daniw/bat_source/README.md

# bat_source
Battery powered voltage and current source
