daniw/bat_source/mech_Samuel_v2/README.md

# Übersicht der Mechanik zur 60V-Quelle

## Anmerkungen zum Modell und zu druckende Dateien

Für die Befestigung der Hauptplatine sind im Moment im Modell Abmessungen für M3-Einschmelzgewinde vorgesehen. Für einen M4-Schraube und Einschmelzgewinde müssen die Abmessungen im CAD geändert werden.

Folgend eine Liste aller zu druckenden Dateien. Dateien liegen alle unter "C:\GIT_Projekte\bat_source\mech_Samuel_v2\80_step_m3f_files\"

Es gibt nur zwei große 3mf-bambu-Dateien, "__TPU_Teile.3mf" und "__ABS_Teile.3mf".
In den beiden Dateien sind erstmal nur die step-Dateien reingezogen, Material und Druckplatte sind noch nicht ausgewählt.

Datei                        | Inhalt                             | Material | Kommentar
-----------------------------|------------------------------------|----------|----------
01_01_housing.stp            | Gehäuse-Hauptteil                  | ABS      | __ABS_Teile.3mf
02_01_lid.stp                | Gehäusedeckel                      | ABS      | __ABS_Teile.3mf
05_cell_holder_minusplus.stp | Zellenhalter                       | ABS      | __ABS_Teile.3mf; zweimal drucken
90_knob_koerper.stp          | Knob für den Poti                  | ABS      | __ABS_Teile.3mf; Ursprüngliche Datei und Konstruktion; nichts dran geändert. 
01_06_fuse_lid.stp           | Deckel Sicherung                   | ABS      | __ABS_Teile.3mf
02_03_seal.stp               | Dichtung Gehäuse/Deckel            | TPU      | __TPU_Teile.3mf
01_04_fuse_seal_b.stp        | Dichtung Gehäuse/Sicherungsdeckel  | TPU      | __TPU_Teile.3mf
01_05_staeubli_plug_seal.stp | Dichtung Gehäuse Bananen-Plugs     | TPU      | __TPU_Teile.3mf

## Montage und Zusammenbau

- Die Knöpfe und "Regler" werden am Deckel verschraubt.
- Danach wird die UI-Platine am Deckel und den Knöpfen verlötet.

- Die Bananen-Plugs werden mit ihrer Dichtung in das Gehäuse geschraubt.
- Dann wird die Hauptplatine ins Gehäuse gesetzt und mit den Bananen-Steckern verlötet.
- Hauptplatine wird mit dem Gehäuse verschraubt.

- Deckel wird auf das Gehäuse gesetzt, die Stiftleiste stellt dann zwischen der Hauptplatine und der UI-Platine die Verbindung her.
- Deckel wird mit vier Schrauben mit dem Gehäuse verschraubt.

## step-Dateien der PCBs

Dateien von Dani bereitgestellt am 15.02.2026. Vereinfachte Modelle, für bessere Handhabung.

"D:\GIT_Projekte\bat_source\mech_Samuel_v2\PCB_step_files_leer_geraeumt\Hauptplatine\PS1-1BA_3D STEP_2026-02-16.step"
"D:\GIT_Projekte\bat_source\mech_Samuel_v2\PCB_step_files_leer_geraeumt\UI\PS1-2BA_3D STEP_2026-02-16.step"

D:\GIT_Projekte\bat_source
D:\GIT_Projekte\bat_source\mech_Samuel_v2
D:\GIT_Projekte\bat_source\mech_Samuel_v2\01_Hauptplatine

D:\GIT_Projekte\bat_source\mech_Samuel_v2\02_UserInterface
D:\GIT_Projekte\bat_source\mech_Samuel_v2\99_PCB_step_files_leer_geraeumt\Hauptplatine
D:\GIT_Projekte\bat_source\mech_Samuel_v2\99_PCB_step_files_leer_geraeumt\UserInterface

## Übersicht bestehender Mechanik-Teile

"D:\GIT_Projekte\bat_source\mech"

Datei | Inhalt
----  | ----
00_bat_source.FCStd               | Assembly vom gesamten Gehäuse
00_bat_source.step                | Assembly vom gesamten Gehäuse
Battery_Holder.3mf                | Druck-Datei für die Halterungen der Zellen und die banana-plug-Führungen
Battery_Holder.FCStd              | FreeCAD-Datei für die Halterung der Zellen.
CBOX11004.FCStd                   | FreeCAD-Datei vom Gehäuse. Hauptteil
CBOX11004-Körper.step             | Gehäuse-Grundform. Hauptteil
Holder_Banana_Plugs.FCStd         | FreeCAD-Datei für die banana-plug-Führungen. Hier schon mit den Bohrungen
Holder_Banana_Plugs.stp           | Äußere Führung für die banana-plugs
Holder_Banana_Plugs_Drill.stp     | Äußere Führung für die banana-plugs mit Bohrungen
Knob.3mf / Knob.FCStd             | FreeCAD- und Druckdatei für den knob auf dem Poti.
Lid_CSACTT004.FCStd               | FreeCAD-Datei für den Deckel
Transformer_Spacer_0.5mm.FCStd    | FreeCAD-Datei für einen Spacer

# Aufbau CAD-Modell

CAD-Modell wird ähnlich aufgebaut, wie es auch in der Realität gemacht wird.

Folgend zwei Darstellungen des Aufbaus als Flowchart.

## Aufbau, Variante 1
```mermaid
flowchart TD
    A[Haupt-Assembly, 00_main_assembly1.asm]

    A --> B[Gehäuse-Assembly, 00a_housing_assembly.asm]
	
    B --> B1[Gehäuse, 01_housing.prt]
    B --> E[Hauptplatinen-Assembly, 10_main_pcb_assembly.asm]
    B --> B2[Deckel Sicherung, 06_fuse_lid.prt]

    A --> C[Deckel-Assembly, 00b_lid_assembly.asm]
	
    C --> C1[Deckel, 02_lid.prt]
    C --> C2[UI-Platine]
	
	A --> D[Dichtung, 03_seal.prt]
	
	E --> E1[Hauptplatine]
	E --> E2[Zellenhalter, 2x, 05_cell_holder.prt]

````

## Anpassungen im CAD-Modell

* Hauptplatine wird mit vier metrischen Schrauben befestigt.

* Welche Schrauben können sinnvoll genutzt werden? Bei Bedarf müssen die Röhren-Füße verlängert und die Zellhalter niedriger werden, damit kürzere Schrauben verwendet werden können.

* Deckel der Sicherung so machen, dass man damit die Sicherung reindrücken kann. Zwischen Deckel und Sicherung ein Band machen, mit dem man mit dem Deckel die Sicherung rausziehen kann.

* Deckel für die Sicherung muss viel größer werden. Nachbauen, drucken und testen.

* Schrauben zwischen Hauptplatine und Gehäuse: M3x40, https://www.bossard.com/ch-de/eshop/schrauben-mit-innenantrieb/zylinderschrauben-mit-innensechskant-mit-schaft/p/4/

* Andere Schraube, M3x25: https://www.bossard.com/ch-de/eshop/schrauben-mit-innenantrieb/zylinderschrauben-mit-innensechskant-ohne-schaft/p/272/

* UI-Platine am Deckel muss von innen an den Deckel geschraubt werden. Aufgrund der geringeren Kräfte sind hier Kunststoff-Schrauben ausreichend.

* Auszugkraft der Stiftleiste: 0.6 N = 60 gramm pro Pin. Gesamtkraft: 24x0.6N = 14.4N = 1.440 kg.

* Stecker: Spannscheibe und Ringmutter mit ins Modell reinnehmen.

* Gehäuse soll aus ABS gedruckt werden. Grobe Abschätzung der Kosten machen. Basierend auf bambu-Filament. https://eu.store.bambulab.com/de/products/abs-filament

* Dichtungen am Deckel für die Sicherung: Gerundete Varianten wegmachen. Es bleibt die ganz gerade Variante übrig und wird verwendet. Wandstärke nach innen hin von 0.5mm auf 1mm erhöhen. An der Lid müssen noch für die beiden Schrauben Vertiefungen gemacht werden, wo die Schrauben-Köpfe reinpassen.

* Alle Dateien umbenennen. Ziel: bessere Struktur der Bauteile, die zum Gehäuse-Teil und die zum Deckel-Teil gehören.
	* Main-Assembly: 00
	* Gehäuse: 01
	* Deckel: 02

* Übersicht aller Dateien und Ordner, die umbenannt werden müssen
Alter Dateiname                       | Neuer Dateiname                   | Status                                                                       | Baugruppe
----                                  | ----                              | ----                                                                         | ----
01_Hauptplatine                       |                                   | Fertig                                                         | Baugruppe
02_UserInterface                      |                                   | Fertig                                                         | Baugruppe
80_step_m3f_files                     |                                   | Fertig                                                         | Baugruppe
99_PCB_step_files_leer_geraeumt       |                                   | Fertig                                                         | Baugruppe
02_pcb_assembly.asm                   | 00_02_pcb_assembly.asm                                  | noch_nicht_umbenannt                                   | Baugruppe
02b_banana_position_skeleton.prt      | 00_02b_banana_position_skeleton.prt                                  | noch_nicht_umbenannt                      | Baugruppe
05_cell_holder.prt                    | 01_05_cell_holder.prt                                  | noch_nicht_umbenannt                                    | Baugruppe
10_main_pcb_assembly.asm              | 00_10_main_pcb_assembly.asm              | noch_nicht_umbenannt                                                  | Baugruppe
90_battery_holder-holder_cut.prt      | 90_01_battery_holder-holder_cut.prt                                  | noch_nicht_umbenannt                      | Baugruppe
90_cbox11004-körper.prt               | 90_02_cbox11004-körper.prt                                  | noch_nicht_umbenannt                               | Baugruppe
90_holder_banana_plugs_drill.prt      | 90_03_holder_banana_plugs_drill.prt                                  | noch_nicht_umbenannt                      | Baugruppe
00_main_assembly.asm                  | 00_00_main_assembly.asm           | Fertig. In der Assembly sind alle Dateien umbenannt.                         | Baugruppe
00a_housing_assembly.asm              | 01_00_housing_assembly.asm        | Fertig                                                                       | Baugruppe
00b_lid_assembly.asm                  | 02_00_lid_assembly.asm            | Fertig. In der Assembly sind bis auf die Platine alle Dateien umbenannt.     | Baugruppe
00c_housing_lid_assembly.asm          | 00_01_mechanical_assembly.asm     | Fertig. In der Assembly sind alle Dateien umbenannt.                         | Baugruppe
01_housing.prt                        | 01_01_housing.prt                 | Fertig                                                                       | Baugruppe
02_lid.prt                            | 02_01_lid.prt                     | Fertig                                                                       | Baugruppe
02_lid__Window_Deep.prt               | 02_01_lid__Window_Deep.prt        | Fertig                                                                       | Baugruppe
03_seal.prt                           | 02_03_seal.prt                    | Fertig                                                                       | Baugruppe
04_fuse_seal.prt                      | 01_04_fuse_seal                   | Fertig                                                                       | Baugruppe
04_fuse_seal_a.prt                    | 01_04_fuse_seal_a.prt             | Fertig                                                                       | Baugruppe
04_seal_fuse_b.prt                    | 01_04_fuse_seal_b.prt             | Fertig                                                                       | Baugruppe
06_fuse_lid.prt                       | 01_06_fuse_lid.prt                | Fertig                                                                       | Baugruppe
07_m3_einschmelzmutter.prt            | 01_07_m3_einschmelzmutter.prt     | Fertig                                                                       | Baugruppe
09_lichtleiter.prt                    | 02_09_lichtleiter.prt             | Fertig                                                                       | Baugruppe
11_display_window.prt                 | 02_11_display_window.prt          | Fertig                                                                       | Baugruppe

### Anpassungen im CAD-Modell erledigt

* Auf die LED der UI-Platine einen Lichtleiter machen. Einfacher Zylinder mit Halbkugel oben drüber. Dazu dann vier Bohrungen in den Deckel machen. Müssen dann eingeklabt werden. Die Lichtleiter haben keinen direkten Kontakt zu den LED.

* Dichtring mit 12mm-Innendurchmesser unter die Bananen-Stecker machen, damit die gedichtet sind.

* Abmessungen der Taster und vom Poti

	* Taster: Durchmesser 12mm; Breite zwischen den beiden Abflachungen: 11.19 (Länge Abflachung: 4.33404)
	* Poti: Länge: 13.75, Breite 11.70, Durchmesser unten 7, Höhe Zylinder 7, Nase 2x0.8, Abstand Nase 0.1

* Rundung unten außen machen, dass man die PS besser greifen kann. Es sollten mindestens 10mm Radius sein, mehr wäre besser. Was macht die Wandstärke damit? Welche Rundung geht dann noch innen? Wie passt das mit den Zellenhaltern?

* In das Gehäuse müssen vier Hülsen mit Gewinde eingeschmolzen werden.

* 3D-Modell DIN M3x25 und Einschmelzgewinde suche, runterladen und einbauen.

https://www.3djake.de/3djake/gewindeeinsaetze-50er-set?sai=9419

* Vier Schrauben raussuchen für die Verbindung zwischen Deckel und Gehäuse

* Dichtung zwischen Deckel und Gehäuse auf die Innenseite der Schrauben verlegen. Schrauben-Rohr viel weiter nach außen, direkt in die Ecke. Dasselbe gilt für den Deckel der Sicherung.

* Oberkante vom Encoder definiert die Innenseite vom Deckel. Die Taster definieren die Außenkante vom Deckel und liegen auf dem Deckel auf.

## Dichtung Abmessungen

* Radius Ecken 3mm

* Breite 1.5mm

* Dichtung liegt mittig. Abstand zur Innenkante 0.75mm

## Dichtung Abmessungen IMD-Tester

* Box hat Nase, die die Dichtung im Deckel drückt. Kante hat Breite von 1.5mm. Ende sauber auf der Innenseite vom Gehäuse. Kante ist 1.5mm hoch.

* Dichtung liegt im Deckel. Fuge für die Dichtung ist 2.5mm breite. Dichtung selbst ist auch 2-2.5mm breit.

## Weiteres Vorgehen in der Konstruktion:

* Passende Schrauben suchen und als Modell einbauen.

* Überlegen, wie man ein Spiel in alle drei Raumrichtungen einbauen kann, siehe Diskussion mit Luise. Es dürfen keine Kräfte auf den Viel-Pin-Stecker ausgeübt werden. Und Fertigungstoleranzen müssen ausgeglichen werden können.

* Einschmelzgewinde von der Hauptplatine zum Gehäuse auf M4 vergroessern. Sub-Modell vom Einschmelzgewinde muss ausgetauscht werden. Röhre muss neu konstruiert werden.+

* Schrauben raussuchen.
	* M3 Schrauben fuer Deckel und Deckel ueber der Sicherung
	* M4 Schrauben fuer Hauptplatine

* Schrauben am Deckel der Sicherung muessen Senkkopf sein, damit das Gehäuse unten glatt abschliesst.

* Schrauben von Deckel auf Gehäuse und Befestigung der Platinen köennen auch Innen-Sechskant-Schrauben sein. 

## Einschmelzgewinde und Abmessungen

Quelle: https://www.3djake.de/3djake/gewindeeinsaetze-50er-set?sai=9419

Gewindegröße | D1 <br> Großer Durchmesser | D2 <br> Kleiner Durchmesser | D3 <br> Bohrung im Bauteil | L (+1mm) <br> Gesamtlänge | W (mindestens) <br> Wandstärke im Bauteil
----         | ----                       | ----                        | ----                       | ----                      | ----
M3           | 4.6                        | 3.9                         | 4.0                        | 5.7                       | 1.6
M4           | 6.3                        | 5.5                         | 5.6                        | 6.35                      | 2.1
M5           | 7.1                        | 6.3                         | 6.4                        | 9.5                       | 2.6
M6           | 8.7                        | 7.9                         | 8.0                        | 12.7                      | 3.3
M8           | 10.24                      | 9.4                         | 9.6                        | 12.7                      | 4.5

## Schrauben

* Befestigung der Hauptplatine zum Gehäuse
	* M4-Einschmelzgewinde
	* M4x30 Innensechskant-Schraube
	* Bohrungen im Zellenhalter und der Platine müssen vergrößert werden.

* Befestigung Hauptplatine zum Zellenhalter
	* M4-Schraube mit Einschmelzgewinde. Abmessungen TBD.

* Schrauben M3 und M4 auf ebay.

https://www.ebay.de/itm/126045092807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

* Schrauben bei bossard

https://www.bossard.com/ch-de/eshop/schrauben-mit-innenantrieb/zylinderschrauben-mit-innensechskant-mit-schaft/p/4/

* Innen-Sechskant-Schrauben bei Norelem

https://norelem.de/de/Produkt%C3%BCbersicht/Flexibles-Normteilesystem/07000/Muttern-Schrauben-Unterlegscheiben-Sicherungselemente/Zylinderschrauben-mit-Innensechskan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

* Senkschrauben mit Innen-Sechskant (für Fuse-Lid)

https://norelem.de/de/Produkt%C3%BCbersicht/Flexibles-Normteilesystem/07000/Muttern-Schrauben-Unterlegscheiben-Sicherungselemente/Senkschrauben-mit-Innensechskant-DI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

* Befestigung der Zellenhalter und Platine mit Kunststoff-Schrauben, Typ K30.

## Einschmelzgewinde

Bild mit Abmessungen der Einschmelzgewinde:

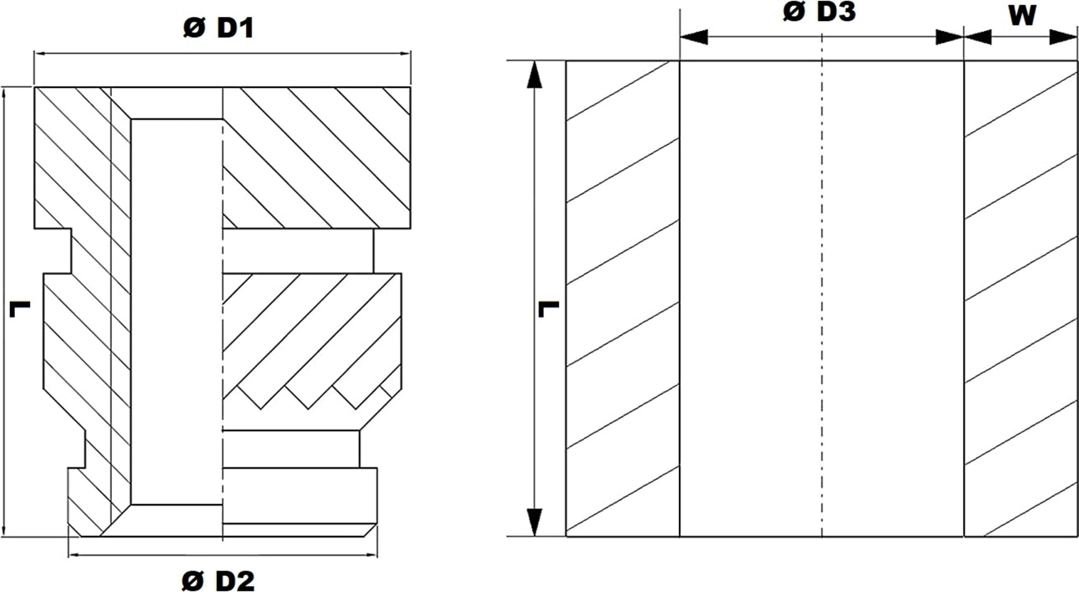
[picture p1: mech_Samuel_v2/3djake-gewindeeinsaetze-50er-set-621566-de.jpg]
Zeichnung


## Abmessungen der Sicherung (aus bestehender step-Datei ausgelesen).
Sind notwendig, um die Sicherung zum Drucken nachbauen zu koennen.
Sicherung:
	43.0530 x 18.1356
	39.9034 x 14.9860

	Hoehe 17.5260

	Wand rundung: D 3.14960
	Wand rundung innen: 0.762000

	Wanddicke 1.57480

## Aufbau, Variante 2

```mermaid
flowchart TD
    A[Haupt-Assembly]

    subgraph GA [Gehäuse-Assembly]
        G1[Gehäuse]
        G2[Hauptplatine]
        G3[Dichtung]
    end

    subgraph DA [Deckel-Assembly]
        D1[Deckel]
        D2[UI-Platine]
    end

    A --> GA
    A --> DA

````

Kleinst-möglicher Abstand zwischen den beiden Platinen sind 9.5mm. Also etwas mehr Abstand einplanen.

### CREO-Konfiguration anpassen

* Relativer Suchpfad in die search-Datei einbauen, damit nicht verschiedene Pfad für Workstation und Laptop notwendig sind.

* In der config-Datei die Ansicht von Ebenen, Achsen, Punkte, Koordinatensystemen, ... abschalten.

## Aufgabenliste

* Die Tabelle der umzubenennden Dateien aufräumen.

* Liste mit Anmerkungen, Kommentaren, etc überarbeiten. Vermutlich hat sich davon schon vieles erledigt.
