daniw/bat_source/mech_Samuel_v2/04_Fuse/sicherung_konstruiert/read me.txt

Sicherung Durchmesser: 10.300 mm
Länge Feder: 9.8 mm
