daniw/bat_source/doc/src/hardware.tex

\section{Hardware}

\FloatBarrier

\subsection{Overview}
\label{sec_hw_overview}
\begin{itemize}
    \item Block diagram
\end{itemize}

\FloatBarrier

\subsection{Battery}
\label{sec_battery}
For the cell chemistry, a \ac{LFP} battery is selectedi. This due to its rather high energy and power density and especially due to the safer handling compared with \ac{LiIon} and \ac{LiPo} batteries.  

To select a suitable cell, a market analysis is performed. 
\begin{table}[h!]
    %\begin{spreadtab}{{zebratabular}{p{0.27\linewidth}lN{3}{2}n{5}{2}p{0.4\linewidth}}}
    \begin{spreadtab}{{zebratabular}{llllllllllllll}}
        \rowcolor{gray}
        @Manufacturer,  Type                & @$C_{typ}$                & @$I_{max}$            & @Cells    & @$P_{max}$        & @$W_{max}$                 & @Cost per device & @Runtime      \\
        @Lithium Werks, ANR26650            & @\qty{2.6}{\ampere\hour}  & @\qty{50}{\ampere}    & @5        & @\qty{500}{\watt} & @\qty{40}{\watt\hour}      & @35.75           & @\qty{32}{\minute}    \\
        @JGNE,          HTPFR26650          & @\qty{3.0}{\ampere\hour}  & @\qty{30}{\ampere}    & @5        & @\qty{375}{\watt} & @\qty{46.4}{\watt\hour}    & @17.70           & @\qty{37.12}{\minute} \\
        @JGNE,          HTCFR26650          & @\qty{3.6}{\ampere\hour}  & @\qty{10.2}{\ampere}  & @4        & @\qty{375}{\watt} & @\qty{45.44}{\watt\hour}   & @8.60            & @\qty{36.352}{\minute} \\
        @JGNE,          HTCFR26650          & @\qty{3.8}{\ampere\hour}  & @\qty{11.4}{\ampere}  & @4        & @\qty{114}{\watt} & @\qty{48}{\watt\hour}      & @10.76           & @\qty{38.4}{\minute} \\
        @JGNE,          JGCFR26650-4\ldots  & @\qty{4.0}{\ampere\hour}  & @\qty{12}{\ampere}    & @3        & @\qty{90}{\watt}  & @\qty{37.92}{\watt\hour}   & @8.97            & @\qty{30.336}{\minute} \\
        @Tenpower,      IFR26700-45HE       & @\qty{4.5}{\ampere\hour}  & @\qty{9}{\ampere}     & @4        & @\qty{90}{\watt}  & @\qty{56.96}{\watt\hour}   & @7.80            & @\qty{45.568}{\minute} \\
        @Tenpower,      IFR26700-40HE       & @\qty{4.0}{\ampere\hour}  & @\qty{8}{\ampere}     & @4        & @\qty{80}{\watt}  & @\qty{50.56}{\watt\hour}   & @7.40            & @\qty{40.448}{\minute} \\
    \end{spreadtab}
    \caption{Cell selection}
    \label{tab_cell_selection}
\end{table}
The IFR26700-45HE made by Tenpower is selected as a compromise between low cost and reasonable margin in runtime and output power. 4 cells in series are used. The cells are mounted using custom cell holders. Nickel tabs are spot-welded to the cells and soldered to the \ac{PCB}. 
\todo[inline]{Description of cell holder}

\begin{figure}[h!]
    \centering
    
    \caption{\acs{BMS} - battery cells}
    \label{fig_bat_cells}
\end{figure}

The schematic is prepared for a configuration with 5 cells in series. To enable the 5S configuration, BAT5 to BAT9 are set to fitted, the text C3 is replaced with a matching net label and the connection between C2 and C3 is removed. If both, 4S and 5S should be possible with the same \ac{PCB}, BAT2 is replaced with the design item id BAT\_LFP-26700-4.5AH-2NEG. It includes an extra pad, which is shorted to the negative cell connection using the cell tab by bending it and soldering it to both pads. This extra pad is used to short BAT7, which is not used in 4S configuration. \autoref{fig_bat_2neg} demonstrates the use of this third pad. 
\begin{figure}[h!]
    \centering
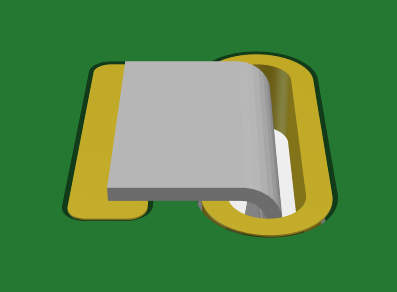
[picture p2: doc/img/bat_2neg.png]
    
    \caption{Visualisation of third pad which is bridged by the negative cell tab}
    \label{fig_bat_2neg}
\end{figure}

\FloatBarrier

\subsection{Battery Management System}
\label{sec_bms}
The battery must be protected against deep-discharge, over-charge, overcurrent and overtemperature. (\ReqRef{R:BMS})
This is implemented with the battery monitor and protector BQ76905. It is powered directly from the batteries and can be configured through its \ac{I2C} interface. The cells are connected to the battery monitor with a \qty{100}{\ohm} resistor for overcurrent protection. These resistors also limit the balancing current. 
\begin{align}
    I_{Bal} 
    = \dfrac{U_{Bal}}{R_{Bal}} 
    = \dfrac{n_{Bal} \cdot U_{cell}}{2 \cdot R_C + n_{Bal} \cdot R_{CB}}
    = \dfrac{n_{Bal} \cdot U_{cell}}{2 \cdot \qty{100}{\ohm} + n_{Bal} \cdot R_{CB}}
\end{align}
\begin{align}
    I_{Bal_{typ}} 
    = \dfrac{n_{Bal_{typ}} \cdot U_{cell_{typ}}}{2 \cdot R_C + n_{Bal_{typ}} \cdot R_{CB_{typ}}}
    = \dfrac{1 \cdot \qty{3.65}{\volt}}{2 \cdot \qty{100}{\ohm} + 1 \cdot \qty{93}{\ohm}}
    = \qty{12.46}{\milli\ampere}
\end{align}
\begin{align}
    I_{Bal_{min}} 
    = \dfrac{n_{Bal_{min}} \cdot U_{cell_{min}}}{2 \cdot R_C + n_{Bal_{min}} \cdot R_{CB_{max}}}
    = \dfrac{1 \cdot \qty{2.0}{\volt}}{2 \cdot \qty{100}{\ohm} + 1 \cdot \qty{200}{\ohm}}
    = \qty{5}{\milli\ampere}
\end{align}
\begin{align}
    I_{Bal_{max}} 
    = \dfrac{n_{Bal_{max}} \cdot U_{cell_{max}}}{2 \cdot R_C + n_{Bal_{max}} \cdot R_{CB_{min}}}
    = \dfrac{4 \cdot \qty{3.65}{\volt}}{2 \cdot \qty{100}{\ohm} + 4 \cdot \qty{53}{\ohm}}
    = \qty{35.44}{\milli\ampere}
\end{align}
\begin{align}
    P_{R_{C_{max}}} = I_{Bal_{max}} ^{2} \cdot R_{C} = \qty{35.44}{\milli\ampere} ^{2} \cdot \qty{100}{\ohm} = \qty{125.6}{\milli\watt}
\end{align}
All signals directly connected to the battery cells are assigned to the netclass BAT to enforce a minimum clearance. A capacitor with a value of \qty{100}{\nano\farad} is connected to each cell voltage measurement for filtering as recommended by the datasheet \cite{TI:BQ76905}. \autoref{fig_bms_volt} shows the cell connection to the \ac{BMS}. 

\begin{figure}[h!]
    \centering
    
    \caption{\acs{BMS} - battery voltage measurement}
    \label{fig_bms_volt}
\end{figure}

The temperature of the battery is measured with a \qty{10}{\kilo\ohm} \ac{NTC} thermistor with a B value of \qty{3380}{\kelvin}. The \ac{BMS} includes a pull-up resistor with a value of \qty{20}{\kilo\ohm}, therefore no external pull-up resistor is necessary. The temperature sensor is soldered to the bottom side of the PCB and glued to the cells using thermally conductive adhesive. A \qty{1}{\nano\farad} capacitor is connected in parallel to the thermistor for filtering. For testing purpose, an \ac{SMD} thermistor is placed on the PCB as well, which can be activated by bridging the solder-jumper J1. The temperature sensor is shown in \autoref{fig_bms_temp}. 

\begin{figure}[h!]
    \centering
    
    \caption{\acs{BMS} - battery temperature measurement}
    \label{fig_bms_temp}
\end{figure}

The \ac{BMS} can be woken up from deepsleep or shutdown mode by a rising edge on the pins TS or VC0. In order to allow the microcontroller to wake up the \ac{BMS}, a \ac{GPIO} pin is connected to the TS pin through a protection circuit (\autoref{fig_bms_wakeup}), which keeps the voltage on the TS pin within the absolute maximum ratings of \qty{2.1}{\volt}. \cite{TI:BQ76905}

\begin{figure}[h!]
    \centering
    
    \caption{\acs{BMS} - wakeup protection circuit}
    \label{fig_bms_wakeup}
\end{figure}

The battery current is measured with a \qty{5}{\milli\ohm} shunt resistor. The signal is filtered (2x \qty{100}{\ohm}, \qty{100}{\nano\farad}) and connected to the battery monitor. The voltage across the shunt resistor is also amplified by a difference amplifier and connected to the \ac{ADC} of the microcontroller for current control during battery charging. 

\begin{figure}[h!]
    \centering
    
    \caption{\acs{BMS} - current measurement for overcurrent protection and fuel gauge}
    \label{fig_bms_current_bms}
\end{figure}

\begin{figure}[h!]
    \centering
    
    \caption{\acs{BMS} - current measurement for the charge controller}
    \label{fig_bms_current_uc}
\end{figure}

The CHG and DSG signals connected to the on/off controller instead of directly controlling \acp{MOSFET}. As the low side is not switched, no \ac{I2C} isolator or level shifter is needed. 
The \ac{BMS} is supplied from the batteries through the pins BAT and REGSRC. Both pins are bypassed with a \qty{1}{\micro\farad} capacitor and individually connected to the top of the stack (\verb!VBAT!) through a shottky diode and a \qty{10}{\ohm} series resistor. The output of the internal voltage regulator (REGOUT) is made available for powering standby operations like buttons for powering on or an \ac{RTC} with a voltage of \qty{3.3}{\volt}. A standby battery voltage (\verb!VBAT_STBY!) is provided for the on/off controller. This voltage is available as long as all battery parameters are within the allowed range. 

\begin{figure}[h!]
    \centering
    
    \caption{\acs{BMS} - power supply}
    \label{fig_bms_power}
\end{figure}

\FloatBarrier

\subsection{On/off controller}
\label{sec_onoff}
The \ac{MOSFET} Q6 blocks any charging current to the battery when the \ac{BMS} does not allow charging. Q5 prevents discharge of the batteries and is the main power switch for the device. A precharge circuit is implemented parallel to Q5 to limit the inrush current. The precharge current is set to \qty{100}{\milli\ampere}. (\autoref{eq_i_precharge})The precharge current runs through the resistors R22 $\ldots$ R25. The \ac{BJT} Q4 pulls the gate of Q5 up when the voltage across the resistors reaches the base-emiter voltage of aproximately \qty{0.65}{\volt}. \autoref{fig_onoff_switch} shows the mains switch \acp{MOSFET} and the precharge circuit. 
\begin{align}
    \label{eq_i_precharge}
    I_{precharge} = \dfrac{U_{BE} \cdot n_{R_{Precharge}}}{R_{Precharge}}
    = \dfrac{\qty{0.65}{\volt} \cdot 4}{\qty{27}{\ohm}} = \qty{96.3}{\milli\ampere}
\end{align}

\begin{figure}[h!]
    \centering
    
    \caption{On/off controller - highside switch with precharge circuit}
    \label{fig_onoff_switch}
\end{figure}

The charging \ac{MOSFET} Q6 is directly controlled by the \ac{BMS} through the signal \verb!BMS_ON_OFF.CHG!, which is level-shifted and inverted with Q17. The discharging \ac{MOSFET} Q5 can be enabled by the signal \verb!UI_ON_OFF.ON! (Q14), which is active when any of the on-enabled buttons (see \secref{sec_ui}\todo{Consider more precise reference to buttons}) is pressed. The microcontroller is able to keep the device running by the signal \verb!ON_REQ! (Q15) which should be set high immediatelly after boot. To turn the device off, the microcontroller sets the signal \verb!ON_REQ! low. The on logic is only activated through Q16, when the signal \verb!BMS_ON_OFF.DSG! is active. After enabling the device, the precharge circuit is activated through R40. The gate voltage of the precharge \ac{MOSFET} Q3 is monitored by Q11. When precharge is completed, the current limiter is inactive, which causes the gate voltage to drop to 0, which enables the main \ac{MOSFET} Q5 through the level-shifter Q11 and Q10. 

\begin{figure}[h!]
    \centering
    
    \caption{On/off controller - logic}
    \label{fig_onoff_logic}
\end{figure}

\FloatBarrier

To disable the device when the microcontroller is unable to turn off the device, an emergency shut-off is implemented as shown in \autoref{fig_onoff_emergency_off}. Pressing the ESC button pulls the signal BUTTON\_OFF high. This charges the capacitor C17 through the level-shifter Q13, Q9. The comparator U3 compares the voltage across the capacitor with half of the supply voltage and disables the \ac{MOSFET} Q5 and the precharge Q3 through the level shifters Q12, Q7 and Q8. The comparator is primarilly supplied from the output of the on/off controller VIN through the diode D5. To keep the \ac{MOSFET} disabled until the ESC button is released, the comparator is also supplied with the BUTTON\_OFF signal through D7. Without that secondary supply, the ESC button would turn on the device when the supply of the comparator is discharged. 

\begin{figure}[h!]
    \centering
    
    \caption{On/off controller - emergency off circuit}
    \label{fig_onoff_emergency_off}
\end{figure}

\FloatBarrier

\subsection{Low voltage converter}
\label{sec_lv_converter}
\begin{itemize}
    \item Converter design
    \item Component selection
    \item Charging operation
\end{itemize}

Multiple output voltages are generated by the low voltage converter depending on the operating mode of the device. As the converter is also used to charge the battery from a voltage applied to the terminals, it must be bidirectional. All operating modes, in which the low voltage converter is runngin are listed in \autoref{tab_lv_conv_modes}. 
\begin{table}[h!]
    \begin{zebratabular}{llllp{0.25\textwidth}}
        \rowcolor{gray}
        operating mode          & input voltage             & output voltage            & output current                & remarks \\
        battery charging        & \qtyrange{5}{60}{\volt}   & \qtyrange{8}{14.4}{\volt} & \qtyrange{0}{4.5}{\ampere}    & reversed direction \\
        voltage supply          & \qtyrange{8}{14.4}{\volt} & \qtyrange{0}{60}{\volt}   & \qtyrange{0}{1}{\ampere}      & - \\
        current supply          & \qtyrange{8}{14.4}{\volt} & \qtyrange{0}{5}{\volt}    & \qtyrange{0}{10}{\ampere}     & - \\
        resistance measurement  & \qtyrange{8}{14.4}{\volt} & \qtyrange{0}{5}{\volt}    & \qtyrange{0}{1}{\ampere}      & - \\
        current measurement     & n/a                       & \qty{0}{\volt}            & \qtyrange{0}{10}{\ampere}     & secondary half-bridge shorted to minimize voltage drop across terminals \\
        overvoltage protection  & n/a                       & \qty{0}{\volt}            & \qtyrange{0}{10}{\ampere}     & secondary half-bridge shorted to lower power dissipation in crowbar \\
    \end{zebratabular}
    \caption{Operating modes of the low voltage converter}
    \label{tab_lv_conv_modes}
\end{table}

The low voltage converter is a 4-switch buck-boost converter. It is supplied from the battery voltage directly after the on/off controller. The power stage is build with two \ac{GaN} half bridges LMG2100R044 from Texas Instuments. The LMG2100R044 continains two \ac{GaN} \acp{FET} with gate driver. They offer a typical $R_{DS_{ON}}$ of \qty{44}{\milli\ohm}, a maximum supply voltage of \qty{90}{\volt} and a maximum continuous drain current of \qty{35}{\ampere}. The half bridges are connected by an inductor. The input and output are stabilized with ceramic capacitors. The converter is operated at a switching frequency of \qty{1}{\mega\hertz}. 
\todo[inline]{Design of inductor and DC-link capacitors}
The integrated low side gate driver is supplied with \qty{5}{\volt}. The high side gate driver is supplied by an integrated bootstrap diode, which charges the bootstrap capacitor C39 / C40. The discharge of the bootstrap capacitor limits the maximum on-time of the high-side switch as by \autoref{eq_bootstrap_ton}. 
\begin{align}
    \label{eq_lv_conv_sup_bypass}
    C_{VCC} 
    \geq \dfrac{2 \cdot Q_{G} + Q_{RR}}{\Delta V} 
    = \dfrac{2 \cdot \qty{9.3}{\nano\coulomb} + \qty{2}{\nano\coulomb}}{\qty{100}{\milli\volt}} 
    = \qty{206}{\nano\farad}
\end{align}
\begin{align}
    \label{eq_bootstrap}
    C_{BST} = \dfrac{Q_{G} + Q_{RR} + I_{HB} \cdot t_{ON_{max}}}{\Delta V}
\end{align}
\begin{align}
    \label{eq_bootstrap}
    t_{ON_{max}} 
    = \dfrac{C_{BST} \cdot \Delta V - Q_{G} - Q_{RR}}{I_{HB}}
    = \dfrac{\qty{1}{\micro\farad} \cdot \qty{100}{\milli\volt} - \qty{9.3}{\nano\coulomb} - \qty{2}{\nano\coulomb}}{\qty{4.5}{\milli\ampere}}
    = \qty{19.7}{\micro\second}
\end{align}
The control signals are blocked by an enable logic which stops the converter from running when the enable signal from the microcontroller is missing or when the \ac{OVP} latch is active. The \ac{OVP} latch only blocks the primary side. This allows the microcontroller to activte both \acp{FET} on the secondary stage in shoot-through to prevent overheating of the thyristor during continuous crowbar activation. This is possible as the gate driver of the half bridge does not include any shoot-through protection. See \secref{sec_ovp} for detailed operation of the crowbar. The secondary half bridge is olso activated in shoot-through for current measurement. The measurement funcionallity is explained in \secref{sec_meas}. The half bridge with the enable logic is shown in \autoref{fig_lv_conv_powerstage}. 

\begin{figure}[h!]
    \centering
    
    \caption{Low voltage converter - power stage with logic}
    \label{fig_lv_conv_powerstage}
\end{figure}

When the converter is not in use, the output can be discharged with the discharge circuit shown in \autoref{fig_lv_conv_discharge}. The current through the discharge \ac{MOSFET} Q18 is measured with the shunt resistor R59 and controlled by the \ac{BJT} Q20. The discharge circuit can be deactivated with the signal \verb!DISCHARGE/! and Q19. 
\begin{align}
    \label{eq_lv_discharge_current}
    I_{Dsg} 
    = \dfrac{V_{Q20_{BE}}}{R59}
    = \dfrac{\qty{0.6}{\volt}}{\qty{30}{\ohm}}
    = \qty{20}{\milli\ampere}
\end{align}
\begin{align}
    \label{eq_lv_discharge_power}
    P_{Dsg_{max}} 
    = I_{Dsg} \cdot V_{LV_{max}}
    = \dfrac{V_{Q20_{BE}}}{R59} \cdot V_{LV_{max}}
    = \dfrac{\qty{0.6}{\volt}}{\qty{30}{\ohm}} \cdot \qty{60}{\volt}
    = \qty{1.2}{\watt}
\end{align}
\begin{figure}[h!]
    \centering
    
    \caption{Low voltage converter - discharge}
    \label{fig_lv_conv_discharge}
\end{figure}

The temperature of the inductor and the two half bridges are measured with the \ac{NTC} thermistors R54, R55 and R56 as per \autoref{fig_lv_conv_temperature}. \autoref{formula}
\begin{align}
    \label{formula}
    R_{NTC} 
    = R_{N} \cdot e^{B \cdot \left(\dfrac{1}{\vartheta} - \dfrac{1}{\vartheta_{N}}\right)}
    = \qty{10}{\kilo\ohm} \cdot e^{\qty{3380}{\kelvin} \cdot \left(\dfrac{1}{\vartheta} - \dfrac{1}{\qty{25}{\celsius}}\right)}
\end{align}
\begin{align}
    V_{NTC} 
    = V_{Ref} \cdot \dfrac{R_{NTC}}{R_{pullup} + R_{NTC}}
    = V_{Ref} \cdot \dfrac{R_{NTC}}{\qty{10}{\kilo\ohm} + R_{NTC}}
\end{align}
\begin{align}
    \dfrac{V_{NTC}}{V_{Ref}}
    = \dfrac{R_{NTC}}{R_{pullup} + R_{NTC}}
    = \dfrac{1}{\dfrac{R_{pullup}}{R_{NTC}} + 1}
\end{align}
\begin{align}
    \dfrac{V_{Ref}}{V_{NTC}} - 1
    = \dfrac{R_{pullup}}{R_{NTC}}
\end{align}
\begin{align}
    R_{NTC}
    = \dfrac{R_{pullup}}{\dfrac{V_{Ref}}{V_{NTC}} - 1}
\end{align}
\begin{align}
    \vartheta
    = \dfrac{1}{\dfrac{1}{\vartheta_{N}} + \dfrac{ln\left(\dfrac{R_{NTC}}{R_{N}}\right)}{B}}
    = \dfrac{1}{\dfrac{1}{\vartheta_{N}} + \dfrac{ln\left(\dfrac{R_{pullup}}{\left(\dfrac{V_{Ref}}{V_{NTC}} - 1\right) \cdot {R_{N}}}\right)}{B}}
\end{align}

\begin{figure}[h!]
    \centering
    
    \caption{Low voltage converter - temperature measurement}
    \label{fig_lv_conv_temperature}
\end{figure}

\FloatBarrier

\subsection{High voltage converter}
\label{sec_hv_converter}
\begin{itemize}
    \item Topology
    \item Converter design
    \item Component selection
    \item Transformer design
\end{itemize}

Insulation resistance measurement requires a test voltage of \qty{500}{\volt}. This voltage is generated by the high voltage converter. It is a flyback converter as shown in \autoref{fig_hv_conv}. A \ac{MOSFET} (Q21) drives the primary side of the transformer. It has a breakdown voltage of \qty{200}{\volt}, which is required due to the genereated reverse voltage of the flyback converter. The ringing of the switch node is reduced with a RCD \todo{Is RCD the correct name for this kind of snubber?} snubber consisting of a shottky diode (D9), which charges a capacitor (C22) with the energy of the overshoot and a resistor (R62), which discharges the capacitor within a switching cycle. 
A gate driver 1EDN7512B is used to drive the switching \ac{MOSFET}. The gate driver includes an inverting and a non-inverting input. The non-inverting input is used for the \ac{PWM} to drive the \ac{MOSFET}. The inverting input is used to block the converter from operating, when no enable signal is present, or when an overcurrent is detected. For a detailed description of the overcurrent detection see \secref{sec_ocp}. 
\begin{figure}[h!]
    \centering
    
    \caption{High voltage converter}
    \label{fig_hv_conv}
\end{figure}

The transformer is custom-made and includes one primary winding, three secondary windings and a PCB with rectification, dc-link capacitors and dicharge resistors. 
The transformer is based on a RM5 coil former with two chambers \todo{check teminlology} and ferrite core set. The primary winding is wound on the lower half of the coil former and has 8 turns \todo{Check transformer terminology (coil, winding, turn, $\ldots$)} of enameled \todo{Check spelling} wire with a diameter of \qty{0.5}{\milli\meter}. 
The three dc link capacitors are connected in series. 
\begin{figure}[h!]
    \centering
    
    \caption{High voltage converter - flyback transformer \acs{PCB}}
    \label{fig_hv_convtrafo_pcb}
\end{figure}

\begin{figure}[h!]
    \centering
    
    \caption{High voltage converter - current limiter}
    \label{fig_hv_conv_i_lim}
\end{figure}

\FloatBarrier

\subsection{Overvoltage protection}
\label{sec_ovp}

\begin{figure}[h!]
    \centering
    
    \caption{Overvoltage protection - crowbar}
    \label{fig_overvoltage_prot_crowbar}
\end{figure}

\begin{figure}[h!]
    \centering
    
    \caption{Overvoltage protection - logic}
    \label{fig_overvoltage_prot_logic}
\end{figure}

\FloatBarrier

\subsection{Overcurrent protection}
\label{sec_ocp}

\begin{figure}[h!]
    \centering
    
    \caption{Overcurrent protection}
    \label{fig_overcurrent_prot_crowbar}
\end{figure}

\FloatBarrier

\subsection{Terminals}
\label{sec_terminal}

\begin{figure}[h!]
    \centering
    
    \caption{Output terminals with \acs{GDT} and voltage detection}
    \label{fig_terminals}
\end{figure}

\begin{figure}[h!]
    \centering
    
    \caption{Output relais}
    \label{fig_output_relais}
\end{figure}

\begin{figure}[h!]
    \centering
    
    \caption{Shunt resistors for current measurement}
    \label{fig_shunt}
\end{figure}

\FloatBarrier

\subsection{Current controller}
\label{sec_i_ctrl}

\begin{figure}[h!]
    \centering
    
    \caption{Current controller - feedback and control}
    \label{fig_i_ctrl_feedback}
\end{figure}

\begin{figure}[h!]
    \centering
    
    \caption{Current controller - limiter and feedforward}
    \label{fig_i_ctrl_feedforward}
\end{figure}

\begin{figure}[h!]
    \centering
    
    \caption{Current controller - temperature measurement}
    \label{fig_i_ctrl_temp}
\end{figure}

\FloatBarrier

\subsection{Measurement}
\label{sec_meas}
\begin{itemize}
    \item ADC
    \item Output voltage
    \item 4-wire voltage
    \item Output current
\end{itemize}

\begin{figure}[h!]
    \centering
    
    \caption{Measurement - terminal voltage}
    \label{fig_meas_term_volt}
\end{figure}

\begin{figure}[h!]
    \centering
    
    \caption{Measurement - output current}
    \label{fig_meas_out_current}
\end{figure}

\begin{figure}[h!]
    \centering
    
    \caption{Measurement - sens voltage}
    \label{fig_meas_sens_volt}
\end{figure}

\begin{figure}[h!]
    \centering
    
    \caption{Measurement - isolation current}
    \label{fig_meas_iso_current}
\end{figure}

\begin{figure}[h!]
    \centering
    
    \caption{Measurement - \acs{ADC}}
    \label{fig_meas_adc}
\end{figure}

\begin{figure}[h!]
    \centering
    
    \caption{Measurement - Terminal voltage for controller}
    \label{fig_meas_term_volt_uc}
\end{figure}

\begin{figure}[h!]
    \centering
    
    \caption{Measurement - current high range for controller}
    \label{fig_meas_out_current_uc}
\end{figure}

\begin{figure}[h!]
    \centering
    
    \caption{Measurement - current low range for controller}
    \label{fig_meas_iso_current_uc}
\end{figure}

\FloatBarrier

\subsubsection{Voltage measurement}
\label{sec_volt_meas}
\begin{itemize}
    \item Voltage divider
    \item Differential amplifier
\end{itemize}

\FloatBarrier

\subsubsection{Current measurement}
\label{sec_cur_meas}
\begin{itemize}
    \item Shunt selection
    \item Amplifier selection
\end{itemize}

\FloatBarrier

\subsection{Output terminals}
\label{sec_out_term}
\begin{itemize}
    \item Crowbar
    \item Fuse
    \item Reverse polarity protection
    \item current controller
\end{itemize}

\FloatBarrier

\subsection{Connection to user interface}

\begin{figure}[h!]
    \centering
    
    \caption{User interfae - button protection}
    \label{fig_ui_button_prot}
\end{figure}

\begin{figure}[h!]
    \centering
    
    \caption{User interfae - button level shifter}
    \label{fig_ui_button_levelshifter}
\end{figure}

\begin{figure}[h!]
    \centering
    
    \caption{User interfae - button on / off logic}
    \label{fig_ui_button_onoff}
\end{figure}

\begin{figure}[h!]
    \centering
    
    \caption{User interfae - connector, supply and presence detection}
    \label{fig_ui_connector}
\end{figure}

\begin{figure}[h!]
    \centering
    
    \caption{User interfae - \acs{SPI} protection}
    \label{fig_ui_spi}
\end{figure}

\begin{figure}[h!]
    \centering
    
    \caption{User interfae - encoder filtering and protection}
    \label{fig_ui_encoder}
\end{figure}

\begin{figure}[h!]
    \centering
    
    \caption{User interfae - \ac{I2C} protection}
    \label{fig_ui_i2c}
\end{figure}

\begin{figure}[h!]
    \centering
    
    \caption{User interfae - \acs{UART} and high voltage detection protection}
    \label{fig_ui_uart}
\end{figure}

\FloatBarrier

\subsection{Microcontroller}
\label{sec_microcontroller}
\begin{itemize}
    \item Microcontroller selection
    \item GPIO assignment
    \item Analog reference
\end{itemize}
The STM32F334series is selected as microcontroller. This controller is suited for controlling a DC/DC converter due to the inclusion of the \ac{HRTIM}, which allows \ac{PWM} generation with a resolution as low as \qty{217}{\pico\second}. The QFP-48 package is selected due to the solderability and number of \ac{GPIO} pins. For the prototype the mximum of \qty{64}{\kibi\byte} is selected. This leads to the selected device: STM32F334C8T

\begin{figure}[h!]
    \centering
    
    \caption{Microcontroller - \acs{RTC} crystal}
    \label{fig_uc_crystal}
\end{figure}

\begin{figure}[h!]
    \centering
    
    \caption{Microcontroller - supply}
    \label{fig_uc_supply}
\end{figure}

\begin{figure}[h!]
    \centering
    
    \caption{Microcontroller - reference voltage buffer}
    \label{fig_uc_ref_buf}
\end{figure}

\begin{figure}[h!]
    \centering
    
    \caption{Microcontroller - \acs{EEPROM}}
    \label{fig_uc_eeprom}
\end{figure}

\begin{figure}[h!]
    \centering
    
    \caption{Microcontroller - flash memory}
    \label{fig_uc_flash}
\end{figure}

\begin{figure}[h!]
    \centering
    
    \caption{Microcontroller - programming interface}
    \label{fig_uc_programming}
\end{figure}

\begin{figure}[h!]
    \centering
    %\includegraphics[page=14, scale=\schscale, trim=71 35 655 510, clip]{\schfilemain}
    
    \caption{Microcontroller - hardware identification}
    \label{fig_uc_hw_id}
\end{figure}

\begin{figure}[h!]
    \centering
    
    \caption{Microcontroller - \acs{I2C} pull-up}
    \label{fig_uc_i2c}
\end{figure}

\FloatBarrier

\subsubsection{Pinout and module usage}
\paragraph{Reference voltage}
The internal reference voltage is only directly accessible in the BGA package. To access the internal voltage reference, the output of the operational amplifier (OPAMP2\_VOUT) is used. For this the amplifiert must be configured to output the refernce voltage. (OPAMP2\_CSR: TSTREF) the referance voltage is then accessible on PA6. 

\subsubsection{Memory}
To store persistent data such as serial number or calibration data, an \ac{I2C} \ac{EEPROM} is used. 

\FloatBarrier

\subsection{\acs{I2C} address list}
All devices on the \ac{I2C} bus are listed in \autoref{tab_i2c_list} to avoid address conflicts. 
\begin{table}[h!]
    \begin{zebratabular}{lllllll}
        \rowcolor{gray}
        Function                & PCB             & Designator    & Device    & \multicolumn{2}{c}{Address}   & Supply voltage \\
        \rowcolor{gray}
                                &                 &               &           & binary    & hex               &                \\
        BMS                     &  Mainboard      & U1            & BQ76905   & 0b0001000 & 0x08              & +3V3\_STBY \\
        EEPROM                  &  Mainboard      & U25           & ZD24C02B  & 0b1010000 & 0x50              & +3V3 \\
        HW ID                   &  Mainboard      & U26           & TCA9554   & 0b0100000 & 0x20              & +3V3 \\
        LED driver              &  User interface & U7            & LP5817    & 0b0101101 & 0x2D              & VLED (UI) \\
        Ambient light sensor    &  User interface & U8            & OPT3004   & 0b1000100 & 0x44              & +3V3 (UI) \\
        Backlight driver        &  User interface & U9            & LP5816    & 0b0101100 & 0x2C              & VLED (UI) \\
    \end{zebratabular}
    \caption{\acs{I2C} address overview}
    \label{tab_i2c_list}
\end{table}

\FloatBarrier

\subsection{User interface}
\label{sec_ui}
A display shows the current operating mode and measurement values to the user. Initially an \ac{OLED} display was evaluated. During testing it was discovered, that the brightness of the display was insufficient for use in direct sunlight. 
\begin{itemize}
    \item Display
    \item Buttons
    \item Rotaty encoder
\end{itemize}

\begin{figure}[h!]
    \centering
    
    \caption{Isolated encoder}
    \label{fig_ui_endocer}
\end{figure}

\begin{figure}[h!]
    \centering
    
    \caption{Isolated encoder}
    \label{fig_ui_endocer}
\end{figure}

\begin{figure}[h!]
    \centering
    
    \caption{User interface connector}
    \label{fig_ui_connector}
\end{figure}

\begin{figure}[h!]
    \centering
    
    \caption{Terminal indicator \acsp{LED} with \ac{LED} driver}
    \label{fig_ui_led_driver}
\end{figure}

\begin{figure}[h!]
    \centering
    
    \caption{High voltage indicator}
    \label{fig_ui_hv_indicator}
\end{figure}

\begin{figure}[h!]
    \centering
    
    \caption{Display}
    \label{fig_ui_display}
\end{figure}

\begin{figure}[h!]
    \centering
    
    \caption{Ambient light sensor}
    \label{fig_ui_amb_light_sensor}
\end{figure}

\begin{figure}[h!]
    \centering
    
    \caption{Backlight driver}
    \label{fig_ui_backlight_driver}
\end{figure}

\FloatBarrier

\subsection{Power supply}
\label{sec_power_supply}
\begin{itemize}
    \item \qty{3.3}{\volt} supply
    \item Alternative charging power supply
\end{itemize}

\FloatBarrier

\subsubsection{Power supply VCC}
\label{sec_power_vcc}

\begin{figure}[h!]
    \centering
    
    \caption{Power - VCC high voltage buck converter}
    \label{fig_power_vcc}
\end{figure}

\begin{figure}[h!]
    \centering
    
    \caption{Power - VCC - logic}
    \label{fig_power_vcc_logic}
\end{figure}

\begin{figure}[h!]
    \centering
    
    \caption{Power - VCC - output or-ing}
    \label{fig_power_vcc_oring}
\end{figure}

\FloatBarrier

\subsubsection{Power supply 15\,V}
\label{sec_power_15v}

\begin{figure}[h!]
    \centering
    
    \caption{Power - \qty{15}{\volt} boost converter}
    \label{fig_power_15v}
\end{figure}

\FloatBarrier

\subsubsection{Power supply 5\,V}
\label{sec_power_5v}

\begin{figure}[h!]
    \centering
    
    \caption{Power - \qty{5}{\volt} buck converter}
    \label{fig_power_5v}
\end{figure}

\FloatBarrier

\subsubsection{Power supply 3.3\,V}
\label{sec_power_3v3}

\begin{figure}[h!]
    \centering
    
    \caption{Power - \qty{3.3}{\volt} buck converter}
    \label{fig_power_3v3}
\end{figure}

\FloatBarrier

\subsubsection{Power supply analog 3.3\,V}
\label{sec_power_3v3_a}

\begin{figure}[h!]
    \centering
    
    \caption{Power - analog \qty{3.3}{\volt} \acs{LDO} regulator}
    \label{fig_power_3v3_a}
\end{figure}

\FloatBarrier

\subsubsection{Power supply VLED}
\label{sec_power_vled}

\begin{figure}[h!]
    \centering
    
    \caption{Power - VLED}
    \label{fig_power_vled}
\end{figure}

\FloatBarrier

\subsubsection{Power supply 3.3\,V UI}
\label{sec_power_3v3_ui}

\begin{figure}[h!]
    \centering
    
    \caption{Power - \qty{3.3}{\volt} UI buck converter}
    \label{fig_power_3v3_ui}
\end{figure}

\FloatBarrier

\subsubsection{Power supply isolated 3.3\,V UI}
\label{sec_power_3v3_iso}

\begin{figure}[h!]
    \centering
    
    \caption{Power - isolated \qty{3.3}{\volt} UI forward converter - primary side}
    \label{fig_power_3v3_iso_prim}
\end{figure}

\begin{figure}[h!]
    \centering
    
    \caption{Power - isolated \qty{3.3}{\volt} UI forward converter - secondary side}
    \label{fig_power_3v3_iso_sec}
\end{figure}

\FloatBarrier

\subsection{Layout}
\label{sec_layout}

\FloatBarrier

\subsubsection{Layer stack}
\label{sec_leayout_stack}

\FloatBarrier

\subsubsection{Clearance}
\label{sec_layout_cleraance}
All signals directly connected to the battery are assignet to the netclass BAT to enforce a minumum clearance of \qty{0.5}{\milli\meter}. An exception is implemented for the gate of Q5 and I2C.SCL. This is necessary due to the low clearance of the packages of the \ac{MOSFET} Q5 and the \ac{BMS} U1. 

\FloatBarrier

\subsubsection{Component placement}
\label{sec_layout_placement}

\FloatBarrier

\subsection{Testing}
\label{sec_testing}
\begin{itemize}
    \item Automatic testing
    \item Testpoints
    \item Calibration
\end{itemize}

\FloatBarrier
