daniw/bat_source/doc/src/concept.tex

\section{Concept}
\label{sec:concept}

\subsection{Charging}
The user must be able to recharge the internal energy source. Multiple concepts are discussed: 

\begin{itemize}
    \item Integrated power supply with mains connector
        \\
        The device is connected to mains for charging. The integrated power supply provides the protective insulation. 
    \item Charging through output plugs
        \\
        A DC voltage is applied to the output pins when the device is switched of, which powers the charger. No insulation is necessary, because no electrically conductive parts are exposed. 
    \item Wireless charging
        \\
        The charger is powered with an alternating magnetic field that is applied from outside the device enclosure, similar to Qi chargers for phones. This might lead to a increased heat output when charging inside the storage enclosure. 
    \item External power supply with integrated charger
        \\
        An external power supply provides the power for charging. Depending on the selected connector type, protective insulation on the charging input or output port might be required. 
\end{itemize}

\subsection{Energy source}
To select an energy source, the following requirements have to be considered: 
\begin{itemize}
    \item \ReqRef{R:Battery} (Internally powered)
    \item \ReqRef{R:Bat_Replace} (Battery replacable)
    \item \ReqRef{R:Endurance} (Runtime)
    \item \ReqRef{R:60V} (Output voltage in voltage mode)
    \item \ReqRef{R:60V_Current} (Output current in voltage mode)
    \item \ReqRef{R:BSPD_Current} (Output current in current mode)
    \item \ReqRef{R:BSPD_Voltage} (Output voltage in current mode)
\end{itemize}

Based on these requirements, the power (\autoref{eq_bat_pow_req}) and energy (\autoref{eq_bat_energy_req}) requirements can be extracted by using an estimated overall efficiency of 0.8. 
\begin{align}
    P_{volt_{max}}
    = U_{volt_{max}} \cdot I_{volt_{max}}
    = \qty{60}{\volt} \cdot \qty{1}{\ampere}
    = \qty{60}{\watt}
\end{align}
\begin{align}
    P_{current_{max}}
    = U_{current{max}} \cdot I_{current{max}}
    = \qty{5}{\volt} \cdot \qty{10}{\ampere}
    = \qty{50}{\watt}
\end{align}
\begin{align}
    \label{eq_bat_pow_req}
    P_{Bat_{max}}
    = \dfrac{max\left(P_{volt_{max}}, P_{current_{max}}\right)}{\eta}
    = \dfrac{\qty{60}{\watt}, \qty{50}{\watt}}{\qty{0.8}{}}
    = \qty{75}{\watt}
\end{align}
\begin{align}
    \label{eq_bat_energy_req}
    E_{Bat_{max}}
    = P_{Bat_{max}} \cdot t_{run}
    = \qty{75}{\watt} \cdot \qty{0.5}{\hour}
    = \qty{37.5}{\watt\hour}
\end{align}

\begin{itemize}
    \item Lead
        \\
        Heavy, low power density, availability questionable due to new european battery regulation
    \item NiMH
        \\
    \item LiIon
        \\
        Very high power- and energy density
    \item LiFePO4
        \\
        High power- and energy density
\end{itemize}

\ReqRef{R:Bat_Replace} requires the battery to be replacable without the need of special tools. For PCB-mounted batteries, a socket should be used, as soldering is considered as using special tools. 

\subsection{User interface}
The user must be able to set the operation mode and adjust the output current. The output voltage and current should be shown to the user. \\
If the cover of the enclosure is transparent, the display can be placed inside the enclosure, which allows for an inherent water proof construction. 

\subsubsection{User interaction}
\begin{itemize}
     \item Touch control
        \\
        Multiple touch sensors can be implemented that can be actuated through the enclosure. No tactile feedback is provided unless an additional actuator is implemented. 
    \item Hall sensors with external magnet
        \\
        Hall sensors can be integrated inside the enclosure which can be actuated by a magnet from outside the enclosure, which would inherently provide ingress protection. A magnet is needed to operate the device, which must always be kept close to the device and there is no tactile feedback as well. 
    \item Buttons / switches
        \\
        Depending of the type of button / switch selected, this provides feedback to the user. The buttons / switches must include ingress protection as they protrude through the enclosure. 
    \item Rotary encoder
        \\
        A rotary encoder with integrated push-button can be used. This solution will provide feedback to the user. The encoder must include ingress protection for water. 
\end{itemize}

\subsubsection{Display type}
\begin{itemize}
     \item 7-segment
        \\
    \item 13-segment
        \\
    \item Alphanumeric
        \\
    \item Dot marix
        \\
    \item Graphical
        \\
\end{itemize}

\subsubsection{Display technology}
\begin{itemize}
     \item \acs{LED}
        \\
        A \ac{LED} display is self-illuminating and therefore especially good readable in low-light conditions. For readability in sunlight, the brightness of the display must be sufficiently high. An automatic adjustment of the brighness might be beneficial. 
    \item \acs{LCD}
        \\
        \acp{LCD}
    \item \acs{TFT}
        \\
    \item \acs{OLED}
        \\
    \item \acs{VFD}
        \\
    \item E-paper display
        \\
\end{itemize}

\subsubsection{Calibration}
\ReqRef{R:Calibration} requires a means to calibrate the output values of the source. Therefore a communication interface must be implemented to allow sending and receiving commands and measurement values. 

\begin{itemize}
    \item User interface
        \\
        The values are entered through the user interface. This eliminates the need for additional hardware for the calibration procedure. 
    \item Wired connection
        \\
        A wired conections (\ac{USB}, RS232, Ethernet) allows easy connection to the device, but might require additional galvanic isolation between the interface and the output terminals. 
    \item Optical
        \\
        An optical interface (eg. IRDa) allows for wireless communication with inherent galvanic insulation. As it requires line-of-sight to the device, it can not be accessed from large distances or connected to the wrong device, when handling multiple devices. 
    \item Radio
        \\
        Radio communication (Wifi, Bluetooth, \ldots) allows for wireless communication with inherent galvanic insulation. The range allows for a very flexible setup for calibration. 
    \item Magneto-optic
        \\
        An assymmetric interface with a magnetic field for one direction and optical communication for the oposite direction allows for wireless communication with inherent galvanic insulation. As this would be a custom interface, the implementation will require more effort. The magnetic field might interfere with the measurements during calibration. 
\end{itemize}

\FloatBarrier
\subsection{Mechanical Design}
\todo[inline]{Check which parts belong to the hardware / mechanical section rather than concept}

\subsubsection{Enclosure}
An off-the-shelf enclose CSACTT04 manufactured by Camdenboss is used to house all components. The variant with a transparent lid is used. 

\subsubsection{Battery}
The battery cells are mechanically mounted using a battery holder that is produced using additive manufacturing. \todo{better word for 3D-printing?} 
Nickel strips are spot-welded to the cell tabs and soldered into the PCB. The nickel strips have a width of \qty{6}{\milli\meter} and a thickness of \qty{0.3}{\milli\meter}. 
The battery holder and the \ac{PCB} are mounted to the mounting posts of the enclosure using four screws. 

\subsubsection{Output terminals}
Shrouded \qty{4}{\milli\meter} plugs SLB4-F6.3 produced by Stäubli are used for the output terminals. Due to space constraints on the main PCB, the plugs are moved outside the enclosure by \qty{100}{\milli\meter} \todo{Add actual spacing} by an additively manufactured spacer. The spacer is glued to the enclosure. \todo{Specify glue?} The plugs need to be pushed into the spacer from the outside and fastened from the inside. Because the original tool \todo{better name?} is too long for use inside the enclosure, a custom nut is manufactured to tighten the plugs. 

\subsubsection{User interface}
The user interface PCB is mounted to the lid of the enclosure using screws and spacers. The buttons must be mounted to the lid before soldering them on the PCB. 

\subsubsection{Ingress protection}

\FloatBarrier
\subsection{EMI Concept}

\FloatBarrier
\subsection{Interfaces}

\FloatBarrier
\subsection{Cost estimation}
\todo[inline]{Check if the table is still required and remove it if not needed any longer. Otherwise consider updating it. }
%\STautoround*{2}

% Output Converter: 
% - Inductor Boost 22uH, Buck 820nH-1.3uH
% Think abour PCB integrated winding --> Check 10A capability
% L =1.50 Fr
% MOSFETs: ca 1Fr pro Stück

% Enclosure (CHDX6-321C): 8.85

%% Alternative zu Display: 
% - 4x 7-Segment: 1.- mit Schieberegister 0.80 Fr und ein paar LEDs --> 2.20Fr

%% Alternative zum teueren Halter: 
% 36-246-ND Benötigt 2 pro Zelle -> 1.00 Fr pro Akku

\nprounddigits2
\begin{table}[h!]
    \centering
    \begin{spreadtab}{{zebratabular}{p{0.27\linewidth}lN{3}{2}n{5}{2}p{0.4\linewidth}}}
        \rowcolor{gray}
        @ Component                     & @ Qty & @ Cost    & @ Total cost              & @ Comment \\
        \rowcolor{gray}
        @                               & @     & @{[CHF]}  & @{[CHF]}                  & @  \\
        @ Battery                       & 4     & 3.00      & [-2,0]*[-1,0]   & @ LiFePO4 26650 \\
        @ Battery holder                & 4     & 3.00      & [-2,0]*[-1,0]   & @ Alternative: 36-246-ND $\to$ 2.00 CHF \\
        @ BMS                           & 1     & 1.00      & [-2,0]*[-1,0]   & @ TI BQ77905 \\
        @ ON/OFF controller             & 1     & 1.00      & [-2,0]*[-1,0]   & @  \\
        @ Output converter              & 1     & 6.00      & [-2,0]*[-1,0]   & @ Boost Inductor: \qty{22}{\micro\henry}, Buck Inductor: \qty{820}{\nano\henry} \ldots \qty{1.3}{\micro\henry}, consider PCB-integrated winding (check 10A capability), L = 1.50CHF, MOSFET: 1 CHF per piece \\
        @ Internal supply               & 1     & 3.00      & [-2,0]*[-1,0]   & @  \\
        @ Voltage measurement           & 2     & 0.30      & [-2,0]*[-1,0]   & @  \\
        @ Current measurement           & 2     & 0.80      & [-2,0]*[-1,0]   & @  \\
        @ Output terminal               & 2     & 3.50      & [-2,0]*[-1,0]   & @ Stäubli 23.3000-21 / 23.3000-22 or Stäubli 23.3060-21 / 23.3060-22 \\
        @ Cables                        & 1     & 0.10      & [-2,0]*[-1,0]   & @  \\
        @ Overvoltage protection        & 1     & 0.50      & [-2,0]*[-1,0]   & @  \\
        @ Reverse polarity protection   & 1     & 3.00      & [-2,0]*[-1,0]   & @ Fuse: 3AB, 3AG ($\frac{1}{4}$" x $1 \frac{1}{4}$") \\
        @ Discharge                     & 1     & 2.00      & [-2,0]*[-1,0]   & @  \\
        @ Microcontroller               & 1     & 3.00      & [-2,0]*[-1,0]   & @  \\
        @ Voltage reference             & 1     & 1.00      & [-2,0]*[-1,0]   & @  \\
        @ Display                       & 1     & 5.00      & [-2,0]*[-1,0]   & @ E-paper, Alternative to display: 4x 7-segment with shift-register and some leds $\to$ 2.20 CHF \\
        @ Button                        & 1     & 4.00      & [-2,0]*[-1,0]   & @ 7346710 \\
        @ Rotary encoder                & 1     & 2.00      & [-2,0]*[-1,0]   & @ Bourns PAC18R / Bourns 3315 \\
        @ LED                           & 1     & 0.20      & [-2,0]*[-1,0]   & @  \\
        @ Enclosure                     & 1     & 8.85      & [-2,0]*[-1,0]   & @ CHDX6-321C \\
        @ Label                         & 1     & 2.00      & [-2,0]*[-1,0]   & @  \\
        @ Seal                          & 1     & 0.00      & [-2,0]*[-1,0]   & @  \\
        @ Lightguide                    & 1     & 0.10      & [-2,0]*[-1,0]   & @  \\
        @ PCB                           & 1     & 1.30      & [-2,0]*[-1,0]   & @  \\
        @                               & 0     & 0.00      & [-2,0]*[-1,0]   & @  \\
        \rowcolor{gray}
        @ Total                         &       &           & sum(d2:[0,-1])            & @
    \end{spreadtab}
    \caption{Cost estimation}
    \label{tab:cost_estimation}
\end{table}

\subsection{Standards}

\subsubsection{IEC 61010-2-34}
SAFETY REQUIREMENTS FOR ELECTRICAL EQUIPMENT FOR MEASUREMENT, CONTROL, AND LABORATORY USE – Part 2-034: Particular requirements for measurement equipment for insulation resistance and test equipment for electric strength

\FloatBarrier
