daniw/bat_source/doc/src/acronyms.tex

\section*{Acronyms}
%\addcontentsline{toc}{section}{Abkürzungen}
\begin{acronym}[Acronyms]
    \acro{ADC}{analog digital converter}
    \acro{BJT}{bipolar junction transistor}
    \acro{BMS}{battery management system}
    \acro{CRC}{cyclic reduncancy check}
    \acro{CMOS}{complementary metal oxide semiconductor}
    \acro{FEM}{finite element method}
    \acro{DeltaSigma}[$\Delta\Sigma$]{delta-sigma}
    \acro{DUT}{device under test}
    \acro{EEPROM}{electrically erasable programmable read only memory}
    \acro{ESD}{electro static discharge}
    \acro{ESR}{equivalent series resistor}
    \acro{FET}{field effect transistor}
    \acro{GaN}{gallium nitride}
    \acro{GDT}{gas discharge tube}
    \acro{GPIO}{general purpose input output}
    \acro{GUI}{Graphical User Interface}
    \acro{HRTIM}{high-resolution timer}
    \acro{I2C}[I$^{2}$C]{inter-integrated circuit}
    \acro{IC}{integrated circuit}
    \acro{IO}[I/O]{input output}
    \acro{LCD}{liquid crystal display}
    \acro{LDO}{low dropout}
    \acro{LED}{light emitting diode}
    \acro{LFP}{lithium ferrite phosphate}
    \acro{LiIon}{lithium ion}
    \acro{LiPo}{lithium polymer}
    \acro{LSB}{least significant bit}
    \acro{MOSFET}{metal oxide semiconductor field effect transistor}
    \acro{NTC}{Negative Temperature Coefficient Thermistor}
    \acro{OLED}{organic light emitting diode}
    \acro{OVP}{overvoltage protection}
    \acro{PCB}{printed circuit board}
    \acro{PWM}{pulse width modulation}
    \acro{RMS}{root-mean square}
    \acro{RTC}{real time clock}
    \acro{SAR}{successive approximation register}
    \acro{SoC}{State of Charge}
    \acro{SI}{système international d'unités}
    \acro{SMD}{surface mount device}
    \acro{SMT}{surface mount technology}
    \acro{SNR}{signal-to-noise ratio}
    \acro{SPI}{serial peripheral interface}
    \acro{TFT}{thin film transistor}
    \acro{THD}{through-hole mounted device}
    \acro{THT}{through-hole technology}
    \acro{TI}{Texas Instruments}
    \acro{UART}{universal asynchronous receiver - transmitter}
    \acro{UI}{user interface}
    \acro{USB}{universal serial bus}
    \acro{VFD}{vacuum fluorescent display}
\end{acronym}
