daniw/bat_source/doc/src/titlepage.tex

\begin{titlepage}

    %\vspace{4mm}

    \begin{center}
        %\includegraphics[height=0.5\textheight]{img/2026-03-06_Bat_Source_Multiboard_Render.png}
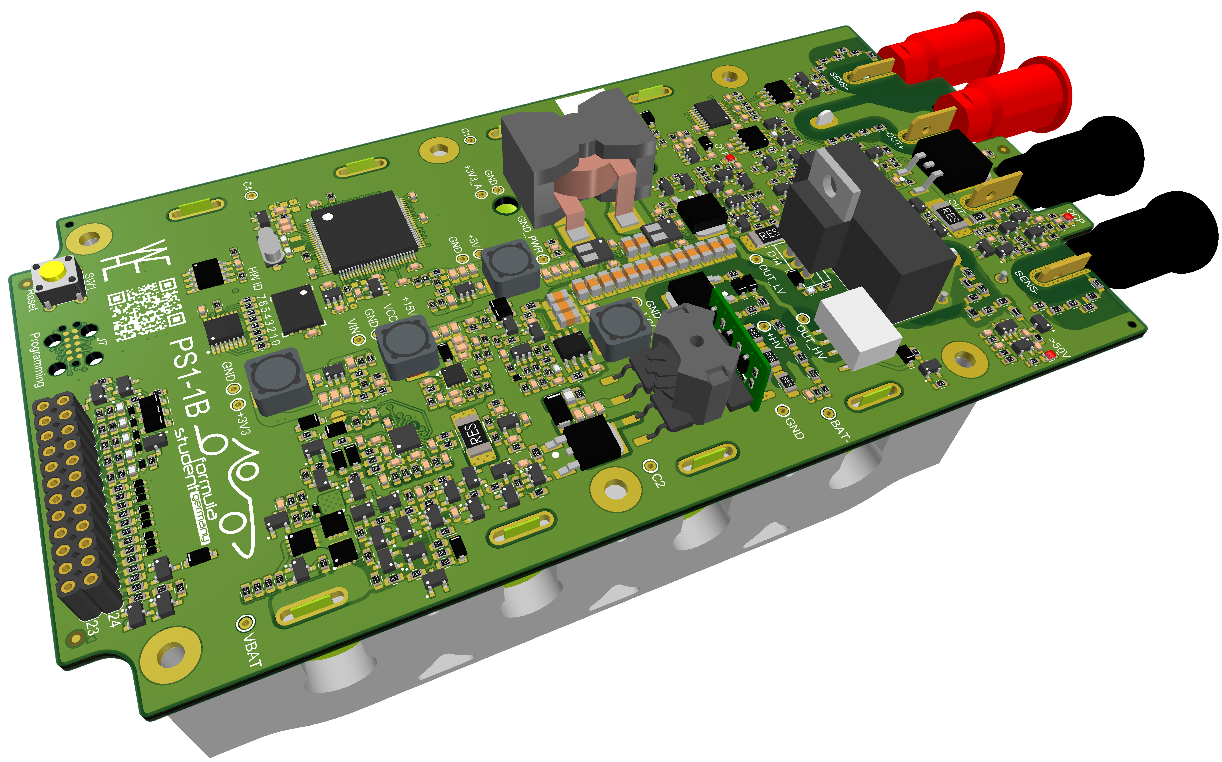
[picture p3: doc/img/PS1-1BA_PCB 3D Print_2026-03-06.png]
        
        \addcontentsline{lof}{figure}{Title image}
    \end{center} 

    \vspace{2mm}

    \begin{center}
        \rule{\textwidth}{2pt}
    \end{center}

    \vspace{2mm}

    \begin{center}
        \huge{\textbf{BatSource}}\\
        \vspace{4mm}
        \LARGE{\textbf{Test equipment for technical inspection (accumulator and electrical) in formula student}}\\
        \vspace{4mm}
        \Large{Technical documentation}
    \end{center}
    
    \vspace{2mm}

    \begin{center}
        \rule{\textwidth}{2pt}
    \end{center}

    \vspace{4mm}

    \begin{center}
        Authors:\\
        \large{\makeatletter \@author \makeatother}\\
        \vspace{4mm}
    \end{center}

    \vspace{3mm}

    \begin{center}
        Schwyz, \today
    \end{center}

\end{titlepage}
\clearpage
