daniw/bat_source/hw/Cost Estimation.xlsx

Sheet: Bestellungen Prototypen
Projekt: | Bestellung 60V Quelle |  |  |  |  |  |  |  |  | €999.29 | €199.86
 |  |  |  |  |  | € 1’185.73 |  |  |  | €851.77 | €147.52 | €173.25 | €1172.54
Datum | Bauteil | Hersteller | Hersteller Nummer | Anzahl | Preis/Stück | Gesamtpreis | PS1-1 | PS1-2 | PS1-3 | PS1-1 | PS1-2 | PS1-3
4/17/2025 | Akkuzellen LFP 26700 | Tenpower | IFR26700-45HE | 30 | €2.25 | €67.50 | 1 | 0 | 0 | €67.50 | €0.00 | €0.00
4/17/2025 | Nickelstreifen | - | 7417940522876 | 1 | €2.75 | €2.75 | 1 | 0 | 0 | €2.75 | €0.00 | €0.00
~~4/17/2025~~ | ~~Gehäuse~~ | ~~CAMDENBOSS~~ | ~~CSACTT004~~ | ~~0~~ | ~~CHF 22.65~~ | ~~0~~ |  |  |  | €0.00 | €0.00 | €0.00
4/17/2025 | Gehäuse | CAMDENBOSS | CSACTT004 | 6 | CHF 24.69 | 148.12 | 1 | 0 | 0 | €148.12 | €0.00 | €0.00
4/17/2025 | STM32 Eval Board / Programmierer | STMicroelectronics | NUCLEO-F334R8 | 2 | $11.04 | $22.08 | 0 | 0 | 1 | €0.00 | €0.00 | €22.08
4/17/2025 | Tag-Connect Programmieradapter | Tag-Connect LLC | TC2050-IDC | 2 | $39.00 | $78.00 | 0 | 0 | 1 | €0.00 | €0.00 | €78.00
~~4/17/2025~~ | ~~Buchse 4mm rot~~ | ~~Stäubli Electrical Connectors~~ | ~~23.3060-22~~ | ~~0~~ | ~~CHF 3.64~~ | ~~0~~ |  |  |  | €0.00 | €0.00 | €0.00
4/17/2025 | Buchse 4mm rot | Stäubli Electrical Connectors | 23.3060-22 | 10 | CHF 4.21 | 42.11 | 1 | 0 | 0 | €42.11 | €0.00 | €0.00
~~4/17/2025~~ | ~~Buchse 4mm schwarz~~ | ~~Stäubli Electrical Connectors~~ | ~~23.3060-21~~ | ~~0~~ | ~~CHF 4.16~~ | ~~0~~ |  |  |  | €0.00 | €0.00 | €0.00
4/17/2025 | Buchse 4mm schwarz | Stäubli Electrical Connectors | 23.3060-21 | 10 | CHF 4.53 | 45.26 | 1 | 0 | 0 | €45.26 | €0.00 | €0.00
~~4/17/2025~~ | ~~Taster rot~~ | ~~RS PRO~~ | ~~7346716~~ | ~~0~~ | ~~CHF 5.63~~ | ~~0~~ |  |  |  | €0.00 | €0.00 | €0.00
4/17/2025 | Taster rot | RS PRO | 7346716 | 5 | CHF 5.21 | 26.04 | 0 | 1 | 0 | €0.00 | €26.04 | €0.00
~~4/17/2025~~ | ~~Taster schwarz~~ | ~~RS PRO~~ | ~~7346704~~ | ~~0~~ | ~~CHF 5.09~~ | ~~0~~ |  |  |  | €0.00 | €0.00 | €0.00
4/17/2025 | Taster schwarz | RS PRO | 7346704 | 5 | CHF 4.72 | 23.58 | 0 | 1 | 0 | €0.00 | €23.58 | €0.00
4/17/2025 | Encoder | Knitter-Switch | MERP11-15125BM7 | 5 | $1.37 | $6.86 | 0 | 1 | 0 | €0.00 | €6.86 | €0.00
4/17/2025 | Display | HS | HS242L03B2C01 | 5 | $10.73 | $53.66 | 0 | 1 | 0 | €0.00 | €53.66 | €0.00
4/17/2025 | Ferritkern | EPCOS - TDK Electronics | B66285G0000X187 | 10 | $1.79 | $17.94 | 1 | 0 | 0 | €17.94 | €0.00 | €0.00
4/17/2025 | Klammer für Ferritkern | EPCOS - TDK Electronics | B66286A2000X000 | 10 | $0.49 | $4.86 | 1 | 0 | 0 | €4.86 | €0.00 | €0.00
4/17/2025 | Kondensator 680uF 6.3V | KEMET | A750EK687M0JAAE008 | 20 | $0.51 | $10.16 | 1 | 0 | 0 | €10.16 | €0.00 | €0.00
4/17/2025 | Kondensator 15uF 100V | KYOCERA AVX | RPF0811150M100K | 10 | $0.92 | $9.20 | 1 | 0 | 0 | €9.20 | €0.00 | €0.00
4/17/2025 | Relais SPDT | Omron Electronics Inc-EMC Div | G6RL-14-ASI DC12 | 5 | $3.72 | $18.59 | 1 | 0 | 0 | €18.59 | €0.00 | €0.00
4/17/2025 | Relais DPDT | American Zettler | AZ822-2C-12DSE | 5 | $1.56 | $7.78 | 0 | 0 | 0 | €0.00 | €0.00 | €0.00
4/17/2025 | Widerstand 51kOhm | TE Connectivity Passive Product | ROX5SSJ51K | 10 | $0.56 | $5.58 | 0 | 0 | 0 | €0.00 | €0.00 | €0.00
4/17/2025 | Thyristor | WeEn Semiconductors | TYN30-600TFQ | 5 | $1.23 | $6.16 | 1 | 0 | 0 | €6.16 | €0.00 | €0.00
4/17/2025 | Reset Taster | Omron Electronics Inc-EMC Div | B3F-1002 | 5 | $0.31 | $1.57 | 1 | 0 | 0 | €1.57 | €0.00 | €0.00
4/17/2025 | Sicherungshalter | Littelfuse Inc. | 03540101ZXGY | 5 | $1.34 | $6.69 | 1 | 0 | 0 | €6.69 | €0.00 | €0.00
4/17/2025 | Sicherung | Bel Fuse Inc. | 0ADEC9100-BE | 10 | $2.41 | $24.08 | 1 | 0 | 0 | €24.08 | €0.00 | €0.00
4/17/2025 | Buchsenleiste | Preci-Dip | 801-87-018-10-001101 | 5 | CHF 1.94 | 9.7 | 0 | 0 | 1 | €0.00 | €0.00 | €9.70
4/17/2025 | Stiftleiste | Adam Tech | 2057-PH1-18-UA-ND | 5 | CHF 0.20 | 1 | 0 | 0 | 1 | €0.00 | €0.00 | €1.00
16.05.2025 | Platine TT1-1CA | JLCPCB |  | 5 | $5.98 | $29.90 | 0 | 0 | 0 | €0.00 | €0.00 | €0.00
16.05.2025 | Platine PS1-124AA | JLCPCB |  | 5 | $1.30 | $6.50 | 1 | 0 | 0 | €6.50 | €0.00 | €0.00
16.05.2025 | Platine PS1-102AA | JLCPCB |  | 15 | $0.40 | $6.00 | 1 | 0 | 0 | €6.00 | €0.00 | €0.00
16.05.2025 | Platine TI1-1BA | JLCPCB |  | 30 | $0.75 | $22.50 | 0 | 0 | 0 | €0.00 | €0.00 | €0.00
16.05.2025 | Platine PS1-101AA | JLCPCB |  | 10 | $0.58 | $5.80 | 1 | 0 | 0 | €5.80 | €0.00 | €0.00
16.05.2025 | Platine PS1-3AA | JLCPCB |  | 5 | $10.16 | $50.80 | 0 | 0 | 1 | €0.00 | €0.00 | €50.80
16.05.2025 | Platine PS1-1AA | JLCPCB |  | 5 | $71.05 | $355.25 | 1 | 0 | 0 | €355.25 | €0.00 | €0.00
16.05.2025 | Platine PS1-2AA | JLCPCB |  | 5 | $7.27 | $36.35 | 0 | 1 | 0 | €0.00 | €36.35 | €0.00
17.05.2025 | Relais SPDT | Omron Electronics Inc-EMC Div | G6RL-14-ASI DC12 | 10 | $3.72 | $37.19 | 1 | 0 | 0 | €37.19 | €0.00 | €0.00
17.05.2025 | Instrumentenverstärker | Microchip Technology | MCP6N11-001E/SN | 25 | CHF1.29 | 32.18 | 1 | 0 | 0 | €32.18 | €0.00 | €0.00
17.05.2025 | Buchsenleiste | Sullins Connector Solutions | SFH11-PBPC-D07-ST-BK | 5 | CHF0.74 | 3.86 | 1 | 0 | 0 | €3.86 | €0.00 | €0.00
17.05.2025 | Stiftleiste | Cvilux USA | CH87102V200 | 5 | CHF0.21 | 1.03 | 0 | 1 | 0 | €0.00 | €1.03 | €0.00
17.05.2025 | Buchsenleiste | Samtec Inc. | SSQ-112-03-T-D | 5 | CHF2.33 | 11.67 | 0 | 0 | 1 | €0.00 | €0.00 | €11.67
17.05.2025 | Widerstand 10kOhm | Vishay Beyschlag/Draloric/BC Components | MBE04140C1002FC100 | 500 | CHF0.20 | Fr. 99.48
17.05.2025 | Widerstand 100kOhm | Vishay Beyschlag/Draloric/BC Components | MBE04140C1003FC100 | 400 | CHF0.22 | Fr. 87.73
17.05.2025 | Schalter DPDT | Adam Tech | SW-T2-4B-A-T1-S-03 | 230 | CHF3.00 | Fr. 690.64
17.05.2025 | Flachstecker | TE Connectivity AMP Connectors | 1217861-1 | 60 | CHF0.06 | Fr. 3.50
~~4/17/2025~~ | ~~Buchse 4mm schwarz~~ | ~~Stäubli Electrical Connectors~~ | ~~23.3060-21~~ | ~~10~~ | ~~CHF 4.16~~ | ~~CHF 41.58~~
4/17/2025 | Buchse 4mm schwarz | Stäubli Electrical Connectors | 23.3060-21 | 10 | CHF 4.53 | CHF 45.26
~~17.05.2025~~ | ~~Gehäuse~~ | ~~RS PRO~~ | ~~2010179~~ | ~~30~~ | ~~CHF 15.93~~ | ~~Fr. 477.90~~
18.05.2025 | Gehäuse | RS PRO | 2010179 | 30 | €16.71 | €501.30
17.05.2025 | Widerstand 560Ohm | YAGEO | RC2512FK-07560RL | 28 | CHF 0.10 | Fr. 2.72
17.05.2025 | Potentiometer 1kOhm | Vishay Spectrol | M63M102KB30T607 | 2 | CHF 6.18 | Fr. 12.37
17.05.2025 | Gleichtaktdrossel 1mH | SCHURTER Inc. | DFKH-14-0003 | 2 | CHF 3.99 | Fr. 7.98
17.05.2025 | Kondensator 1uF | EPCOS - TDK Electronics | B32924C3105K000 | 2 | CHF 1.50 | Fr. 3.01
17.05.2025 | Kondensator 2.2nF | EPCOS - TDK Electronics | B32021A3222K000 | 4 | CHF 0.61 | Fr. 2.42
17.05.2025 | Sicherung 3.15A | SCHURTER Inc. | 3403.0171.24 | 4 | CHF 0.65 | Fr. 2.59
17.05.2025 | NTC 25Ohm | EPCOS - TDK Electronics | B57236S0250M000 | 2 | CHF 0.84 | Fr. 1.69
17.05.2025 | Gleichtaktdrossel 30mH | Würth Elektronik | 7448050530 | 2 | CHF 13.12 | Fr. 26.25
17.05.2025 | Ferrit 30Ohm | Laird-Signal Integrity Products | HI0603R300R-10 | 2 | CHF 0.16 | Fr. 0.32
17.05.2025 | Kondensator 100nF | YAGEO | CC0603KPX7R9BB104 | 2 | CHF 0.09 | Fr. 0.17
17.05.2025 | Widerstand 330kOhm | YAGEO | RC1206FR-07330KL | 12 | CHF 0.01 | Fr. 0.16
17.05.2025 | Anschluss Inverter | WAGO Corporation | 770-803/011-000 | 2 | CHF 2.80 | Fr. 5.60
17.05.2025 | Anschluss Netzversorgung | WAGO Corporation | 770-813/011-000 | 2 | CHF 2.49 | Fr. 4.97
17.05.2025 | Relais DPDT | American Zettler | AZ822-2C-12DSE | 7 | CHF 1.26 | Fr. 8.85
17.05.2025 | Relais SPST | American Zettler | AZ2150-1A-12DEF | 4 | CHF 2.11 | Fr. 8.43
17.05.2025 | Varistor | Panasonic Electronic Components | ERZ-E11A391 | 2 | CHF 0.27 | Fr. 0.54
17.05.2025 | Sicherungshalter | SCHURTER Inc. | 3-132-874 | 4 | CHF 1.21 | Fr. 4.84
17.05.2025 | Netzteil 12V | MEAN WELL USA Inc. | IRM-10-12 | 2 | CHF 7.47 | Fr. 14.94
17.05.2025 | Steckverbinder 3 Pin | Phoenix Contact | 1803280 | 2 | CHF 1.33 | Fr. 2.66
17.05.2025 | Steckverbinder 4 Pin | Phoenix Contact | 1803293 | 2 | CHF 1.74 | Fr. 3.48
17.05.2025 | Steckverbinder 5 Pin | Phoenix Contact | 1803303 | 4 | CHF 2.09 | Fr. 8.35
17.05.2025 | Steckverbinder 6 Pin | Phoenix Contact | 1803316 | 2 | CHF 2.49 | Fr. 4.97
17.05.2025 | Steckverbinder 14 Pin | Phoenix Contact | 1803390 | 2 | CHF 5.23 | Fr. 10.46
17.05.2025 | LED blau | Würth Elektronik | 150060BS75000 | 4 | CHF 0.14 | Fr. 0.56
17.05.2025 | LED grün | Würth Elektronik | 150060VS75000 | 2 | CHF 0.13 | Fr. 0.26
17.05.2025 | LED rot | Würth Elektronik | 150060RS75000 | 4 | CHF 0.13 | Fr. 0.52
17.05.2025 | LED gelb | Würth Elektronik | 150060YS75000 | 4 | CHF 0.13 | Fr. 0.52
17.05.2025 | Schottky Diode | Taiwan Semiconductor Corporation | SS24 | 16 | CHF 0.18 | Fr. 2.94
17.05.2025 | Widerstand 100kOhm | Vishay Beyschlag/Draloric/BC Components | MBE04140C1003FC100 | 2 | CHF 0.57 | Fr. 1.15
17.05.2025 | Anschluss Inverter | WAGO Corporation | 770-213 | 2 | CHF 3.16 | Fr. 6.31
17.05.2025 | Anschluss Netzversorgung | WAGO Corporation | 770-203 | 2 | CHF 3.59 | Fr. 7.18
17.05.2025 | Steckverbinder 3 Pin | Phoenix Contact | 1803581 | 2 | CHF 3.36 | Fr. 6.72
17.05.2025 | Steckverbinder 4 Pin | Phoenix Contact | 1803594 | 2 | CHF 4.35 | Fr. 8.69
17.05.2025 | Steckverbinder 5 Pin | Phoenix Contact | 1803604 | 4 | CHF 5.30 | Fr. 21.19
17.05.2025 | Steckverbinder 6 Pin | Phoenix Contact | 1803617 | 2 | CHF 6.22 | Fr. 12.43
17.05.2025 | Steckverbinder 14 Pin | Phoenix Contact | 1803691 | 2 | CHF 13.24 | Fr. 26.48
17.04.2025 | Buchse 4mm schwarz | Stäubli Electrical Connectors | 23.3060-21 | 50 | CHF 4.53 | CHF 226.30
08.06.2025 | Flachsteckhülse | RS PRO | 270-7571 | 200 | €0.10 | €20.00
08.06.2025 | Einzeladerleitung 1mm^2 schwarz 5m | RS PRO | 210-1252 | 1 | €17.73 | €17.73
19.06.2025 | Display | Newhaven | 757-NHD-2.4-240320AF-CSXP-ND | 2 | CHF 16.57 | Fr. 33.14
20.06.2025 | Display Adapter | Newhaven | NHD-FFC40-ND | 1 | CHF 8.79 | Fr. 8.79

Sheet: Prototyp 1
Kostenübersicht Prototyp 1
Bestellung | Kosten
Bestellung Hauptplatine | 851.77
Bestellung User Interface | 147.52
Bestellung Programmieradapter | 173.25
Kosten 5 Prototypen | 999.29
Kosten 5 Prototypen mit Programmieradapter | 1172.54

Sheet: Fehlende Komponenten
Fehlende Komponenten
Komponente | Kosten | Beschreibung
Akkuhalter | 2.16 | 3D Druck, Filamentkosten
Buchsenhalter | 0.5 | 3D Druck
Dichtungen | 2 | Kaufteil?
Füller Luftspalt | 0.5 | Kaptonband?, gelasert?
Isolation Trafo | 0.5 | Kaptonband?, gelasert?
Stecker und Buchse UI | 1 | Falsche Pinzahl bestellt
Schrauben | 1
Total | 7.66

Sheet: Zusatzkosten Verbesserung V2
Zusatzkosten Verbesserung V2
Komponente | Zusatzkosten | Grund
LCD | 6 | Aktuelles Display in direktem Sonnenlicht nicht ablesbar
uC | 2 | Notwendig wegen Displayänderung und Speichermangel
Light Sensor | 0.6 | Um Displayhelligkeit dem Umgebungslicht anzupassen
LED driver | 3 | Um Hintergrundbeleuchtung anzusteuern
PCB 6Layer | 1 | Aufgrund erhöhtem Platzbedarf
Total | 12.6

Sheet: Kostenabschätzung
Kostenabschätzung
Prototyp V2 | Before FSG 25 | Stated at FSG 25 | Reevaluation Oct 2025
5 Prototypen | 999.29
Fehlende Komponenten | 38.3
Verbesserungen | 63
Gesamtkosten Prototyp 2 | 1100.59 | 1000 | 1000
Pro Gerät | 220.118
Serie
Einsparung 25er-Serie pro Gerät | 30.0824
Einzelkosten Serie | 190.0356
Gesamtkosten Serie | 4750.89 | 5000 | 5000

Sheet: Kostenabschätzung Serie Detail
Detailierte Kostenabschätzung Serie
 |  | 784.27 | 2058.39 | 3169.29 | 156.854 | 82.3356 | 126.7716 |  |  | 177.594 | 22.264
 | Anzahl | 5 | 25 | 25 estimated | 1/5 | 1/25 | 1/15 estim | Abzüge | 248.48 | 20.74 |  | 182.3756
PS1-1 | 1 | 30.4 |  | 152 | 6.08 | 0 | 6.08 | Akkus in BOM etwa 0.43€ günstiger | 12.9 | 2.58
PS1-1 ASM | 1 | 18.74 |  | 93.7 | 3.748 |  | 3.748 | Gehäuse in BOM etwa 12€ günstiger | 60 | 12
PS1-1 Ext. Comp | 1 | 117 |  | 117 | 23.4 |  | 4.68 | STM Eval Board 2x11.04@ | 22.08
PS1-1 BOM | 1 | 446.24 | 1972.6 | 1972.6 | 89.248 | 78.904 | 78.904 | TAG Connect: 2x39€ | 78
15uF 100V | 2 | 9.2 |  | 46 | 1.84 | 0 | 1.84 | Buchsen rot wurden etwa 1.38€ teurer eingekauft | 13.8 | 2.76
220N/0603 | 1 |  |  | 0 | 0 | 0 | 0 | Buchsen schwarz wurden etwa 1.7€ teurer eingekauft | 17 | 3.4
Header 2x12 | 1 | 3.68 |  | 18.4 | 0.736 | 0 | 0.736 | PS1-3 | 44.7
AGM40P35AP | 3 | 3 |  | 15 | 0.6 | 0 | 0.6
AGM18N10AP | 1 | 0.8 |  | 4 | 0.16 | 0 | 0.16
ZD24C02B | 1 | 0.25 |  | 1.25 | 0.05 | 0 | 0.05
Nickelstreifen | 0.24 |  |  | 0 | 0 | 0 | 0
PS1-2 | 1 | 10.1 |  | 50.5 | 2.02 | 0 | 2.02
PS1-2 ASM | 1 |  |  |  | 0 |  | 0
PS1-2 BOM | 1 | 22.25 | 85.79 | 85.79 | 4.45 | 3.4316 | 3.4316
Header 2x12 | 1 | 1.03 |  | 5.15 | 0.206 | 0 | 0.206 | Source
Button red | 1 | 26.04 |  | 130.2 | 5.208 | 0 | 5.208 | AD BOM
Button black | 1 | 23.58 |  | 117.9 | 4.716 | 0 | 4.716 | Order
OLED | 1 | 53.66 |  | 268.3 | 10.732 | 0 | 10.732
PS1-101 | 2 | 5.8 |  | 29 | 1.16 | 0 | 1.16
PS1-102 | 3 | 6 |  | 30 | 1.2 | 0 | 1.2
PS1-124 | 1 | 6.5 |  | 32.5 | 1.3 | 0 | 1.3

Sheet: Kostenabschätzung Serie Det (2)
Detailierte Kostenabschätzung Serie
 |  | 945.3865 | 2946.32 | 3838.00642 | 189.0773 | 117.8528 | 153.5202568 |  |  | 209.8173 | -9.9593
 | Anzahl | 5 | 25 | 25 estimated | 1/5 | 1/25 | 1/15 estim | Abzüge | 248.48 | 20.74 |  | 176.9009568
PS1-1 | 1 | 30.4 |  | 152 | 6.08 | 0 | 6.08 | Akkus in BOM etwa 0.43€ günstiger | 12.9 | 2.58
PS1-1 ASM | 1 | 18.74 |  | 93.7 | 3.748 |  | 3.748 | Gehäuse in BOM etwa 12€ günstiger | 60 | 12
PS1-1 Ext. Comp | 1 | 117 |  | 117 | 23.4 |  | 4.68 | STM Eval Board 2x11.04@ | 22.08
PS1-1 BOM | 1 | 507.35 | 2290.94 | 2290.94 | 101.47 | 91.6376 | 91.6376 | TAG Connect: 2x39€ | 78
15uF 100V | 2 | 9.2 |  | 46 | 1.84 | 0 | 1.84 | Buchsen rot wurden etwa 1.38€ teurer eingekauft | 13.8 | 2.76
220N/0603 | 1 |  |  | 0 | 0 | 0 | 0 | Buchsen schwarz wurden etwa 1.7€ teurer eingekauft | 17 | 3.4
Header 2x12 | 1 | 3.68 |  | 18.4 | 0.736 | 0 | 0.736 | PS1-3 | 44.7
AGM40P35AP | 3 | 3 |  | 15 | 0.6 | 0 | 0.6
AGM18N10AP | 1 | 0.8 |  | 4 | 0.16 | 0 | 0.16
ZD24C02B | 1 | 0.25 |  | 1.25 | 0.05 | 0 | 0.05
Nickelstreifen | 0.24 |  |  | 0 | 0 | 0 | 0
Spulenkörper | 1 | 8.5 |  | 27.01419 | 1.7 | 0 | 1.0805676
Draht 0.5mm | 0.2 | 8.06 |  | 8.06 | 1.612 | 0 | 0.3224
Draht 0.15mm | 6 | 11.76 |  | 11.76 | 2.352 | 0 | 0.4704
Ferrit (Set) | 1 | 16.215 |  | 54.05 | 3.243 | 0 | 2.162
Clamps | 2 | 1.6215 |  | 6.30223 | 0.3243 | 0 | 0.2520892
Verbindungsplatine | 1 | 5 |  | 15 | 1 | 0 | 0.6
Gatedriver | 2 | 15 |  | 75 | 3 | 0 | 3
Induktivität | 1 | 10 |  | 50 | 2 | 0 | 2
 |  |  |  |  | 0 | 0 | 0
 |  |  |  |  | 0 | 0 | 0
PS1-2 | 1 | 10.1 |  | 50.5 | 2.02 | 0 | 2.02
PS1-2 ASM | 1 |  |  |  | 0 | 0 | 0
PS1-2 BOM | 1 | 139.38 | 655.38 | 655.38 | 27.876 | 26.2152 | 26.2152
Header 2x12 | 1 | 1.03 |  | 5.15 | 0.206 | 0 | 0.206 | Source
Button red | 1 | 0 |  | 0 | 0 | 0 | 0 | AD BOM
Button black | 1 | 0 |  | 0 | 0 | 0 | 0 | Order
OLED | 1 | 0 |  | 0 | 0 | 0 | 0
PS1-101 | 2 | 5.8 |  | 29 | 1.16 | 0 | 1.16
PS1-102 | 3 | 6 |  | 30 | 1.2 | 0 | 1.2
PS1-124 | 1 | 6.5 |  | 32.5 | 1.3 | 0 | 1.3
 |  |  |  |  | 0 | 0 | 0
Schrauben und Kleinmaterial |  | 10 |  | 50 | 2 | 0 | 2

Sheet: Kostenabschätzung Prototyp 2
Kostenabschätzung Prototyp 2 |  |  |  |  | Prototypen | 230.9352 | 249.6409512 | Serie | 230.9352 | 249.6409512
 |  |  |  |  | 5 | 1154.676 | 1248.204756 | 15 | 3464.028 | 3744.614268
Komponente | Typ | Stückpreis | Währung | Anzahl pro Gerät | Anzahl | Gesamtkosten |  | Anzahl | Gesamtkosten
Hauptplatine | PS1-1BA | 22.002 | USD | 1 | 5 | 110.01 |  | 15 | 330.03
Hauptplatine Bestückung | PS1-1BA | 92.324 | USD | 1 | 5 | 461.62 |  | 15 | 1384.86
Batterie | IFR26700-45HE | 2.25 | EUR | 4 | 20 | 45 |  | 60 | 135
Thyristor | TYN30-600 | 1.04 | CHF | 1 | 5 | 5.2 |  | 15 | 15.6
Sicherung | 3061334 | 4.4 | CHF | 2 | 10 | 44 |  | 30 | 132
Sicherungshalter | 3576 | 4 | CHF | 1 | 5 | 20 |  | 15 | 60
GDT | B88069X2180S102 | 1.41 | CHF | 1 | 5 | 7.05 |  | 15 | 21.15
Buchse rot | 23.3060-22 | 3.902 | CHF | 2 | 10 | 39.02 |  | 30 | 117.06
Buchse schwarz | 23.3060-21 | 4.486 | CHF | 2 | 10 | 44.86 |  | 30 | 134.58
Buchsenleiste 12x2 | 803-87-024-10-001101 | 2.54 | CHF | 1 | 5 | 12.7 |  | 15 | 38.1
Relais | G6RL-14-ASI DC12 | 2.43 | CHF | 1 | 5 | 12.15 |  | 15 | 36.45
Transformer |  |  | CHF | 1 | 5 | 0 |  | 15 | 0
Temperatursensor | NRSE104F3380B1F | 0.27 | CHF | 1 | 5 | 1.35 |  | 15 | 4.05
Taster | B3F-1002 | 0.23 | CHF | 1 | 5 | 1.15 |  | 15 | 3.45
Instrumentenverstärker | MCP6N11-001 | 1.38 | CHF | 3 | 15 | 20.7 |  | 45 | 62.1
 |  |  |  |  | 0 | 0 |  | 0 | 0
UI Platine | PS1-2BA | 2.188 | USD | 1 | 5 | 10.94 |  | 15 | 32.82
UI Platine Bestückung | PS1-2BA | 18.802 | USD | 1 | 5 | 94.01 |  | 15 | 282.03
Stiftleiste 12x2 | PRPC012DAAN-RC | 0.52 | CHF | 1 | 5 | 2.6 |  | 15 | 7.8
Display | NHD-2.4-240320AF-CSXP-2MM Rev2B | 15 | USD | 1 | 5 | 75 |  | 15 | 225
Encoder | MERP11-15125BM7 | 1 | CHF | 1 | 5 | 5 |  | 15 | 15
Taster schwarz | 304-03-423 | 5.243 | CHF | 1 | 5 | 26.215 |  | 15 | 78.645
Taster rot | 303-95-366 | 5.805 | CHF | 1 | 5 | 29.025 |  | 15 | 87.075
 |  |  |  | 1 | 5 | 0 |  | 15 | 0
Trafoplatine | PS1-100AA | 0.44 | CHF | 1 | 5 | 2.2 |  | 15 | 6.6
Diode | US1NWF-7 | 0.253 | CHF | 3 | 15 | 3.795 |  | 45 | 11.385
Keramikkondensator | CHV1210N1K5333KXT | 0.346 | CHF | 3 | 15 | 5.19 |  | 45 | 15.57
Widerstand 10M/0603 HV | RV0603FR-0710ML | 0.1118 | CHF | 9 | 45 | 5.031 |  | 135 | 15.093
Wickelkörper | B65822F1008T002X | 1.17 | CHF | 1 | 5 | 5.85 |  | 15 | 17.55
Ferritkern (Set) | B65805C0100A033 | 2.74 | CHF | 1 | 5 | 13.7 |  | 15 | 41.1
Klammer für Kern | B65806J2204X000 | 0.131 | CHF | 2 | 10 | 1.31 |  | 30 | 3.93
Draht 0.5mm |  | 0 | CHF | 0.4 | 2 | 0 |  | 6 | 0
Draht 0.106mm Grad 2 |  | 0 | CHF | 6 | 30 | 0 |  | 90 | 0
Gehäuse |  | 5 | EUR | 1 | 5 | 25 |  | 15 | 75
Zubehör |  | 5 | EUR | 1 | 5 | 25 |  | 15 | 75
