daniw/bat_source/hw/Power consumption.xlsx

Sheet: Power consumption Overview
Supply | Voltage [V] | Average load [A] | Peak load [A] | Average current [A] | Peak current [A] | Type | Source | Input voltage [V] | Converter efficiency | Average input current [A] | Peak input current [A]
VBAT | 8 |  |  | 0.1373346769 | 0.1373344597 | Direct | Bat
VCC | 8 | 0 | 0 | 0.1373346769 | 0.1373344597 | Direct | VBAT | 8 |  | 0.1373346769 | 0.1373344597
+15V | 15 | 0 | 0 | 0.06592064489 | 0.06592054068 | Converter | VCC | 8 | 0.9 | 0.1373346769 | 0.1373344597
+3V3 | 3.3 | 0 | 0 | 0 | 0 | Converter | +15V | 15 | 0.9 | 0 | 0
+5V | 5 | 0 | 0 | 0.01752142857 | 0.01752142857 | Converter | +15V | 15 | 0.9 | 0.006489417989 | 0.006489417989
+3V3_A | 3.3 | 0.01752142857 | 0.01752142857 | 0.01752142857 | 0.01752142857 | Regulator | +5V | 5 |  | 0.01752142857 | 0.01752142857
+3V3_UI | 3.3 | 0 | 0 | 0 | 0 | Converter | +15V | 15 | 0.9 | 0 | 0
VLED | 4 | 0.20058 | 0.20058 | 0.20058 | 0.20058 | Converter | +15V | 15 | 0.9 | 0.05943111111 | 0.05943111111
+3V3_STBY | 3.3 | 1e-06 | 1e-07 | 1e-06 | 1e-07 | Converter | +15V | 15 | 1.9 | 1.157894737e-07 | 1.157894737e-08

Sheet: VCC
Schematic sheet | Component | Quantity | Voltage [V] | Resistance [Ω] | Average operating current [A] | Peak operating current [A] | Average current [A] | Peak current [A] | Average power [W] | Peak power [W] | Average current [mA] | Peak current [mA] | Average power [mW] | Peak power [mW]
Total |  |  | 8 |  |  |  | 0 | 0 | 0 | 0 | 0 | 0 | 0 | 0
 |  | 1 | 8 |  |  |  | 0 | 0 | 0 | 0 | 0 | 0 | 0 | 0

Sheet: +15V
Schematic sheet | Component | Quantity | Voltage [V] | Resistance [Ω] | Average operating current [A] | Peak operating current [A] | Average current [A] | Peak current [A] | Average power [W] | Peak power [W] | Average current [mA] | Peak current [mA] | Average power [mW] | Peak power [mW]
Total |  |  | 15 |  |  |  | 0 | 0 | 0 | 0 | 0 | 0 | 0 | 0
 |  | 1 | 15 |  |  |  | 0 | 0 | 0 | 0 | 0 | 0 | 0 | 0

Sheet: +3V3
Schematic sheet | Component | Quantity | Voltage [V] | Resistance [Ω] | Average operating current [A] | Peak operating current [A] | Average current [A] | Peak current [A] | Average power [W] | Peak power [W] | Average current [mA] | Peak current [mA] | Average power [mW] | Peak power [mW]
Total |  |  | 3.3 |  |  |  | 0 | 0 | 0 | 0 | 0 | 0 | 0 | 0
 |  | 1 | 3.3 |  |  |  | 0 | 0 | 0 | 0 | 0 | 0 | 0 | 0

Sheet: +5V
Schematic sheet | Component | Quantity | Voltage [V] | Resistance [Ω] | Average operating current [A] | Peak operating current [A] | Average current [A] | Peak current [A] | Average power [W] | Peak power [W] | Average current [mA] | Peak current [mA] | Average power [mW] | Peak power [mW]
Total |  |  | 5 |  |  |  | 0 | 0 | 0 | 0 | 0 | 0 | 0 | 0
 |  | 1 | 5 |  |  |  | 0 | 0 | 0 | 0 | 0 | 0 | 0 | 0

Sheet: +3V3_A
Schematic sheet | Component | Quantity | Voltage [V] | Resistance [Ω] | Average operating current [A] | Peak operating current [A] | Average current [A] | Peak current [A] | Average power [W] | Peak power [W] | Average current [mA] | Peak current [mA] | Average power [mW] | Peak power [mW]
Total |  |  | 3.3 |  |  |  | 0.01752142857 | 0.01752142857 | 0.05782071429 | 0.05782071429 | 17.52142857 | 17.52142857 | 57.82071429 | 57.82071429
Battery & BMS | Operational amplifier | 1 | 3.3 |  | 0.00025 | 0.00025 | 0.00025 | 0.00025 | 0.000825 | 0.000825 | 0.25 | 0.25 | 0.825 | 0.825
Converter | Temperature sensor | 3 | 3.3 | 10000 |  |  | 0.00099 | 0.00099 | 0.003267 | 0.003267 | 0.99 | 0.99 | 3.267 | 3.267
HV Converter | Temperature sensor | 0 | 3.3 | 10000 |  |  | 0 | 0 | 0 | 0 | 0 | 0 | 0 | 0
Protection | OVP amplifier | 1 | 3.3 |  | 0.00025 | 0.00025 | 0.00025 | 0.00025 | 0.000825 | 0.000825 | 0.25 | 0.25 | 0.825 | 0.825
Protection | OVP comparator | 1 | 3.3 |  | 0.0001 | 0.0001 | 0.0001 | 0.0001 | 0.00033 | 0.00033 | 0.1 | 0.1 | 0.33 | 0.33
Protection | OVP pullup | 1 | 3.3 | 200000 |  |  | 1.65e-05 | 1.65e-05 | 5.445e-05 | 5.445e-05 | 0.0165 | 0.0165 | 0.05445 | 0.05445
Protection | OVP reset | 1 | 3.3 | 10000 |  |  | 0.00033 | 0.00033 | 0.001089 | 0.001089 | 0.33 | 0.33 | 1.089 | 1.089
Protection | OVP reference | 1 | 3.3 | 16800 |  |  | 0.0001964285714 | 0.0001964285714 | 0.0006482142857 | 0.0006482142857 | 0.1964285714 | 0.1964285714 | 0.6482142857 | 0.6482142857
Protection | OVP output | 1 | 3.3 | 10000 |  |  | 0.00033 | 0.00033 | 0.001089 | 0.001089 | 0.33 | 0.33 | 1.089 | 1.089
Protection | OCP comparator | 2 | 3.3 |  | 0.0001 | 0.0001 | 0.0002 | 0.0002 | 0.00066 | 0.00066 | 0.2 | 0.2 | 0.66 | 0.66
Protection | OCP input reference | 1 | 3.3 | 200000 |  |  | 1.65e-05 | 1.65e-05 | 5.445e-05 | 5.445e-05 | 0.0165 | 0.0165 | 0.05445 | 0.05445
Protection | OCP comparator output | 1 | 3.3 | 10000 |  |  | 0.00033 | 0.00033 | 0.001089 | 0.001089 | 0.33 | 0.33 | 1.089 | 1.089
Protection | OCP timer reference | 1 | 3.3 | 200000 |  |  | 1.65e-05 | 1.65e-05 | 5.445e-05 | 5.445e-05 | 0.0165 | 0.0165 | 0.05445 | 0.05445
Protection | OCP timer output | 1 | 3.3 | 10000 |  |  | 0.00033 | 0.00033 | 0.001089 | 0.001089 | 0.33 | 0.33 | 1.089 | 1.089
Current Source | Temperature sensor | 1 | 3.3 | 10000 |  |  | 0.00033 | 0.00033 | 0.001089 | 0.001089 | 0.33 | 0.33 | 1.089 | 1.089
Output Terminal | Reference | 1 | 3.3 | 200000 |  |  | 1.65e-05 | 1.65e-05 | 5.445e-05 | 5.445e-05 | 0.0165 | 0.0165 | 0.05445 | 0.05445
Output Terminal | Comparator | 1 | 3.3 |  | 0.0001 | 0.0001 | 0.0001 | 0.0001 | 0.00033 | 0.00033 | 0.1 | 0.1 | 0.33 | 0.33
Output Terminal | Operational amplifier | 1 | 3.3 |  | 0.00025 | 0.00025 | 0.00025 | 0.00025 | 0.000825 | 0.000825 | 0.25 | 0.25 | 0.825 | 0.825
Output Terminal | HV detector output | 1 | 3.3 | 10000 |  |  | 0.00033 | 0.00033 | 0.001089 | 0.001089 | 0.33 | 0.33 | 1.089 | 1.089
Measurement | Instrumentation amplifier | 3 | 3.3 |  | 0.0011 | 0.0011 | 0.0033 | 0.0033 | 0.01089 | 0.01089 | 3.3 | 3.3 | 10.89 | 10.89
Measurement | Operational amplifier | 2 | 3.3 |  | 0.00025 | 0.00025 | 0.0005 | 0.0005 | 0.00165 | 0.00165 | 0.5 | 0.5 | 1.65 | 1.65
Measurement | INA feedback | 3 | 3.3 | 100000 |  |  | 9.9e-05 | 9.9e-05 | 0.0003267 | 0.0003267 | 0.099 | 0.099 | 0.3267 | 0.3267
Measurement | ADC | 1 | 3.3 |  | 0.004 | 0.004 | 0.004 | 0.004 | 0.0132 | 0.0132 | 4 | 4 | 13.2 | 13.2
Microcontroller | Operational amplifier | 1 | 3.3 |  | 0.00025 | 0.00025 | 0.00025 | 0.00025 | 0.000825 | 0.000825 | 0.25 | 0.25 | 0.825 | 0.825
Microcontroller | Microcontroller (ADC) | 5 | 3.3 |  | 0.00073 | 0.00073 | 0.00365 | 0.00365 | 0.012045 | 0.012045 | 3.65 | 3.65 | 12.045 | 12.045
Microcontroller | Microcontroller (DAC) | 2 | 3.3 |  | 0.00067 | 0.00067 | 0.00134 | 0.00134 | 0.004422 | 0.004422 | 1.34 | 1.34 | 4.422 | 4.422

Sheet: +3V3_UI
Schematic sheet | Component | Quantity | Voltage [V] | Resistance [Ω] | Average operating current [A] | Peak operating current [A] | Average current [A] | Peak current [A] | Average power [W] | Peak power [W] | Average current [mA] | Peak current [mA] | Average power [mW] | Peak power [mW]
Total |  |  | 3.3 |  |  |  | 0 | 0 | 0 | 0 | 0 | 0 | 0 | 0
 |  | 1 | 3.3 |  |  |  | 0 | 0 | 0 | 0 | 0 | 0 | 0 | 0

Sheet: VLED
Schematic sheet | Component | Quantity | Voltage [V] | Resistance [Ω] | Average operating current [A] | Peak operating current [A] | Average current [A] | Peak current [A] | Average power [W] | Peak power [W] | Average current [mA] | Peak current [mA] | Average power [mW] | Peak power [mW]
Total |  |  | 4 |  |  |  | 0.20058 | 0.20058 | 0.80232 | 0.80232 | 200.58 | 200.58 | 802.32 | 802.32
UI - LED | LED driver | 1 | 4 |  | 0.00029 | 0.00029 | 0.00029 | 0.00029 | 0.00116 | 0.00116 | 0.29 | 0.29 | 1.16 | 1.16
UI - LED | LEDs | 2 | 4 |  | 0.02 | 0.02 | 0.04 | 0.04 | 0.16 | 0.16 | 40 | 40 | 160 | 160
UI - Display | Backlight | 4 | 4 |  | 0.04 | 0.04 | 0.16 | 0.16 | 0.64 | 0.64 | 160 | 160 | 640 | 640
UI - LED | Backlight driver | 1 | 4 |  | 0.00029 | 0.00029 | 0.00029 | 0.00029 | 0.00116 | 0.00116 | 0.29 | 0.29 | 1.16 | 1.16

Sheet: +3V3_STBY
Schematic sheet | Component | Quantity | Voltage [V] | Resistance [Ω] | Average operating current [A] | Peak operating current [A] | Average current [A] | Peak current [A] | Average power [W] | Peak power [W] | Average current [mA] | Peak current [mA] | Average power [mW] | Peak power [mW]
Total |  |  | 3.3 |  |  |  | 1e-06 | 1e-07 | 3.3e-06 | 3.3e-07 | 0.001 | 0.0001 | 0.0033 | 0.00033
Microcontroller | RTC | 1 | 3.3 |  | 1e-06 | 1e-07 | 1e-06 | 1e-07 | 3.3e-06 | 3.3e-07 | 0.001 | 0.0001 | 0.0033 | 0.00033
