daniw/bat_source/mech_Samuel_v2/04_Fuse/sicherung_konstruiert/f1ps1-1b-basis_1_asm.stp

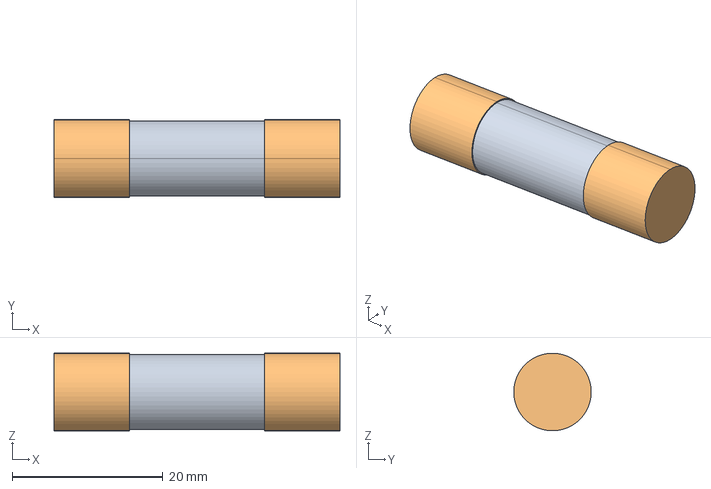
[picture p4: CAD file, 2026-04-14]
mech_Samuel_v2/04_Fuse/sicherung_konstruiert/f1ps1-1b-basis_1_asm.stp
38.0 x 10.3 x 10.3 mm
