daniw/bat_source/mech_Samuel_v2/04_Fuse/sicherung_konstruiert/sicherung_asm.stp

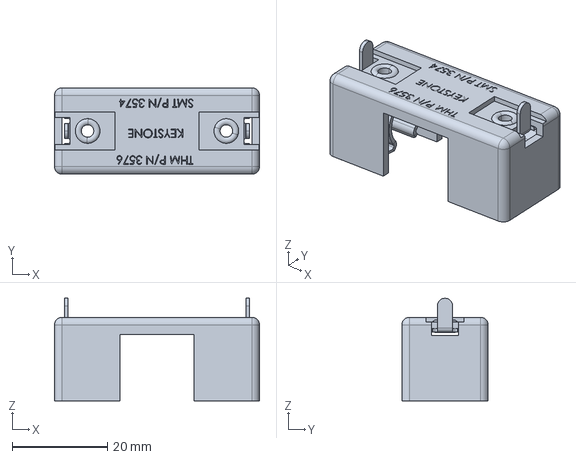
[picture p5: CAD file, 2026-04-14]
mech_Samuel_v2/04_Fuse/sicherung_konstruiert/sicherung_asm.stp
43.1 x 18.1 x 21.5 mm
