daniw/bat_source/mech_Samuel_v2/80_step_m3f_files/00_01_mechanical_assembly_red_asm.stp

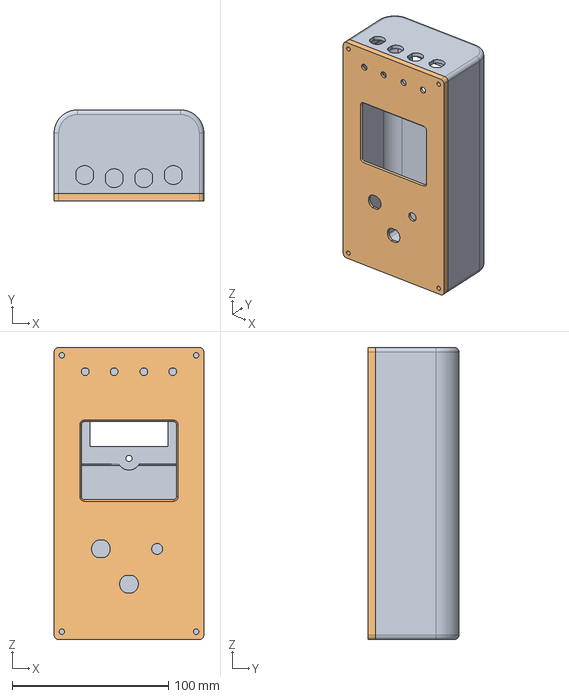
[picture p7: CAD file, 2026-05-19]
mech_Samuel_v2/80_step_m3f_files/00_01_mechanical_assembly_red_asm.stp
96.0 x 58.5 x 187.0 mm
01_01_HOUSING
02_01_LID
