daniw/bat_source/mech_Samuel_v2/80_step_m3f_files/bat1ps1-1b-basis_1__druck_asm.stp

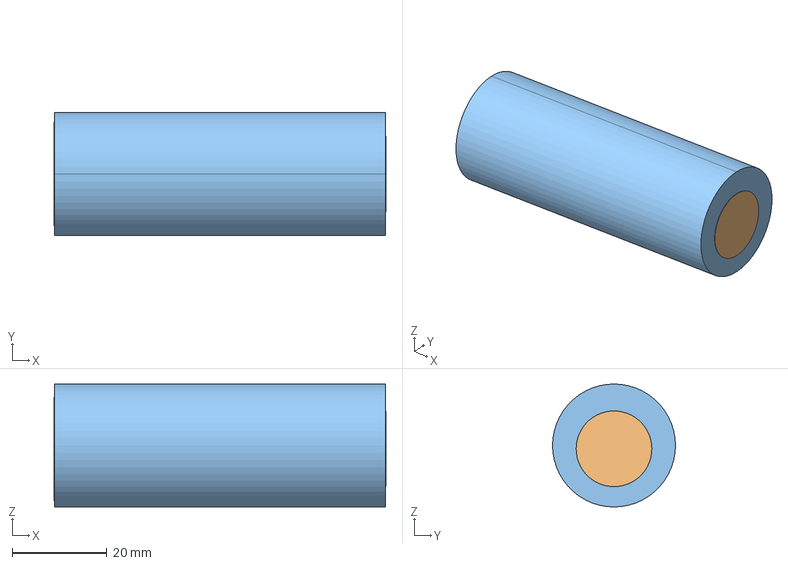
[picture p8: CAD file, 2026-04-04]
mech_Samuel_v2/80_step_m3f_files/bat1ps1-1b-basis_1__druck_asm.stp
70.2 x 26.0 x 26.0 mm
