daniw/bat_source/mech/Spulenhalter_Klein.FCStd

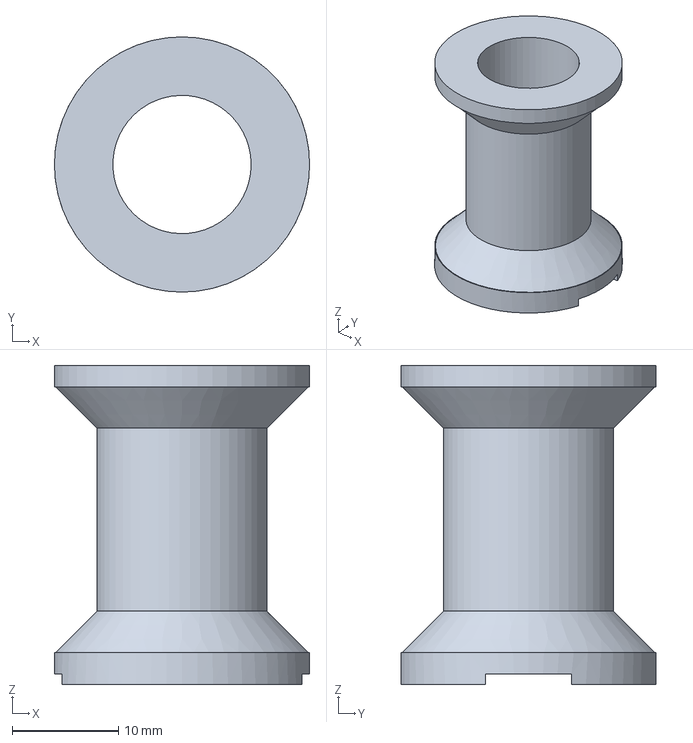
[picture p9: CAD file, 2026-03-30]
mech/Spulenhalter_Klein.FCStd
24.0 x 24.0 x 30.0 mm
