daniw/bat_source/mech_Samuel_v2/01_Hauptplatine/PS1-1BA_3D_STEP_2026-03-09/open_cascade_step_translato-134.stp

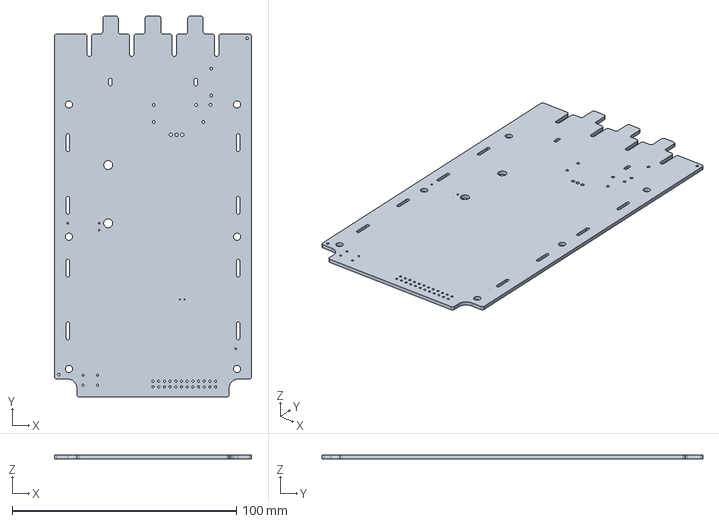
[picture p10: CAD file, 2026-03-23]
mech_Samuel_v2/01_Hauptplatine/PS1-1BA_3D_STEP_2026-03-09/open_cascade_step_translato-134.stp
88.0 x 170.0 x 1.57 mm
