daniw/bat_source/mech_Samuel_v2/02_UserInterface/PS1-2BA-3D_STEP_2026-03-09/open_cascade_step_translato-170.stp

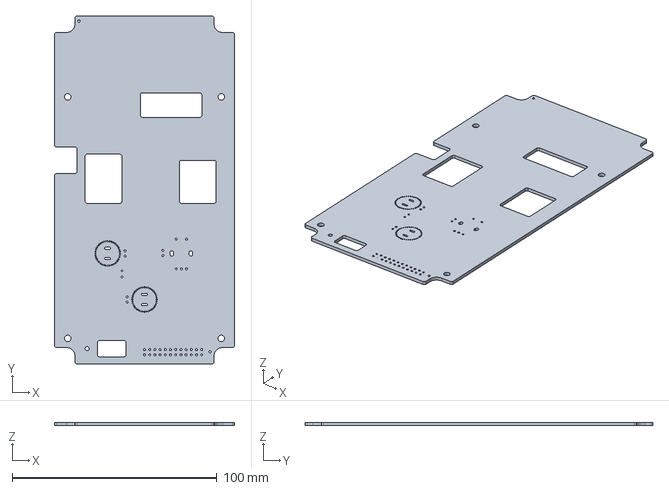
[picture p11: CAD file, 2026-03-23]
mech_Samuel_v2/02_UserInterface/PS1-2BA-3D_STEP_2026-03-09/open_cascade_step_translato-170.stp
88.0 x 170.0 x 1.60 mm
