daniw/bat_source/mech_Samuel_v2/03_Staeubli/Spannring__SSP4__10036508_stp/Spannring_SSP4.stp

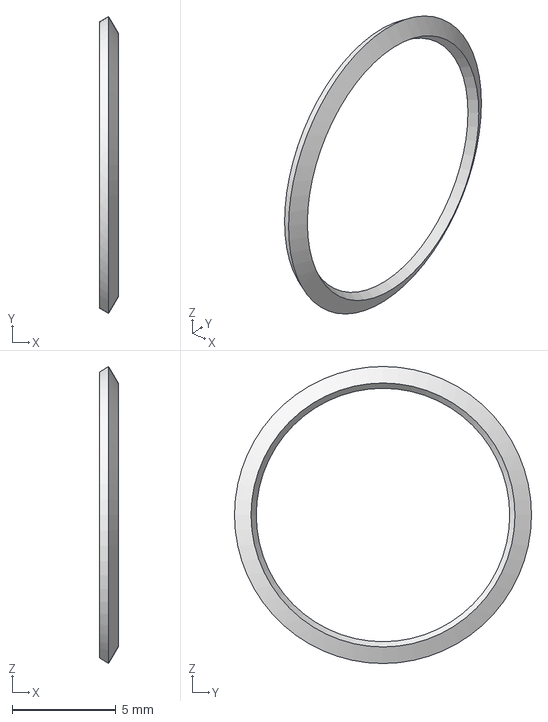
[picture p12: CAD file, 2026-02-25]
mech_Samuel_v2/03_Staeubli/Spannring__SSP4__10036508_stp/Spannring_SSP4.stp
0.9 x 14.3 x 14.3 mm
