daniw/bat_source/mech_Samuel_v2/80_step_m3f_files/__ABS_Teile.3mf

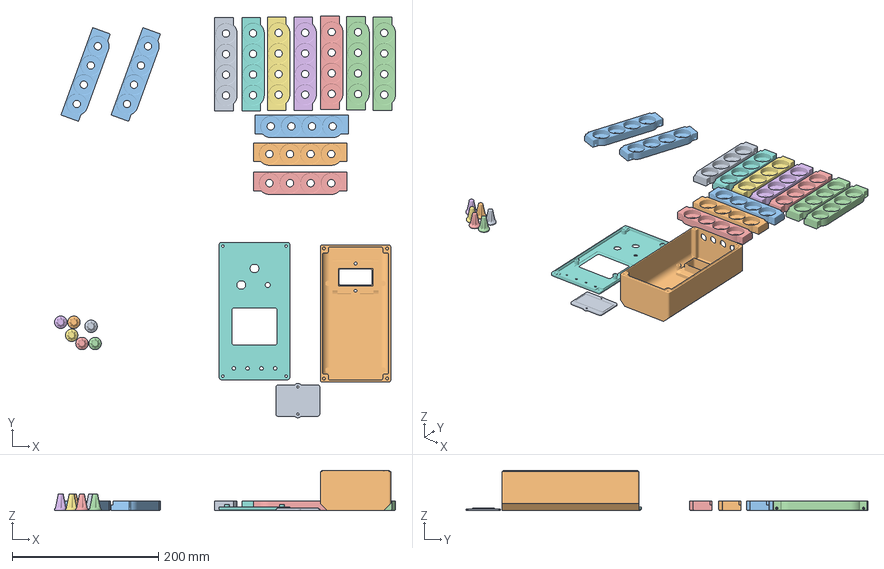
[picture p13: CAD file, 2026-07-22]
mech_Samuel_v2/80_step_m3f_files/__ABS_Teile.3mf
465.8 x 548.6 x 55.2 mm
90_knob_koerper.stp x 6
05_cell_holder_minusplus_3p2mm.stp x 2
02_01_lid.stp
01_06_fuse_lid.stp
01_01_housing.stp
05_CELL_HOLDER_MINUSPLUS x 2
05_CELL_HOLDER_MINUSPLUS 1
05_CELL_HOLDER_MINUSPLUS 2
05_CELL_HOLDER_MINUSPLUS 3
05_CELL_HOLDER_MINUSPLUS 4 x 5
