daniw/bat_source/mech/Holder.3mf

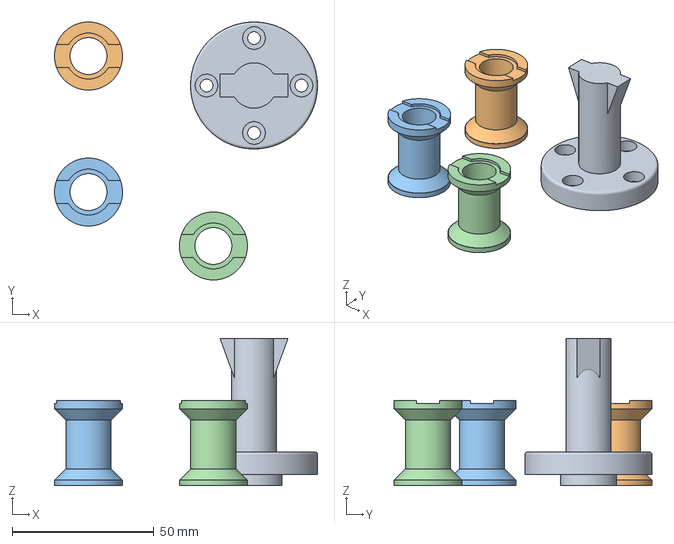
[picture p14: CAD file, 2026-03-30]
mech/Holder.3mf
92.8 x 91.0 x 51.9 mm
Holder
Spool x 3
