daniw/bat_source/mech_Samuel_v2/01_Hauptplatine/PS1-1BA_3D_STEP_2026-03-09/slb4-f6_3_red_1.stp

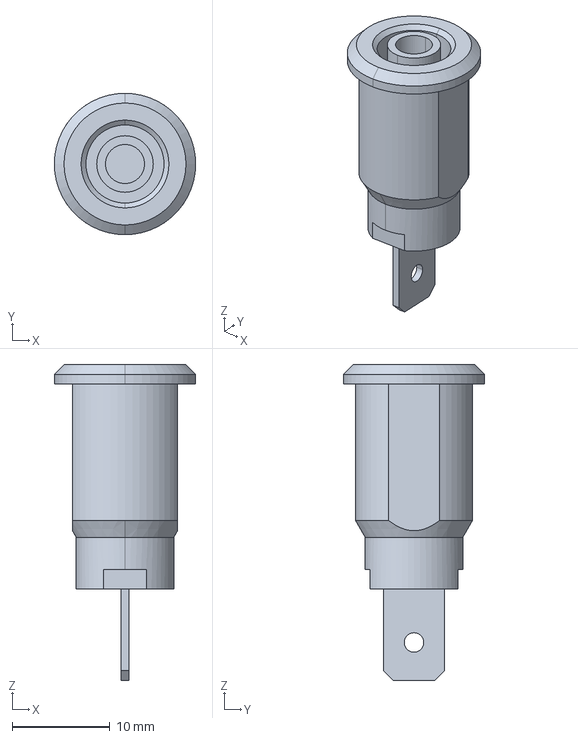
[picture p15: CAD file, 2026-03-23]
mech_Samuel_v2/01_Hauptplatine/PS1-1BA_3D_STEP_2026-03-09/slb4-f6_3_red_1.stp
14.5 x 14.5 x 32.4 mm
