daniw/bat_source/mech_Samuel_v2/03_Staeubli/Rundmutter_M12x0p75.stp

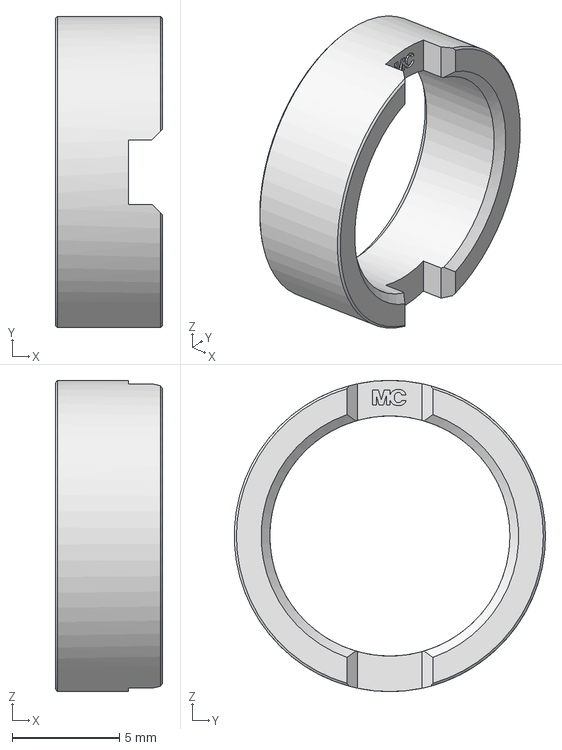
[picture p16: CAD file, 2026-02-25]
mech_Samuel_v2/03_Staeubli/Rundmutter_M12x0p75.stp
5.00 x 14.5 x 14.5 mm
