daniw/bat_source/mech_Samuel_v2/04_Fuse/step_files_fuse/sicherung_halterung.3mf

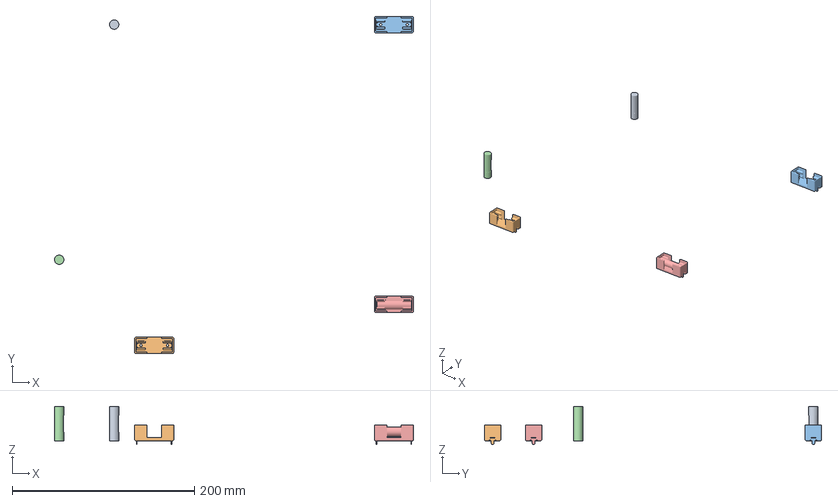
[picture p17: CAD file, 2026-04-14]
mech_Samuel_v2/04_Fuse/step_files_fuse/sicherung_halterung.3mf
394.3 x 370.4 x 42.0 mm
f1ps1-1b-basis_1_asm.stp x 2
f2ps1-1b-basis_1_asm.stp x 2
sicherung_asm.stp
