daniw/bat_source/mech_Samuel_v2/80_step_m3f_files/01_01_housing.stp

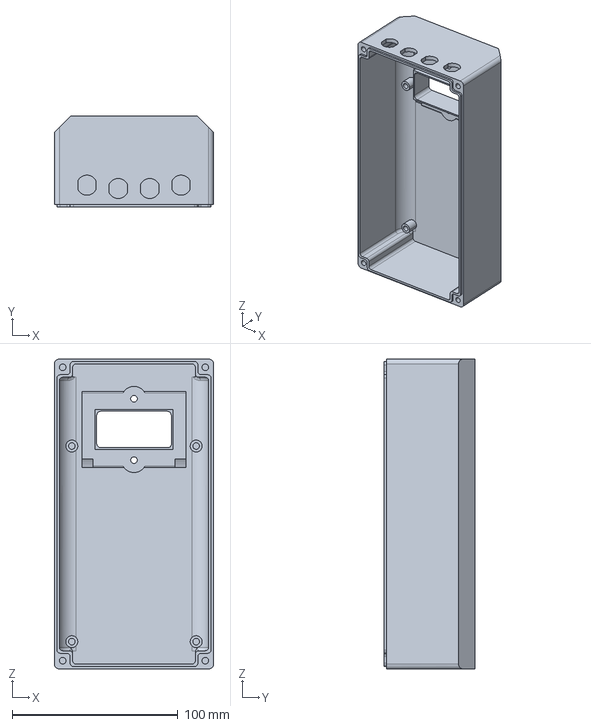
[picture p18: CAD file, 2026-07-22]
mech_Samuel_v2/80_step_m3f_files/01_01_housing.stp
96.0 x 55.0 x 187.0 mm
