daniw/bat_source/mech/Coilformer_Holder.FCStd

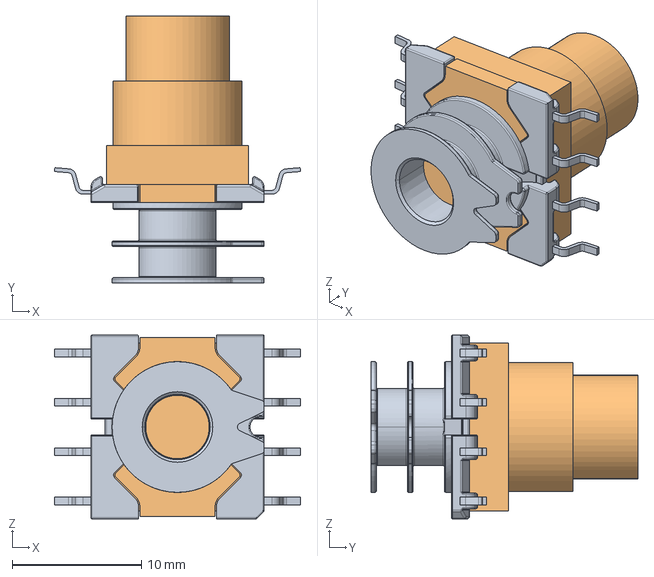
[picture p19: CAD file, 2026-03-30]
mech/Coilformer_Holder.FCStd
19.0 x 20.6 x 14.2 mm
C61035-A0031-B201_RM5_SW0001
Körper
