daniw/bat_source/mech_Samuel_v2/04_Fuse/sicherung_konstruiert/sicherung_halter.stp

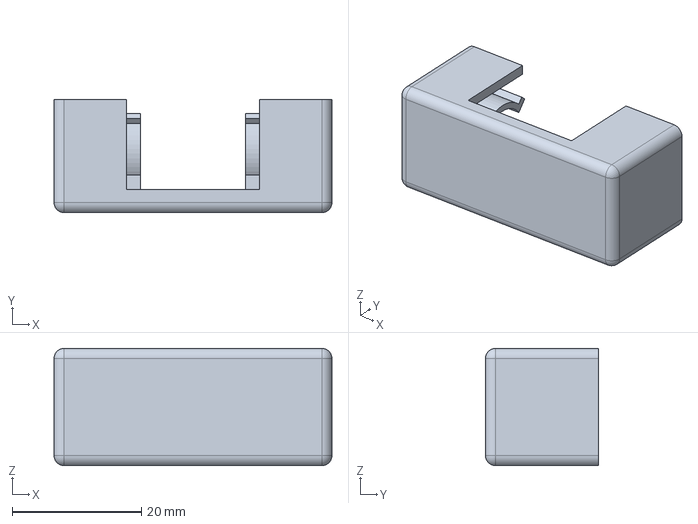
[picture p20: CAD file, 2026-04-14]
mech_Samuel_v2/04_Fuse/sicherung_konstruiert/sicherung_halter.stp
43.1 x 17.5 x 18.1 mm
