daniw/bat_source/mech_Samuel_v2/80_step_m3f_files/01_06_fuse_lid.stp

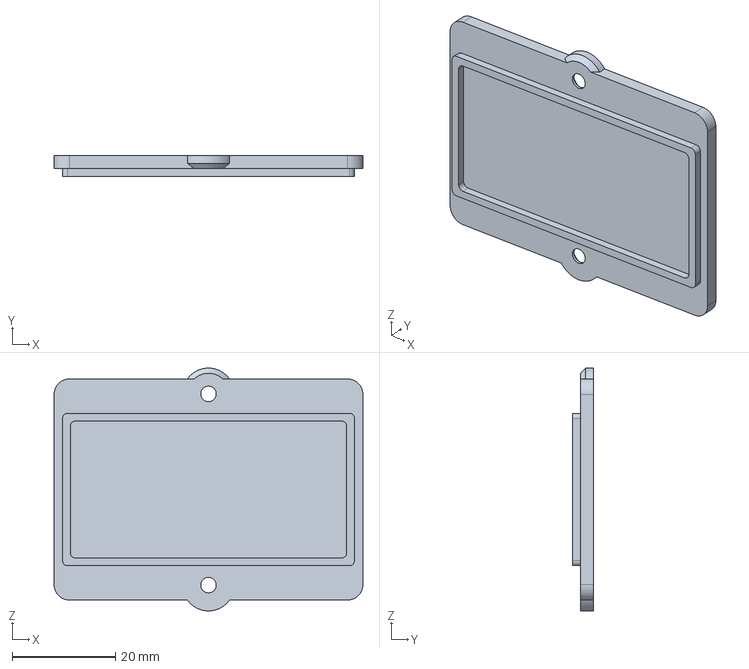
[picture p21: CAD file, 2026-07-17]
mech_Samuel_v2/80_step_m3f_files/01_06_fuse_lid.stp
59.8 x 4.00 x 47.0 mm
