daniw/bat_source/mech_Samuel_v2/80_step_m3f_files/02_01_lid.stp

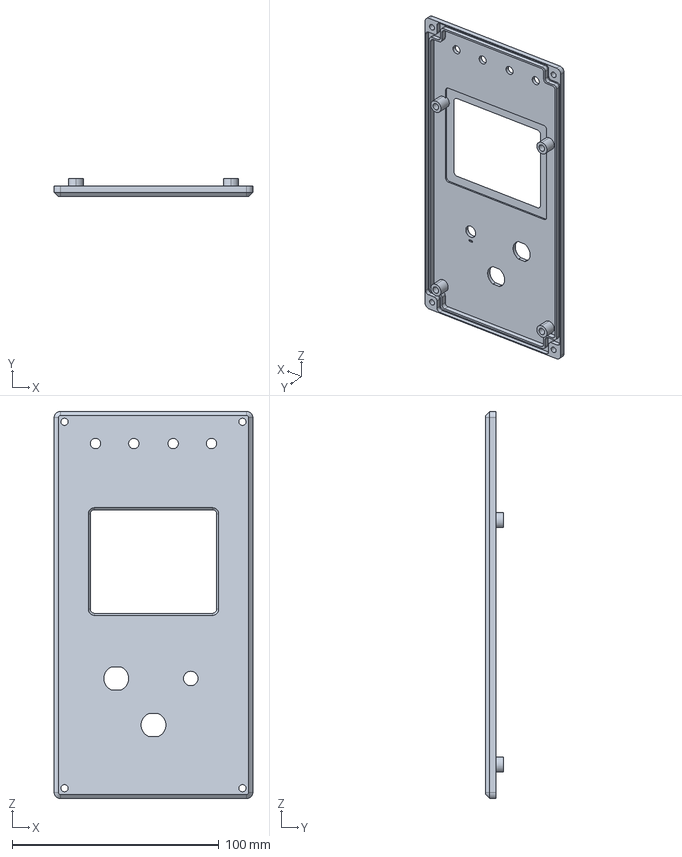
[picture p22: CAD file, 2026-07-17]
mech_Samuel_v2/80_step_m3f_files/02_01_lid.stp
96.0 x 8.60 x 187.0 mm
