daniw/bat_source/mech_Samuel_v2/80_step_m3f_files/02_11_display_window.stp

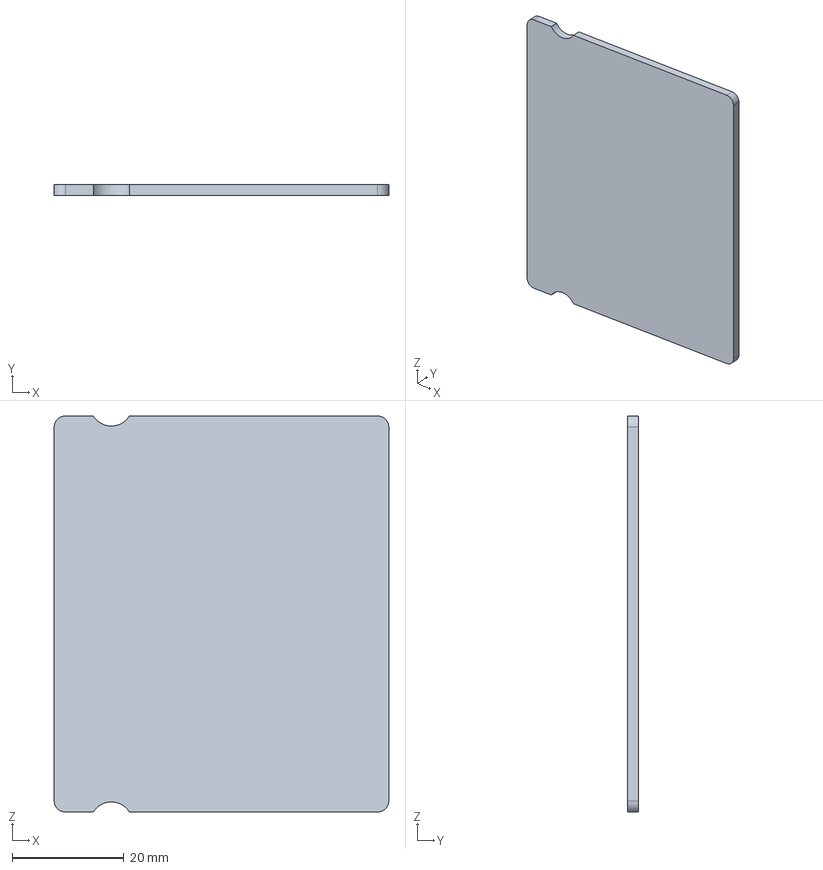
[picture p23: CAD file, 2026-07-11]
mech_Samuel_v2/80_step_m3f_files/02_11_display_window.stp
60.0 x 2.00 x 71.0 mm
