daniw/bat_source/mech/Lid_CSACTT004.FCStd

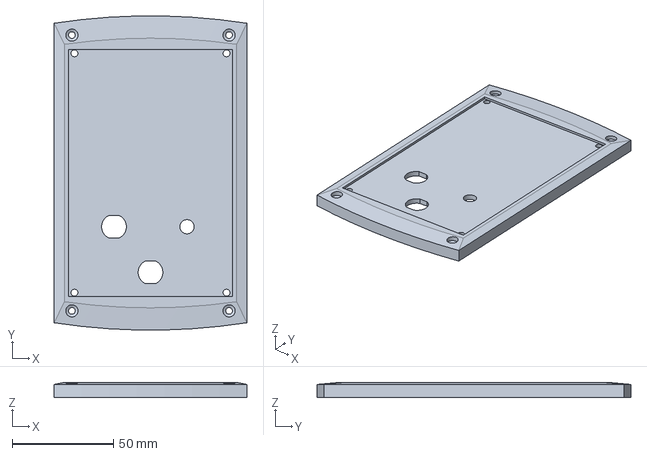
[picture p24: CAD file, 2025-10-22]
mech/Lid_CSACTT004.FCStd
95.0 x 154.9 x 7.50 mm
