daniw/bat_source/mech_Samuel_v2/80_step_m3f_files/05_cell_holder_minusplus_3p2mm.stp

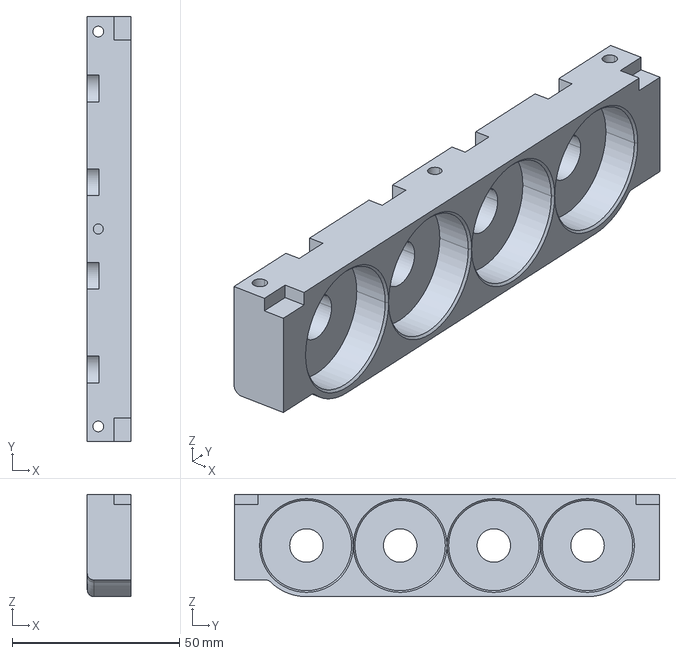
[picture p25: CAD file, 2026-07-07]
mech_Samuel_v2/80_step_m3f_files/05_cell_holder_minusplus_3p2mm.stp
13.0 x 127.0 x 30.6 mm
