daniw/bat_source/mech/CBOX11004.FCStd

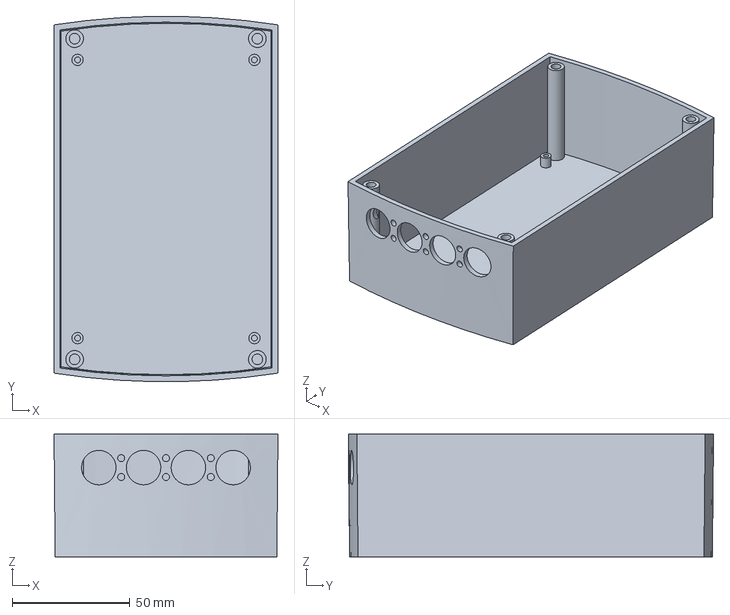
[picture p26: CAD file, 2025-10-22]
mech/CBOX11004.FCStd
95.0 x 154.9 x 52.0 mm
