daniw/bat_source/mech/Knob.FCStd

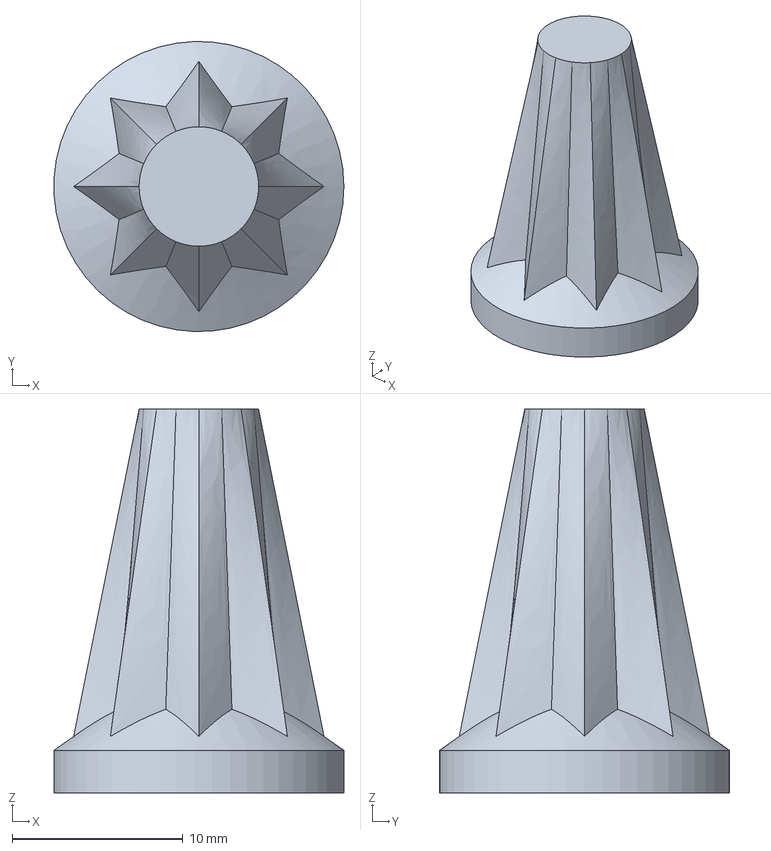
[picture p27: CAD file, 2025-09-19]
mech/Knob.FCStd
17.0 x 17.0 x 22.5 mm
