daniw/bat_source/mech_Samuel_v2/80_step_m3f_files/01_05_staeubli_plug_seal.stp

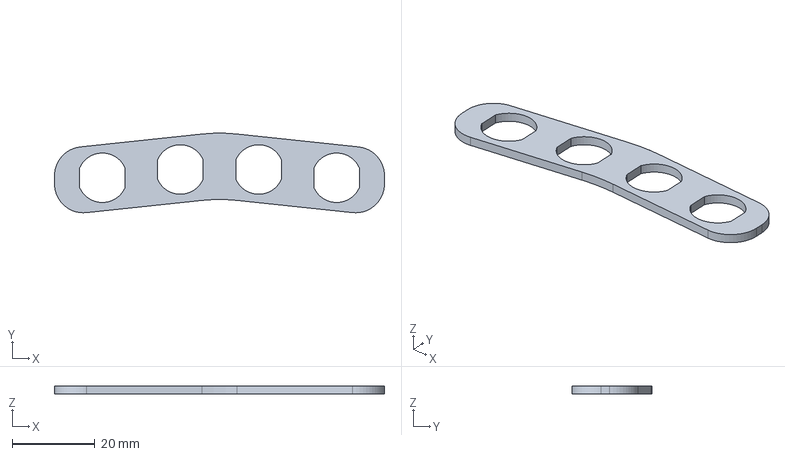
[picture p28: CAD file, 2026-05-19]
mech_Samuel_v2/80_step_m3f_files/01_05_staeubli_plug_seal.stp
80.0 x 19.3 x 2.00 mm
