daniw/bat_source/mech/Holder_Banana_Plugs_Drill.stp

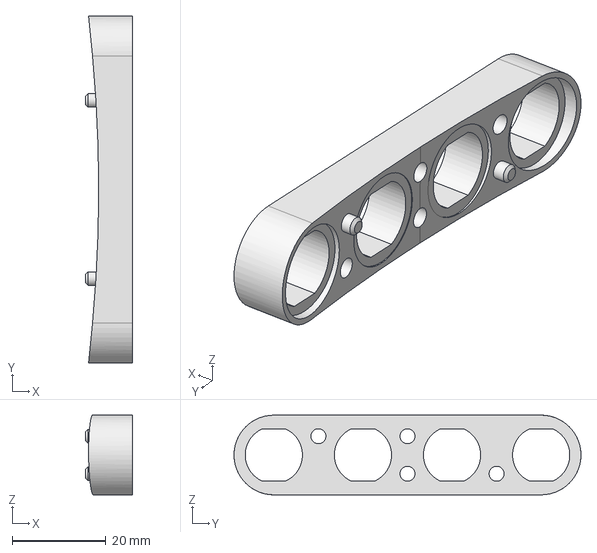
[picture p29: CAD file, 2025-09-19]
mech/Holder_Banana_Plugs_Drill.stp
10.0 x 74.0 x 17.0 mm
