daniw/bat_source/mech_Samuel_v2/80_step_m3f_files/__TPU_Teile.3mf

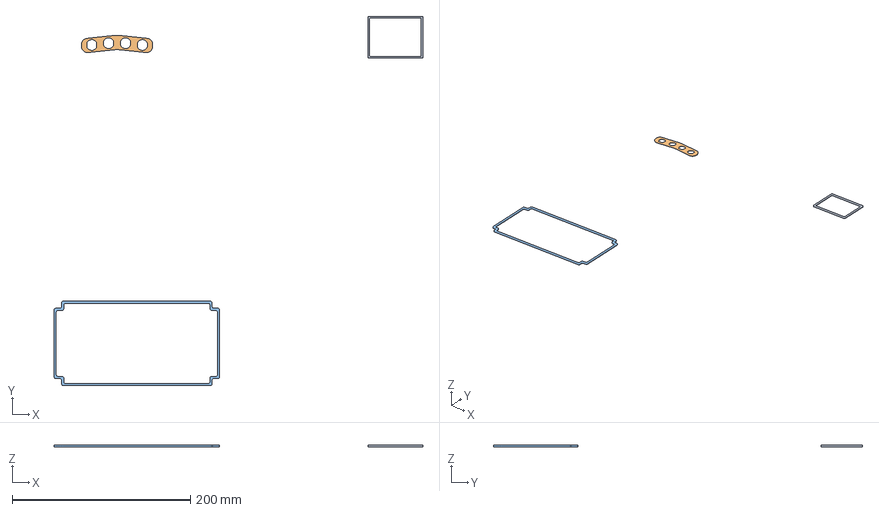
[picture p30: CAD file, 2026-05-19]
mech_Samuel_v2/80_step_m3f_files/__TPU_Teile.3mf
414.2 x 414.7 x 2.00 mm
01_04_fuse_seal_b.stp
01_05_staeubli_plug_seal.stp
02_03_seal.stp
