daniw/bat_source/mech/Transformer_Spacer_0.5mm.FCStd

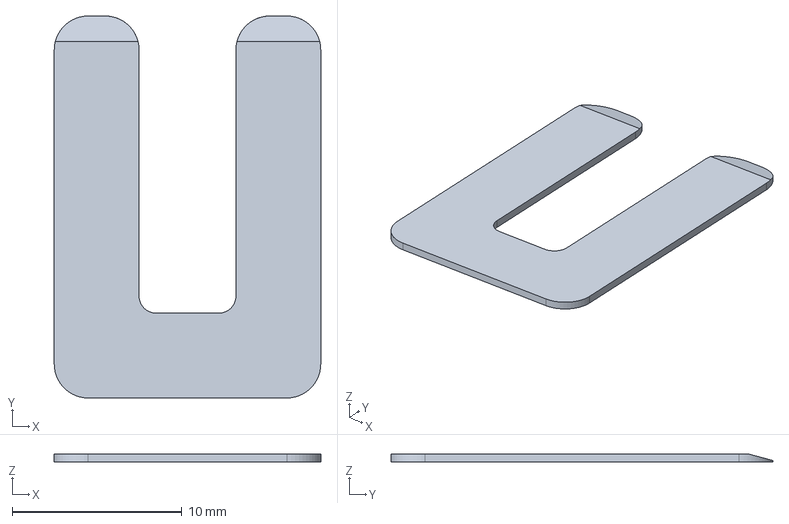
[picture p31: CAD file, 2025-09-12]
mech/Transformer_Spacer_0.5mm.FCStd
15.7 x 22.5 x 0.5 mm
