daniw/bat_source/mech_Samuel_v2/80_step_m3f_files/02_09_lichtleiter.stp

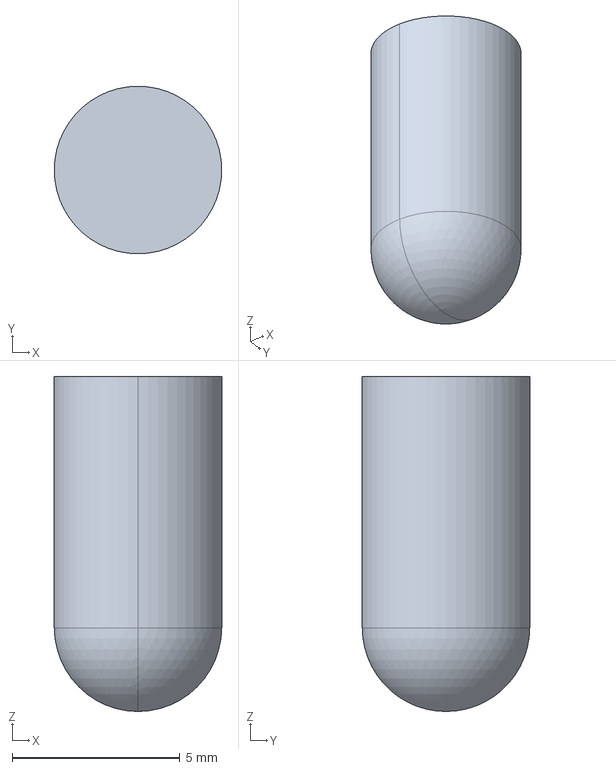
[picture p32: CAD file, 2026-05-19]
mech_Samuel_v2/80_step_m3f_files/02_09_lichtleiter.stp
5.00 x 5.00 x 10.0 mm
