daniw/bat_source/mech/Battery_Holder.FCStd

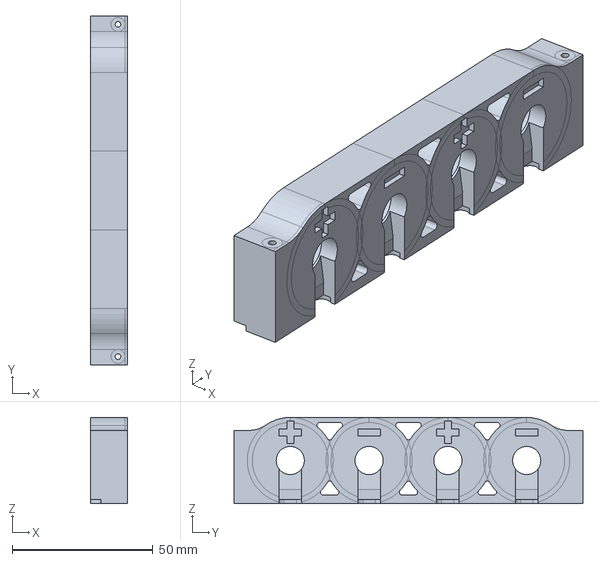
[picture p33: CAD file, 2025-08-14]
mech/Battery_Holder.FCStd
13.0 x 124.0 x 30.6 mm
