daniw/bat_source/mech_Samuel_v2/80_step_m3f_files/02_03_seal.stp

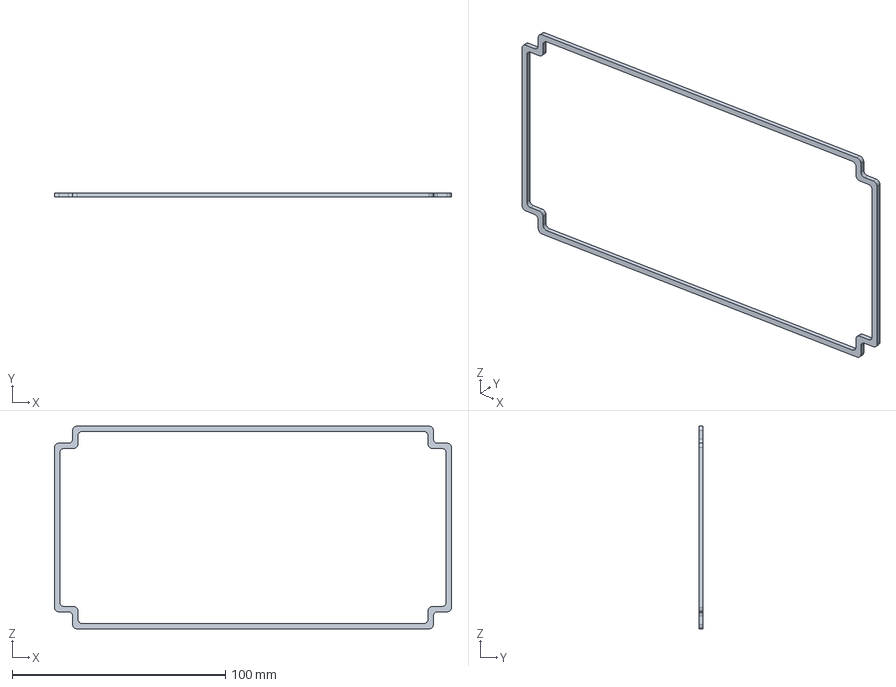
[picture p34: CAD file, 2026-05-19]
mech_Samuel_v2/80_step_m3f_files/02_03_seal.stp
186.0 x 2.00 x 95.0 mm
