daniw/bat_source/mech_Samuel_v2/80_step_m3f_files/01_04_fuse_seal_b.stp

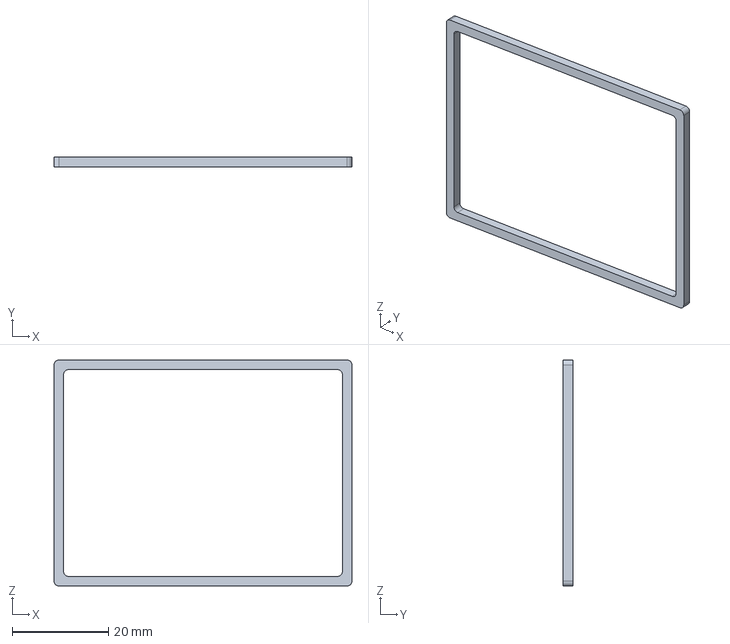
[picture p35: CAD file, 2026-05-19]
mech_Samuel_v2/80_step_m3f_files/01_04_fuse_seal_b.stp
62.0 x 2.00 x 47.0 mm
