daniw/bat_source/mech_Samuel_v2/80_step_m3f_files/seals.3mf

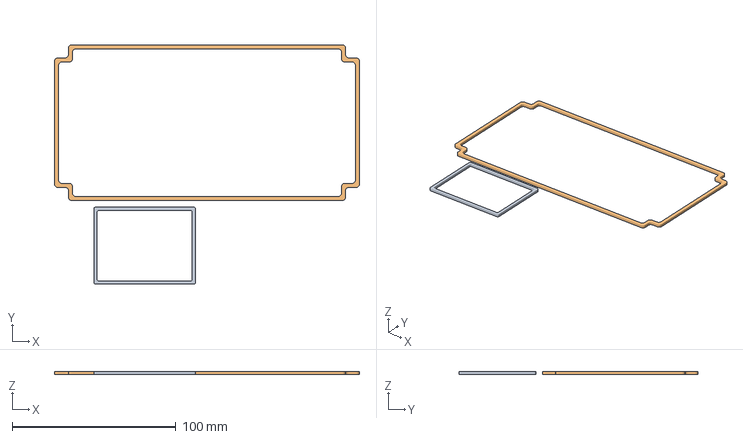
[picture p36: CAD file, 2026-05-19]
mech_Samuel_v2/80_step_m3f_files/seals.3mf
186.0 x 146.0 x 2.00 mm
01_04_fuse_seal_b.stp
02_03_seal.stp
