daniw/bat_source/mech_Samuel_v2/80_step_m3f_files/rundmutter_m12x0p75_print.stp

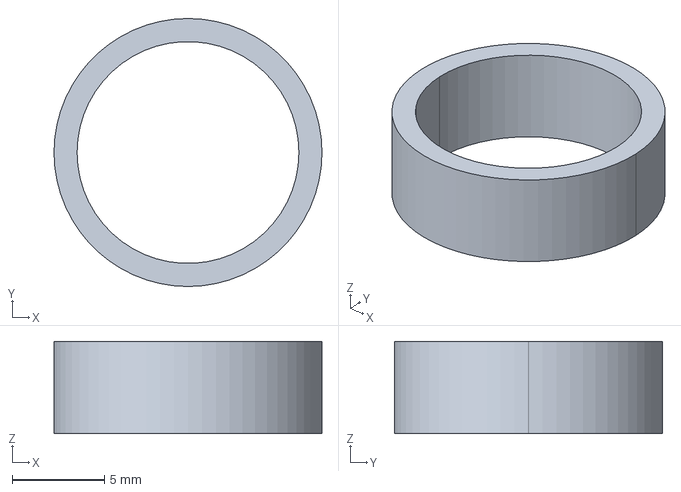
[picture p37: CAD file, 2026-05-19]
mech_Samuel_v2/80_step_m3f_files/rundmutter_m12x0p75_print.stp
14.5 x 14.5 x 5.00 mm
