daniw/bat_source/mech_Samuel_v2/80_step_m3f_files/senkschraube_m3x10.stp

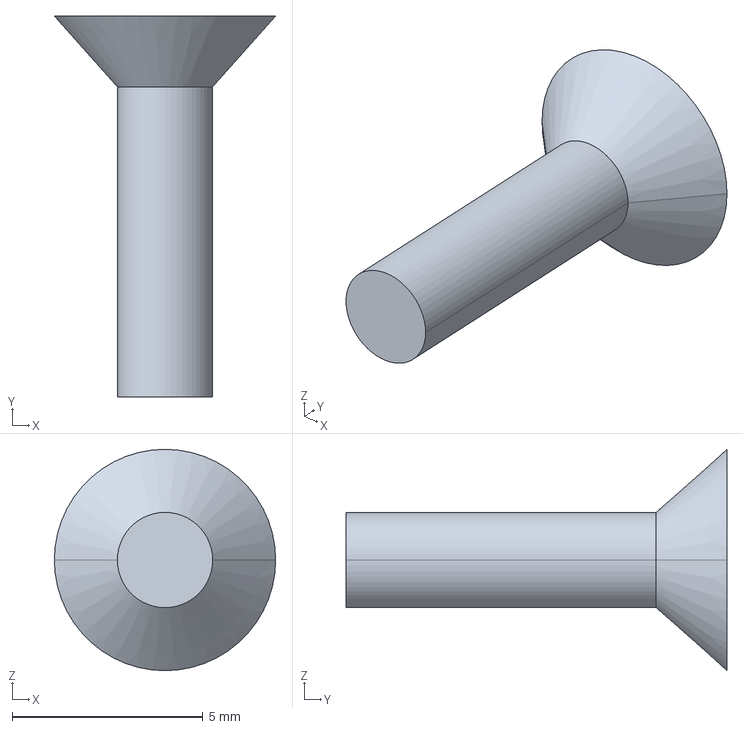
[picture p38: CAD file, 2026-04-14]
mech_Samuel_v2/80_step_m3f_files/senkschraube_m3x10.stp
5.81 x 10.0 x 5.81 mm
