daniw/bat_source/mech_Samuel_v2/80_step_m3f_files/schrauben.3mf

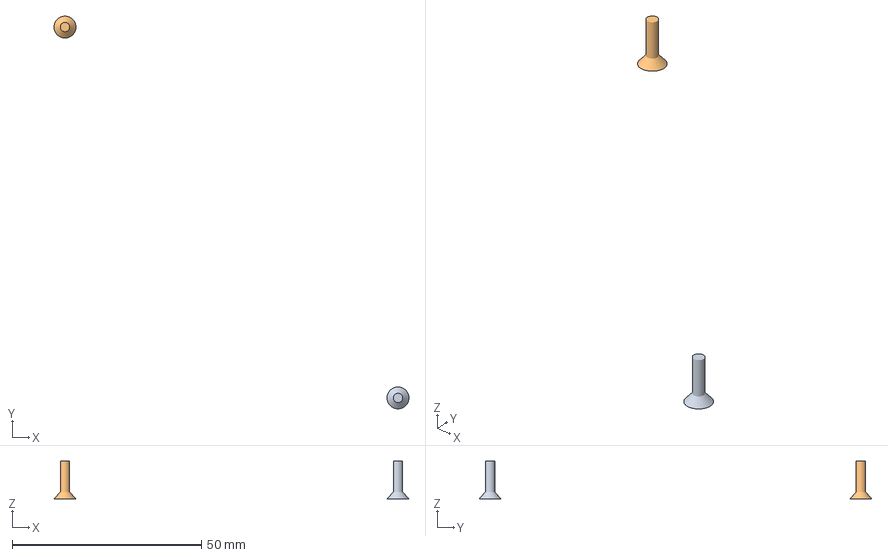
[picture p39: CAD file, 2026-04-14]
mech_Samuel_v2/80_step_m3f_files/schrauben.3mf
93.8 x 103.8 x 10.0 mm
senkschraube_m3x10.stp x 2
