daniw/bat_source/mech_Samuel_v2/80_step_m3f_files/01_07_m3_einschmelzmutter.stp

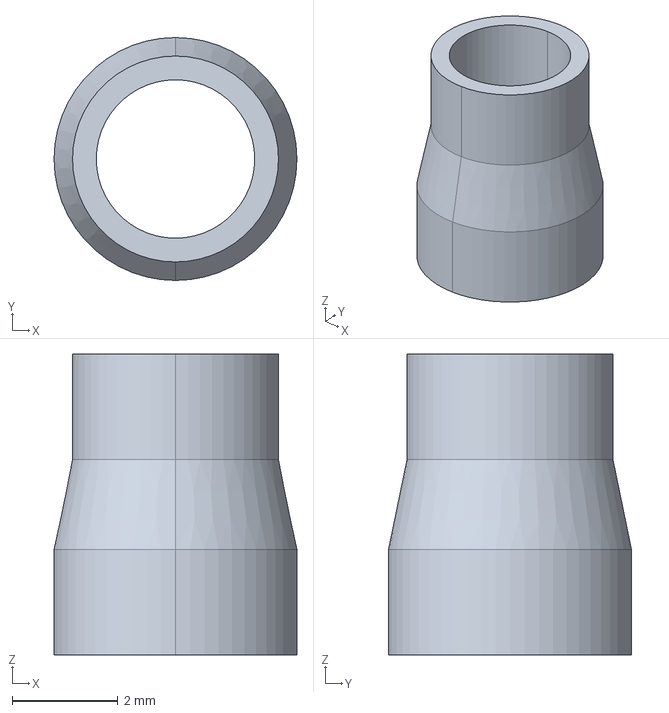
[picture p40: CAD file, 2026-04-06]
mech_Samuel_v2/80_step_m3f_files/01_07_m3_einschmelzmutter.stp
4.60 x 4.60 x 5.70 mm
