daniw/bat_source/mech_Samuel_v2/80_step_m3f_files/01_07_m4_einschmelzmutter.stp

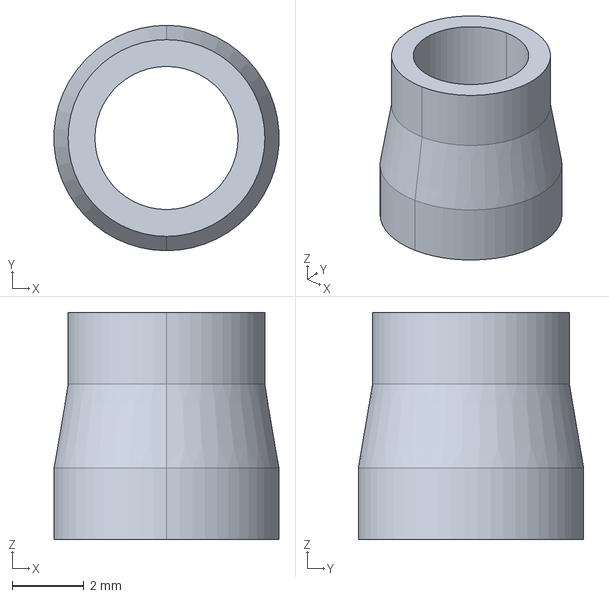
[picture p41: CAD file, 2026-04-06]
mech_Samuel_v2/80_step_m3f_files/01_07_m4_einschmelzmutter.stp
6.29 x 6.30 x 6.35 mm
