daniw/bat_source/mech_Samuel_v2/80_step_m3f_files/04_seal_fuse_b.stp

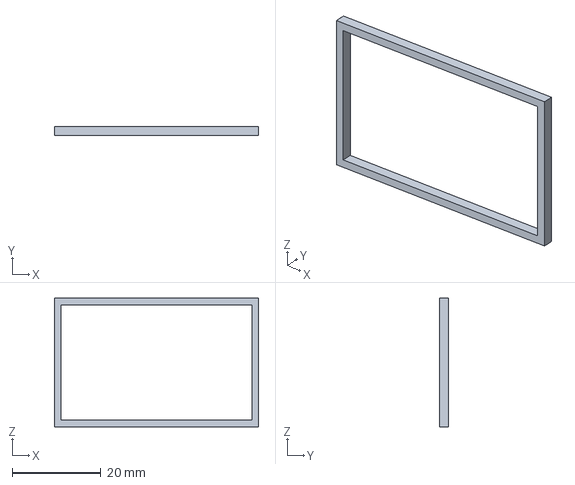
[picture p42: CAD file, 2026-02-21]
mech_Samuel_v2/80_step_m3f_files/04_seal_fuse_b.stp
46.0 x 2.00 x 29.0 mm
