daniw/bat_source/(list of files, cad)

Other CAD files:
mech_Samuel_v2/04_Fuse/step_files_fuse/f2ps1-1b-basis_1_asm.stp
mech_Samuel_v2/01_Hauptplatine/PS1-1BA_3D_STEP_2026-02-16/keystone-pn3576.stp
mech_Samuel_v2/01_Hauptplatine/PS1-1BA_3D_STEP_2026-03-09/slb4-f6_3_black.stp
mech/Terminal_Front_View.FCStd
mech/00_bat_source.FCStd
mech_Samuel_v2/80_step_m3f_files/05_cell_holder_minusplus.stp
mech/Holder_Banana_Plugs.stp
mech_Samuel_v2/80_step_m3f_files/90_knob_koerper.stp
mech_Samuel_v2/80_step_m3f_files/03_seal.stp
mech/Battery_Holder.3mf
mech/Coilformer_Holder.3mf
mech/Holder_Banana_Plugs.FCStd
mech/Knob.3mf
mech_Samuel_v2/01_01_housing.prt
mech_Samuel_v2/01_04_fuse_seal_b.prt
mech_Samuel_v2/01_06_fuse_lid.prt
mech_Samuel_v2/01_Hauptplatine/PS1-1BA_3D_STEP_2026-02-16/11231157520-93574.prt
mech_Samuel_v2/01_Hauptplatine/PS1-1BA_3D_STEP_2026-02-16/11231157520-93593.prt
mech_Samuel_v2/01_Hauptplatine/PS1-1BA_3D_STEP_2026-02-16/12079984080-22881.prt
mech_Samuel_v2/01_Hauptplatine/PS1-1BA_3D_STEP_2026-02-16/12079984080-22900.prt
mech_Samuel_v2/01_Hauptplatine/PS1-1BA_3D_STEP_2026-02-16/c61035-a0031-b201_rm5-2sec_sw_r.prt
mech_Samuel_v2/01_Hauptplatine/PS1-1BA_3D_STEP_2026-02-16/c61035-a0031-c008_rm5_rgb671088.prt
mech_Samuel_v2/01_Hauptplatine/PS1-1BA_3D_STEP_2026-02-16/cap-1210_x7r_1.prt
mech_Samuel_v2/01_Hauptplatine/PS1-1BA_3D_STEP_2026-02-16/cap-1210_x7r_2.prt
mech_Samuel_v2/01_Hauptplatine/PS1-1BA_3D_STEP_2026-02-16/cap-1210_x7r_3.prt
mech_Samuel_v2/01_Hauptplatine/PS1-1BA_3D_STEP_2026-02-16/cylinder-20879.prt
mech_Samuel_v2/01_Hauptplatine/PS1-1BA_3D_STEP_2026-02-16/cylinder-20974.prt
mech_Samuel_v2/01_Hauptplatine/PS1-1BA_3D_STEP_2026-02-16/cylinder-21069.prt
mech_Samuel_v2/01_Hauptplatine/PS1-1BA_3D_STEP_2026-02-16/cylinder-21164.prt
mech_Samuel_v2/01_Hauptplatine/PS1-1BA_3D_STEP_2026-02-16/cylinder-21259.prt
mech_Samuel_v2/01_Hauptplatine/PS1-1BA_3D_STEP_2026-02-16/cylinder-21408.prt
mech_Samuel_v2/01_Hauptplatine/PS1-1BA_3D_STEP_2026-02-16/cylinder-28982.prt
mech_Samuel_v2/01_Hauptplatine/PS1-1BA_3D_STEP_2026-02-16/cylinder-29077.prt
mech_Samuel_v2/01_Hauptplatine/PS1-1BA_3D_STEP_2026-02-16/cylinder-29280.prt
mech_Samuel_v2/01_Hauptplatine/PS1-1BA_3D_STEP_2026-02-16/cylinder-29375.prt
mech_Samuel_v2/01_Hauptplatine/PS1-1BA_3D_STEP_2026-02-16/cylinder-6000.prt
mech_Samuel_v2/01_Hauptplatine/PS1-1BA_3D_STEP_2026-02-16/cylinder-6095.prt
mech_Samuel_v2/01_Hauptplatine/PS1-1BA_3D_STEP_2026-02-16/cylinder-98819.prt
mech_Samuel_v2/01_Hauptplatine/PS1-1BA_3D_STEP_2026-02-16/cylinder-98914.prt
mech_Samuel_v2/01_Hauptplatine/PS1-1BA_3D_STEP_2026-02-16/cylinder-99009.prt
mech_Samuel_v2/01_Hauptplatine/PS1-1BA_3D_STEP_2026-02-16/cylinder-99153.prt
mech_Samuel_v2/01_Hauptplatine/PS1-1BA_3D_STEP_2026-02-16/cylinder-99248.prt
mech_Samuel_v2/01_Hauptplatine/PS1-1BA_3D_STEP_2026-02-16/cylinder-99343.prt
mech_Samuel_v2/01_Hauptplatine/PS1-1BA_3D_STEP_2026-02-16/extruded-10633.prt
mech_Samuel_v2/01_Hauptplatine/PS1-1BA_3D_STEP_2026-02-16/extruded-12409.prt
mech_Samuel_v2/01_Hauptplatine/PS1-1BA_3D_STEP_2026-02-16/extruded-13591.prt
mech_Samuel_v2/01_Hauptplatine/PS1-1BA_3D_STEP_2026-02-16/extruded-14773.prt
mech_Samuel_v2/01_Hauptplatine/PS1-1BA_3D_STEP_2026-02-16/extruded-17407.prt
mech_Samuel_v2/01_Hauptplatine/PS1-1BA_3D_STEP_2026-02-16/extruded-17604.prt
mech_Samuel_v2/01_Hauptplatine/PS1-1BA_3D_STEP_2026-02-16/extruded-17801.prt
mech_Samuel_v2/01_Hauptplatine/PS1-1BA_3D_STEP_2026-02-16/extruded-17993.prt
mech_Samuel_v2/01_Hauptplatine/PS1-1BA_3D_STEP_2026-02-16/extruded-18185.prt
mech_Samuel_v2/01_Hauptplatine/PS1-1BA_3D_STEP_2026-02-16/extruded-18377.prt
mech_Samuel_v2/01_Hauptplatine/PS1-1BA_3D_STEP_2026-02-16/extruded-18569.prt
mech_Samuel_v2/01_Hauptplatine/PS1-1BA_3D_STEP_2026-02-16/extruded-18761.prt
mech_Samuel_v2/01_Hauptplatine/PS1-1BA_3D_STEP_2026-02-16/extruded-21580.prt
mech_Samuel_v2/01_Hauptplatine/PS1-1BA_3D_STEP_2026-02-16/extruded-22239.prt
mech_Samuel_v2/01_Hauptplatine/PS1-1BA_3D_STEP_2026-02-16/extruded-24674.prt
mech_Samuel_v2/01_Hauptplatine/PS1-1BA_3D_STEP_2026-02-16/extruded-25526.prt
mech_Samuel_v2/01_Hauptplatine/PS1-1BA_3D_STEP_2026-02-16/extruded-29686.prt
mech_Samuel_v2/01_Hauptplatine/PS1-1BA_3D_STEP_2026-02-16/extruded-29878.prt
mech_Samuel_v2/01_Hauptplatine/PS1-1BA_3D_STEP_2026-02-16/extruded-6286.prt
mech_Samuel_v2/01_Hauptplatine/PS1-1BA_3D_STEP_2026-02-16/extruded-6478.prt
mech_Samuel_v2/01_Hauptplatine/PS1-1BA_3D_STEP_2026-02-16/extruded-6740.prt
mech_Samuel_v2/01_Hauptplatine/PS1-1BA_3D_STEP_2026-02-16/extruded-6932.prt
mech_Samuel_v2/01_Hauptplatine/PS1-1BA_3D_STEP_2026-02-16/extruded-70434.prt
mech_Samuel_v2/01_Hauptplatine/PS1-1BA_3D_STEP_2026-02-16/extruded-70631.prt
mech_Samuel_v2/01_Hauptplatine/PS1-1BA_3D_STEP_2026-02-16/extruded-70828.prt
mech_Samuel_v2/01_Hauptplatine/PS1-1BA_3D_STEP_2026-02-16/extruded-71020.prt
mech_Samuel_v2/01_Hauptplatine/PS1-1BA_3D_STEP_2026-02-16/extruded-7207.prt
mech_Samuel_v2/01_Hauptplatine/PS1-1BA_3D_STEP_2026-02-16/extruded-93267.prt
mech_Samuel_v2/01_Hauptplatine/PS1-1BA_3D_STEP_2026-02-16/extruded-95103.prt
mech_Samuel_v2/01_Hauptplatine/PS1-1BA_3D_STEP_2026-02-16/extruded-95295.prt
mech_Samuel_v2/01_Hauptplatine/PS1-1BA_3D_STEP_2026-02-16/extruded-95663.prt
mech_Samuel_v2/01_Hauptplatine/PS1-1BA_3D_STEP_2026-02-16/extruded-97241.prt
mech_Samuel_v2/01_Hauptplatine/PS1-1BA_3D_STEP_2026-02-16/keystone-pn3576.prt
mech_Samuel_v2/01_Hauptplatine/PS1-1BA_3D_STEP_2026-02-16/open_cascade_step_transla-61385.prt
mech_Samuel_v2/01_Hauptplatine/PS1-1BA_3D_STEP_2026-02-16/open_cascade_step_translato-122.prt
mech_Samuel_v2/01_Hauptplatine/PS1-1BA_3D_STEP_2026-02-16/res-0603_1.prt
mech_Samuel_v2/01_Hauptplatine/PS1-1BA_3D_STEP_2026-02-16/res-0603_2.prt
mech_Samuel_v2/01_Hauptplatine/PS1-1BA_3D_STEP_2026-02-16/slb4-f6_3_black.prt
mech_Samuel_v2/01_Hauptplatine/PS1-1BA_3D_STEP_2026-02-16/slb4-f6_3_red.prt
mech_Samuel_v2/01_Hauptplatine/PS1-1BA_3D_STEP_2026-02-16/sod3718x125_-_sod-123.prt
mech_Samuel_v2/01_Hauptplatine/PS1-1BA_3D_STEP_2026-02-16/sphere-21354.prt
mech_Samuel_v2/01_Hauptplatine/PS1-1BA_3D_STEP_2026-02-16/sphere-26774.prt
mech_Samuel_v2/01_Hauptplatine/PS1-1BA_3D_STEP_2026-02-16/sphere-29172.prt
mech_Samuel_v2/01_Hauptplatine/PS1-1BA_3D_STEP_2026-02-16/sphere-29226.prt
mech_Samuel_v2/01_Hauptplatine/PS1-1BA_3D_STEP_2026-02-16/to254p1530x1035-3.prt
mech_Samuel_v2/01_Hauptplatine/PS1-1BA_3D_STEP_2026-02-20/11300850208-105584.prt
mech_Samuel_v2/01_Hauptplatine/PS1-1BA_3D_STEP_2026-02-20/11300850208-105603.prt
mech_Samuel_v2/01_Hauptplatine/PS1-1BA_3D_STEP_2026-02-20/11434073136-38098.prt
mech_Samuel_v2/01_Hauptplatine/PS1-1BA_3D_STEP_2026-02-20/11434073136-38117.prt
mech_Samuel_v2/01_Hauptplatine/PS1-1BA_3D_STEP_2026-02-20/11434079376-36157.prt
mech_Samuel_v2/01_Hauptplatine/PS1-1BA_3D_STEP_2026-02-20/11434079376-36176.prt
mech_Samuel_v2/01_Hauptplatine/PS1-1BA_3D_STEP_2026-02-20/11434362080-24756.prt
mech_Samuel_v2/01_Hauptplatine/PS1-1BA_3D_STEP_2026-02-20/11434362080-24775.prt
mech_Samuel_v2/01_Hauptplatine/PS1-1BA_3D_STEP_2026-02-20/11434710048-39840.prt
mech_Samuel_v2/01_Hauptplatine/PS1-1BA_3D_STEP_2026-02-20/11434710048-39859.prt
mech_Samuel_v2/01_Hauptplatine/PS1-1BA_3D_STEP_2026-02-20/c61035-a0031-b201_rm5-2sec_sw_r.prt
mech_Samuel_v2/01_Hauptplatine/PS1-1BA_3D_STEP_2026-02-20/c61035-a0031-c008_rm5_rgb671088.prt
mech_Samuel_v2/01_Hauptplatine/PS1-1BA_3D_STEP_2026-02-20/cap-1210_x7r_1.prt
mech_Samuel_v2/01_Hauptplatine/PS1-1BA_3D_STEP_2026-02-20/cap-1210_x7r_2.prt
mech_Samuel_v2/01_Hauptplatine/PS1-1BA_3D_STEP_2026-02-20/cap-1210_x7r_3.prt
mech_Samuel_v2/01_Hauptplatine/PS1-1BA_3D_STEP_2026-02-20/cylinder-110632.prt
mech_Samuel_v2/01_Hauptplatine/PS1-1BA_3D_STEP_2026-02-20/cylinder-110727.prt
mech_Samuel_v2/01_Hauptplatine/PS1-1BA_3D_STEP_2026-02-20/cylinder-110822.prt
mech_Samuel_v2/01_Hauptplatine/PS1-1BA_3D_STEP_2026-02-20/cylinder-110966.prt
mech_Samuel_v2/01_Hauptplatine/PS1-1BA_3D_STEP_2026-02-20/cylinder-111061.prt
mech_Samuel_v2/01_Hauptplatine/PS1-1BA_3D_STEP_2026-02-20/cylinder-111156.prt
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
