daniw/bat_source/doc/test/src/assembly.tex

\begin{formtable}
 \formTitle{Assembly}
 \formHeaderS
 \formCheck{Perform optical check}
 \formWork{PS1-1A: Solder \qty{100}{\kilo\ohm} resistor between gate and source of Q13}
 \formWork{PS1-1A: Replace R188 and R189 with \qty{0}{\ohm} resistors}
 \formWork{PS1-1A: Connect pin 5 of U16 with R16 (side closer to U16) using a wire}
 \formWork{PS1-1A: Modify D11 and D14 according to modification in documentation}
 \formWork{Assemble instrumentation amplifiers U11, U13, U14 and U15}
 \formWork{Assemble reset switch SW1}
 \formWork{Assemble UI connector}
 \formWork{Assemble \qty{680}{\micro\farad} \qty{6.3}{\volt} capacitors C37, C38, C39 and C40}
 \formWork{Assemble thyristor D19, bend legs before soldering}
 \formWork{Assemble \qty{15}{\micro\farad} \qty{100}{\volt} capacitors C28 and C29}
 \formWork{Assemble relais K1, K2 and K3, extend and bend legs for index A}
 \formWork{Assemble Fuse holder F2, install fuse F1}
 \formWork{Place isolator between all of the winding PCBs below}
 \formWork{Stack 3 single winding PCBs PS1-102 on the main PCB}
 \formWork{Stack 2 dual winding PCBs PS1-101 on the stack}
 \formWork{Stack a winding PCB with 24 windings PS1-124 on the stack}
 \formWork{Place two ferrite cores with a \qty{0.3}{\milli\meter} gap filler around the stack}
 \formWork{Fix the ferrite cores with two clips}
 \formWork{Solder winding PCBs to the main PCB}
 \formCheck{Perform optical check}
\end{formtable}
