daniw/bat_source/mech_Samuel_v2/04_Fuse/step_files_fuse/read me.txt

f1ps1-1b-basis_1_asm.stp		Sicherung
f2ps1-1b-basis_1_asm.stp		Halterung
sicherung_asm.stp				Zusammenbau von Sicherung und Halterung

HTMP/N 3576
KEYSTONE
SMTP/N 3574

4.01320
