daniw/bat_source/mech_Samuel_v2/80_step_m3f_files/02_11_display_window.pdf

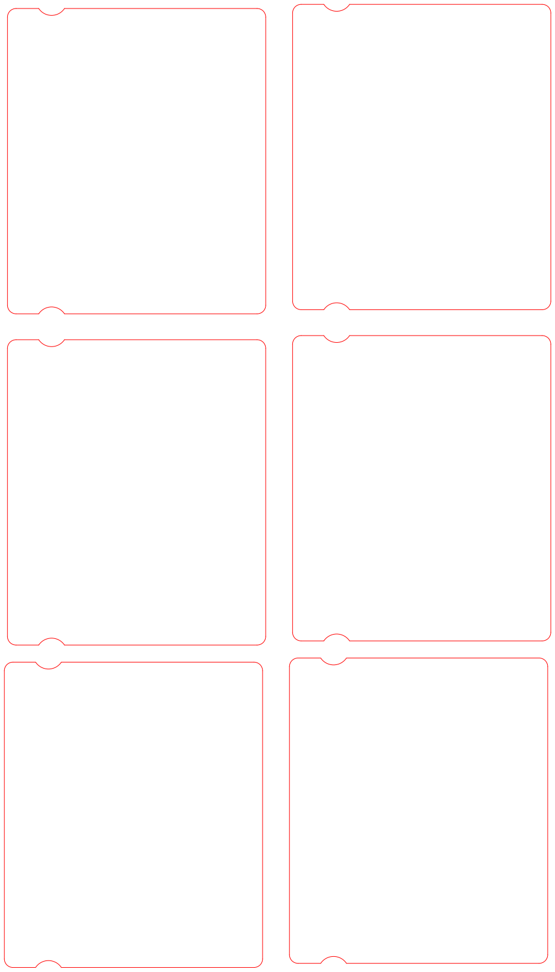
[picture p43: figure]
