daniw/bat_source/doc/test/Protocol_PS1-1.tex

\documentclass[12pt, landscape, margin = 2cm, tmargin = 3cm, a4paper]{letter}

\usepackage{../layout/layout}

\begin{document}

\input{src/content}

\end{document}
