daniw/bat_source/hw/test/BMS Accuracy.xlsx

Cell | BMS | DMM
1 | 3315 | 3.32
2 | 3318 | 3.319
3 | 3321 | 3.322
4 | 3320 | 3.32
