daniw/bat_source/hw/test/ADC_duration.xlsx

PS1-1 ADC performance analysis - test duration estimation
 | V | I | Total
min | 0 | 0
max | 60 | 10
step | 1 | 0.5
count | 100 | 100 | 200
Time per measurement [s] | 1.5 | 1.5 | 3
Measurements | 6100 | 2100 | 8200
Time [s] | 9150 | 3150 | 12300
Time [h] | 2.541666667 | 0.875 | 3.416666667
