daniw/bat_source/hw/test/PS1-1_ADC/PS1-1A ADC Test 2025-10-30 23.39.19_amp.csv

Time | Current Setpoint | Current DMM | Current DUT raw | Current DUT | Unit DUT
2025-10-30 23:41:25 | 0 | 1e-06 | 21681 | 39 | mA
2025-10-30 23:41:28 | 0 | 1e-06 | 27865 | 50 | mA
2025-10-30 23:41:30 | 0 | 0.0 | 19984 | 36 | mA
2025-10-30 23:41:32 | 0 | 0.0 | 11781 | 21 | mA
2025-10-30 23:41:34 | 0 | 0.0 | 15743 | 28 | mA
2025-10-30 23:41:37 | 0 | 0.0 | 14863 | 27 | mA
2025-10-30 23:41:39 | 0 | 0.0 | 14215 | 25 | mA
2025-10-30 23:41:41 | 0 | 0.0 | 11281 | 20 | mA
2025-10-30 23:41:43 | 0 | 0.0 | 25040 | 45 | mA
2025-10-30 23:41:46 | 0 | 0.0 | 15517 | 28 | mA
2025-10-30 23:41:48 | 2.5 | 2.503 | 1414809 | 2577 | mA
2025-10-30 23:41:50 | 2.5 | 2.503 | 1424610 | 2594 | mA
2025-10-30 23:41:51 | 2.5 | 2.504 | 1424117 | 2594 | mA
2025-10-30 23:41:53 | 2.5 | 2.503 | 1424667 | 2595 | mA
2025-10-30 23:41:55 | 2.5 | 2.504 | 1414651 | 2576 | mA
2025-10-30 23:41:57 | 2.5 | 2.503 | 1419348 | 2585 | mA
2025-10-30 23:41:58 | 2.5 | 2.504 | 1425023 | 2595 | mA
2025-10-30 23:42:00 | 2.5 | 2.503 | 1426415 | 2598 | mA
2025-10-30 23:42:02 | 2.5 | 2.503 | 1429219 | 2603 | mA
2025-10-30 23:42:04 | 2.5 | 2.504 | 1418408 | 2583 | mA
2025-10-30 23:42:06 | 5 | 5.006 | 2833210 | 5160 | mA
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
