daniw/bat_source/hw/test/PS1-1_ADC/PS1-1A ADC Test 2025-10-30 23.39.19_volt.csv

Time | Voltage Setpoint | Voltage DMM | Voltage DUT raw | Voltage DUT | Unit DUT
2025-10-30 23:39:20 | 0 | -0.0038 | 17 | 2 | mV
2025-10-30 23:39:22 | 0 | -0.00333 | 28 | 4 | mV
2025-10-30 23:39:23 | 0 | -0.00312 | -5 | 0 | mV
2025-10-30 23:39:24 | 0 | -0.00318 | 1 | 0 | mV
2025-10-30 23:39:25 | 0 | -0.00344 | 18 | 2 | mV
2025-10-30 23:39:27 | 0 | -0.00351 | 12 | 1 | mV
2025-10-30 23:39:28 | 0 | -0.00341 | 4 | 0 | mV
2025-10-30 23:39:29 | 0 | -0.0037 | 39 | 5 | mV
2025-10-30 23:39:30 | 0 | -0.0033 | 3 | 0 | mV
2025-10-30 23:39:32 | 0 | -0.0034 | 3 | 0 | mV
2025-10-30 23:39:34 | 10 | 10.009 | 69203 | 9999 | mV
2025-10-30 23:39:35 | 10 | 10.009 | 69236 | 10004 | mV
2025-10-30 23:39:37 | 10 | 10.009 | 69215 | 10001 | mV
2025-10-30 23:39:39 | 10 | 10.009 | 69208 | 10000 | mV
2025-10-30 23:39:40 | 10 | 10.009 | 69216 | 10001 | mV
2025-10-30 23:39:42 | 10 | 10.009 | 69210 | 10000 | mV
2025-10-30 23:39:44 | 10 | 10.01 | 69218 | 10001 | mV
2025-10-30 23:39:46 | 10 | 10.009 | 69227 | 10003 | mV
2025-10-30 23:39:47 | 10 | 10.009 | 69231 | 10003 | mV
2025-10-30 23:39:49 | 10 | 10.01 | 69203 | 9999 | mV
2025-10-30 23:39:51 | 20 | 20.012 | 138480 | 20010 | mV
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
