daniw/bat_source/hw/test/PS1-1_ADC/PS1-1A ADC Test 2025-10-30 23.48.31_volt.csv

Time | Voltage Setpoint | Voltage DMM | Voltage DUT raw | Voltage DUT | Unit DUT
2025-10-30 23:48:33 | 0 | -0.00311 | 15 | 2 | mV
2025-10-30 23:48:34 | 0 | -0.00323 | 24 | 3 | mV
2025-10-30 23:48:35 | 0 | -0.00321 | 1 | 0 | mV
2025-10-30 23:48:36 | 0 | -0.00287 | 5 | 0 | mV
2025-10-30 23:48:38 | 0 | -0.00327 | -3 | 0 | mV
2025-10-30 23:48:39 | 0 | -0.00298 | 25 | 3 | mV
2025-10-30 23:48:40 | 0 | -0.00322 | 34 | 4 | mV
2025-10-30 23:48:41 | 0 | -0.00314 | -5 | 0 | mV
2025-10-30 23:48:43 | 0 | -0.00287 | 10 | 1 | mV
2025-10-30 23:48:44 | 0 | -0.00287 | 47 | 6 | mV
2025-10-30 23:48:45 | 0 | -0.00356 | 30 | 4 | mV
2025-10-30 23:48:46 | 0 | -0.00311 | 2 | 0 | mV
2025-10-30 23:48:48 | 0 | -0.00327 | 15 | 2 | mV
2025-10-30 23:48:49 | 0 | -0.0033 | 52 | 7 | mV
2025-10-30 23:48:50 | 0 | -0.00345 | -9 | -1 | mV
2025-10-30 23:48:51 | 0 | -0.00324 | 31 | 4 | mV
2025-10-30 23:48:52 | 0 | -0.00324 | 36 | 5 | mV
2025-10-30 23:48:54 | 0 | -0.00322 | 31 | 4 | mV
2025-10-30 23:48:55 | 0 | -0.00322 | 25 | 3 | mV
2025-10-30 23:48:56 | 0 | -0.00328 | 8 | 1 | mV
2025-10-30 23:48:57 | 0 | -0.00286 | 7 | 1 | mV
2025-10-30 23:48:59 | 0 | -0.00325 | 14 | 2 | mV
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
