daniw/bat_source/hw/test/PS1-1_ADC/PS1-1A ADC Test 2025-10-31 18.40.21_amp.csv

Time | Current Setpoint | Current DMM | Current DUT raw | Current DUT | Unit DUT
2025-10-31 21:45:22 | 0 | 1e-06 | -28465 | -51 | mA
2025-10-31 21:45:24 | 0 | 0.0 | -31213 | -56 | mA
2025-10-31 21:45:26 | 0 | 1e-06 | -43929 | -80 | mA
2025-10-31 21:45:28 | 0 | 1e-06 | -41969 | -76 | mA
2025-10-31 21:45:31 | 0 | 0.0 | -35654 | -64 | mA
2025-10-31 21:45:33 | 0 | 0.0 | -20612 | -37 | mA
2025-10-31 21:45:35 | 0 | 0.0 | -25891 | -47 | mA
2025-10-31 21:45:37 | 0 | 0.0 | -18289 | -33 | mA
2025-10-31 21:45:40 | 0 | 0.0 | -32128 | -58 | mA
2025-10-31 21:45:42 | 0 | 0.0 | -36600 | -66 | mA
2025-10-31 21:45:44 | 0 | 0.0 | -25769 | -46 | mA
2025-10-31 21:45:46 | 0 | 0.0 | -38140 | -69 | mA
2025-10-31 21:45:49 | 0 | 0.0 | -32117 | -58 | mA
2025-10-31 21:45:51 | 0 | 0.0 | -35554 | -64 | mA
2025-10-31 21:45:53 | 0 | 0.0 | -33936 | -61 | mA
2025-10-31 21:45:56 | 0 | 0.0 | -23743 | -43 | mA
2025-10-31 21:45:58 | 0 | 0.0 | -37323 | -67 | mA
2025-10-31 21:46:00 | 0 | 0.0 | -36710 | -66 | mA
2025-10-31 21:46:02 | 0 | 0.0 | -37582 | -68 | mA
2025-10-31 21:46:05 | 0 | 0.0 | -31003 | -56 | mA
2025-10-31 21:46:07 | 0 | 0.0 | -39437 | -71 | mA
2025-10-31 21:46:09 | 0 | 0.0 | -39822 | -72 | mA
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
