daniw/bat_source/hw/test/PS1-1_ADC/PS1-1A ADC Test 2025-10-31 18.40.21_volt.csv

TimeVoltage Setpoint | Voltage DMM | Voltage DUT raw | Voltage DUT | Unit DUT
2025-10-31 18:40:23 | 0 | -0.00246 | -12 | -1 | mV
2025-10-31 18:40:24 | 0 | -0.00251 | -1 | 0 | mV
2025-10-31 18:40:25 | 0 | -0.00241 | 0 | 0 | mV
2025-10-31 18:40:27 | 0 | -0.00246 | -14 | -2 | mV
2025-10-31 18:40:28 | 0 | -0.00254 | -6 | 0 | mV
2025-10-31 18:40:29 | 0 | -0.00225 | 5 | 0 | mV
2025-10-31 18:40:30 | 0 | -0.00252 | 21 | 3 | mV
2025-10-31 18:40:32 | 0 | -0.0027 | -21 | -3 | mV
2025-10-31 18:40:33 | 0 | -0.00268 | -9 | -1 | mV
2025-10-31 18:40:34 | 0 | -0.00274 | -4 | 0 | mV
2025-10-31 18:40:35 | 0 | -0.00264 | 1 | 0 | mV
2025-10-31 18:40:37 | 0 | -0.0022 | 1 | 0 | mV
2025-10-31 18:40:38 | 0 | -0.00259 | -16 | -2 | mV
2025-10-31 18:40:39 | 0 | -0.00279 | -7 | -1 | mV
2025-10-31 18:40:40 | 0 | -0.00268 | 2 | 0 | mV
2025-10-31 18:40:42 | 0 | -0.00223 | -14 | -2 | mV
2025-10-31 18:40:43 | 0 | -0.00257 | 5 | 0 | mV
2025-10-31 18:40:44 | 0 | -0.00216 | -13 | -1 | mV
2025-10-31 18:40:45 | 0 | -0.00237 | -17 | -2 | mV
2025-10-31 18:40:46 | 0 | -0.00229 | 9 | 1 | mV
2025-10-31 18:40:48 | 0 | -0.00205 | 10 | 1 | mV
2025-10-31 18:40:49 | 0 | -0.00228 | 3 | 0 | mV
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
