daniw/bat_source/hw/test/PS1-1_ADC/PS1-1A ADC Test 2025-10-31 23.08.40_sens.csv

Time | Sens Setpoint | Voltage DMM | Sens DUT raw | Sens DUT | Sens Unit DUT
2025-10-31 23:08:41 | 0 | -0.00316 | 78 | 11 | uV
2025-10-31 23:08:43 | 0 | -0.00296 | 49 | 7 | uV
2025-10-31 23:08:44 | 0 | -0.00313 | 57 | 8 | uV
2025-10-31 23:08:45 | 0 | -0.00248 | 55 | 7 | uV
2025-10-31 23:08:46 | 0 | -0.00261 | 82 | 11 | uV
2025-10-31 23:08:48 | 0 | -0.00249 | 52 | 7 | uV
2025-10-31 23:08:49 | 0 | -0.00307 | 55 | 7 | uV
2025-10-31 23:08:50 | 0 | -0.00277 | 56 | 8 | uV
2025-10-31 23:08:51 | 0 | -0.00319 | 68 | 9 | uV
2025-10-31 23:08:53 | 0 | -0.00294 | 63 | 9 | uV
2025-10-31 23:08:54 | 0 | -0.0028 | 49 | 7 | uV
2025-10-31 23:08:55 | 0 | -0.00271 | 46 | 6 | uV
2025-10-31 23:08:56 | 0 | -0.00288 | 65 | 9 | uV
2025-10-31 23:08:58 | 0 | -0.00273 | 46 | 6 | uV
2025-10-31 23:08:59 | 0 | -0.00307 | 62 | 8 | uV
2025-10-31 23:09:00 | 0 | -0.00286 | 102 | 14 | uV
2025-10-31 23:09:01 | 0 | -0.00268 | 51 | 7 | uV
2025-10-31 23:09:03 | 0 | -0.00304 | 42 | 6 | uV
2025-10-31 23:09:04 | 0 | -0.00322 | 44 | 6 | uV
2025-10-31 23:09:05 | 0 | -0.00292 | 55 | 7 | uV
2025-10-31 23:09:06 | 0 | -0.00289 | 45 | 6 | uV
2025-10-31 23:09:07 | 0 | -0.0031 | 28 | 4 | uV
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
