daniw/bat_source/doc/appendix/PS1-1AA_Schematic_2025-06-30.PDF

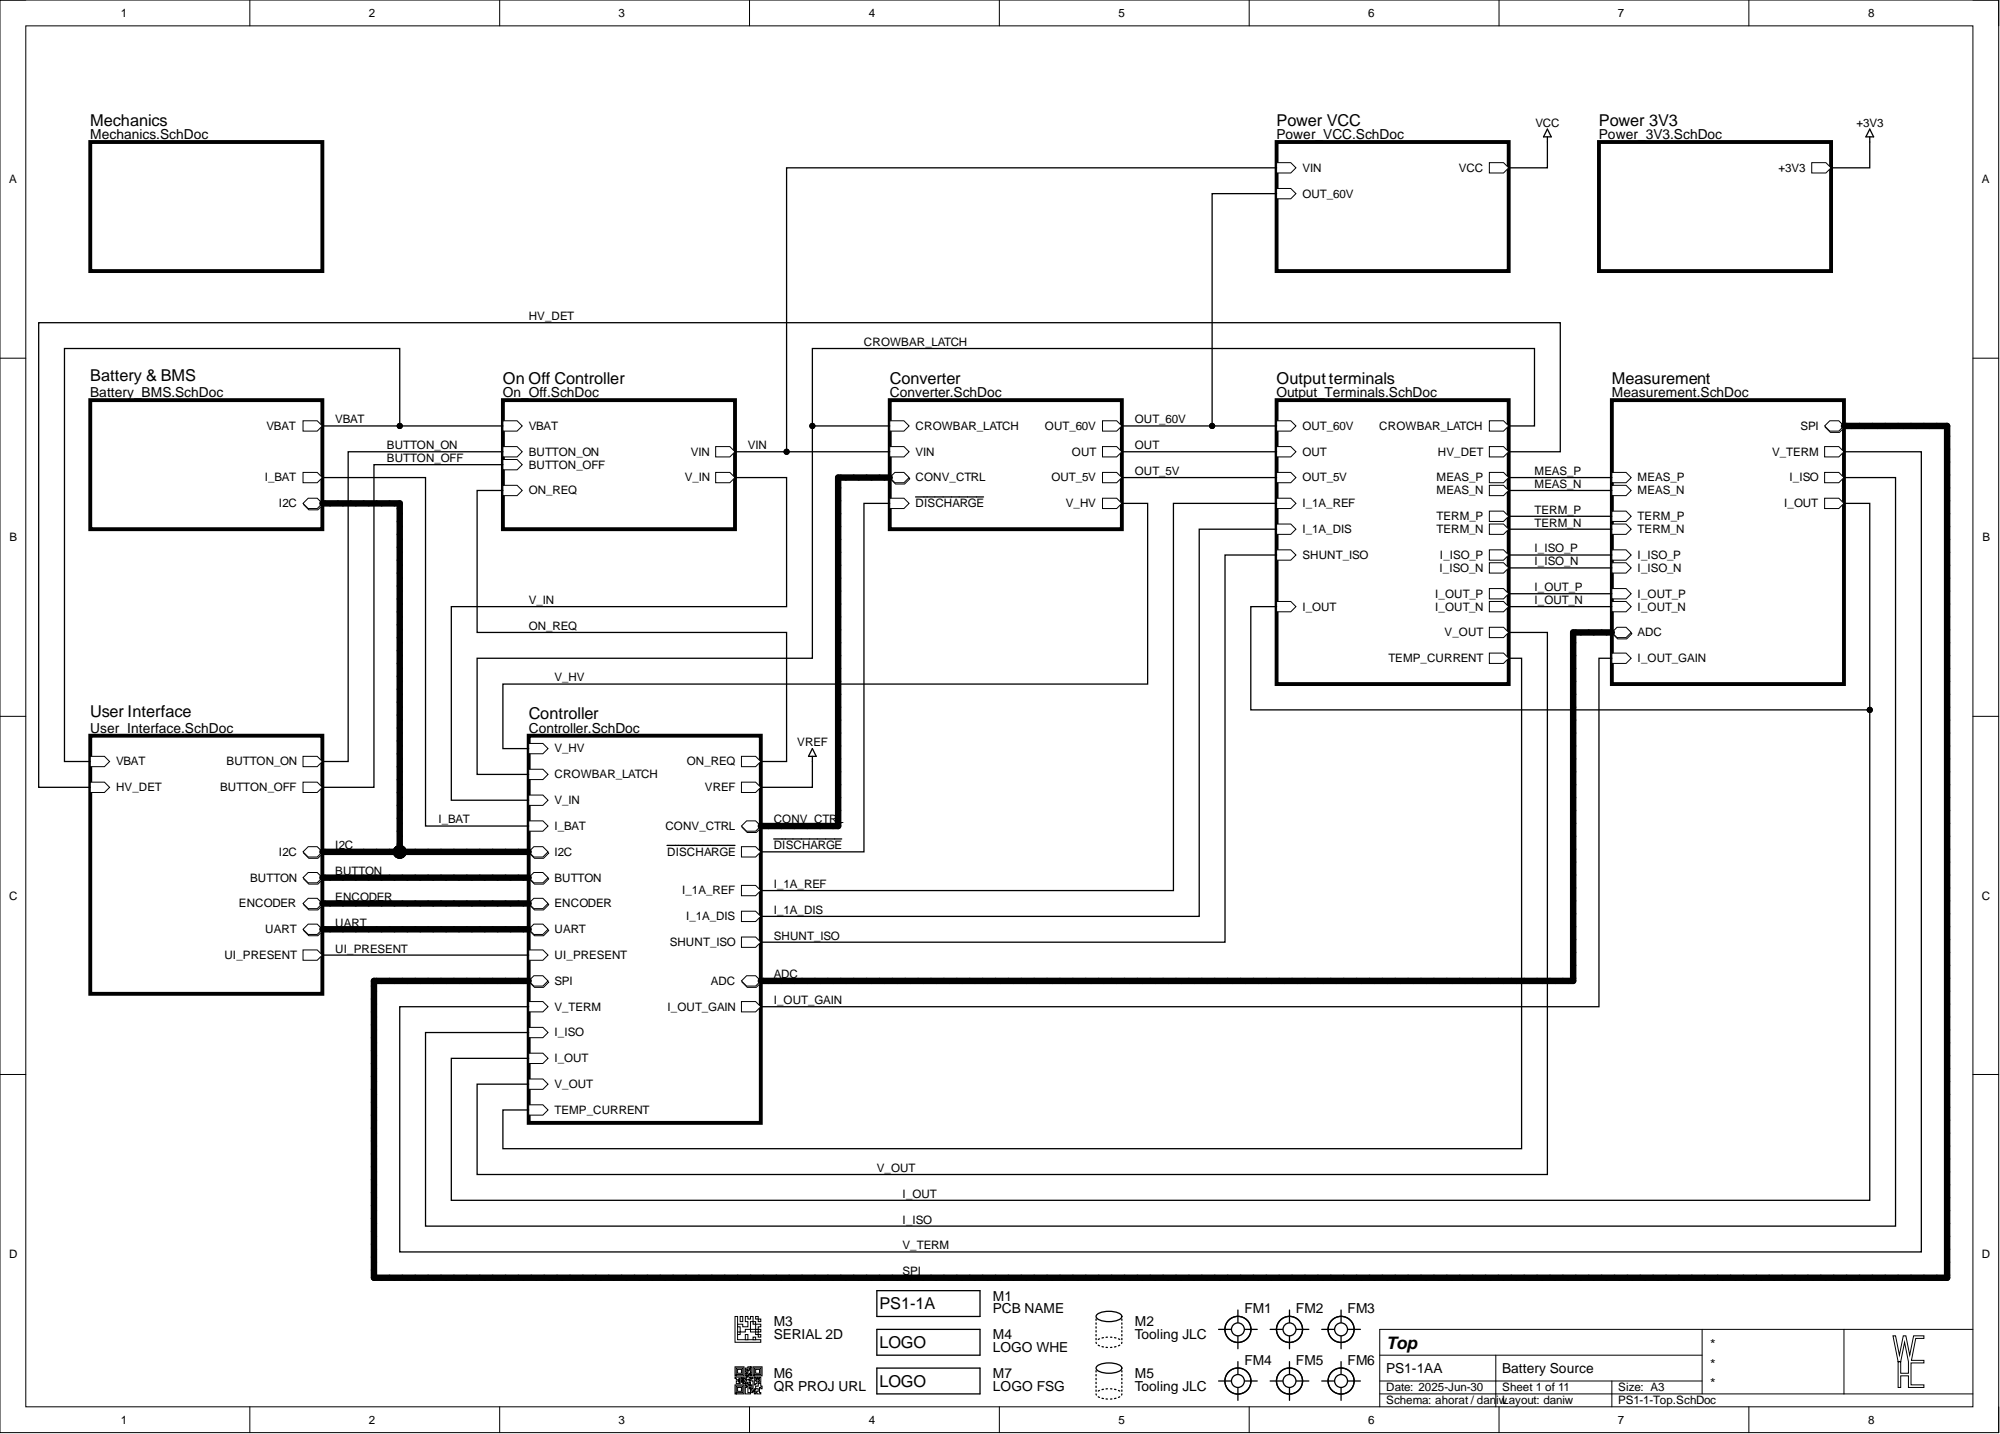
[picture p44: page 1]

BUTTON_ON | BUTTON_ON VIN BUTTON_OFF | VIN | | | OUT
BUTTON_OFF | | | CONV_CTRL OUT_5V DISCHARGE V_HV | OUT_5V | | MEAS_P

Controller Controller.SchDoc | | VREF

2025-Jun-30
Schema: ahorat / daniwLayout: daniw

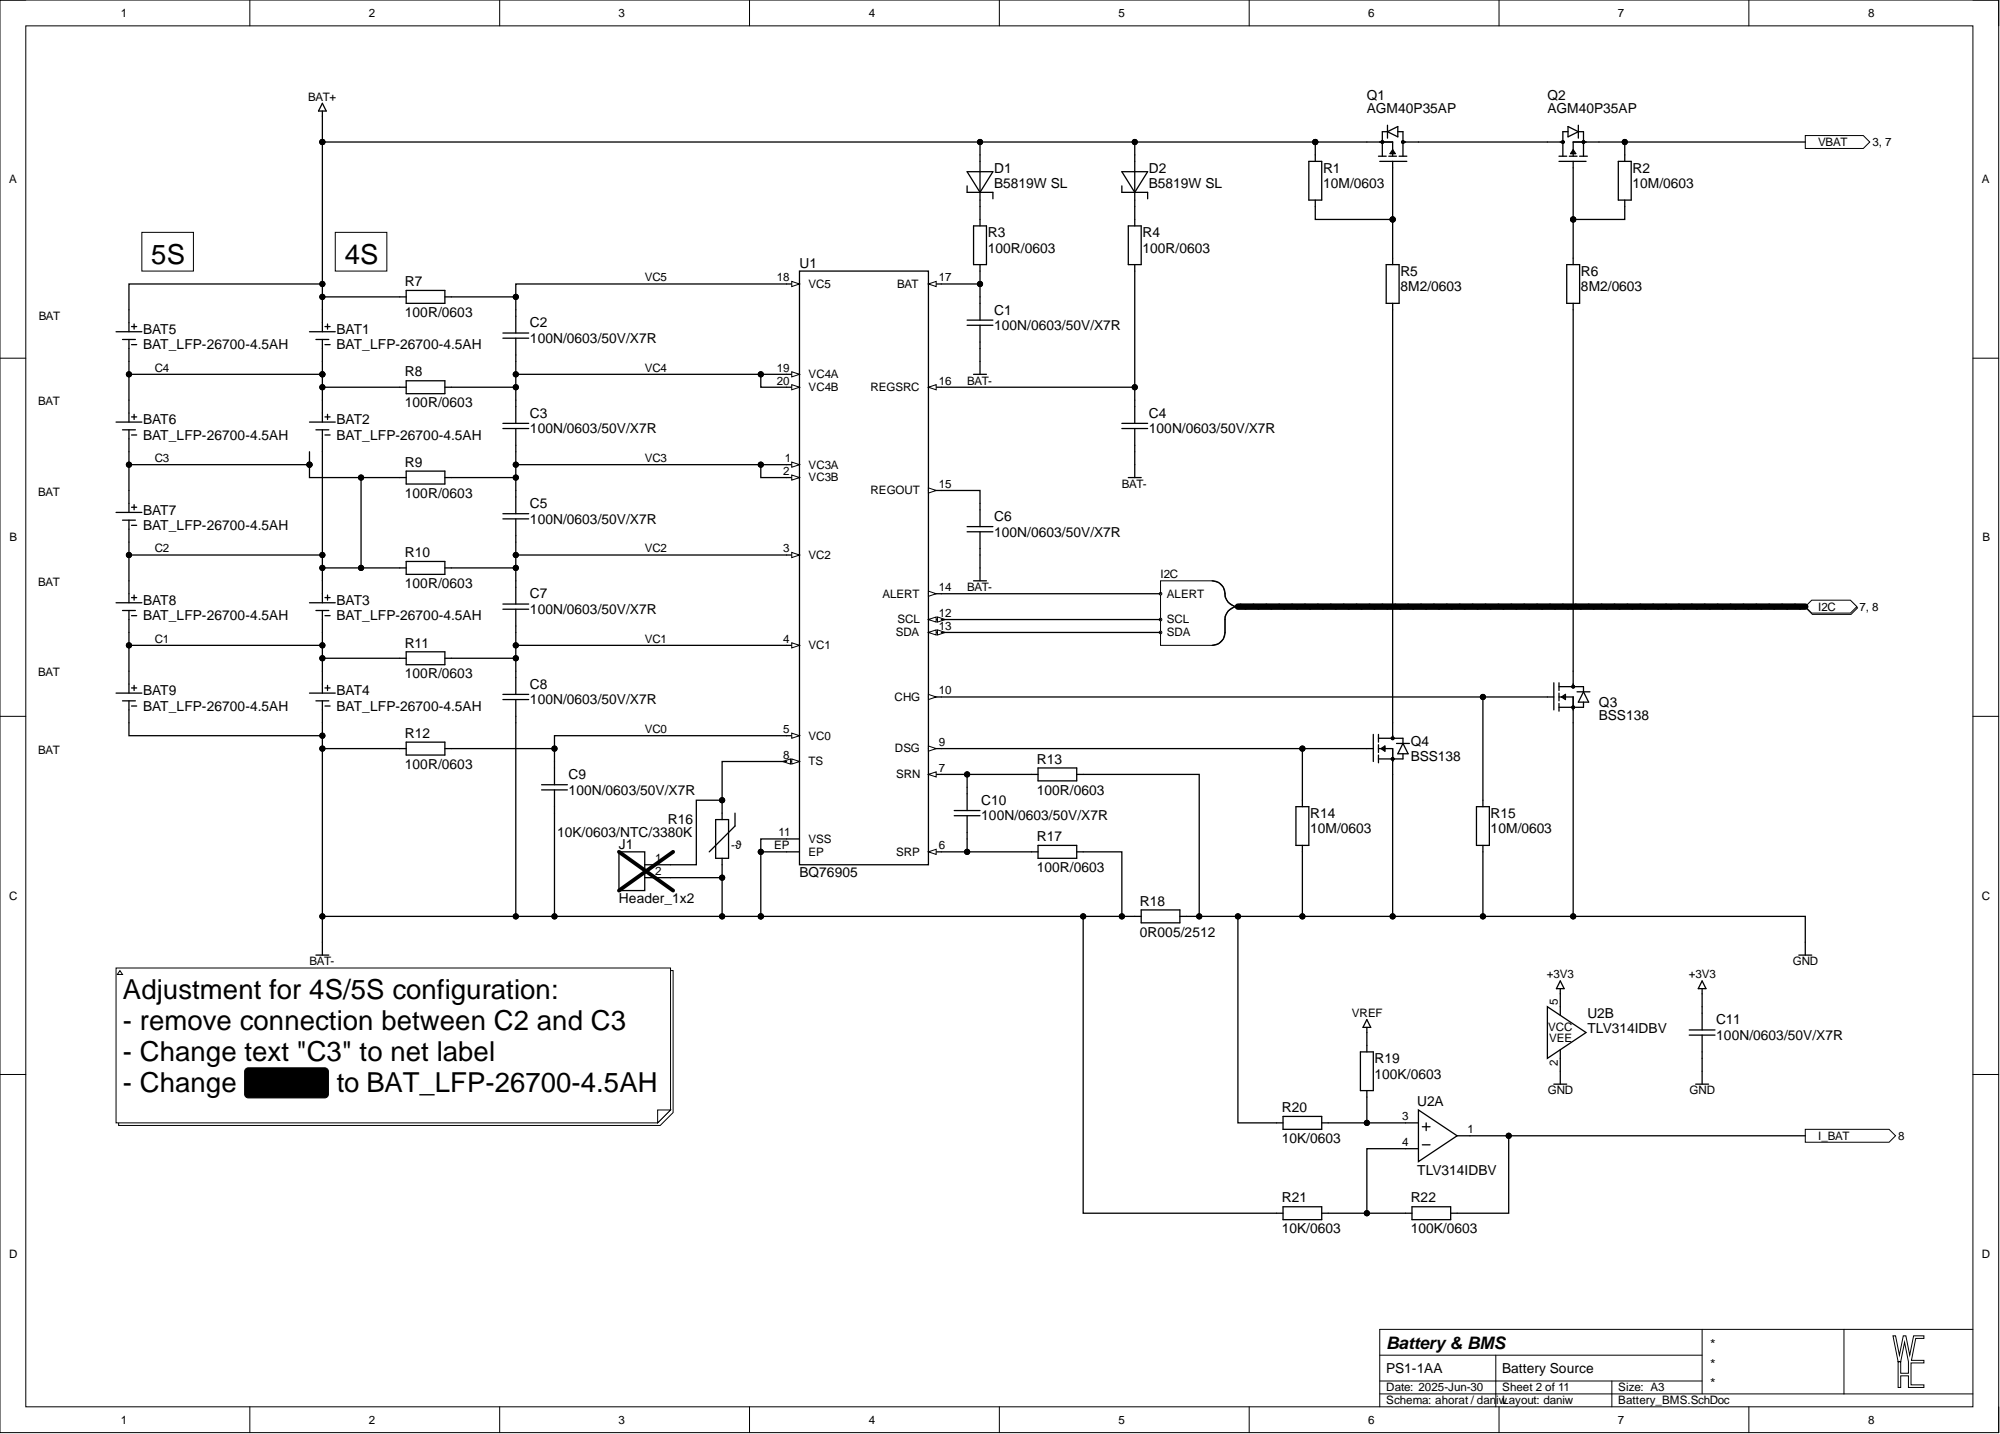
[picture p45: page 2]

Adjustment for 4S/5S configuration:
- remove connection between C2 and C3
- Change text "C3" to net label
- Change BAT2 to BAT_LFP-26700-4.5AH

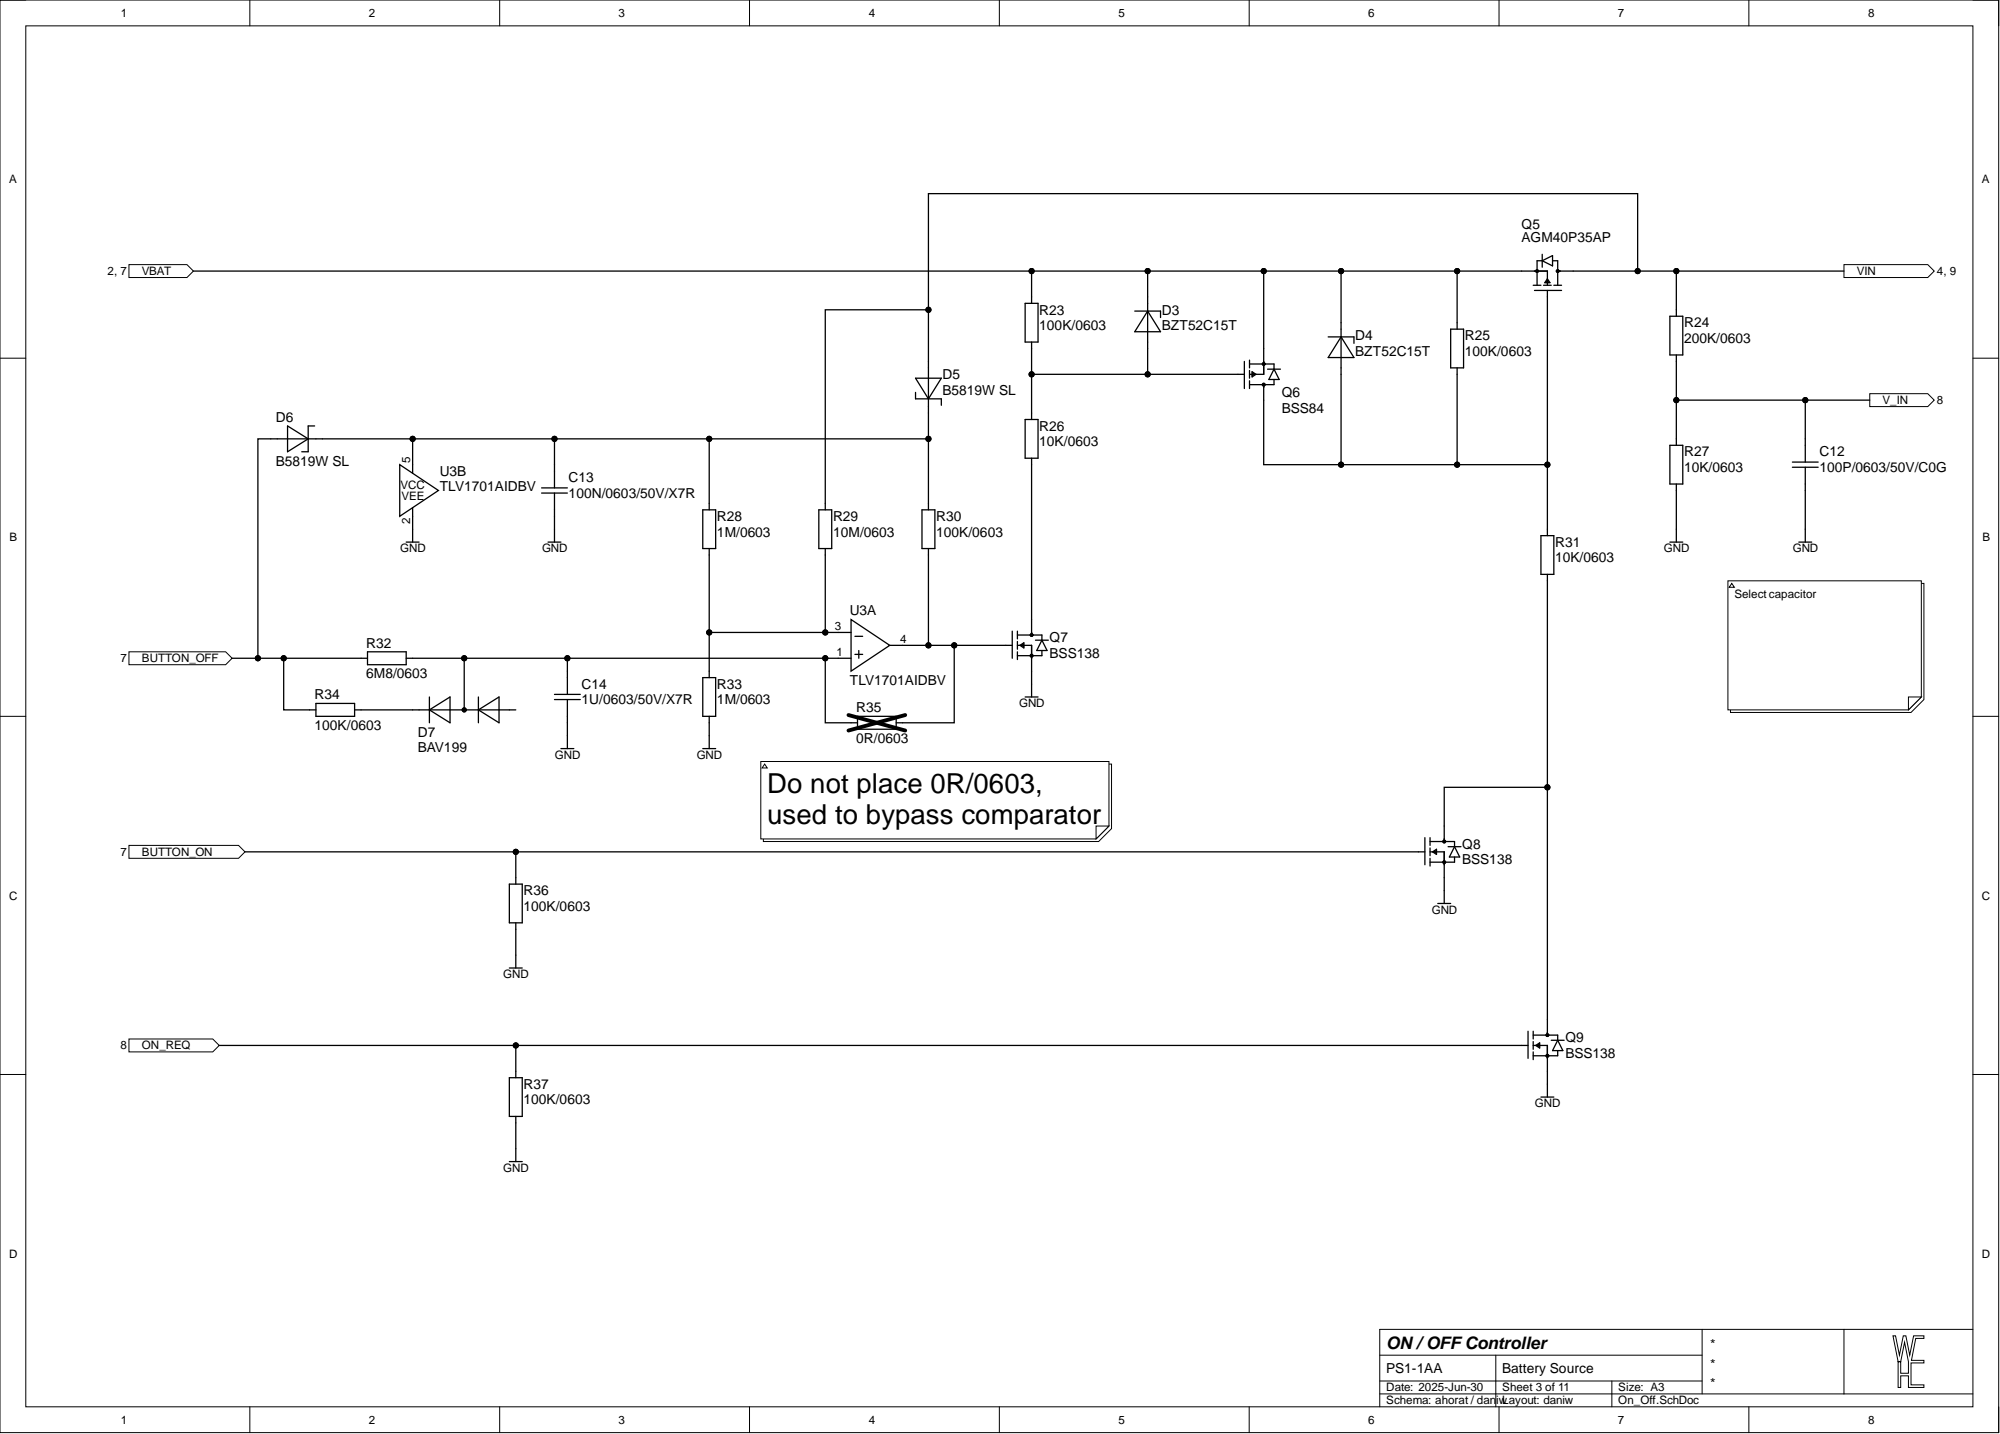
[picture p46: page 3]

Do not place 0R/0603,
used to bypass comparator

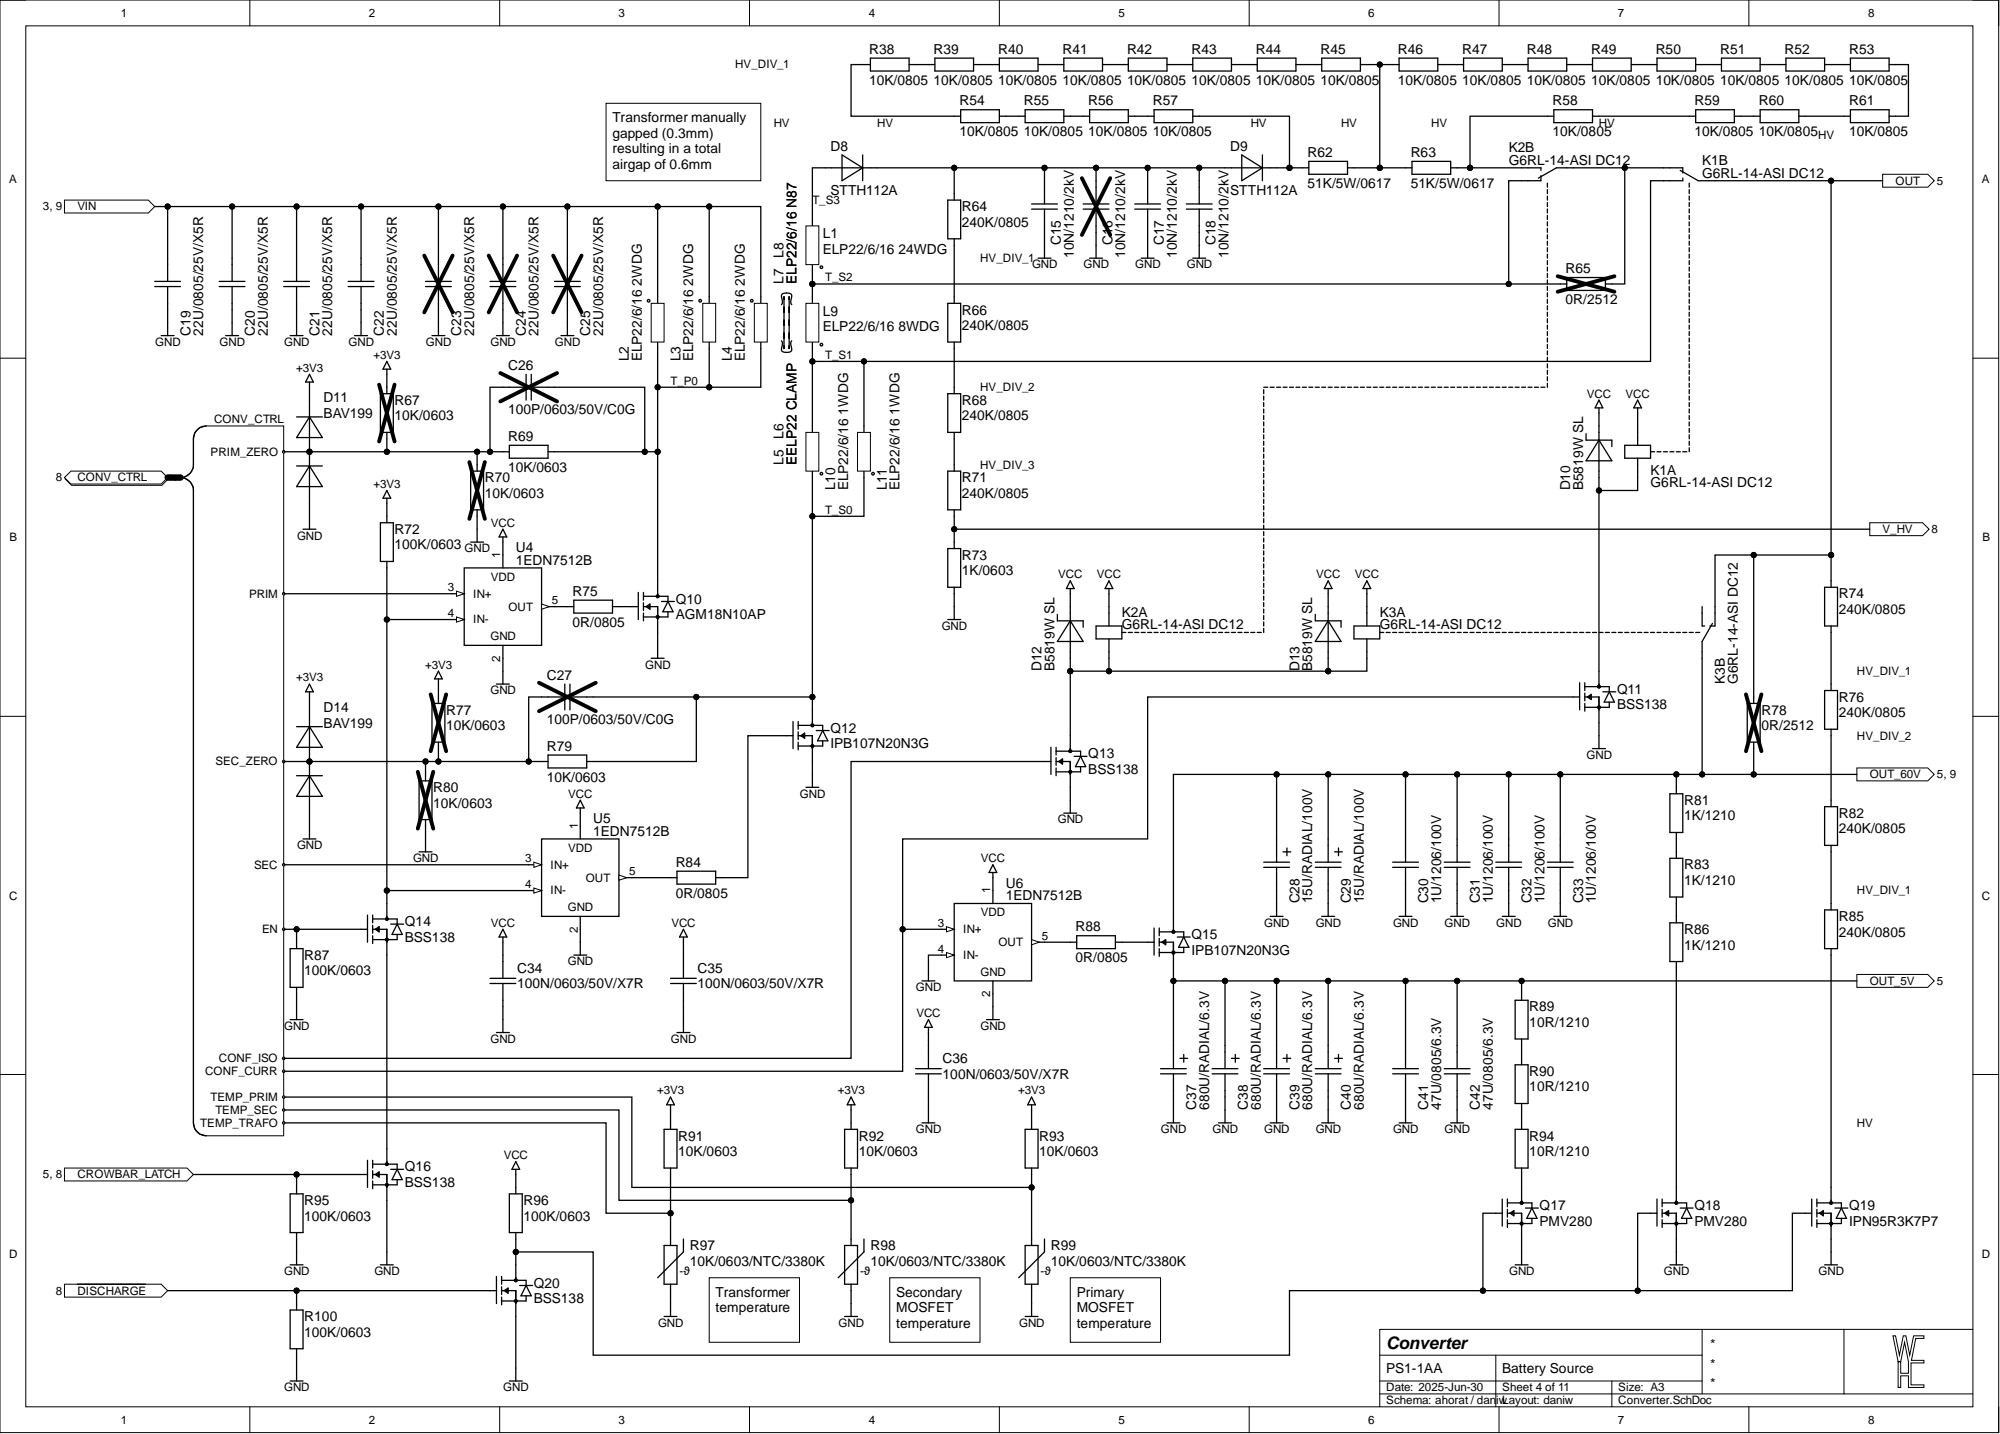
[picture p47: page 4]

GND

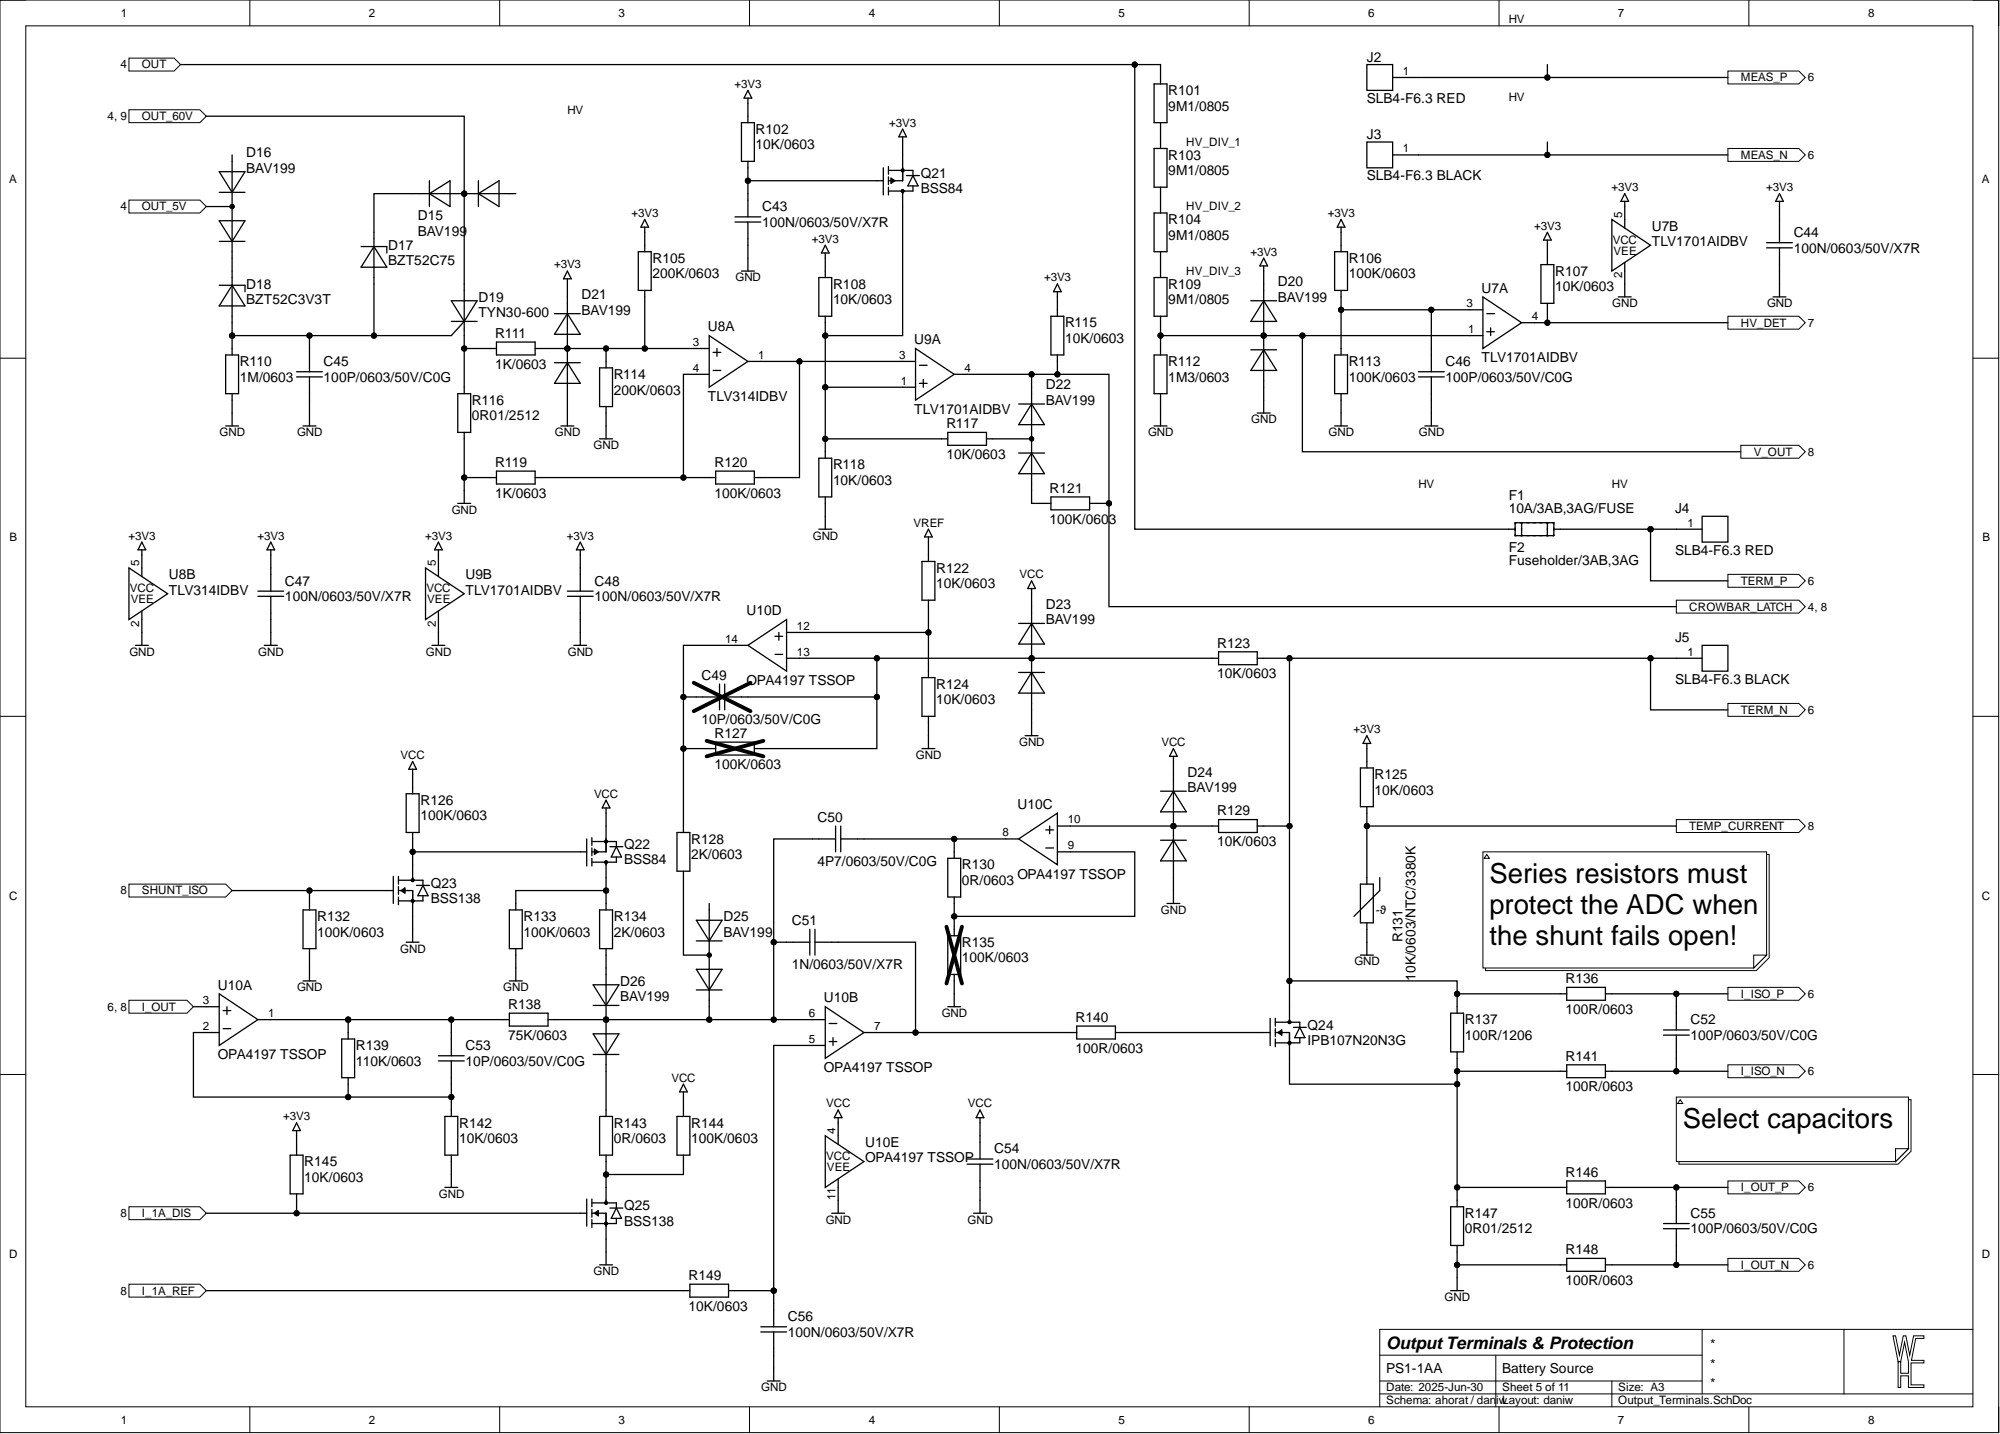
[picture p48: page 5]

Series resistors must
protect the ADC when
the shunt fails open!

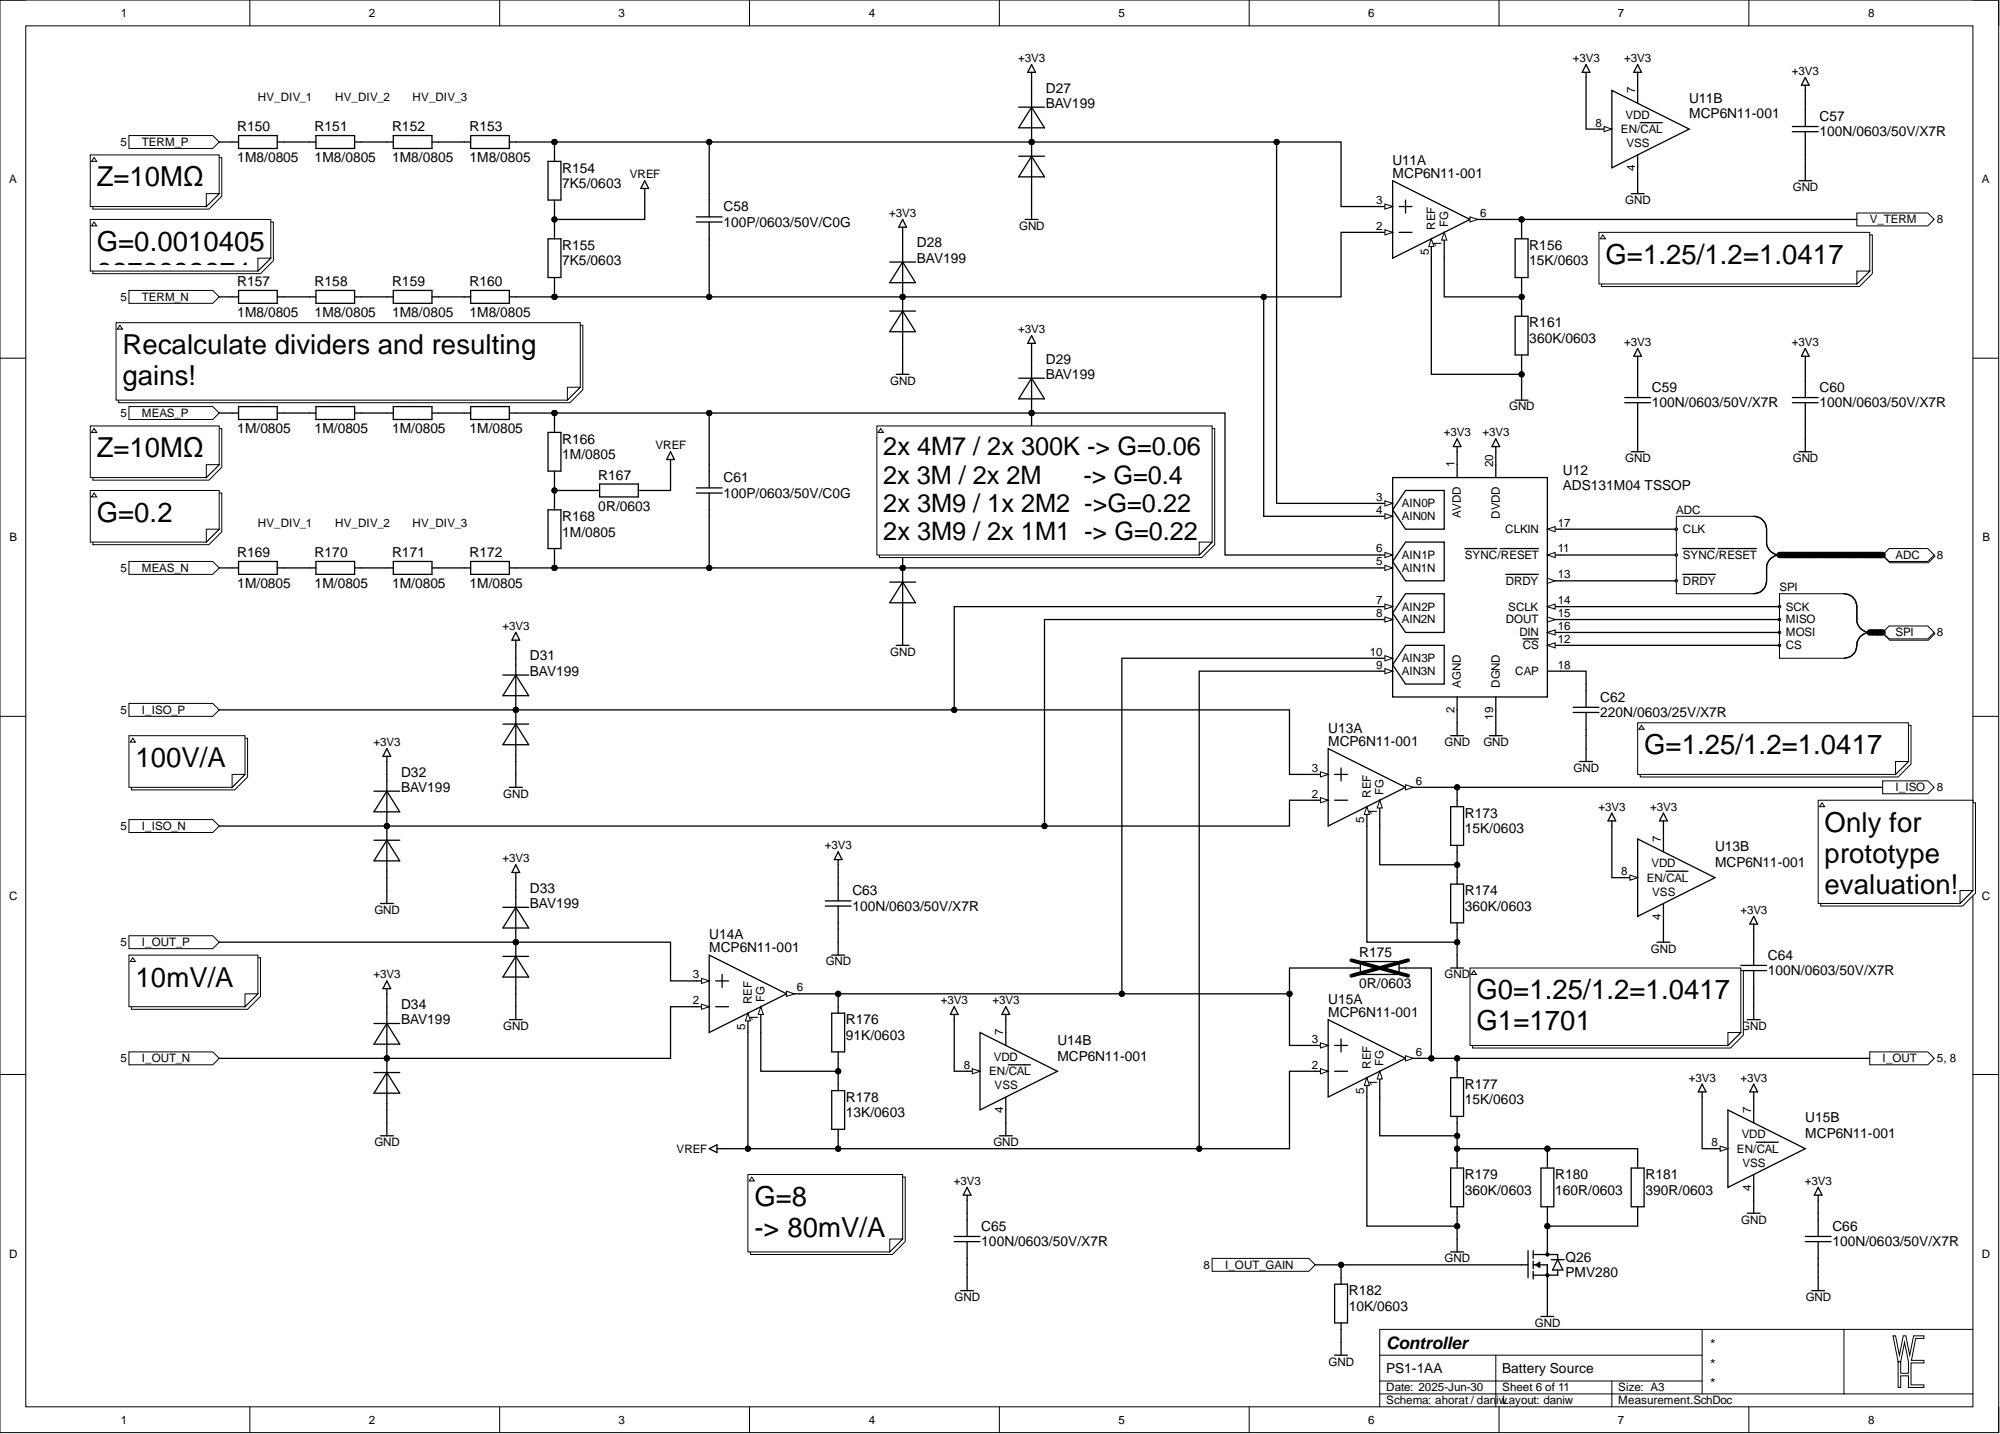
[picture p49: page 6]

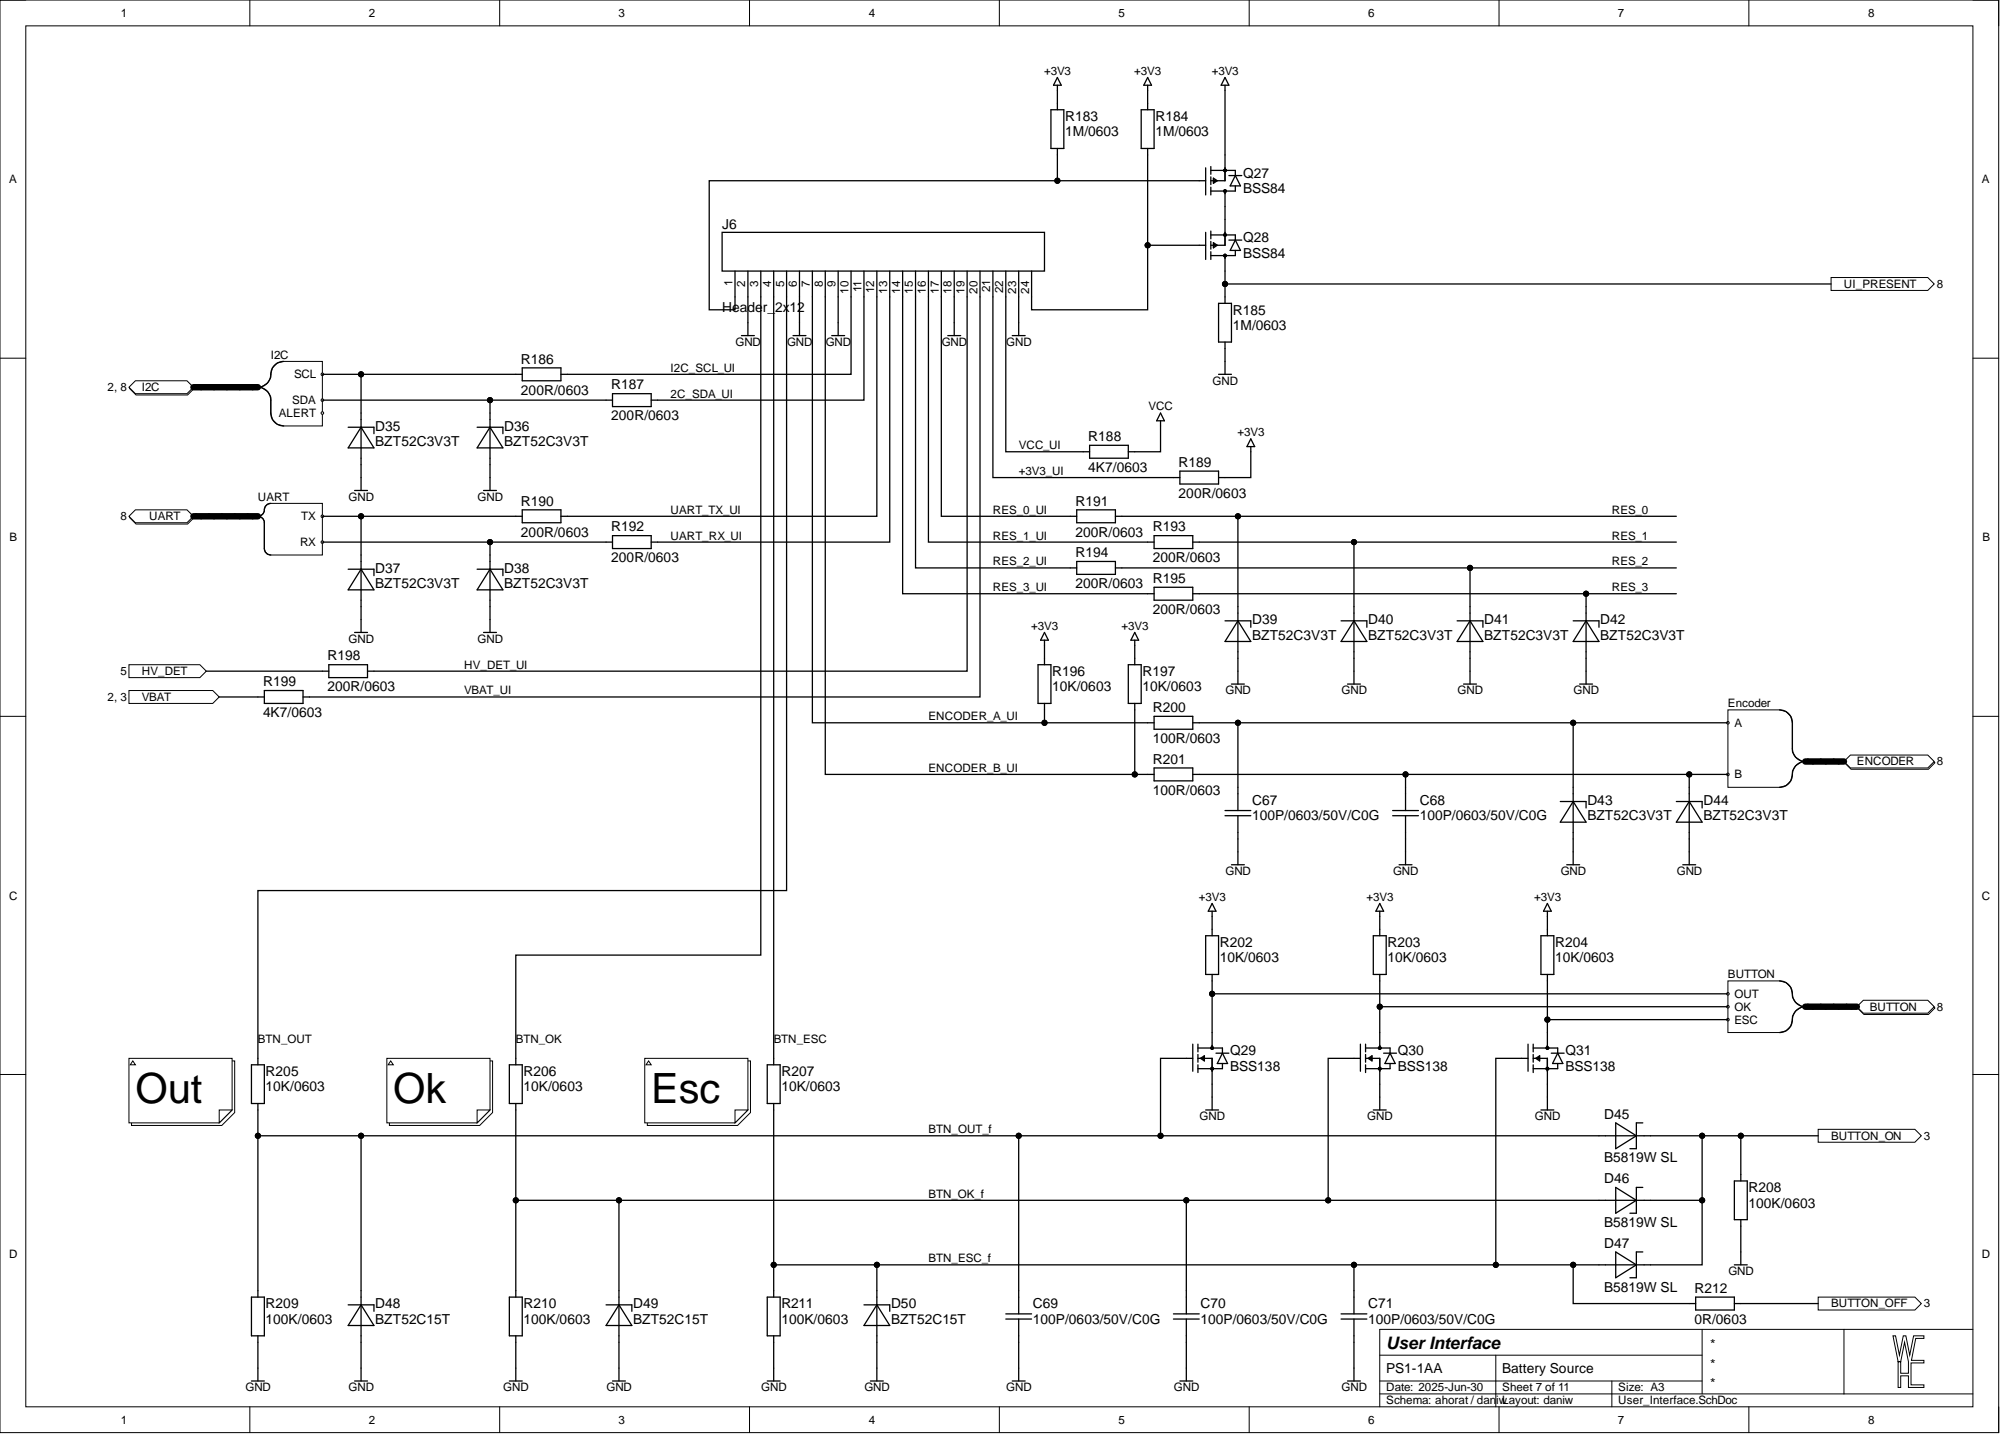
[picture p50: page 7]

UART_TX_UI

UART_RX_UI | | | RES_1_UI

RES_2_UI | 200R/0603 R194

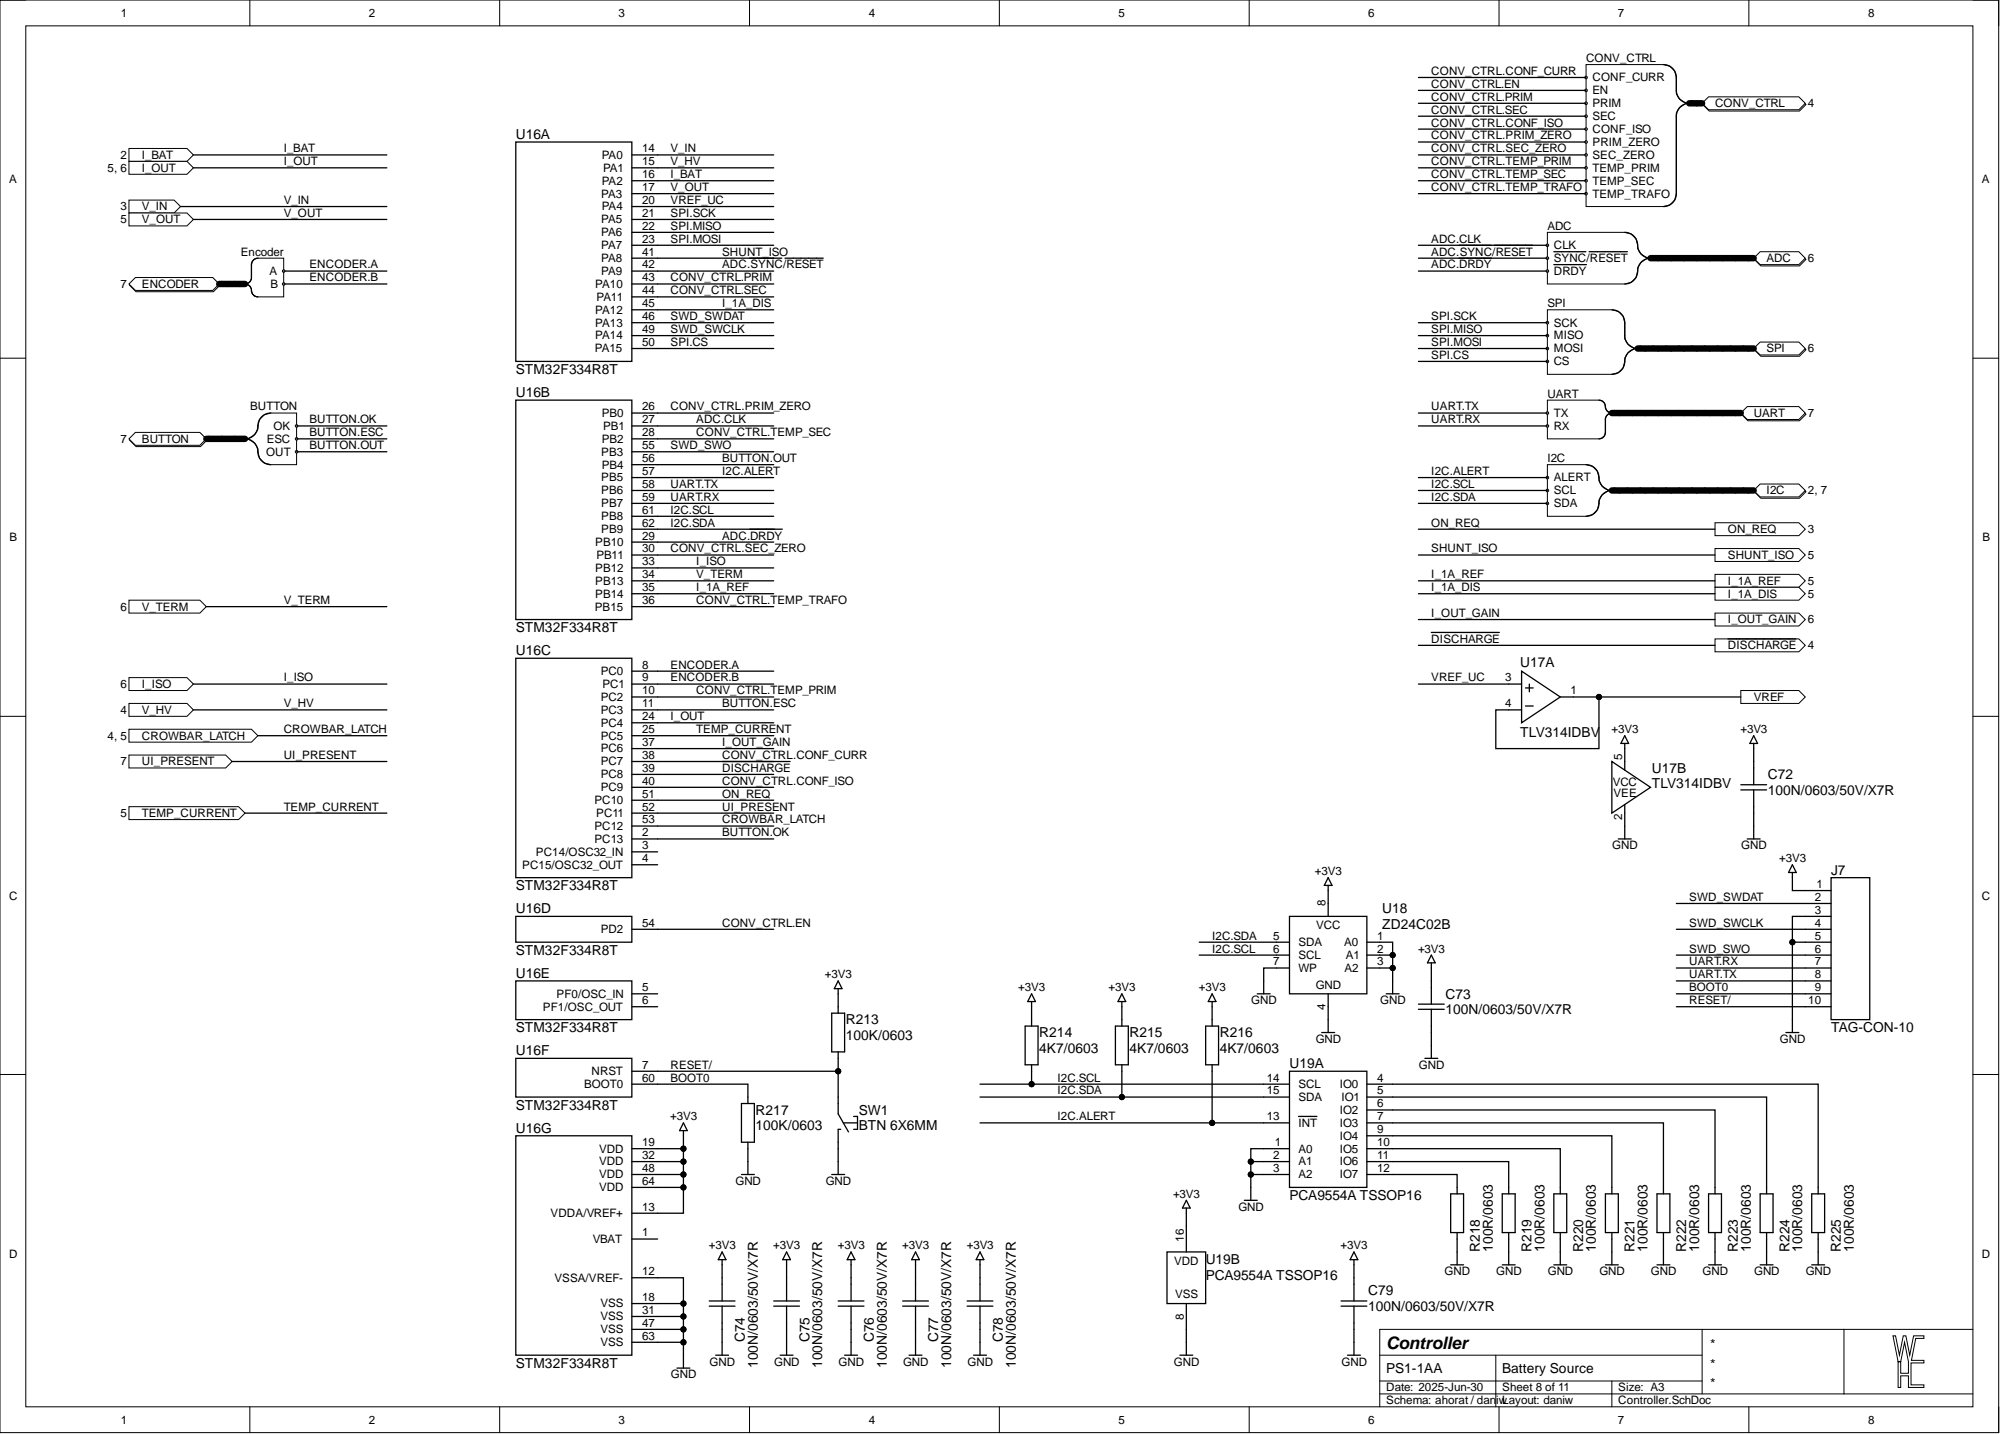
[picture p51: page 8]

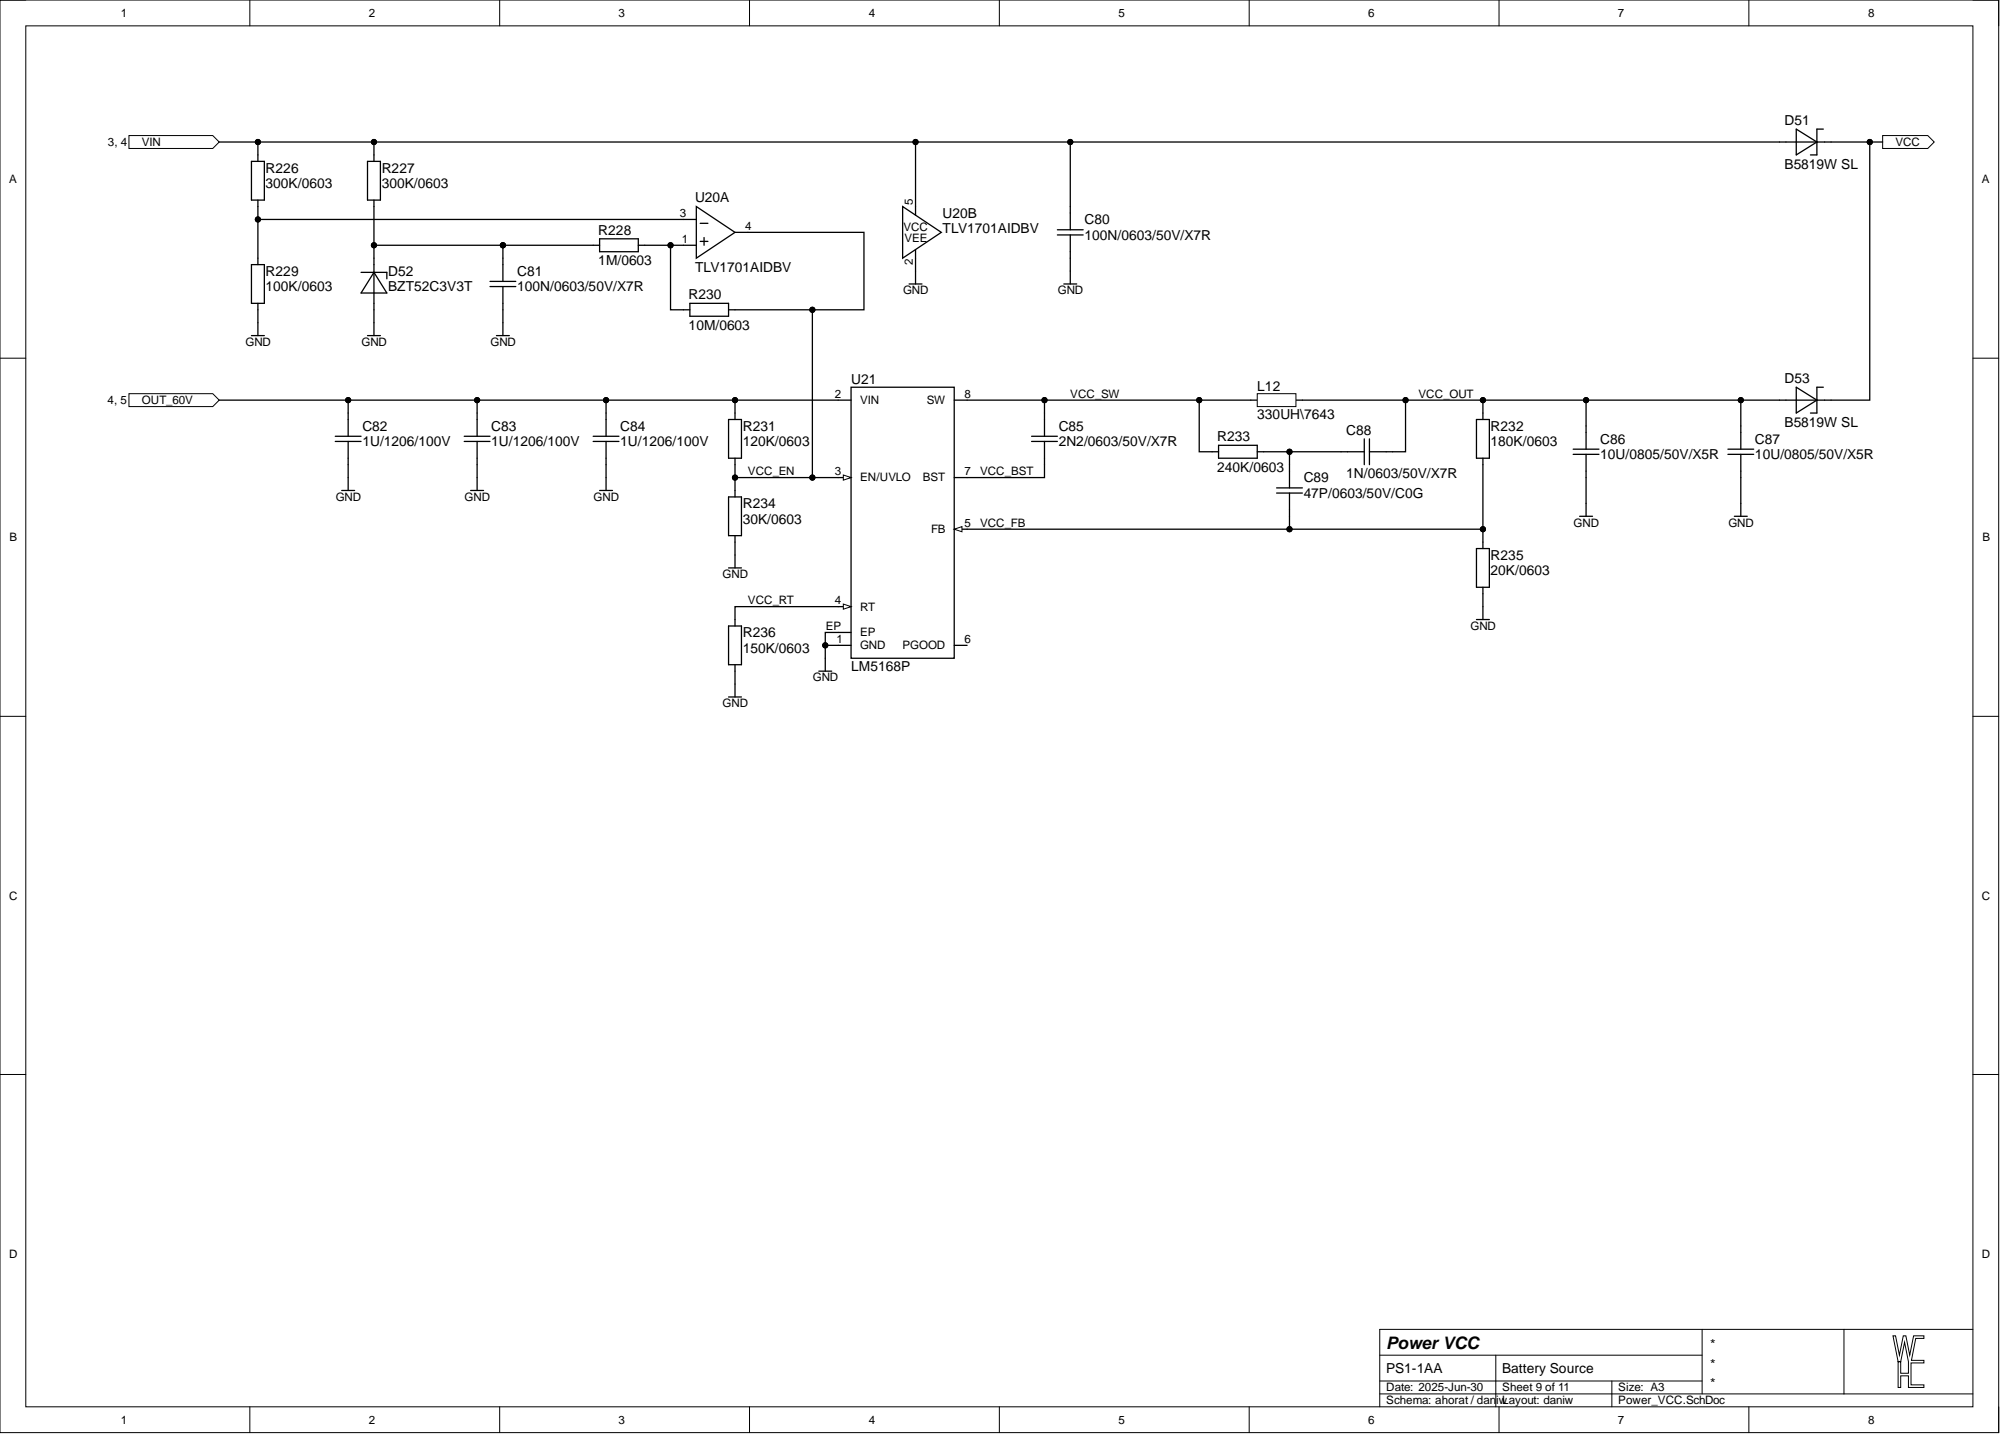
[picture p52: page 9]

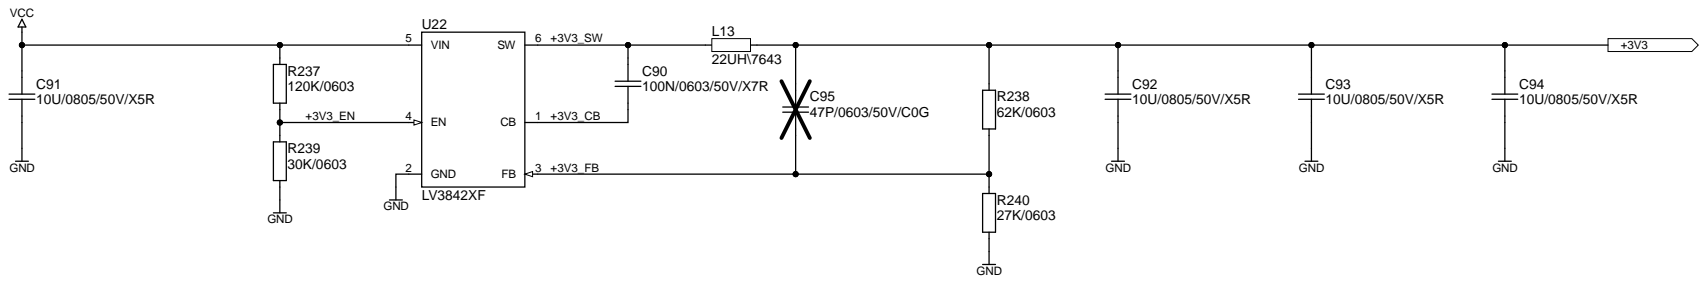
[picture p53: page 10]

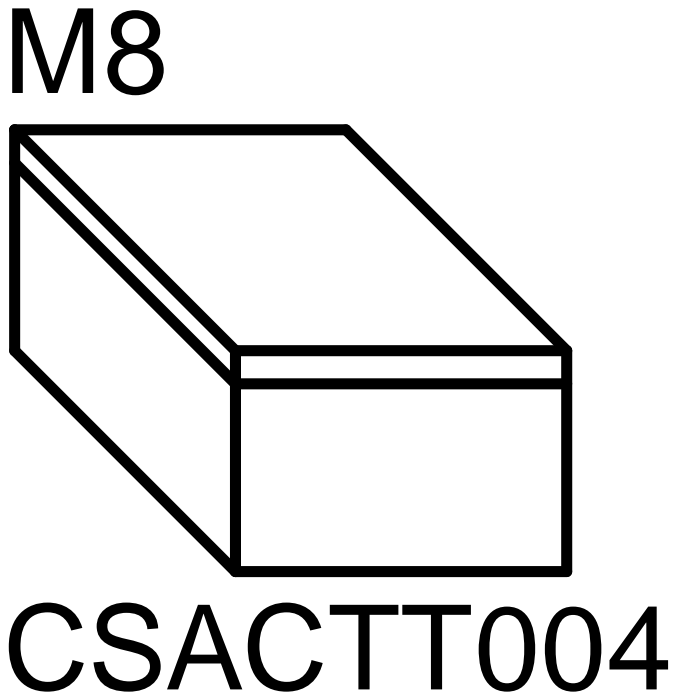
[picture p54: page 11]
