daniw/bat_source/doc/appendix/PS1-3AA_Schematic_2025-06-30.PDF

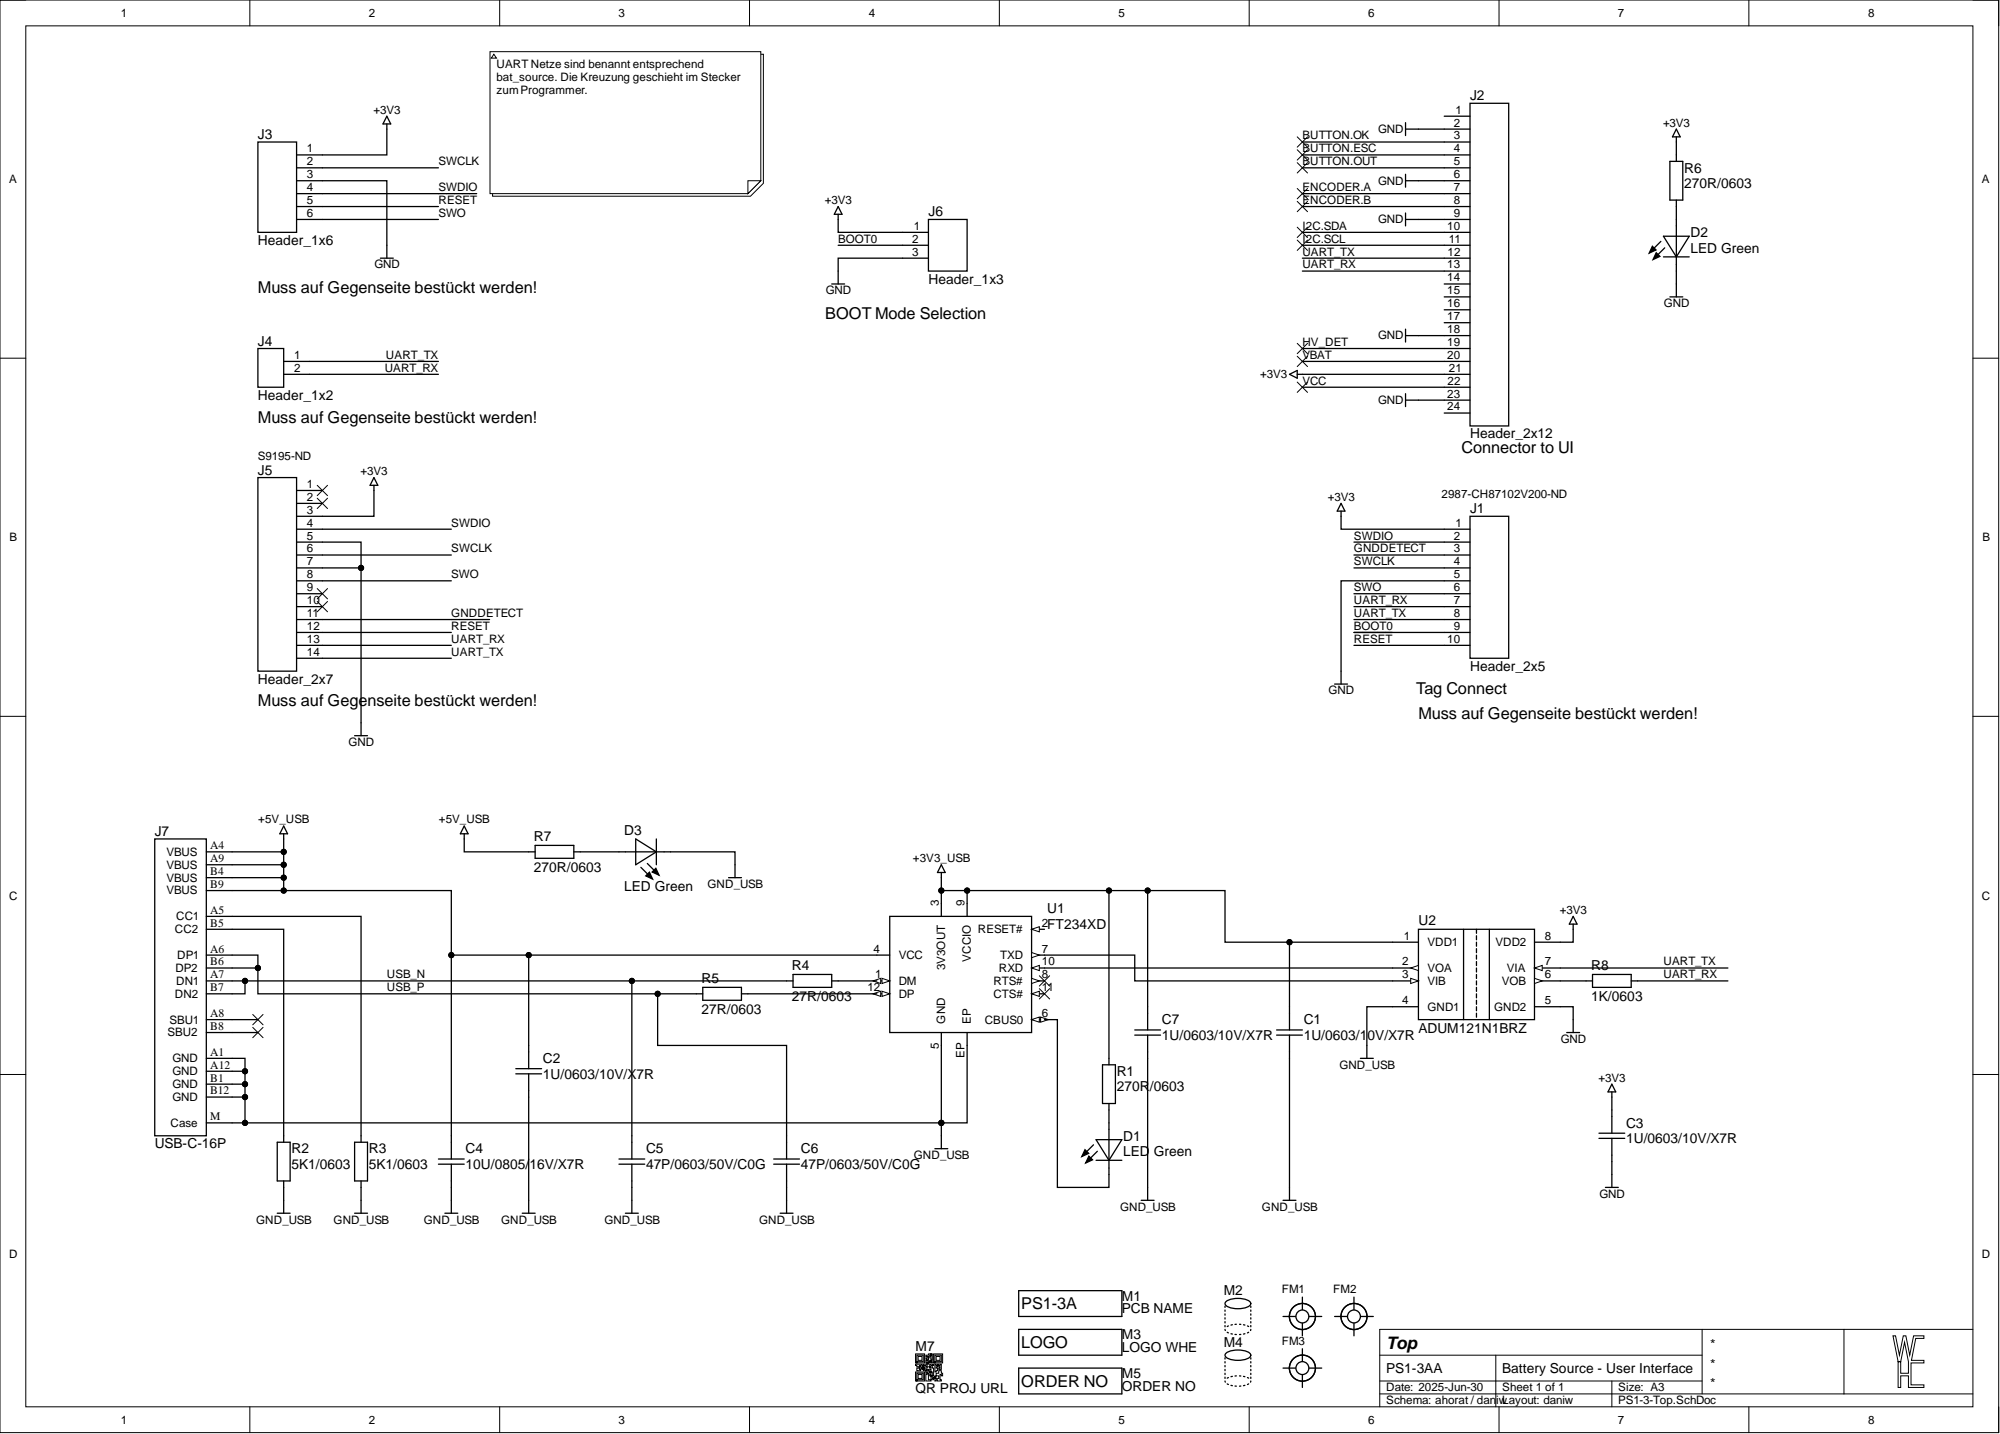
[picture p55: page 1]

UART Netze sind benannt entsprechend
bat_source. Die Kreuzung geschieht im Stecker
zum Programmer.

Muss auf Gegenseite bestückt werden!

Header_1x2

Header_2x7
