daniw/bat_source/hw/sim/PLECS/Flyback.pdf

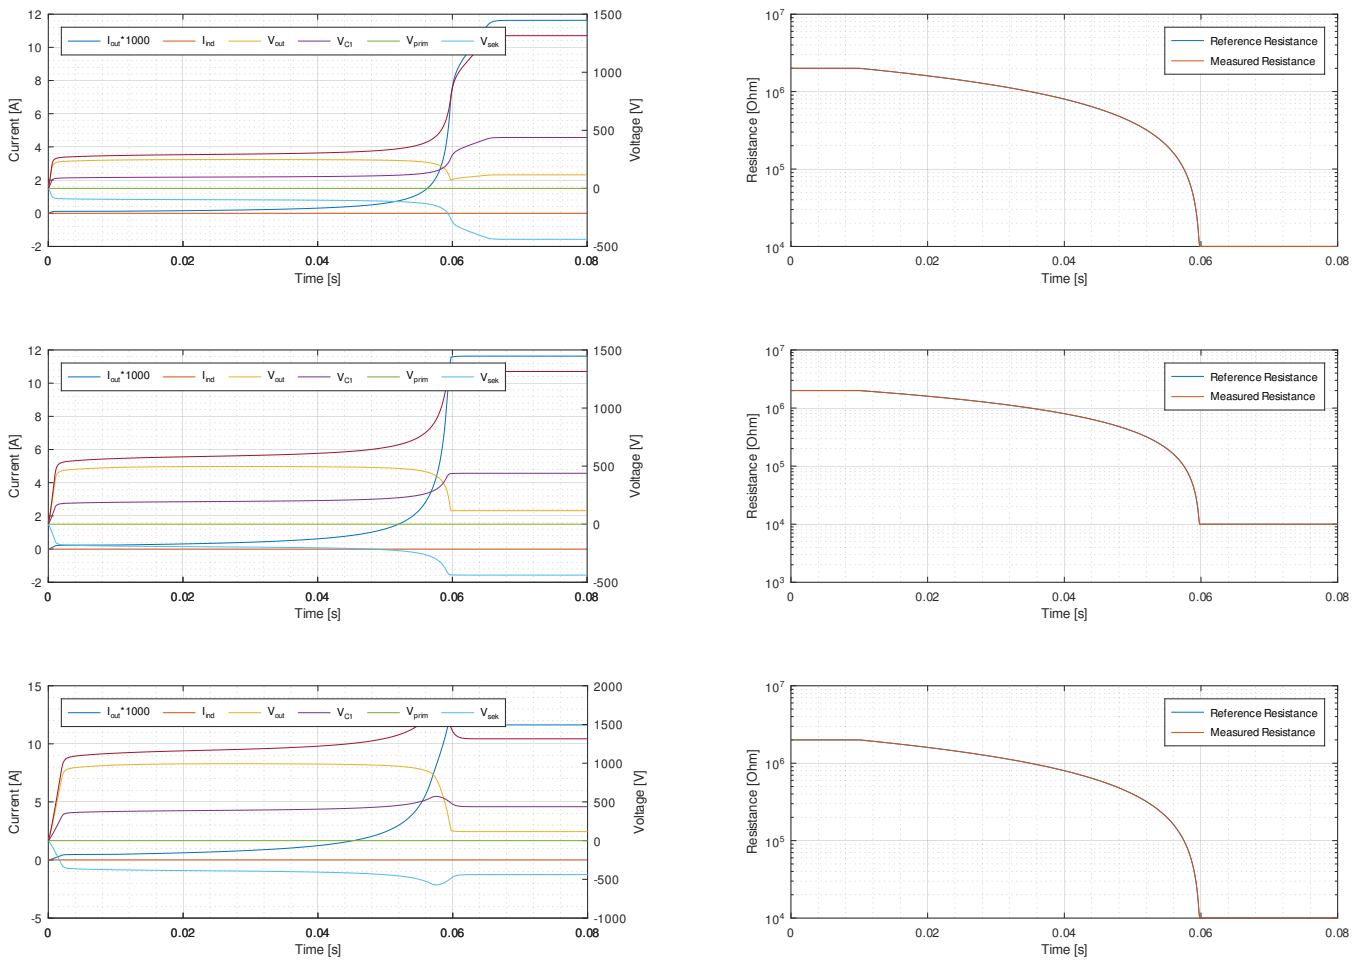
[picture p56: page 1]
Time [s]; Current [A]; Voltage [V]; Iout*1000; ind; Vout; Vp rim; Vsek; Resistance [Ohm]; Reference Resistance; Measured Resistance
