daniw/bat_source/doc/appendix/PS1-2BA_Schematic_2026-03-05.PDF

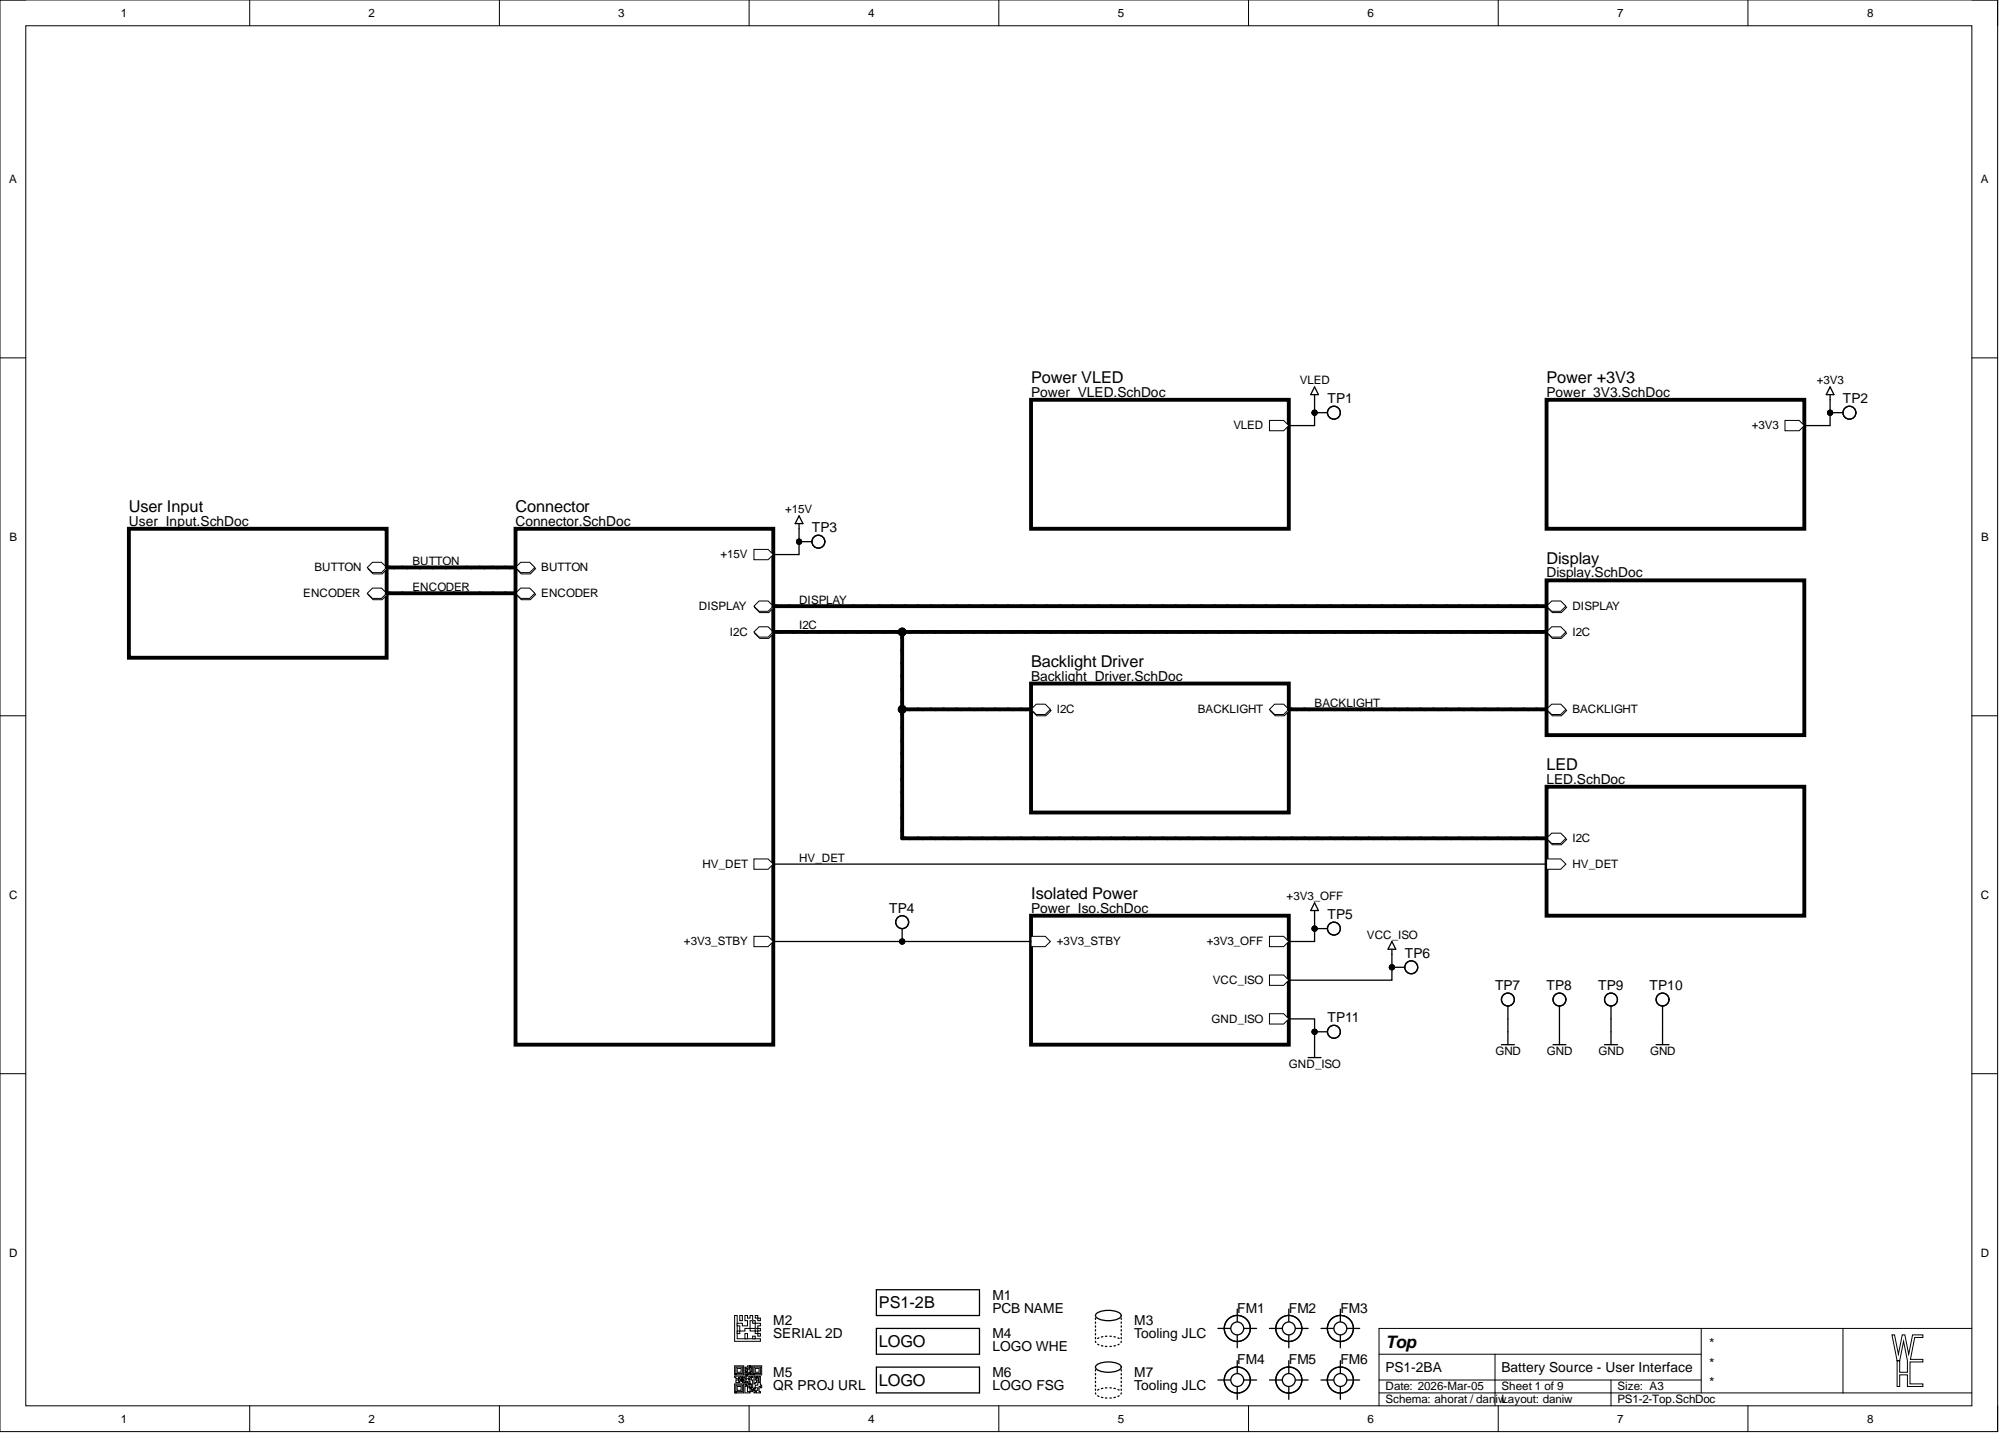
[picture p57: page 1]

2026-Mar-05
Schema: ahorat / daniwLayout: daniw

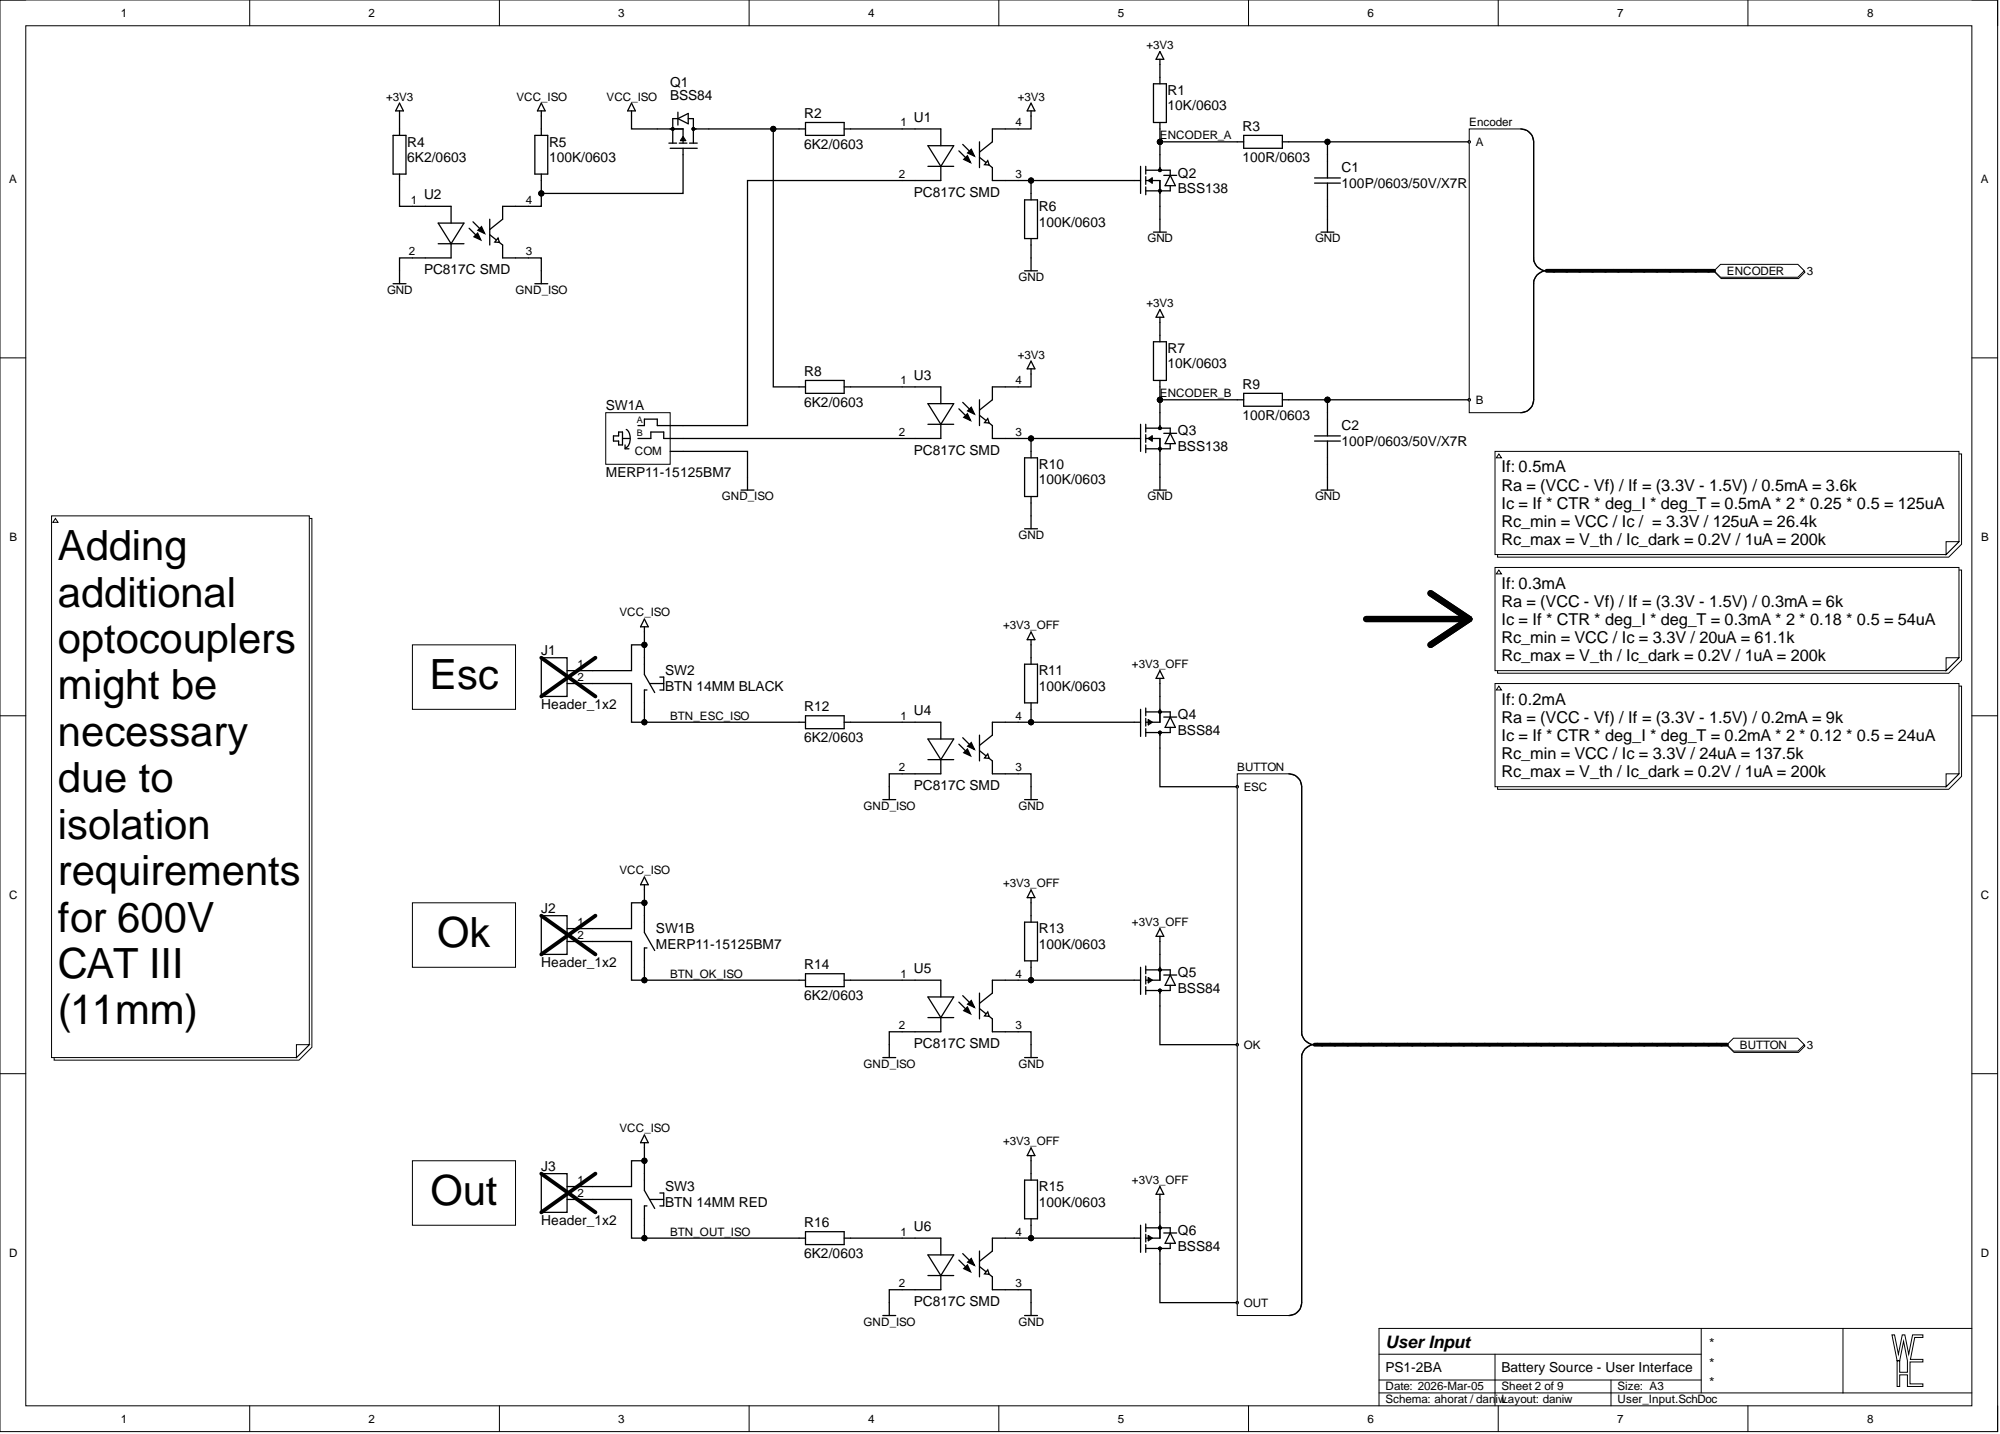
[picture p58: page 2]

Battery Source - User Interface

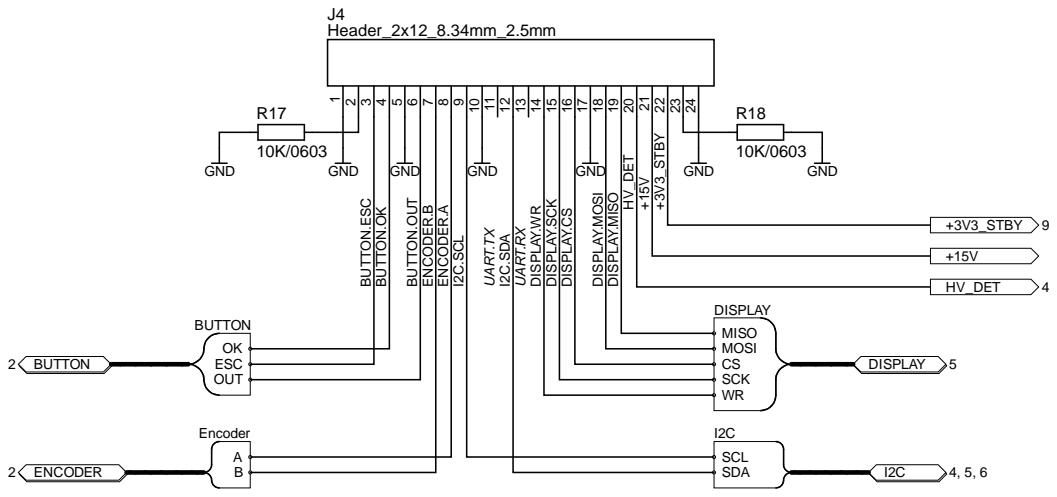
[picture p59: page 3]

Schema: ahorat / daniwLayout: daniw

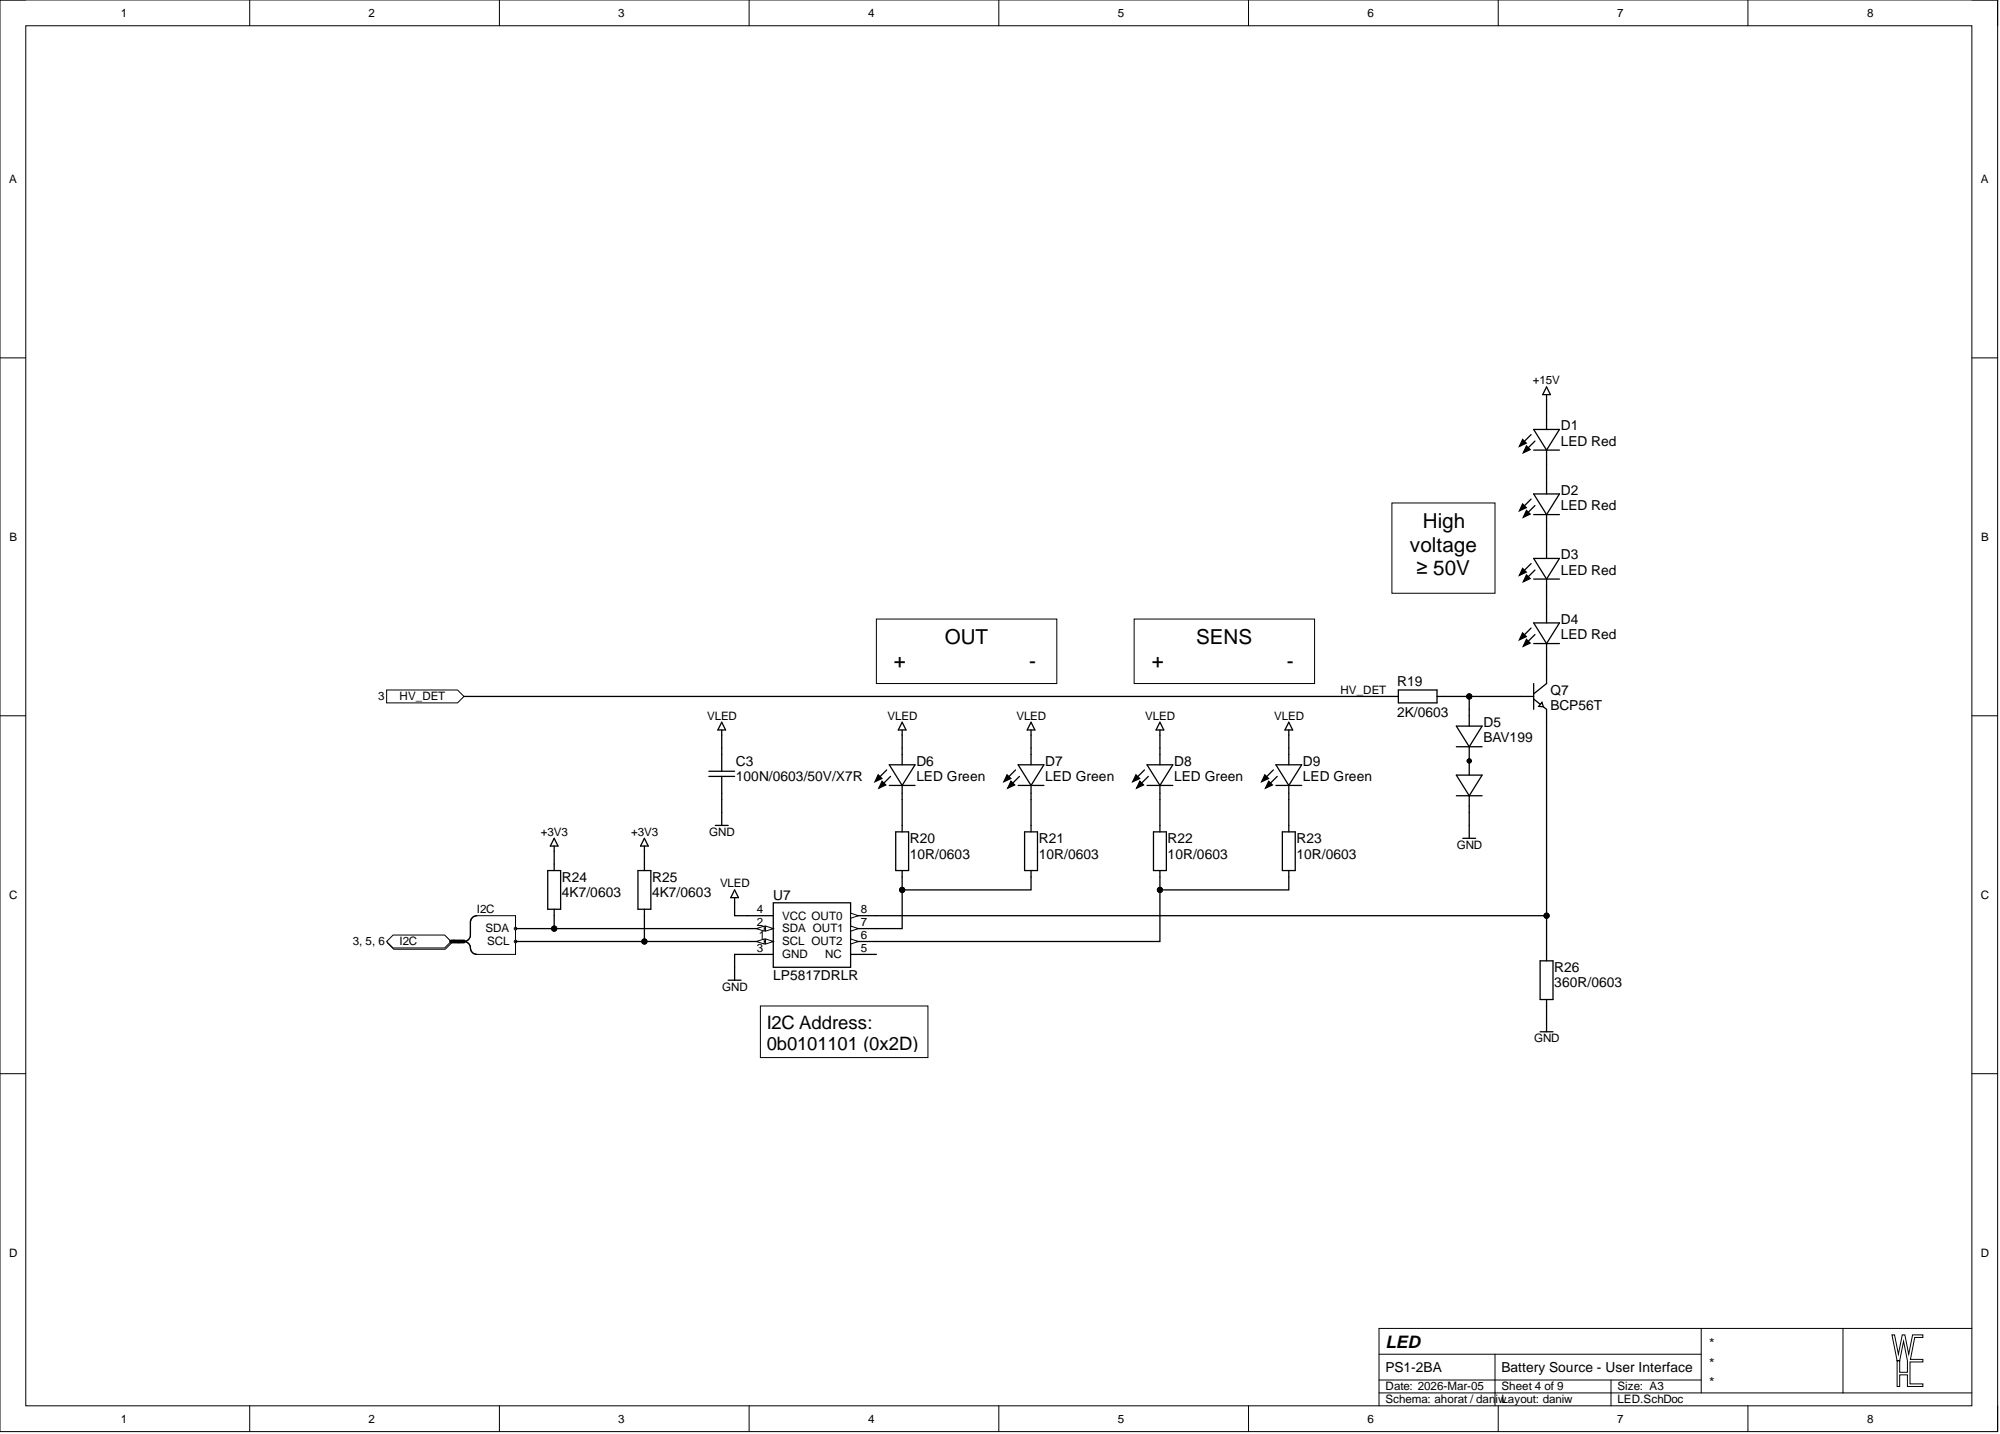
[picture p60: page 4]

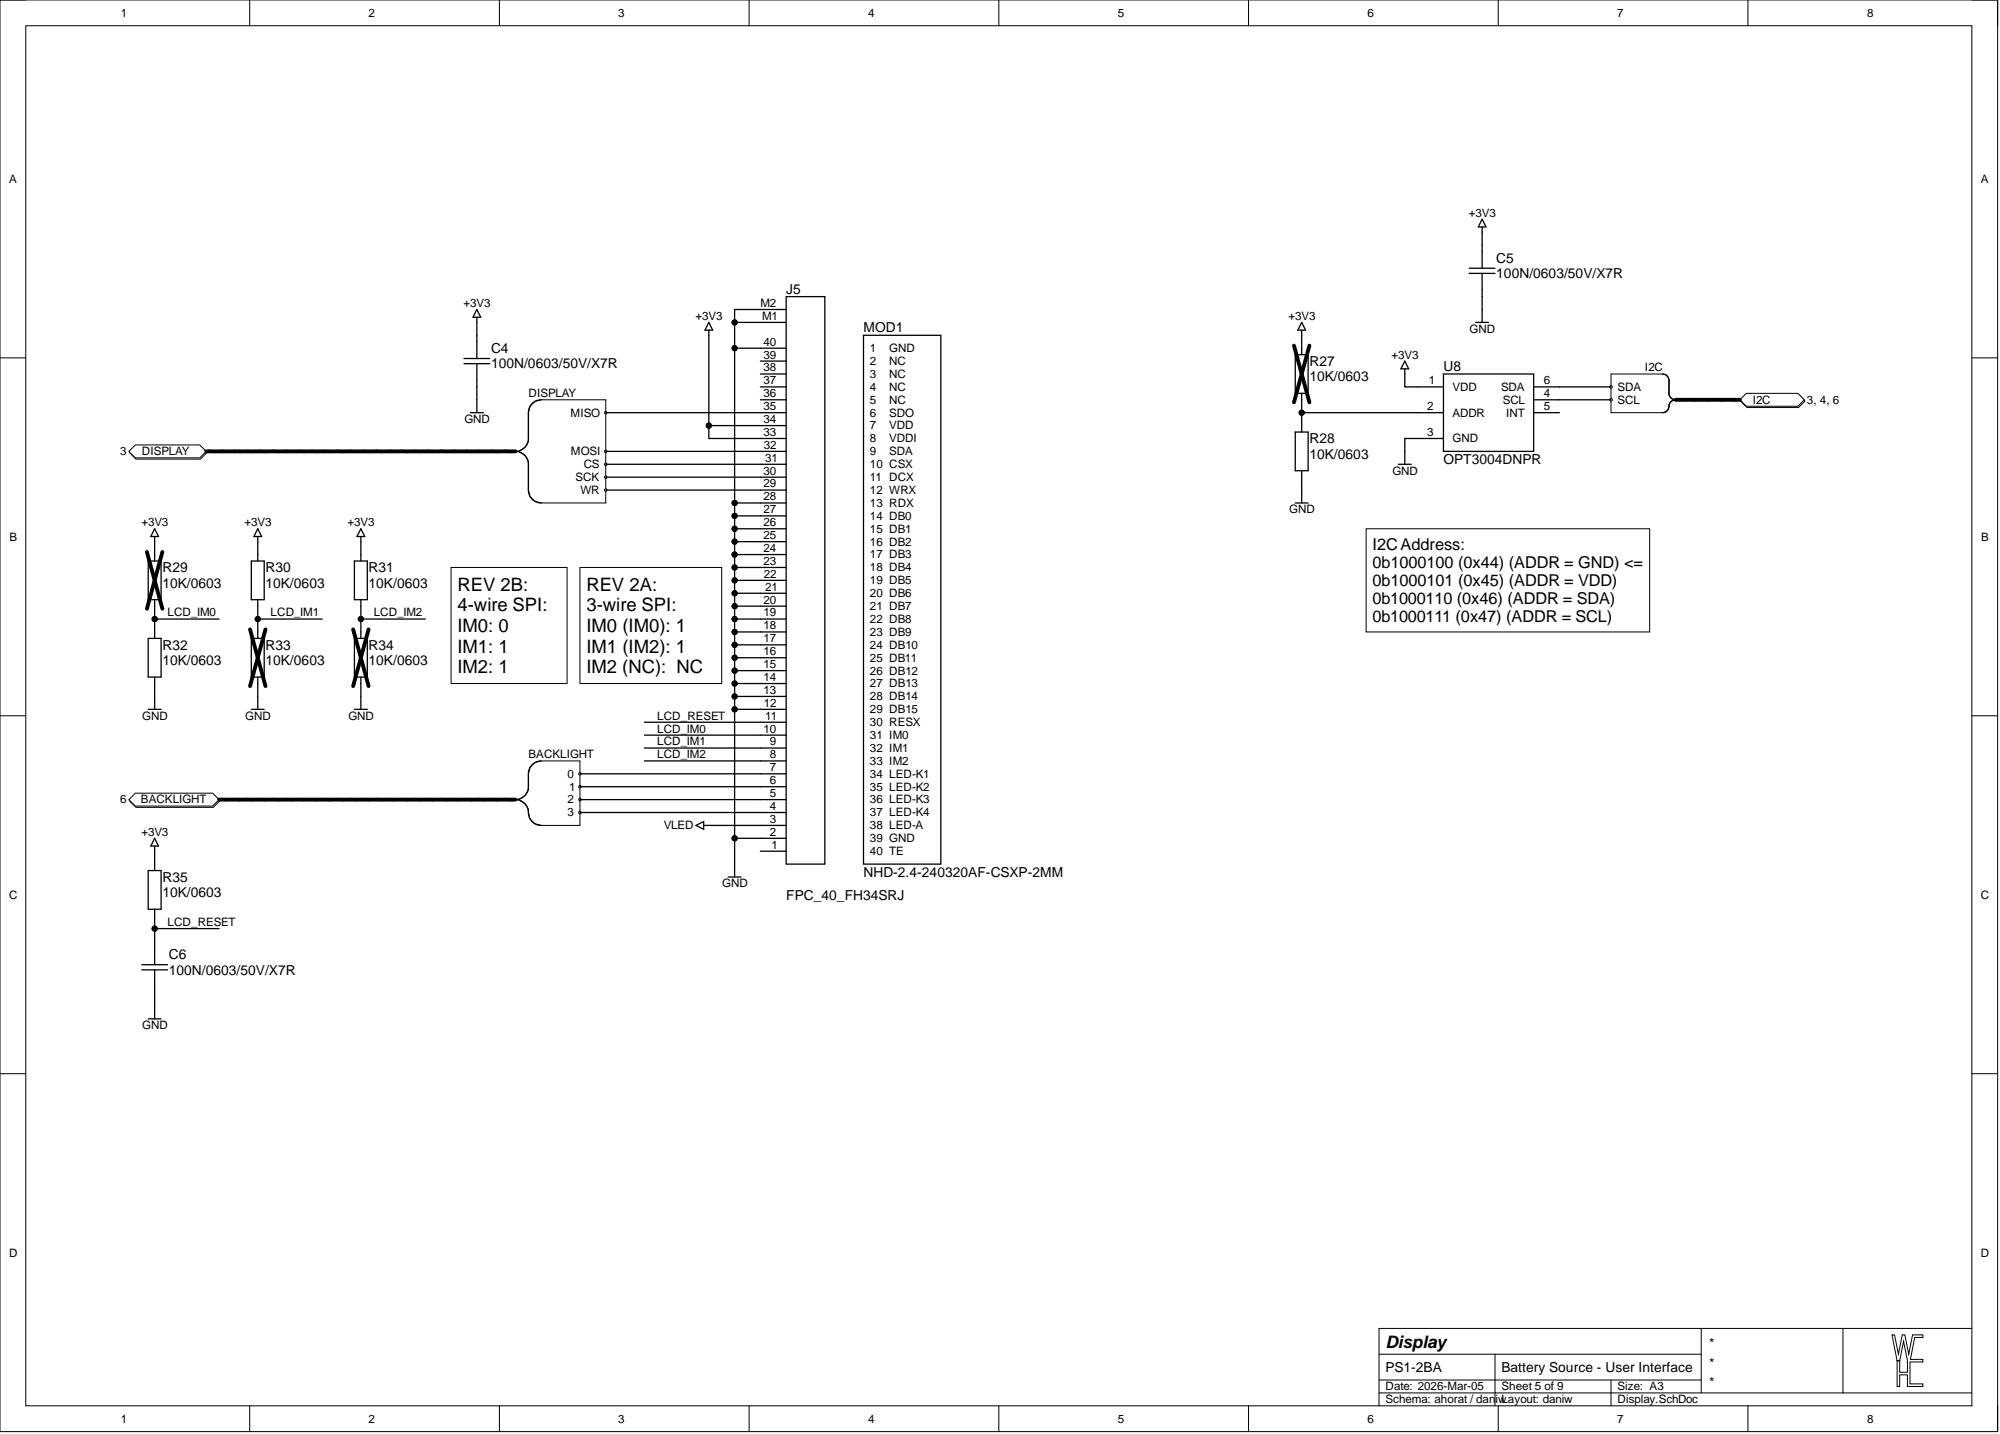
[picture p61: page 5]

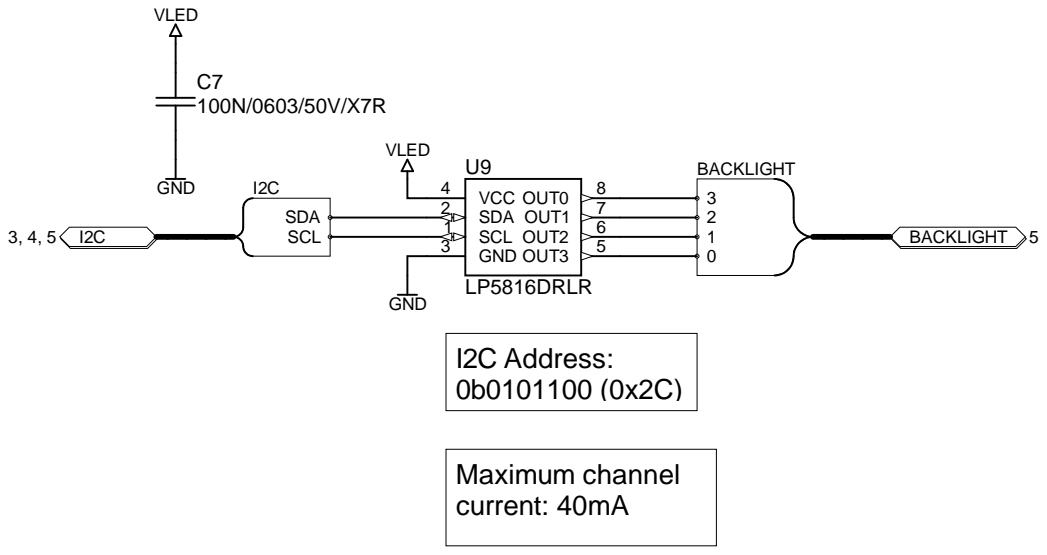
[picture p62: page 6]

Schema: ahorat / daniwLayout: daniw

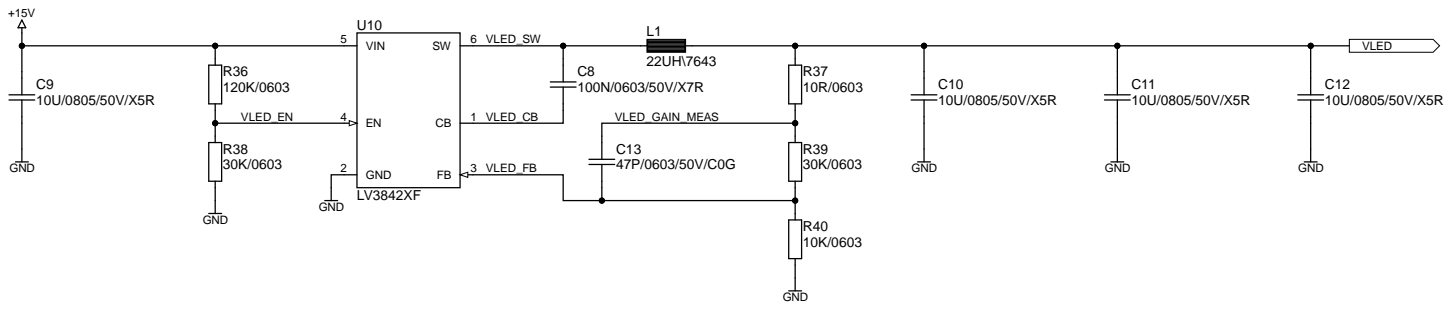
[picture p63: page 7]

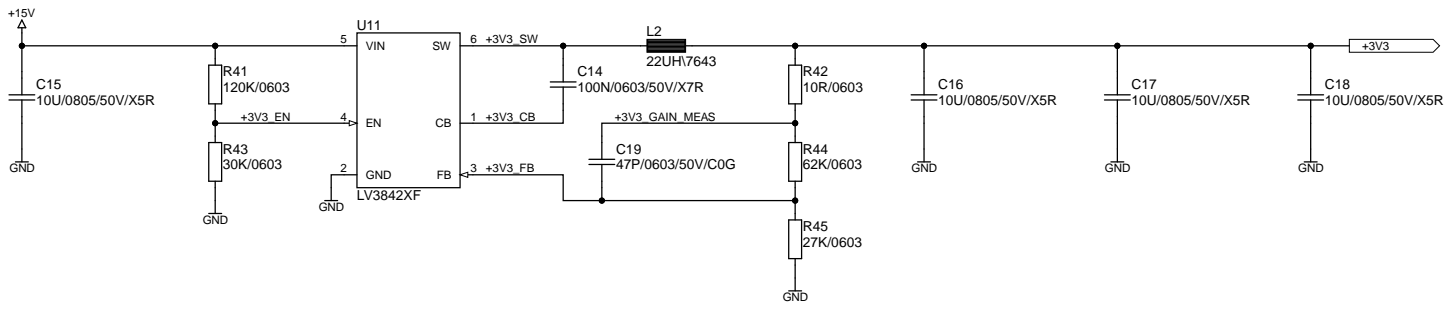
[picture p64: page 8]

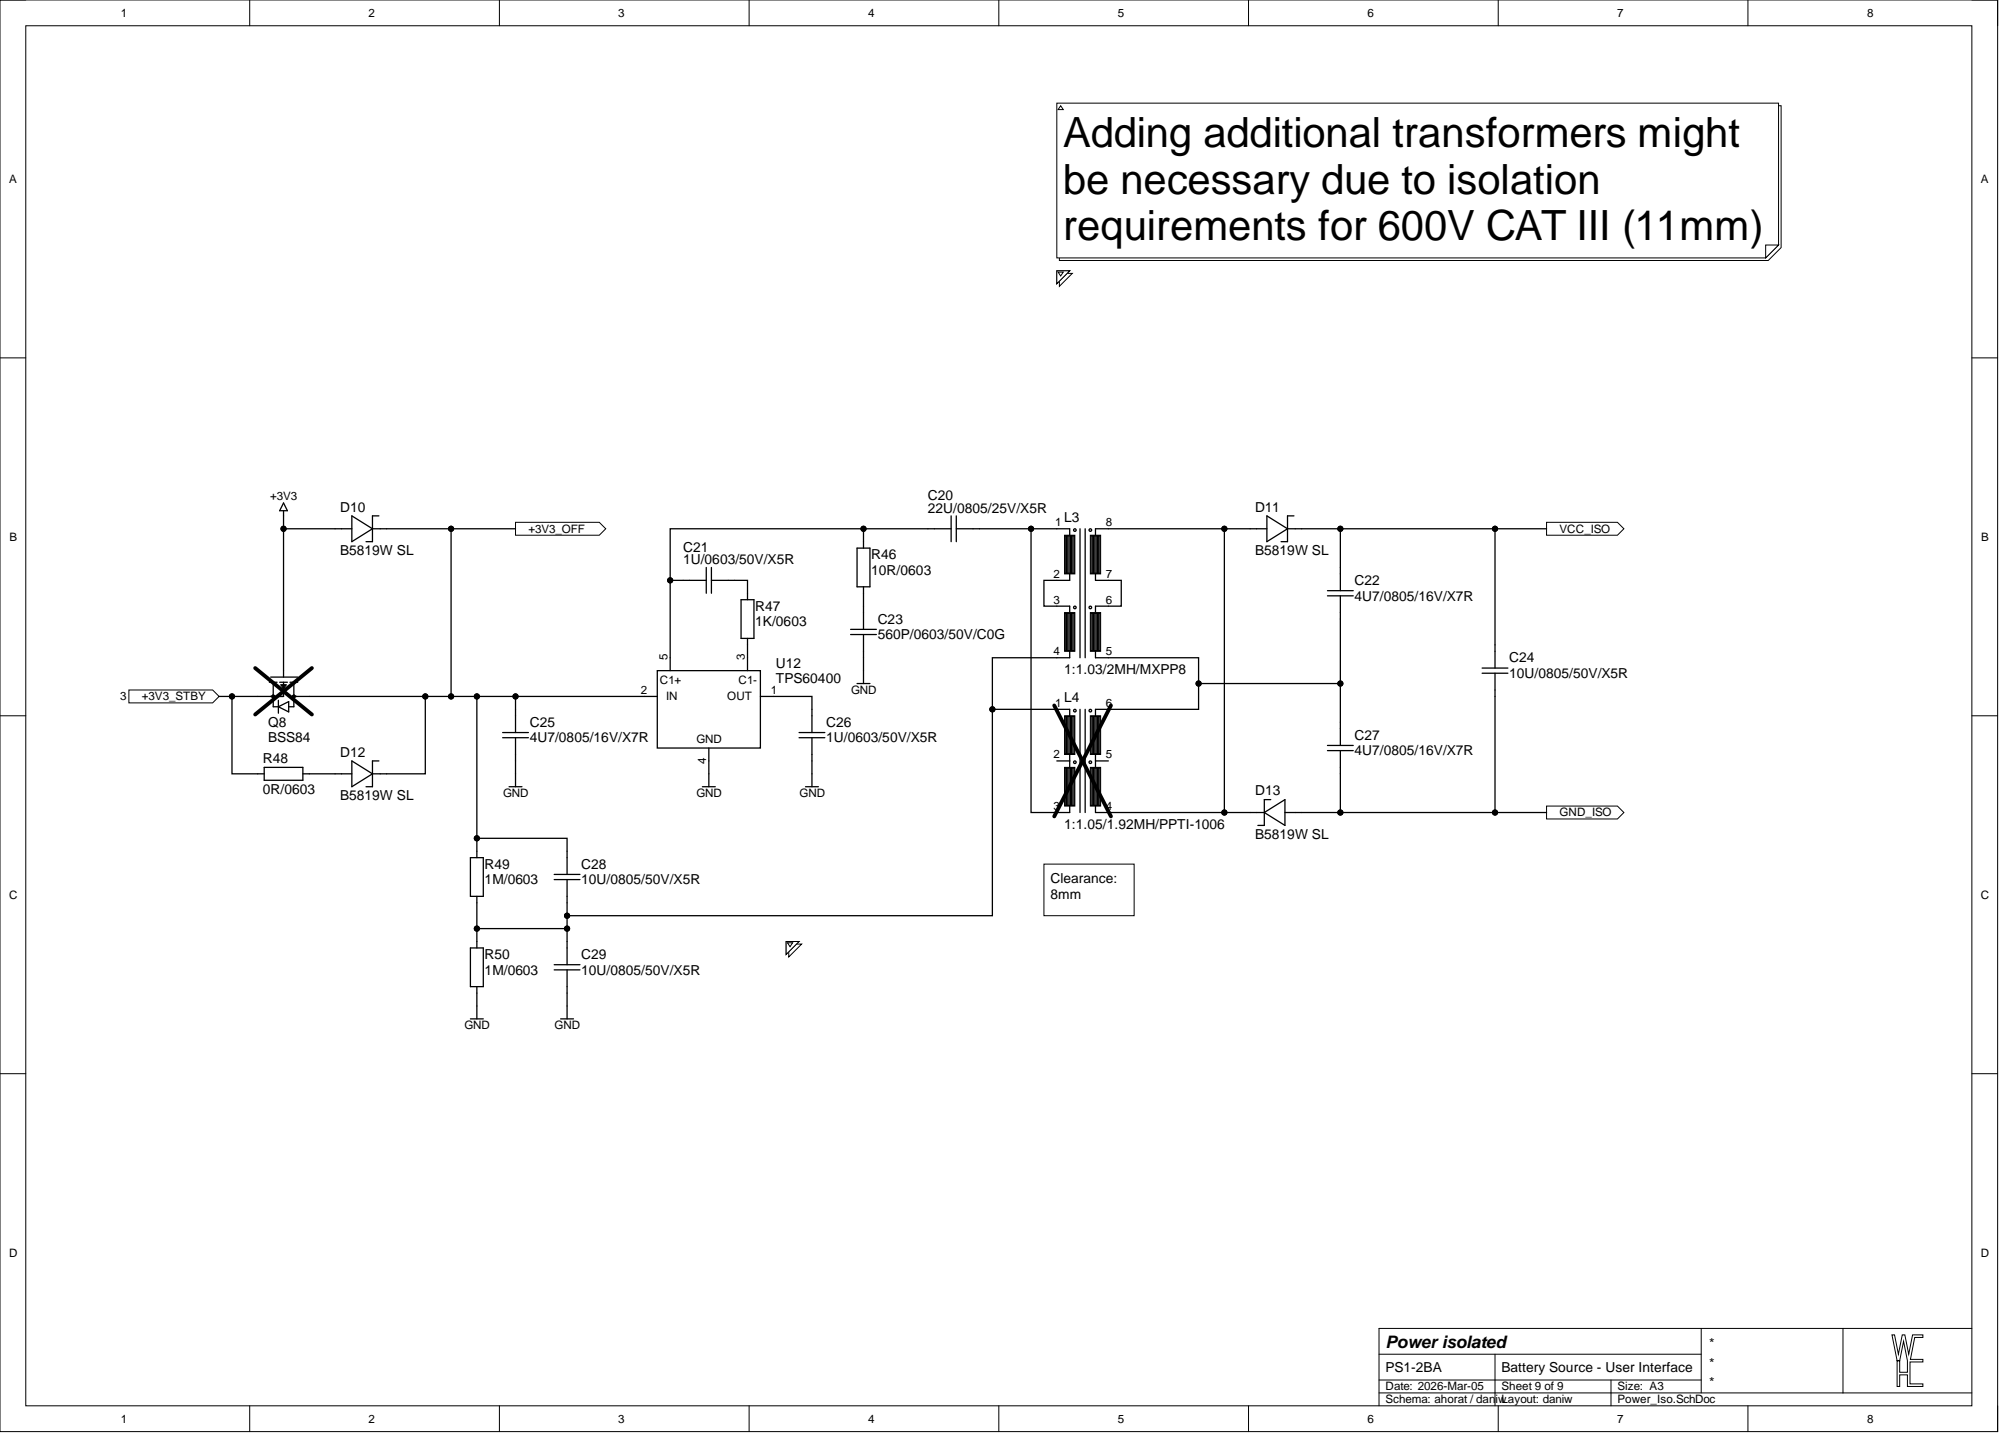
[picture p65: page 9]

Adding additional transformers
be necessary due to isolation
requirements
