daniw/bat_source/doc/appendix/PS1-2AA_Schematic_2025-06-30.PDF

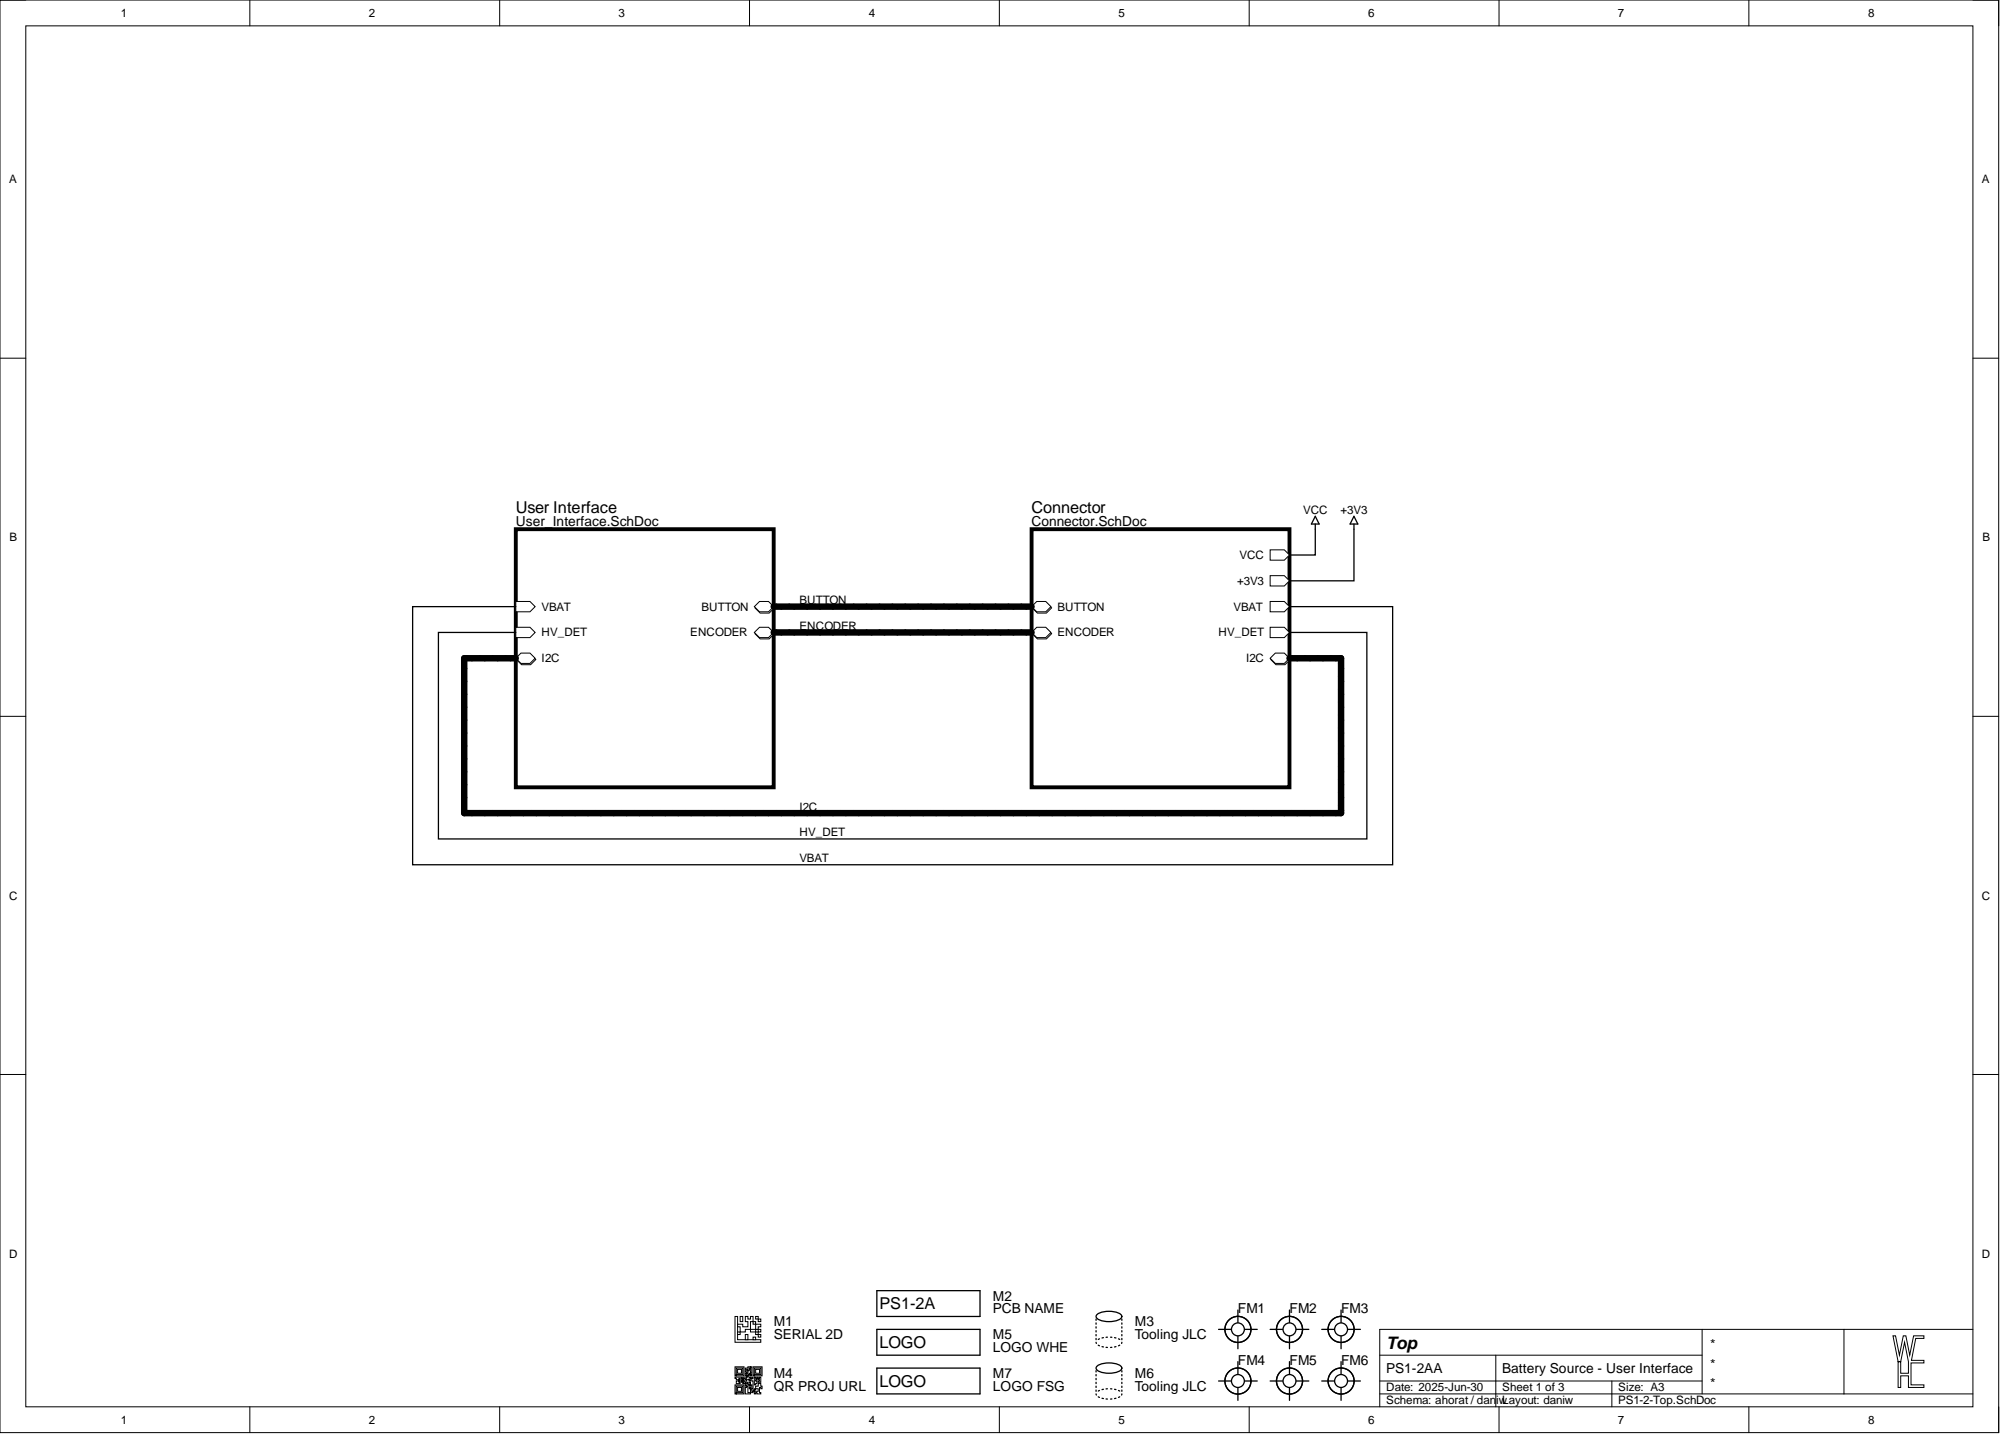
[picture p66: page 1]

2025-Jun-30
Schema: ahorat / daniwLayout: daniw

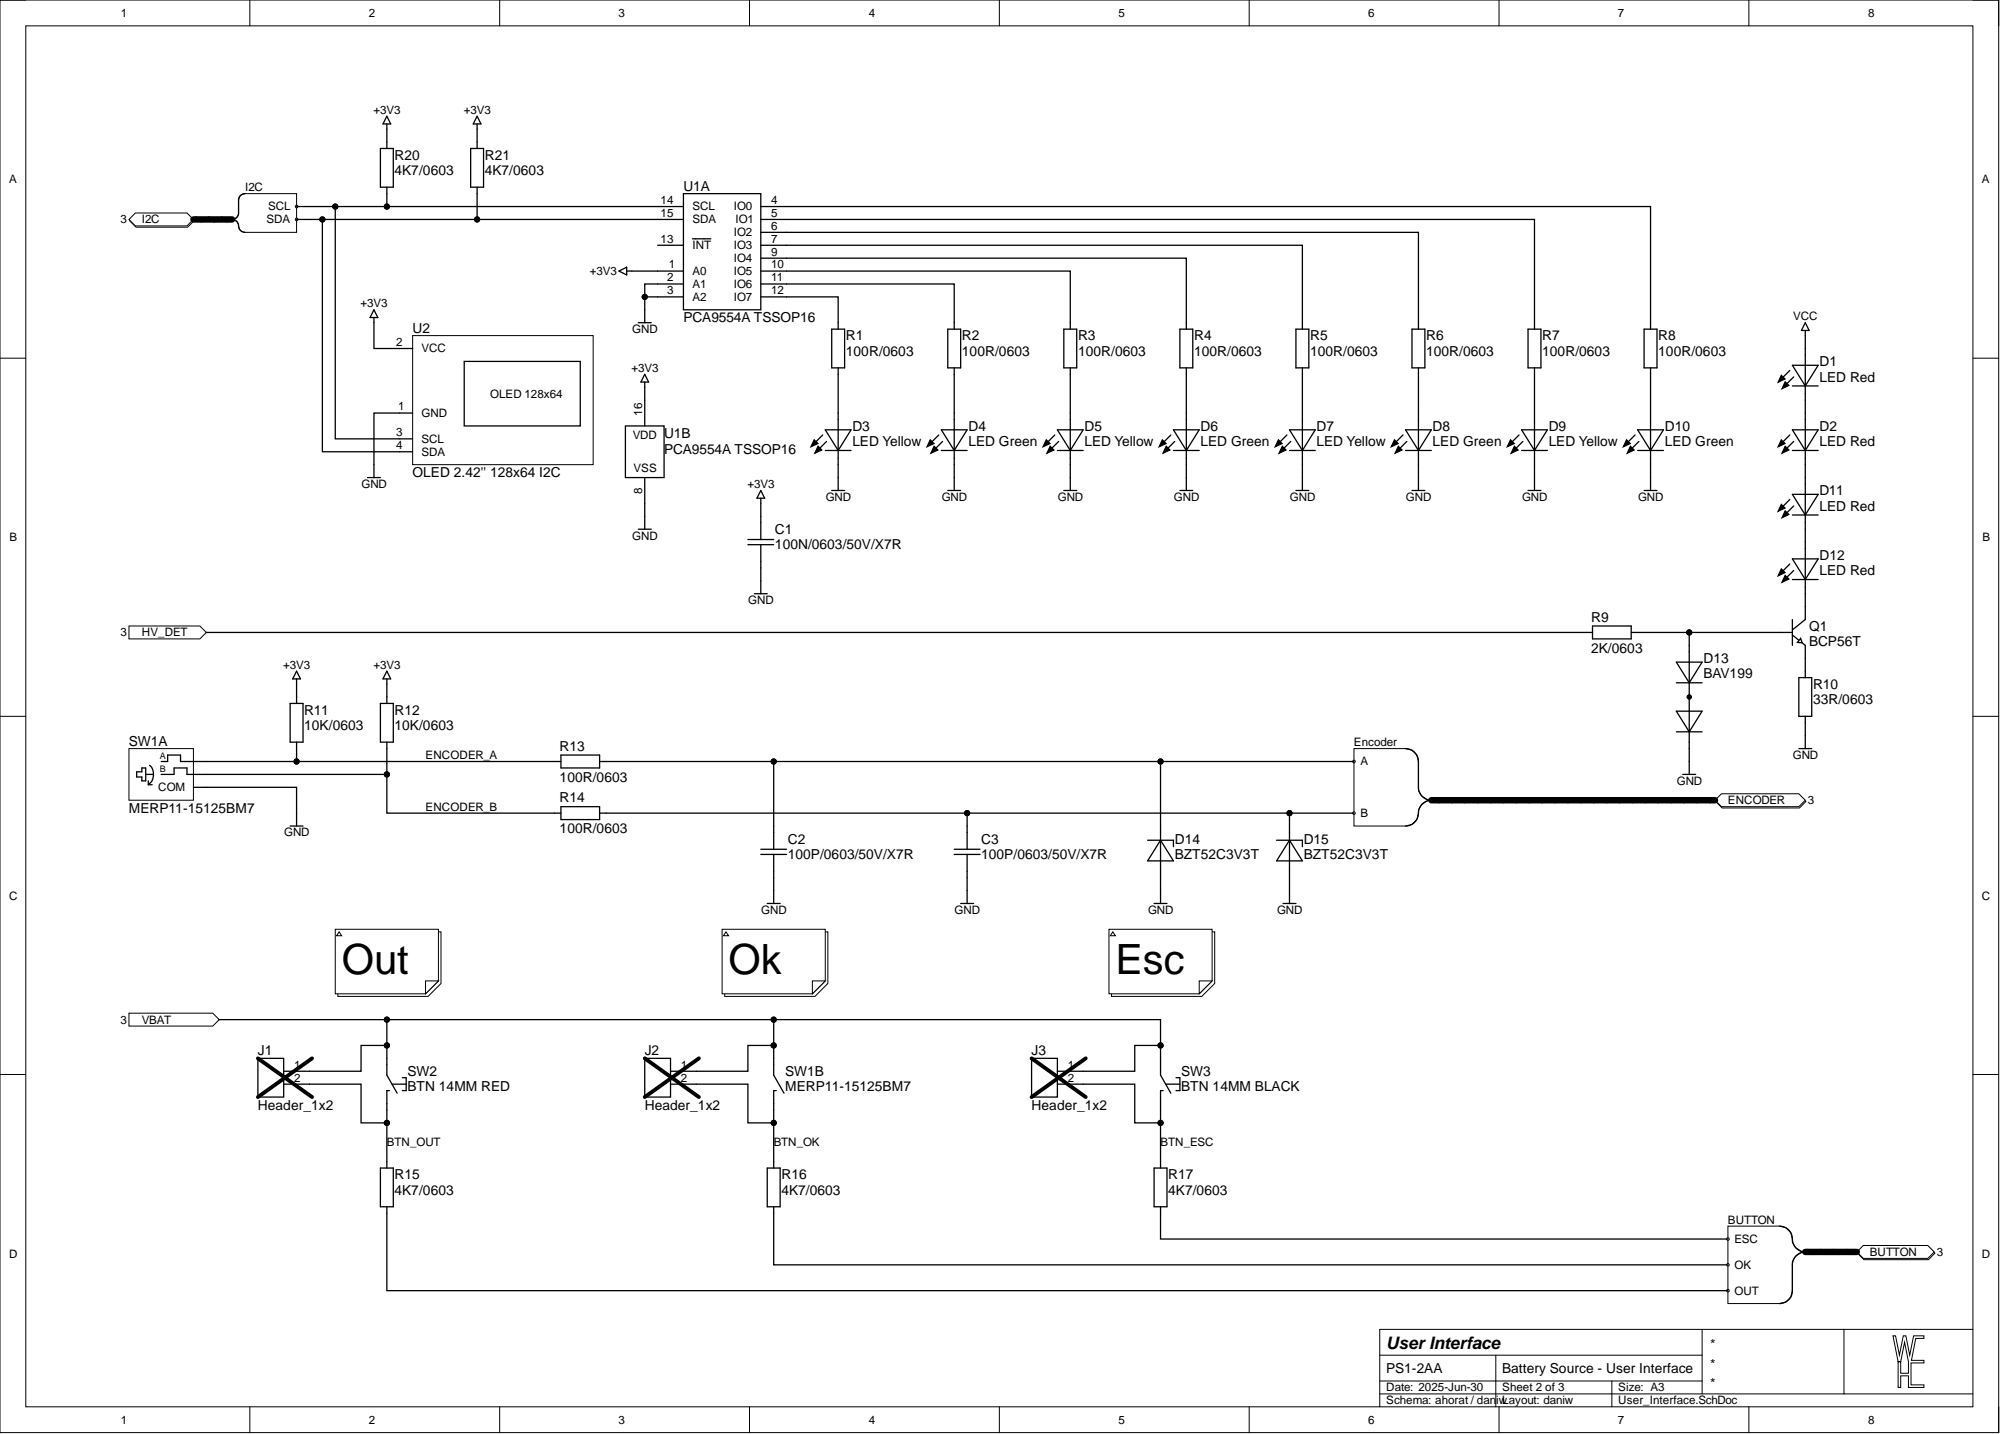
[picture p67: page 2]

VCC 2

SCL 3
SDA 4

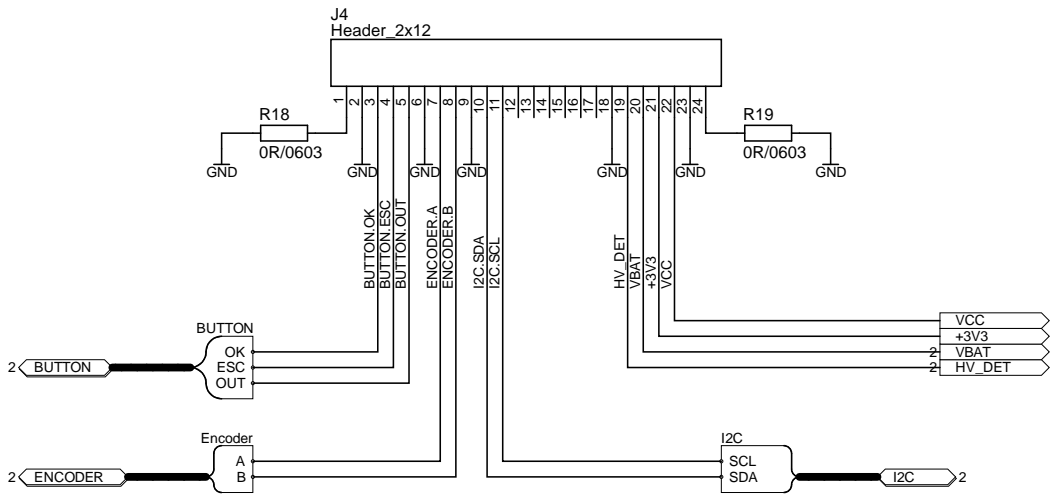
[picture p68: page 3]
