daniw/bat_source/hw/sim/1A_Controller_MOSFET.asc

C1: cap; {C1}
C2: cap; 4.7p
C3: cap; 4.7p
C4: cap; 1n
C5: cap; {C5}
C6: cap; {C6}
C7: cap; {C7}
C8: cap; 10p
C9: cap; 1µ
D1: diode; 1N4148
E1: e; 8.6667
M1: nmos; SUD40N10-25
R1: res; 0.005
R2: res; 0.1
R3: res; 100
R4: res; 10k
R5: res; 110k
R6: res; {R6}
R7: res; 1k
R8: res; 10k
R9: res; 10Meg
R10: res; 100
R11: res; 2k
R12: res; 10k
R13: res; 0
R14: res; 100k
R15: res; 530
R16: res; {R16}
S1: sw; MySwitch
U1: OPAx197
U2: OPAx197
U3: LT1211
U4: OPAx197
V1: voltage; PWL(0 0 1m 2 2m 2 3m 5 5m 5 5.1m 7); Rser=0.5
V2: voltage; 15
V3: voltage; PWL(0 0 1m 0 1.001m {V_REF} 2m {V_REF} 3.9m {V_REF} 4m 0 4.4m 0 4.5m {V_REF} 6m {V_REF} 6.001m {1.1*V_REF} 6.1m {1.1*V_REF} 6.101m {V_REF})
V4: voltage; PWL(0 5 8m 5 8.001m 0 9m 0 9.002m 5)
V5: voltage; PWL(0 0 7m 0 7.001m 10m 7.1m 10m 7.101m 0)
V6: voltage; 1
Named nets: 0, OUT_P, REF, SNS, OUT_N, G, I, REF_V, V, e, I_OUT, VCC, SW_CTRL
.tran 10m
.model MySwitch SW(Ron=1m Roff=1Meg Vt=0.5 Vh=-.1)
.param R16=table(n, 1, 3g, 2, 1k)
.param C1=table(n, 1, 1n, 2, 1n)
.param C5=table(n, 1, 1p, 2, 470p)
.step param n 1 2 1
.param R6=table(n, 1, 75k, 2, 75k)
.param V_REF=0.52
.param C6=table(n, 1, 1p, 2, 1p)
.param C7=table(n, 1, 1p, 2, 1000n)
