daniw/bat_source/hw/sim/OCP_latch.asc

C1: cap; 100p
C2: cap; 1µ
D1: diode
D5: diode
R1: res; 100k
R2: res; 100k
R3: res; 1Meg
R4: res; 10k
R5: res; 100k
R7: res; 200k
R8: res; 330k
R9: res; 1Meg
R10: res; 10k
U1: TLV314
U2: TLV314
V1: voltage; PULSE(0 3.3 1m 1u 1u 100 200)
V2: voltage; 1.25
V3: voltage; PULSE(0 2 35m 10m 10m 10m 100m 4)
Named nets: 0, OCP, OCP_REF, I_ISO, COMP
.tran 200m
