daniw/bat_source/hw/sim/UI_Iso_Supply.asc

C1: cap; 10µ
C2: cap; 10µ
C3: cap; 100n
C4: cap; 10µ
C5: cap; 100n
D4: diode; BAT54
D5: diode; BAT54
I1: load; PWL(0 0 51m 0 52m 1m 70m 100u 71m 0)
I2: load; PULSE(0 1m 100m 100m 1n 1n 200m)
L1: ind; 1.92m; Rser=0.92
L2: ind; 2.016m; Rser=0.87
L3: ind; 3.8; Rser=115
L4: ind; 3.8; Rser=115
L5: ind; 3.2m; Rser=2
L6: ind; 3.2m; Rser=2
L7: ind; 2m; Rser=400m
L8: ind; 2.06m; Rser=450m
R1: res; 1Meg
R2: res; 1Meg
R3: res; 10Meg
V1: voltage; 3.3
V2: voltage; PULSE(0 3.3 50m 10n 10n 16.7u 33.3u 6006)
V3: voltage; PULSE(0 3.3 250m 10n 10n 10u 20u 10000)
V4: voltage; PULSE(0 3.3 450m 10n 10n 5u 10u 20000)
V5: voltage; PULSE(0 3.3 650m 10n 10n 2.5u 5u 40000)
V6: voltage; PULSE(0 3.3 850m 10n 10n 2u 4u 50000)
Named nets: 0, V_ISO, SW
K1 L1 L2 1
.tran 1000m
K2 L3 L4 1
K3 L5 L6 1
WE 750317829
Bourns SM-LP-5001
Murata DA103J
K4 L7 L8 1
Maxinmicro MXPP8-30-1103
