daniw/bat_source/hw/sim/UI_Iso_Supply_555.asc

C1: cap; 10n
C2: cap; 10n
C3: cap; 100n
C4: cap; 10µ
C5: cap; 100n
D1: diode; BAT54
D2: diode; BAT54
D3: diode; BAT54
D4: diode; BAT54
D5: diode; BAT54
I1: load; PWL(0 0 150m 0 500m 10u 500.1m 0 550m 0 900m 1m)
R1: res; 1Meg
R2: res; 470
R3: res; 10Meg
R4: res; 10k
R5: res; 33
T1: WE-STST
U1: NE555
V1: voltage; PULSE(0 3.3 100m 1m 1m 800m 1)
V2: voltage; PULSE(0 3.3 500m 1m 1m 400m 1)
Named nets: 0, V_STBY, 3V3, V_ISO
.tran 1.1
