daniw/bat_source/hw/sim/UI_Iso_Supply_Selector.asc

C1: cap; 10µ
D1: diode; BAT54
D2: diode; 1N4148
D3: diode; BAT54
M1: pmos; BSS84
R1: res; 2.2k
S1: sw; MYSW
S2: sw; MYSW
V1: voltage; PULSE(0 3.3 50m 10m 10m 200m 400m)
V2: voltage; PULSE(0 3.3 100m 10m 10m 100m 200m)
V3: voltage; PULSE(1 -1 420m 1m 1m 399m 800m)
Named nets: 0, +3V3, +3V3_STBY, +3V3_OFF, SW_CTRL
.tran 1
.model MYSW SW(Ron=1m Roff=1g Vt=0 Vh=0.1)
