daniw/bat_source/hw/sim/Iso_Current_Limit.asc

D1: diode; DI_DDZ9700
D2: diode; DI_DDZ9700
M1: nmos; IXTP3N120
R1: res; 10k
R2: res; 10Meg
R3: res; 10Meg
R4: res; 1k
R5: res; 10k
S1: sw; MYSW
V1: voltage; PULSE(0 1000 0 90m 3m 3m 100m 3)
V2: voltage; PULSE(0 1 99m 1m 1m 99m 300m 1)
V3: voltage; PULSE(0 1 200m 1n 1n 5u 5m 20)
V4: voltage; PULSE(0 1000 300m 900m 3m 3m 1000m 1)
Named nets: 0, HV, OUT_HV, CTRL, Gate, Source
.model MYSW SW(Ron=1m Roff=100Meg Vt=.5 Vh=-.4)
.tran 1300m
.LIB DDZ9700.spice.txt
.LIB IXTP3N120.lib
