daniw/bat_source/hw/sim/on-off_controller_precharge.asc

C2: cap; 1µ
C3: cap; 1µ
C4: cap; 100µ
D4: diode; 1N4148
D5: diode; 1N4148
D6: diode; 1N4148
D7: diode; 1N4148
D8: diode; 1N4148
M1: nmos; BSS123
M2: nmos; BSS123
M3: pmos; FDS4435A
M4: pmos; BSS84
M5: pmos; FDS4435A
M6: nmos; BSS123
M7: nmos; BSS123
M8: pmos; BSS84
Q1: pnp; BC857A
R1: res; 10k
R2: res; 100k
R3: res; 100k
R4: res; 10k
R5: res; 1m
R6: res; 100k
R7: res; 270
R8: res; 100k
R9: res; 100k
R10: res; 1Meg
R11: res; 1Meg
R12: res; 10Meg
R13: res; 6.8Meg
R14: res; 100k
R15: res; 10
R16: res; 10k
R17: res; 100k
U1: LTC1841
V1: voltage; PWL(0 0 1m 0 2m 10 10000m 10 20001m 18 30000m 18); Rser=10m
V2: voltage; PWL(0 0 10m 0 11m 10 8000m 10 8001m 0 20010m 0 20011m 18 28000m 18 28001m 0); Rser=10
V3: voltage; PWL(0 0 2m 0 3m 10 4m 10 5m 0 9000m 0 9001m 10 9002m 10 9003m 0 20002m 0 20003m 18 20004m 18 20005m 0 29000m 0 29001m 18 29002m 18 29003m 0); Rser=10
V4: voltage; PWL(0 0 3m 0 4m 3.3 7500m 3.3 7501m 0 9001m 0 9002m 3.3 9903m 3.3 9904m 0 20003m 0 20004m 3.3 27500m 3.3 27501m 0 29001m 0 29002m 3.3 29903m 3.3 29904m 0); Rser=10
Named nets: 0, VIN, VBAT, BTN_OFF, BTN_ON, ON_REQ, THR, COMP_SUP, TMR_COMP
.tran 30
