daniw/bat_source/hw/sim/DCLink Gatedriver.asc

B1: bv; V=V(EN)*V(PWM)
C1: cap; 100p
C2: cap; 1n
C3: cap; 10n
D1: schottky; 1N5819
D2: schottky; 1N5819
R1: res; 1Meg
R2: res; 1
V1: voltage; PULSE(0 8 10m 50n 50n 10u 20u)
V2: voltage; PULSE(0 6 100m 1m 1m 100m 200m)
V3: voltage; PULSE(0 1 10m 100n 100n 10m 20m)
Named nets: 0, DCLINK, GATE, GATEDRIVER, PWM, EN
.tran 500m
