daniw/bat_source/hw/sim/LED_HV_Det.asc

D1: diode; BAV199HM
D2: diode; BAV199HM
D3: LED; QTLP690C
D4: LED; QTLP690C
D5: LED; QTLP690C
D6: LED; QTLP690C
I1: load2; PULSE(100u 51m 0 40m 1m 9m 50m); load
Q1: npn; UMT3904
R1: res; 2k
R2: res; 0
R3: res; 360
V1: voltage; PWL(0 8 49m 8 50m 8.5 99m 8.5 100m 9 149m 9 150m 9.5 199m 9.5 200m 10 249m 10 250m 11 299m 11 300m 12 349m 12 350m 13 399m 13 400m 14 449m 14 450m 15 499m 15)
V2: voltage; PULSE(0 3.3 0 100u 100u 2m 4m)
Named nets: 0, VCC, HV_DET
.tran 0.5
