daniw/bat_source/hw/sim/1A_Controller_MOSFET_Andreas.asc

C1: cap; 10n
C2: cap; 100p
C3: cap; 10p
C4: cap; 1µ
C5: cap; 0
D1: diode
M1: nmos; IRFP240
R1: res; 0.01
R2: res; 0.1
R3: res; 1k
R4: res; 1k
R5: res; 99k
R6: res; 10k
R7: res; 1k
R8: res; 10k
R9: res; 10k
R10: res; 1
R11: res; 1Meg
R12: res; 0
R13: res; 20k
S1: sw; MySwitch
U1: LT1211
U2: LT1211
U3: LT1211
V1: voltage; PWL(0 0 1m 5 5m 5 5.1m 7)
V2: voltage; 10
V3: voltage; PWL(0 0 1m 0 2m 1)
V4: voltage; PWL(0 5 7m 5 7.001m 0 90m 0 90.000001m 5)
V5: voltage; 0
V6: voltage; 4
Named nets: 0, VCC, REF, SNS, OUT, B, I, REF_V, V, e
.tran 100m
.model MySwitch SW(Ron=.1 Roff=1Meg Vt=0.5 Vh=-.1)
