daniw/bat_source/hw/sim/1A_Controller_NPN.asc

C1: cap; 1n
C2: cap; 100p
C3: cap; 100p
Q1: npn; ZTX1048A
R1: res; 0.01
R2: res; 0.1
R3: res; 1k
R4: res; 20k
R5: res; 180k
R6: res; 10k
R7: res; 1k
S1: sw; MySwitch
U1: OP777
U2: OP777
V1: voltage; PWL(0 0 1m 5 5m 5 5.1m 7)
V2: voltage; 3.3
V3: voltage; PWL(0 0 1m 0 2m 0.1)
V4: voltage; PWL(0 5 7m 5 7.001m 0 8m 0 8.000001m 5)
Named nets: 0, VCC, REF, SNS, OUT, B
.tran 10m
.model MySwitch SW(Ron=.1 Roff=1Meg Vt=0.5 Vh=-.1)
