daniw/bat_source/hw/sim/meas_input.asc

R1: res; 10Meg
R2: res; 10Meg
R3: res; 10.1k
R4: res; 10k
V1: voltage; SINE(0 10 1k 0)
V2: voltage; SINE(0 1000 100 0)
Named nets: 0, MEAS_P, MEAS_N, AMP_P, AMP_N
.tran 0 10m 0 1u
