daniw/bat_source/hw/sim/Charger_int_sup_prot.asc

C1: cap; 1µ; Rser=0.01
C2: cap; 1µ
C3: cap; 100n
D1: zener; BZX84C36VL
D2: zener; BZX84C6V2L
D3: diode; 1N4148
D4: zener; BZX84C27VL
D5: zener; BZX84C6V2L
D6: zener; BZX84C6V2L
D7: diode
I1: load2; .2; load
M1: nmos; STW11NM80
M2: pmos; FDS4685
M3: pmos; FDS4685
M4: nmos; BSS123
M5: nmos; BSS123
M6: nmos; BSS123
Q1: npn; BC846B
R1: res; 1Meg
R2: res; 100k
R3: res; 100k
R4: res; 1Meg
R5: res; 100k
R6: res; 2
R7: res; 10k
R8: res; 10k
R9: res; 5.2k
R10: res; 10k
R11: res; 470
R12: res; 470
U1: LT1018
U2: LT1018
U3: ADP7142-5.0
V1: voltage; PWL(0 0 1m 0 7m 100 8m 600 9m 0 10m 600 11m 0 20m 60)
V2: voltage; PULSE(0 3.3 12m 1n 1n 250u 500u)
Named nets: 0, OUTPUT, SUP_3V3, OVP, OVP_REF, VMEAS, UVLO, UVLO_REF, PROT, VCC
.tran 20m
