daniw/bat_source/(list of files, drawings)

Other design files:
hw/PS1-1/PCB/PS1-1A-BASIS.PcbDoc
hw/PS1-1/PCB/PS1-1B-PANEL.PcbDoc
hw/PS1-1/PS1-1BA.PrjPcb
hw/PS1-1/SCH/Battery_BMS.SchDoc
hw/PS1-1/SCH/Converter.SchDoc
hw/PS1-1/SCH/Converter_HV.SchDoc
hw/PS1-1/SCH/Current_Controller.SchDoc
hw/PS1-1/SCH/Iso_Current_Limit.SchDoc
hw/PS1-1/SCH/Measurement.SchDoc
hw/PS1-1/SCH/Mechanics.SchDoc
hw/PS1-1/SCH/Microcontroller.SchDoc
hw/PS1-1/SCH/On_Off.SchDoc
hw/PS1-1/SCH/Output_Terminals.SchDoc
hw/PS1-1/SCH/Overcurrent_Protection.SchDoc
hw/PS1-1/SCH/Overvoltage_Protection.SchDoc
hw/PS1-1/SCH/Peripherals.SchDoc
hw/PS1-1/SCH/Power_3V3.SchDoc
hw/PS1-1/SCH/Power_5V.SchDoc
hw/PS1-1/SCH/Power_15V.SchDoc
hw/PS1-1/SCH/Power_Analog.SchDoc
hw/PS1-1/SCH/Power_VCC.SchDoc
hw/PS1-1/SCH/PS1-1-Top.SchDoc
hw/PS1-1/SCH/User_Interface.SchDoc
hw/PS1-2/PCB/PS1-2A-BASIS.PcbDoc
hw/PS1-2/PCB/PS1-2B-PANEL.PcbDoc
hw/PS1-2/PS1-2BA.PrjPcb
hw/PS1-2/SCH/Backlight_Driver.SchDoc
hw/PS1-2/SCH/Connector.SchDoc
hw/PS1-2/SCH/Display.SchDoc
hw/PS1-2/SCH/LED.SchDoc
hw/PS1-2/SCH/Power_3V3.SchDoc
hw/PS1-2/SCH/Power_Iso.SchDoc
hw/PS1-2/SCH/Power_VLED.SchDoc
hw/PS1-2/SCH/PS1-2-Top.SchDoc
hw/PS1-2/SCH/User_Input.SchDoc
hw/PS1-3/PCB/PS1-3A-BASIS.PcbDoc
hw/PS1-3/PCB/PS1-3A-PANEL.PcbDoc
hw/PS1-3/PS1-3AA.PrjPcb
hw/PS1-3/SCH/PS1-3-Top.SchDoc
hw/PS1-100/PCB/PS1-100A-BASIS.PcbDoc
hw/PS1-100/PCB/PS1-100A-PANEL.PcbDoc
hw/PS1-100/PS1-100AA.PrjPcb
hw/PS1-100/SCH/PS1-100-Top.SchDoc
hw/PS1-101/PCB/PS1-101A-BASIS.PcbDoc
hw/PS1-101/PS1-101AA.PrjPcb
hw/PS1-101/SCH/PS1-101-Top.SchDoc
hw/PS1-102/PCB/PS1-102A-BASIS.PcbDoc
hw/PS1-102/PS1-102AA.PrjPcb
hw/PS1-102/SCH/PS1-102-Top.SchDoc
hw/PS1-124/PCB/PS1-124A-BASIS.PcbDoc
hw/PS1-124/PS1-124AA.PrjPcb
hw/PS1-124/SCH/PS1-124-Top.SchDoc
hw/sim/IXTP3N120.OLB
