daniw/bat_source/sw/bat_source/bat_source.ioc

Mcu.UserName=STM32G474VETx
PA0.GPIO_Label=I_OUT
PA0.Signal=ADC1_IN1
PA1.GPIO_Label=V_TERM
PA1.Signal=ADC2_IN2
PA10.GPIO_Label=CONV_CTRL.PRIM_L
PA10.Signal=HRTIM1_CHB1
PA11.GPIO_Label=CONV_CTRL.PRIM_H
PA11.Signal=HRTIM1_CHB2
PA12.GPIO_Label=ADC.CLK
PA12.Signal=S_TIM16_CH1
PA13.GPIO_Label=SWD.SWDAT
PA13.Signal=SYS_JTMS-SWDIO
PA14.GPIO_Label=SWD.SWCLK
PA14.Signal=SYS_JTCK-SWCLK
PA15.GPIO_Label=SPI.CS
PA15.Signal=GPIO_Output
PA2.GPIO_Label=QSPI.CS/
PA2.Signal=QUADSPI1_BK1_NCS
PA3.GPIO_Label=QSPI.CLK
PA3.Signal=QUADSPI1_CLK
PA4.GPIO_Label=VREF/2_UC
PA4.Signal=COMP_DAC11_group
PA5.GPIO_Label=I_1A_REF
PA5.Signal=COMP_DAC12_group
PA6.GPIO_Label=QSPI.IO3
PA6.Signal=QUADSPI1_BK1_IO3
PA7.GPIO_Label=QSPI.IO2
PA7.Signal=QUADSPI1_BK1_IO2
PA8.GPIO_Label=BMS_CTRL.I_BAT
PA8.Signal=ADC5_IN1
PA9.GPIO_Label=I_ISO
PA9.Signal=ADC5_IN2
PB0.GPIO_Label=QSPI.IO1
PB0.Signal=QUADSPI1_BK1_IO1
PB1.GPIO_Label=QSPI.IO0
PB1.Signal=QUADSPI1_BK1_IO0
PB10.GPIO_Label=RESTRICT\: No toggle (REFBUF)
PB10.Signal=GPIO_Analog
PB11.GPIO_Label=RESTRICT\: No toggle (REFBUF)
PB11.Signal=GPIO_Analog
PB12.GPIO_Label=HV_CTRL.PRIM
PB12.Signal=HRTIM1_CHC1
PB13.GPIO_Label=RESTRICT\: No toggle (REFBUF)
PB13.Signal=GPIO_Analog
PB14.GPIO_Label=RESTRICT\: No toggle (REFBUF)
PB14.Signal=GPIO_Analog
PB15.GPIO_Label=V_HV
PB15.Signal=ADC4_IN5
PB2.GPIO_Label=HV_CTRL.EN
PB2.Signal=GPIO_Output
PB3.GPIO_Label=SWD.SWO
PB3.Signal=SYS_JTDO-SWO
PB5.GPIO_Label=UI_PRESENT
PB5.Signal=GPIO_Input
PB6.GPIO_Label=ENCODER.B
PB6.Signal=S_TIM4_CH1
PB7.GPIO_Label=ENCODER.A
PB7.Signal=S_TIM4_CH2
PB8-BOOT0.GPIO_Label=BOOT0
PB8-BOOT0.Signal=GPIO_Input
PB9.GPIO_Label=BUTTON.OUT
PB9.Signal=GPIO_Input
PC0.GPIO_Label=SHUNT_EN
PC0.Signal=GPIO_Output
PC1.GPIO_Label=OUT_SEL_HV
PC1.Signal=GPIO_Output
PC10.GPIO_Label=SPI.SCK
PC10.Signal=SPI3_SCK
PC11.GPIO_Label=SPI.MISO
PC11.Signal=SPI3_MISO
PC12.GPIO_Label=SPI.MOSI
PC12.Signal=SPI3_MOSI
PC13.GPIO_Label=RESTRICT\: No toggle (LSE)
PC13.Signal=GPIO_Analog
PC14-OSC32_IN.Signal=RCC_OSC32_IN
PC15-OSC32_OUT.Signal=RCC_OSC32_OUT
PC2.GPIO_Label=OVP_RESET
PC2.Signal=GPIO_Output
PC3.GPIO_Label=OVP_N
PC3.Signal=GPIO_Input
PC4.GPIO_Label=OCP_N
PC4.Signal=GPIO_Input
PC5.GPIO_Label=DISCHARGE_N
PC5.Signal=GPIO_Output
PC6.GPIO_Label=I2C.SCL
PC6.Signal=I2C4_SCL
PC7.GPIO_Label=I2C.SDA
PC7.Signal=I2C4_SDA
PC8.GPIO_Label=CONV_CTRL.SEC_L
PC8.Signal=HRTIM1_CHE1
PC9.GPIO_Label=CONV_CTRL.SEC_H
PC9.Signal=HRTIM1_CHE2
PD0.GPIO_Label=ADC.SYNC/RESET_N
PD0.Signal=GPIO_Output
PD10.GPIO_Label=CONV_CTRL.TEMP_SEC
PD10.Signal=ADC5_IN7
PD11.GPIO_Label=V_3V3_A
PD11.Signal=ADC5_IN8
PD12.GPIO_Label=CONV_CTRL.TEMP_TRAFO
PD12.Signal=ADC5_IN9
PD13.GPIO_Label=SHUNT_ISO_EN
PD13.Signal=GPIO_Output
PD14.GPIO_Label=RESTRICT\: No toggle (REFBUF)
PD14.Signal=GPIO_Analog
PD15.GPIO_Label=I2C.ALERT
PD15.Signal=GPIO_Input
PD2.GPIO_Label=ADC.DRDY_N
PD2.Signal=GPXTI2
PD4.GPIO_Label=BUTTON.ESC
PD4.Signal=GPIO_Input
PD5.GPIO_Label=UART.TX
PD5.Signal=USART2_TX
PD6.GPIO_Label=UART.RX
PD6.Signal=USART2_RX
PD8.GPIO_Label=TEMP_CURRENT
PD8.Signal=ADC5_IN12
PD9.GPIO_Label=CONV_CTRL.TEMP_PRIM
PD9.Signal=ADC5_IN13
PE1.GPIO_Label=BUTTON.OK
PE1.Signal=GPIO_Input
PE10.GPIO_Label=V_15V
PE10.Signal=ADC5_IN14
PE11.GPIO_Label=V_VCC
PE11.Signal=ADC5_IN15
PE12.GPIO_Label=V_5V
PE12.Signal=ADC5_IN16
PE13.GPIO_Label=V_IN
PE13.Signal=ADC3_IN3
PE14.GPIO_Label=OUT_SEL_ISO
PE14.Signal=GPIO_Output
PE15.GPIO_Label=V_OUT
PE15.Signal=ADC4_IN2
PE2.GPIO_Label=DISPLAY.SCK
PE2.Signal=SPI4_SCK
PE3.GPIO_Label=DISPLAY.WR
PE3.Signal=GPIO_Output
PE4.GPIO_Label=DISPLAY.CS
PE4.Signal=GPIO_Output
PE5.GPIO_Label=DISPLAY.MISO
PE5.Signal=SPI4_MISO
PE6.GPIO_Label=DISPLAY.MOSI
PE6.Signal=SPI4_MOSI
PE7.GPIO_Label=CONV_CTRL.EN
PE7.Signal=GPIO_Output
PE8.GPIO_Label=V_3V3
PE8.Signal=ADC5_IN6
PE9.GPIO_Label=ON_REQ
PE9.Signal=GPIO_Output
PF9.GPIO_Label=BMS_CTRL.WAKEUP
PF9.Signal=GPIO_Output
