daniw/bat_source/sw/bat_source/Core/Src/main.c

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
/* Includes ------------------------------------------------------------------*/
#include "main.h"
#include "adc.h"
#include "dac.h"
#include "dma.h"
#include "hrtim.h"
#include "i2c.h"
#include "quadspi.h"
#include "rtc.h"
#include "spi.h"
#include "tim.h"
#include "usart.h"
#include "gpio.h"

/* USER CODE BEGIN Includes */
#include "i2c.h"
#include "driver_pca9554.h"
#include "aux_io_ctrl.h"
#include "dac.h"
#include "bq76905.h"
#include "bq76905_config.h"
#include "ctrl_main.h"
#include "timer.h"
#include "display.h"
#include "opt3004.h"
#include "lp581x.h"
#include "hrtim.h"
#include "ui_ctrl.h"
#include "statemachine.h"
#include "adc.h"
#include "cli.h"
#include <stdio.h>
#include "stdint.h"
#include "lcd.h"
#include "w25n01gv.h"
#include "ads131m04.h"
/* USER CODE END Includes */


/* USER CODE BEGIN PV */
BQ76905_handle bms;
ADC_MEAS_DATA adc_data;
ADS131M04_handle ext_adc;
w25n01gv_handle flash;
w25n01gv_status_t flash_status = W25N01GV_OK;

/* USER CODE END PV */

void SystemClock_Config(void);
/**
  * @brief  The application entry point.
  * @retval int
  */
int main(void)
{

  /* USER CODE BEGIN 1 */
	EVENT_STRUCT e;
  /* USER CODE END 1 */

  /* MCU Configuration--------------------------------------------------------*/

  /* Reset of all peripherals, Initializes the Flash interface and the Systick. */
  HAL_Init();

  /* Configure the system clock */
  SystemClock_Config();

  /* Initialize all configured peripherals */
  MX_GPIO_Init();
  MX_DMA_Init();
  MX_HRTIM1_Init();
  MX_QUADSPI1_Init();
  MX_SPI4_Init();
  MX_ADC1_Init();
  MX_ADC2_Init();
  MX_ADC3_Init();
  MX_ADC4_Init();
  MX_ADC5_Init();
  MX_DAC1_Init();
  MX_SPI3_Init();
  MX_I2C4_Init();
  MX_TIM4_Init();
  MX_TIM16_Init();
  MX_USART2_UART_Init();
  MX_RTC_Init();
  MX_TIM2_Init();
  /* USER CODE BEGIN 2 */
  /*
   * Setup internal timer structure
   */
  //gpio_turnOn();
  timer_init();

  /*
   * DAC test setup
   */
  uint16_t dac_value = 0;
  dac_setValueRef2(2048);
  dac_setValue1ARef(dac_value);

  /*
   * CLI Setup
   */
  cli_init(&huart2);

  /*
   * Init UI control (LEDs)
   */
  ui_ctrl_init();


  /*
   * ADC Init
   */
  adc_init(ext_adc.channelData);
  ADS131M04_init(&ext_adc, &hspi3, SPI_CS_GPIO_Port, SPI_CS_Pin, ADC_SYNC_RESET_N_GPIO_Port, ADC_SYNC_RESET_N_Pin);
  adc_configure_mode(STATEMACHINE_MODE_10A_OUT);
  adc_start();
  /*
   * Wakeup BMS and configure if necessary
   */
  GPIO_SET_BMS_CTRL_WAKEUP(1);
  HAL_Delay(100);
  GPIO_SET_BMS_CTRL_WAKEUP(0);
  BQ76905_init(&bms, BQ76905_I2C_ADDRESS);


  /*
   * PWM Init
   */
  hrtim_set_freq(HRTIM_CHANNEL_PRIM, 50000);
  hrtim_set_freq(HRTIM_CHANNEL_SEK, 150000);
  hrtim_set_duty(HRTIM_CHANNEL_PRIM, 0.985);

  hrtim_start_timer();
  timer_start();

  /*
   * QSPI flash memory init
   */
  flash_status = w25n01gv_init(&flash, &hqspi1, 1000);
/*  if (flash_status == HAL_OK){
    flash_status = w25n01gv_wait_busy(&flash);
  }
  if (flash_status == HAL_OK){
  	flash_status = w25n01gv_buffer_mode_disable(&flash);
  }
  if (flash_status == HAL_OK){
    flash_status = w25n01gv_wait_busy(&flash);
  }*/
  if (flash_status != W25N01GV_OK) {
    printf("Flash initialisation failed!\r\n");
  }

  gpio_turnOn();

  LCD_init();

  ctrl_main_init();
  statemachine_init();


  /* USER CODE END 2 */

  /* Infinite loop */
  /* USER CODE BEGIN WHILE */
  while (1)
  {


	  /*
	   * DAC Test
	   */
	  /*if (dac_value + 256 >= 4096)
	  {
		  dac_value = 0;
	  }
	  else
	  {
		  dac_value += 256;
	  */
	  if (dac_value <= 2048) {
		  dac_value = 3804;
	  }
	  else {
		  dac_value = 2048;
	  }
	  dac_setValue1ARef(dac_value);
	  /*
	   * LED test
	   */
	  /*if (led_current < 192)
	  {
		  led_current *= 2;
	  }
	  else
	  {
		  led_current = 3;
	  }
	  uint8_t led_currents[] = {0x14, led_current, led_current, led_current};
	  i2c_WriteBlocking(led_address, led_currents, sizeof(led_currents));
	  */

	  cli_loop();


	  /*
	   * Ambient light sensor test
	   */


	  /*amb_brightness = opt3004_readLux(&hamb);

	  led_current = amb_brightness/1000;

	  if (led_current > 200)
	  {
		  led_current = 200;
	  }
	  else if (amb_brightness < 1000)
	  {
		  led_current = 2;
	  }
	  uint8_t led_currents[] = {0x14, led_current, led_current/2, led_current/2};
	  lp581x_setAnalogDimming(&hled, 0, led_current);
	  lp581x_setAnalogDimming(&hled, 0, led_current/2);
	  lp581x_setAnalogDimming(&hled, 0, led_current/2);

	  i2c_WriteBlocking(led_address, led_currents, sizeof(led_currents));*/

	  e = event_Get();
	  switch(e.event){
		case EVENT_VOID:
		case EVENT_INIT:
			break;
		case EVENT_IIC_RX:
		case EVENT_IIC_TX:
			if(e.callback != 0)
				e.callback(e.argument);
			break;
		case EVENT_IIC_ERROR:
			break;
		case EVENT_EEPROM_READ:
			break;
		case EVENT_EEPROM_TIMEOUT:
			break;
		case EVENT_SM_STEP:
			statemachine_step();
			break;
		case EVENT_BMS_TIMER:
			BQ76905_readAllValuesAsync(&bms);
			break;
		case EVENT_EVENT:
		default:
			break;

	  }


	  /*
	   * Loop delay
	   */
	  HAL_Delay(1);

	  //LCD_Test();

    /* USER CODE END WHILE */

    /* USER CODE BEGIN 3 */
  }
  /* USER CODE END 3 */
}

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
/* USER CODE BEGIN 4 */
/**
 * External ADC finished SPI communication
 */
void HAL_SPI_TxRxCpltCallback(SPI_HandleTypeDef *hspi) {
	ADS131M04_handleSPIComplete(&ext_adc);
}


/**
 * Interrupt for external ADC
 */
void HAL_GPIO_EXTI_Callback(uint16_t GPIO_Pin) {
	if (GPIO_Pin == ADC_DRDY_N_Pin) {
		ADS131M04_handleDRDYInterrupt(&ext_adc);
	} else {
		// __NOP();
	}
}
/* USER CODE END 4 */
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
