daniw/bat_source/sw/bat_source/Core/Inc/bq76905_config_flags.h

/*
 * bq76905_config_flags.h
 *
 *  Created on: Jun 18, 2025
 *      Author: ahorat
 */

#ifndef INC_BQ76905_CONFIG_FLAGS_H_
#define INC_BQ76905_CONFIG_FLAGS_H_

#define BQ76905_REG_CONFIG_PWR_OTSD        0x08
#define BQ76905_REG_CONFIG_PWR_LFOWD       0x04
#define BQ76905_REG_CONFIG_PWR_DPSLP_LFO   0x02
#define BQ76905_REG_CONFIG_PWR_SLEEP_EN    0x01
          
#define BQ76905_REG_CONFIG_REGOUT_REG_EN    0x8          
#define BQ76905_REG_CONFIG_REGOUT_REG_1V8   0x0        
#define BQ76905_REG_CONFIG_REGOUT_REG_2V5   0x4        
#define BQ76905_REG_CONFIG_REGOUT_REG_3V0   0x5        
#define BQ76905_REG_CONFIG_REGOUT_REG_3V3   0x6        
#define BQ76905_REG_CONFIG_REGOUT_REG_5V0   0x7

#define BQ76905_REG_CONFIG_I2C_CSLTO        0x8000
#define BQ76905_REG_CONFIG_I2C_CSHTO        0x4000
#define BQ76905_REG_CONFIG_I2C_CSHTO_64MS   0x0000
#define BQ76905_REG_CONFIG_I2C_CSHTO_512MS  0x1000
#define BQ76905_REG_CONFIG_I2C_CSHTO_1MS    0x2000
#define BQ76905_REG_CONFIG_I2C_CSHTO_15MS   0x3000
#define BQ76905_REG_CONFIG_I2C_LLTO         0x0800
#define BQ76905_REG_CONFIG_I2C_LLTO_DIS     0x0000
#define BQ76905_REG_CONFIG_I2C_LLTO_0S5     0x0100
#define BQ76905_REG_CONFIG_I2C_LLTO_1S0     0x0200
#define BQ76905_REG_CONFIG_I2C_LLTO_1S5     0x0300
#define BQ76905_REG_CONFIG_I2C_LLTO_2S0     0x0400
#define BQ76905_REG_CONFIG_I2C_LLTO_2S5     0x0500
#define BQ76905_REG_CONFIG_I2C_LLTO_3S0     0x0600
#define BQ76905_REG_CONFIG_I2C_LLTO_3S5     0x0700
#define BQ76905_REG_CONFIG_I2C_BBTO         0x0002
#define BQ76905_REG_CONFIG_I2C_CRC          0x0001

#define BQ76905_REG_CONFIG_DA_TSMODE_ADC        0x0100
#define BQ76905_REG_CONFIG_DA_CCMODE_NORMAL     0x0000
#define BQ76905_REG_CONFIG_DA_CCMODE_SLOW       0x0040
#define BQ76905_REG_CONFIG_DA_CCMODE_LOW_POWER  0x0080
#define BQ76905_REG_CONFIG_DA_CCMODE_OFF        0x00C0
#define BQ76905_REG_CONFIG_DA_CVADCSPEED_2MS93  0x0000
#define BQ76905_REG_CONFIG_DA_CVADCSPEED_1MS46  0x0010
#define BQ76905_REG_CONFIG_DA_CVADCSPEED_732US  0x0020
#define BQ76905_REG_CONFIG_DA_CVADCSPEED_366US  0x0030
#define BQ76905_REG_CONFIG_DA_IVADCSPEED_2MS93  0x0000
#define BQ76905_REG_CONFIG_DA_IVADCSPEED_1MS46  0x0004
#define BQ76905_REG_CONFIG_DA_IVADCSPEED_732US  0x0008
#define BQ76905_REG_CONFIG_DA_IVADCSPEED_366US  0x000C
#define BQ76905_REG_CONFIG_DA_SSADCSPEED_2MS93  0x0000
#define BQ76905_REG_CONFIG_DA_SSADCSPEED_1MS46  0x0001
#define BQ76905_REG_CONFIG_DA_SSADCSPEED_732US  0x0002
#define BQ76905_REG_CONFIG_DA_SSADCSPEED_366US  0x0003

#define BQ76905_REG_CONFIG_ALARM_POR           0x0001 
#define BQ76905_REG_CONFIG_ALARM_CDTOGGLE      0x0002
#define BQ76905_REG_CONFIG_ALARM_INITCOMP      0x0004
#define BQ76905_REG_CONFIG_ALARM_TIMER_ALARM   0x0008
#define BQ76905_REG_CONFIG_ALARM_SLEEP         0x0010
#define BQ76905_REG_CONFIG_ALARM_WAKE          0x0020
#define BQ76905_REG_CONFIG_ALARM_ADSCAN        0x0040
#define BQ76905_REG_CONFIG_ALARM_FULLSCAN      0x0080
#define BQ76905_REG_CONFIG_ALARM_CB            0x0100
#define BQ76905_REG_CONFIG_ALARM_SHUTV         0x0200
#define BQ76905_REG_CONFIG_ALARM_XDSG          0x0400
#define BQ76905_REG_CONFIG_ALARM_XCHG          0x0800
#define BQ76905_REG_CONFIG_ALARM_SAB           0x1000
#define BQ76905_REG_CONFIG_ALARM_SAA           0x2000
#define BQ76905_REG_CONFIG_ALARM_SSB           0x4000
#define BQ76905_REG_CONFIG_ALARM_SSA           0x8000
    
#define BQ76905_REG_CONFIG_FET_CHGDETEN       0x80
#define BQ76905_REG_CONFIG_FET_HOST_FETOFF_EN 0x40
#define BQ76905_REG_CONFIG_FET_HOST_FETON_EN  0x20
#define BQ76905_REG_CONFIG_FET_SLEEPCHG       0x10
#define BQ76905_REG_CONFIG_FET_SFET           0x08
#define BQ76905_REG_CONFIG_FET_FET_EN         0x04
#define BQ76905_REG_CONFIG_FET_PWM_EN         0x02
#define BQ76905_REG_CONFIG_FET_PROTRCVR       0x01

#define BQ76905_REG_BAL_CONFIG_CBDLY_0MS      0x00             
#define BQ76905_REG_BAL_CONFIG_CBDLY_1MS      0x02             
#define BQ76905_REG_BAL_CONFIG_CBDLY_2MS      0x04             
#define BQ76905_REG_BAL_CONFIG_CBDLY_4MS      0x06             
#define BQ76905_REG_BAL_CONFIG_CBDLY_8MS      0x08             
#define BQ76905_REG_BAL_CONFIG_CBDLY_16MS     0x0A             
#define BQ76905_REG_BAL_CONFIG_CBDLY_32MS     0x0C             
#define BQ76905_REG_BAL_CONFIG_CBDLY_64MS     0x0E             
#define BQ76905_REG_BAL_CONFIG_CB_NO_CMD      0x01    
         
#define BQ76905_REG_PROT_EN_A_COV             0x80              
#define BQ76905_REG_PROT_EN_A_CUV             0x40              
#define BQ76905_REG_PROT_EN_A_SCD             0x20              
#define BQ76905_REG_PROT_EN_A_OCD1            0x10              
#define BQ76905_REG_PROT_EN_A_OCD2            0x08              
#define BQ76905_REG_PROT_EN_A_OCC             0x04              
#define BQ76905_REG_PROT_EN_A_CURLATCH        0x02              
#define BQ76905_REG_PROT_EN_A_REGOUT          0x01

        
#define BQ76905_REG_PROT_EN_B_OTD        0x20              
#define BQ76905_REG_PROT_EN_B_OTC        0x10              
#define BQ76905_REG_PROT_EN_B_UTD        0x08              
#define BQ76905_REG_PROT_EN_B_UTC        0x04              
#define BQ76905_REG_PROT_EN_B_OTINT      0x02              
#define BQ76905_REG_PROT_EN_B_HWD        0x01
                  
#define BQ76905_REG_PROT_DSG_FET_A_CUV     0x80              
#define BQ76905_REG_PROT_DSG_FET_A_SCD     0x40              
#define BQ76905_REG_PROT_DSG_FET_A_OCD1    0x20              
#define BQ76905_REG_PROT_DSG_FET_A_OCD2    0x10              
#define BQ76905_REG_PROT_DSG_FET_A_HWD     0x08              
#define BQ76905_REG_PROT_DSG_FET_A_OTD     0x04              
#define BQ76905_REG_PROT_DSG_FET_A_UTD     0x02              
#define BQ76905_REG_PROT_DSG_FET_A_OTINT   0x01

#define BQ76905_REG_PROT_CHG_FET_A_COV     0x80              
#define BQ76905_REG_PROT_CHG_FET_A_SCD     0x40              
#define BQ76905_REG_PROT_CHG_FET_A_OCC     0x20              
#define BQ76905_REG_PROT_CHG_FET_A_HWD     0x08              
#define BQ76905_REG_PROT_CHG_FET_A_OTC     0x04              
#define BQ76905_REG_PROT_CHG_FET_A_UTC     0x02              
#define BQ76905_REG_PROT_CHG_FET_A_OTINT   0x01
        
#define BQ76905_REG_PROT_FET_B_VREF        0x04
#define BQ76905_REG_PROT_FET_B_VSS         0x02
#define BQ76905_REG_PROT_FET_B_REGOUT      0x01
             
#define BQ76905_REG_PROT_CELL_OW_SLEEP_COWDLY_0MS   0x00     
#define BQ76905_REG_PROT_CELL_OW_SLEEP_COWDLY_1MS   0x10     
#define BQ76905_REG_PROT_CELL_OW_SLEEP_COWDLY_2MS   0x20     
#define BQ76905_REG_PROT_CELL_OW_SLEEP_COWDLY_4MS   0x30     
#define BQ76905_REG_PROT_CELL_OW_SLEEP_COWDLY_8MS   0x40     
#define BQ76905_REG_PROT_CELL_OW_SLEEP_COWDLY_16MS  0x50     
#define BQ76905_REG_PROT_CELL_OW_SLEEP_COWDLY_32MS  0x60     
#define BQ76905_REG_PROT_CELL_OW_SLEEP_COWDLY_64MS  0x70  

#define BQ76905_REG_PROT_CELL_OW_SLEEP_COWEN         0x8

#define BQ76905_REG_PROT_CELL_OW_SLEEP_COWTIME_1_8   0x0
#define BQ76905_REG_PROT_CELL_OW_SLEEP_COWTIME_1_4   0x1
#define BQ76905_REG_PROT_CELL_OW_SLEEP_COWTIME_1_2   0x2
#define BQ76905_REG_PROT_CELL_OW_SLEEP_COWTIME_1_1   0x3
#define BQ76905_REG_PROT_CELL_OW_SLEEP_COWTIME_2_1   0x4
#define BQ76905_REG_PROT_CELL_OW_SLEEP_COWTIME_4_1   0x5
#define BQ76905_REG_PROT_CELL_OW_SLEEP_COWTIME_8_1   0x6
#define BQ76905_REG_PROT_CELL_OW_SLEEP_COWTIME_16_1  0x7

#define BQ76905_REG_PROT_VCELL_UV_HYST_NO_RECOVERY   0x0     
#define BQ76905_REG_PROT_VCELL_UV_HYST_50mV          0x1     
#define BQ76905_REG_PROT_VCELL_UV_HYST_100mV         0x2     
#define BQ76905_REG_PROT_VCELL_UV_HYST_200mV         0x4 

#define BQ76905_REG_PROT_VCELL_OV_HYST_NO_RECOVERY   0x0     
#define BQ76905_REG_PROT_VCELL_OV_HYST_50mV          0x1     
#define BQ76905_REG_PROT_VCELL_OV_HYST_100mV         0x2     
#define BQ76905_REG_PROT_VCELL_OV_HYST_200mV         0x4     
  
#define BQ76905_REG_PROT_CUR_SC_DSG_TH_10mV           0x0
#define BQ76905_REG_PROT_CUR_SC_DSG_TH_20mV           0x1
#define BQ76905_REG_PROT_CUR_SC_DSG_TH_40mV           0x2
#define BQ76905_REG_PROT_CUR_SC_DSG_TH_60mV           0x3
#define BQ76905_REG_PROT_CUR_SC_DSG_TH_80mV           0x4
#define BQ76905_REG_PROT_CUR_SC_DSG_TH_100mV          0x5
#define BQ76905_REG_PROT_CUR_SC_DSG_TH_125mV          0x6
#define BQ76905_REG_PROT_CUR_SC_DSG_TH_150mV          0x7
#define BQ76905_REG_PROT_CUR_SC_DSG_TH_175mV          0x8
#define BQ76905_REG_PROT_CUR_SC_DSG_TH_200mV          0x9
#define BQ76905_REG_PROT_CUR_SC_DSG_TH_250mV          0xa
#define BQ76905_REG_PROT_CUR_SC_DSG_TH_300mV          0xb
#define BQ76905_REG_PROT_CUR_SC_DSG_TH_350mV          0xc
#define BQ76905_REG_PROT_CUR_SC_DSG_TH_400mV          0xd
#define BQ76905_REG_PROT_CUR_SC_DSG_TH_450mV          0xe
#define BQ76905_REG_PROT_CUR_SC_DSG_TH_500mV          0xf
 
#define BQ76905_REG_PROT_CUR_SC_DSG_DELAY_0US         0x0     
#define BQ76905_REG_PROT_CUR_SC_DSG_DELAY_15US        0x1     
#define BQ76905_REG_PROT_CUR_SC_DSG_DELAY_31US        0x2     
#define BQ76905_REG_PROT_CUR_SC_DSG_DELAY_61US        0x3     
#define BQ76905_REG_PROT_CUR_SC_DSG_DELAY_122US       0x4     
#define BQ76905_REG_PROT_CUR_SC_DSG_DELAY_244US       0x5     
#define BQ76905_REG_PROT_CUR_SC_DSG_DELAY_488US       0x6     
#define BQ76905_REG_PROT_CUR_SC_DSG_DELAY_977US       0x7     
#define BQ76905_REG_PROT_CUR_SC_DSG_DELAY_1953US      0x8     
#define BQ76905_REG_PROT_CUR_SC_DSG_DELAY_3906US      0x9
#define BQ76905_REG_PROT_CUR_SC_DSG_DELAY_7797US      0xa
     
#define BQ76905_REG_PROT_CUR_OC_LATCH_LIM_NO_LATCH    0x0
#define BQ76905_REG_PROT_CUR_OC_LATCH_LIM_2RETRY      0x1
#define BQ76905_REG_PROT_CUR_OC_LATCH_LIM_4RETRY      0x2
#define BQ76905_REG_PROT_CUR_OC_LATCH_LIM_8RETRY      0x3
#define BQ76905_REG_PROT_CUR_OC_LATCH_LIM_16RETRY     0x4
#define BQ76905_REG_PROT_CUR_OC_LATCH_LIM_32RETRY     0x5
#define BQ76905_REG_PROT_CUR_OC_LATCH_LIM_48RETRY     0x6
#define BQ76905_REG_PROT_CUR_OC_LATCH_LIM_96RETRY     0x7
  
#define BQ76905_REG_SECURITY_SETTINGS_SEAL            0x4      
#define BQ76905_REG_SECURITY_SETTINGS_LOCK_CFG        0x2      
#define BQ76905_REG_SECURITY_SETTINGS_PERM_SEAL       0x1      


// These are the default values needed to decide, if the value is written or not.

#define BQ76905_DEFAULT_VALUE_CAL_VOLT_GAIN_1         0x0000
#define BQ76905_DEFAULT_VALUE_CAL_VOLT_GAIN_STACK     0x0000
#define BQ76905_DEFAULT_VALUE_CAL_VOLT_GAIN_DELTA_2   0x0000
#define BQ76905_DEFAULT_VALUE_CAL_VOLT_GAIN_DELTA_3   0x0000
#define BQ76905_DEFAULT_VALUE_CAL_VOLT_GAIN_DELTA_4   0x0000
#define BQ76905_DEFAULT_VALUE_CAL_VOLT_GAIN_DELTA_5   0x0000
#define BQ76905_DEFAULT_VALUE_CAL_CUR_GAIN            0x0000
#define BQ76905_DEFAULT_VALUE_CAL_CUR_OFFSET          0x0000
#define BQ76905_DEFAULT_VALUE_CAL_CC1_GAIN            0x0000
#define BQ76905_DEFAULT_VALUE_CAL_CC1_OFFSET          0x0000
#define BQ76905_DEFAULT_VALUE_CAL_TS_OFFSET           0x0000
#define BQ76905_DEFAULT_VALUE_CAL_TEMP_INT_GAIN       0x0000
#define BQ76905_DEFAULT_VALUE_CAL_TEMP_INT_OFFSET     0x0000
#define BQ76905_DEFAULT_VALUE_CONFIG_PWR              0x01
#define BQ76905_DEFAULT_VALUE_CONFIG_REGOUT           0x08
#define BQ76905_DEFAULT_VALUE_CONFIG_I2C_ADDR         0x08
#define BQ76905_DEFAULT_VALUE_CONFIG_I2C              0x3400
#define BQ76905_DEFAULT_VALUE_CONFIG_DA               0x0000
#define BQ76905_DEFAULT_VALUE_CONFIG_VCELL_MODE       0x00
#define BQ76905_DEFAULT_VALUE_CONFIG_ALARM_MASK       0xC200
#define BQ76905_DEFAULT_VALUE_CONFIG_FET_OPTIONS      0x18
#define BQ76905_DEFAULT_VALUE_CONFIG_CHARGE_DET_TIME  0x1
#define BQ76905_DEFAULT_VALUE_BAL_CONFIG              0x02
#define BQ76905_DEFAULT_VALUE_BAL_MIN_TEMP            0xFF
#define BQ76905_DEFAULT_VALUE_BAL_MAX_TEMP            0x0
#define BQ76905_DEFAULT_VALUE_BAL_MAX_INT_TEMP        85
#define BQ76905_DEFAULT_VALUE_PROT_EN_A               0xA1
#define BQ76905_DEFAULT_VALUE_PROT_EN_B               0x00
#define BQ76905_DEFAULT_VALUE_PROT_DSG_FET_A          0xFF
#define BQ76905_DEFAULT_VALUE_PROT_CHG_FET_A          0xEF
#define BQ76905_DEFAULT_VALUE_PROT_FET_B              0x06
#define BQ76905_DEFAULT_VALUE_PROT_BODY_DIODE         64
#define BQ76905_DEFAULT_VALUE_PROT_CELL_COWNTIME      0x0
#define BQ76905_DEFAULT_VALUE_PROT_CELL_OW_SLEEP      0x10
#define BQ76905_DEFAULT_VALUE_PROT_WD_TIMEOUT         0x0
#define BQ76905_DEFAULT_VALUE_PROT_VCELL_UV_TH        2500
#define BQ76905_DEFAULT_VALUE_PROT_VCELL_UV_DELAY     10
#define BQ76905_DEFAULT_VALUE_PROT_VCELL_UV_HYST      0x02
#define BQ76905_DEFAULT_VALUE_PROT_VCELL_OV_TH        4200
#define BQ76905_DEFAULT_VALUE_PROT_VCELL_OV_DELAY     10
#define BQ76905_DEFAULT_VALUE_PROT_VCELL_OV_HYST      0x02
#define BQ76905_DEFAULT_VALUE_PROT_CUR_OC_CHG_TH      2
#define BQ76905_DEFAULT_VALUE_PROT_CUR_OC_CHG_DELAY   58
#define BQ76905_DEFAULT_VALUE_PROT_CUR_OC_DSG_1_TH    4
#define BQ76905_DEFAULT_VALUE_PROT_CUR_OC_DSG_1_DELAY 6
#define BQ76905_DEFAULT_VALUE_PROT_CUR_OC_DSG_2_TH    3
#define BQ76905_DEFAULT_VALUE_PROT_CUR_OC_DSG_2_DELAY 19
#define BQ76905_DEFAULT_VALUE_PROT_CUR_SC_DSG_TH      0x0
#define BQ76905_DEFAULT_VALUE_PROT_CUR_SC_DSG_DELAY   0x01
#define BQ76905_DEFAULT_VALUE_PROT_CUR_OC_LATCH_LIM   0x0
#define BQ76905_DEFAULT_VALUE_PROT_CUR_OC_REC_TIME    5
#define BQ76905_DEFAULT_VALUE_PROT_TEMP_OT_CHG_TH     55
#define BQ76905_DEFAULT_VALUE_PROT_TEMP_OT_CHG_DEL    15
#define BQ76905_DEFAULT_VALUE_PROT_TEMP_OT_CHG_REC    63
#define BQ76905_DEFAULT_VALUE_PROT_TEMP_UT_CHG_TH     147
#define BQ76905_DEFAULT_VALUE_PROT_TEMP_UT_CHG_DEL    15
#define BQ76905_DEFAULT_VALUE_PROT_TEMP_UT_CHG_REC    134
#define BQ76905_DEFAULT_VALUE_PROT_TEMP_OT_DSG_TH     48
#define BQ76905_DEFAULT_VALUE_PROT_TEMP_OT_DSG_DEL    15
#define BQ76905_DEFAULT_VALUE_PROT_TEMP_OT_DSG_REC    55
#define BQ76905_DEFAULT_VALUE_PROT_TEMP_UT_DSG_TH     147
#define BQ76905_DEFAULT_VALUE_PROT_TEMP_UT_DSG_DEL    15
#define BQ76905_DEFAULT_VALUE_PROT_TEMP_UT_DSG_REC    134
#define BQ76905_DEFAULT_VALUE_PROT_TEMP_OT_INT_TH     105
#define BQ76905_DEFAULT_VALUE_PROT_TEMP_OT_INT_DEL    15
#define BQ76905_DEFAULT_VALUE_PROT_TEMP_OT_INT_REC    100
#define BQ76905_DEFAULT_VALUE_PWR_SLEEP_CUR           64
#define BQ76905_DEFAULT_VALUE_PWR_SLEEP_VOLT_TIME     5
#define BQ76905_DEFAULT_VALUE_PWR_SLEEP_WAKE          1
#define BQ76905_DEFAULT_VALUE_PWR_SHDN_VCELL          0x0
#define BQ76905_DEFAULT_VALUE_PWR_SHDN_VSTACK         0x0
#define BQ76905_DEFAULT_VALUE_PWR_SHDN_TEMP           0x0
#define BQ76905_DEFAULT_VALUE_PWR_SHDN_TIME           0x0
#define BQ76905_DEFAULT_VALUE_SECURITY_SETTINGS       0x0
#define BQ76905_DEFAULT_VALUE_SECURITY_ACCESS_KEY_1   0x0414
#define BQ76905_DEFAULT_VALUE_SECURITY_ACCESS_KEY_2   0x3672

#endif /* INC_BQ76905_CONFIG_FLAGS_H_ */
