daniw/bat_source/sw/bat_source/Core/Inc/ads131m04_config.h

#ifndef ADS131M04_CONFIG_H
#define ADS131M04_CONFIG_H

// Enable CRC calculation (set to 1 to enable, 0 to disable)
#define ADS131M04_USE_CRC 0
#define ADS131M04_FORCE_ALL_REGISTERS 0

#define ADS131M04_CONFIG_VALUE_MODE            0x0510
#define ADS131M04_CONFIG_VALUE_CLOCK           0x0F1E
#define ADS131M04_CONFIG_VALUE_GAIN            0x0000
#define ADS131M04_CONFIG_VALUE_CFG             0x0600
#define ADS131M04_CONFIG_VALUE_THRSHLD_MSB     0x0000
#define ADS131M04_CONFIG_VALUE_THRSHLD_LSB     0x0000

#define ADS131M04_CONFIG_VALUE_CH0_CFG         0x0000
#define ADS131M04_CONFIG_VALUE_CH0_OCAL_MSB    0x0000
#define ADS131M04_CONFIG_VALUE_CH0_OCAL_LSB    0x0000
#define ADS131M04_CONFIG_VALUE_CH0_GCAL_MSB    0x8000
#define ADS131M04_CONFIG_VALUE_CH0_GCAL_LSB    0x0000
#define ADS131M04_CONFIG_VALUE_CH1_CFG         0x0000
#define ADS131M04_CONFIG_VALUE_CH1_OCAL_MSB    0x0000
#define ADS131M04_CONFIG_VALUE_CH1_OCAL_LSB    0x0000
#define ADS131M04_CONFIG_VALUE_CH1_GCAL_MSB    0x8000
#define ADS131M04_CONFIG_VALUE_CH1_GCAL_LSB    0x0000
#define ADS131M04_CONFIG_VALUE_CH2_CFG         0x0000
#define ADS131M04_CONFIG_VALUE_CH2_OCAL_MSB    0x0000
#define ADS131M04_CONFIG_VALUE_CH2_OCAL_LSB    0x0000
#define ADS131M04_CONFIG_VALUE_CH2_GCAL_MSB    0x8000
#define ADS131M04_CONFIG_VALUE_CH2_GCAL_LSB    0x0000
#define ADS131M04_CONFIG_VALUE_CH3_CFG         0x0000
#define ADS131M04_CONFIG_VALUE_CH3_OCAL_MSB    0x0000
#define ADS131M04_CONFIG_VALUE_CH3_OCAL_LSB    0x0000
#define ADS131M04_CONFIG_VALUE_CH3_GCAL_MSB    0x8000
#define ADS131M04_CONFIG_VALUE_CH3_GCAL_LSB    0x0000


// Default Values DO NOT CHANGE BEYOND THIS LINE!!
#define ADS131M04_DEFAULT_VALUE_ID              0x2400
#define ADS131M04_DEFAULT_VALUE_STATUS          0x0500
#define ADS131M04_DEFAULT_VALUE_MODE            0x0510
#define ADS131M04_DEFAULT_VALUE_CLOCK           0x0F0E
#define ADS131M04_DEFAULT_VALUE_GAIN            0x0000
#define ADS131M04_DEFAULT_VALUE_CFG             0x0600
#define ADS131M04_DEFAULT_VALUE_THRSHLD_MSB     0x0000
#define ADS131M04_DEFAULT_VALUE_THRSHLD_LSB     0x0000

#define ADS131M04_DEFAULT_VALUE_CH0_CFG         0x0000
#define ADS131M04_DEFAULT_VALUE_CH0_OCAL_MSB    0x0000
#define ADS131M04_DEFAULT_VALUE_CH0_OCAL_LSB    0x0000
#define ADS131M04_DEFAULT_VALUE_CH0_GCAL_MSB    0x8000
#define ADS131M04_DEFAULT_VALUE_CH0_GCAL_LSB    0x0000
#define ADS131M04_DEFAULT_VALUE_CH1_CFG         0x0000
#define ADS131M04_DEFAULT_VALUE_CH1_OCAL_MSB    0x0000
#define ADS131M04_DEFAULT_VALUE_CH1_OCAL_LSB    0x0000
#define ADS131M04_DEFAULT_VALUE_CH1_GCAL_MSB    0x8000
#define ADS131M04_DEFAULT_VALUE_CH1_GCAL_LSB    0x0000
#define ADS131M04_DEFAULT_VALUE_CH2_CFG         0x0000
#define ADS131M04_DEFAULT_VALUE_CH2_OCAL_MSB    0x0000
#define ADS131M04_DEFAULT_VALUE_CH2_OCAL_LSB    0x0000
#define ADS131M04_DEFAULT_VALUE_CH2_GCAL_MSB    0x8000
#define ADS131M04_DEFAULT_VALUE_CH2_GCAL_LSB    0x0000
#define ADS131M04_DEFAULT_VALUE_CH3_CFG         0x0000
#define ADS131M04_DEFAULT_VALUE_CH3_OCAL_MSB    0x0000
#define ADS131M04_DEFAULT_VALUE_CH3_OCAL_LSB    0x0000
#define ADS131M04_DEFAULT_VALUE_CH3_GCAL_MSB    0x8000
#define ADS131M04_DEFAULT_VALUE_CH3_GCAL_LSB    0x0000

#define ADS131M04_DEFAULT_VALUE_CRC             0x0000
#define ADS131M04_DEFAULT_VALUE_RESERVED        0x0000

#endif
