daniw/bat_source/(commit log)

2024-09-26 DOC: Requirement for charging inside storage enclosure, Charging section added to overview
2024-10-07 DOC: Concepts for energy source, calibration started, section for optional requirements
2024-10-07 DOC: Calibration added to concept
2024-10-09 DOC: requirements for energy source summarized, power and energy requirement for energy source calculated
2024-10-10 DOC: Calibration through user interface added to concept
2024-10-10 HW: Project created and block diagram started
    [PS1-1-Top.SchDoc, PS1-1A-BASIS.PcbDoc, PS1-1A-PANEL.PcbDoc, PS1-1AA.PrjPcb]
2024-10-11 HW: Output terminals added to block diagram, cost estimation started
    [PS1-1-Top.SchDoc]
2024-10-14 HW: Cost estimation continued
    [PS1-1-Top.SchDoc]
2024-10-16 HW: Schematic sheets created for each subcircuit
    [Battery_BMS.SchDoc, Controller.SchDoc, Converter.SchDoc, Mechanics.SchDoc, On_Off.SchDoc, Output_Terminals.SchDoc, PS1-1-Top.SchDoc, PS1-1AA.PrjPcb]
2024-10-31 DOC: Added PCB to cost estimation and refined output converter
2024-11-04 HW: Simulation for internal charging supply protection
2024-11-04 HW: On/off added to simulation for internal charging supply protection
2024-11-04 HW: Basic circuit ideas added to schematic sheets
    [Battery_BMS.SchDoc, Controller.SchDoc, Converter.SchDoc, On_Off.SchDoc, Output_Terminals.SchDoc, PS1-1-Top.SchDoc, PS1-1AA.PrjPcb, User_Interface.SchDoc]
2024-11-06 HW: Spreadsheet for battery selection
    [Battery.xlsx]
2024-12-06 HW: Battery selection spreadsheet updated with Tenpower cells, quantity changed to 25 devices
    [Battery.xlsx]
2024-12-24 HW: Display added
    [Controller.SchDoc, User_Interface.SchDoc]
2024-12-24 HW: Converter topology changed to bidirectional flyback
    [Controller.SchDoc, Converter.SchDoc]
2024-12-24 HW: Supply for charging deep-discharged battery
    [Output_Terminals.SchDoc]
2025-01-06 HW: Microcontroller (STM32F334C8T) added to schematic
    [Controller.SchDoc]
2025-01-15 Added additional formula for current calculation and Power Semiconductor evaluation
2025-01-15 Updated script with prettier printing and core calulations
2025-01-15 HW: SIM: Added winding resistance values
2025-01-16 Added calculation of current sense resistors
2025-01-16 HW: SIM: Transformer winding resistance calculation
2025-01-17 Updated Power Semiconductors
2025-01-17 HW: I2C EEPROM added
    [Controller.SchDoc]
2025-01-23 HW: ADC, gatedriver, triple secondary flyback coil with range switch, switchable DC link ranges, overvoltage protection using to crowbar
    [Controller.SchDoc, Converter.SchDoc, On_Off.SchDoc, Output_Terminals.SchDoc, PS1-1-Top.SchDoc]
2025-01-23 HW: 1A Current source
    [Battery_BMS.SchDoc, Controller.SchDoc, Converter.SchDoc, On_Off.SchDoc, Output_Terminals.SchDoc, PS1-1-Top.SchDoc, User_Interface.SchDoc]
2025-01-26 HW: Schematic sheet for power
    [PS1-1AA.PrjPcb, Power.SchDoc]
2025-01-26 HW: Flyback transformer with ELP22, discharge rearranged
    [Controller.SchDoc, Converter.SchDoc]
2025-01-27 HW: Batteries updated to LiFePO4 26700 in 4S and 5S configuration
    [Battery_BMS.SchDoc]
2025-01-27 HW: BMS
    [Battery_BMS.SchDoc, Controller.SchDoc, PS1-1-Top.SchDoc, PS1-1AA.PrjPcb]
2025-01-31 MECH: Initial version of battery holder
    [Battery_Holder.FCStd]
2025-02-03 MECH: Battery holder: mounting updated to save space
    [Battery_Holder.FCStd]
2025-02-03 MECH: Battery holder: Cell dimensions updated to datasheet values
    [Battery_Holder.FCStd]
2025-02-04 HW: Button interface and ON/OFF controller
    [Controller.SchDoc, On_Off.SchDoc, PS1-1-Top.SchDoc, User_Interface.SchDoc]
2025-02-06 HW: Schematic sheets prepared for Power VCC and Power 3V3
    [Converter.SchDoc, PS1-1-Top.SchDoc, PS1-1AA.PrjPcb, Power.SchDoc, Power_3V3.SchDoc, Power_VCC.SchDoc]
2025-02-07 HW: ON/OFF controller simulation and improvement
    [On_Off.SchDoc]
2025-02-21 HW: Schematic sheet for measurements
    [Battery_BMS.SchDoc, Controller.SchDoc, Converter.SchDoc, Measurement.SchDoc, On_Off.SchDoc, Output_Terminals.SchDoc, PS1-1-Top.SchDoc, PS1-1AA.PrjPcb]
2025-02-25 HW: High voltage converter output rearranged to allow voltage measurement without the DC-link connected to the output, replaced amplifiers and comparators
    [Battery_BMS.SchDoc, Controller.SchDoc, Converter.SchDoc, Measurement.SchDoc, On_Off.SchDoc, Output_Terminals.SchDoc, PS1-1-Top.SchDoc, Power_3V3.SchDoc]
2025-02-27 DOC: Added battery overcurrent protection to requirements
2025-02-27 DOC: BMS documentation started
2025-03-01 HW: Various notes and small modifications
    [Battery_BMS.SchDoc, Controller.SchDoc, Converter.SchDoc, Measurement.SchDoc, On_Off.SchDoc, Output_Terminals.SchDoc, PS1-1-Top.SchDoc, Power_VCC.SchDoc]
2025-03-02 HW: Diodes replaced, high voltage indicator added, relays replaced, converters for VCC and +3V3 added, enclosure added
    [Battery_BMS.SchDoc, Controller.SchDoc, Converter.SchDoc, Measurement.SchDoc, Mechanics.SchDoc, On_Off.SchDoc, Output_Terminals.SchDoc, PS1-1-Top.SchDoc]
2025-03-02 HW: Variants created
    [Battery_BMS.SchDoc, Controller.SchDoc, Converter.SchDoc, Measurement.SchDoc, Mechanics.SchDoc, On_Off.SchDoc, Output_Terminals.SchDoc, PS1-1-Top.SchDoc]
2025-03-19 HW: 1A current controller replaced, relais replaced, 4mm output connectors added
    [Battery_BMS.SchDoc, Controller.SchDoc, Converter.SchDoc, Measurement.SchDoc, Mechanics.SchDoc, On_Off.SchDoc, Output_Terminals.SchDoc, PS1-1-Top.SchDoc]
2025-03-19 HW: PCB outline and mounting holes in enclosure defined
    [PS1-1A-BASIS.PcbDoc]
2025-03-25 HW: PS1-101 Transformer winding PCB, 1 turn added
    [PS1-101-Top.SchDoc, PS1-101A-BASIS.PcbDoc, PS1-101A-PANEL.PcbDoc, PS1-101AA.PrjPcb]
2025-03-25 HW: PS1-102 Transformer winding PCB, 2 turns added
    [PS1-102-Top.SchDoc, PS1-102A-BASIS.PcbDoc, PS1-102A-PANEL.PcbDoc, PS1-102AA.PrjPcb]
2025-03-25 HW: PS1-124 Transformer winding PCB, 24 turns added
    [PS1-124-Top.SchDoc, PS1-124A-BASIS.PcbDoc, PS1-124A-PANEL.PcbDoc, PS1-124AA.PrjPcb]
2025-03-25 HW: Library references for transistors updated, BOM cleanup, Pushbuttons added, NPN transistor for high-voltage indicator added, Footprints for thyristor and fuse holder, transformer updated
    [Battery_BMS.SchDoc, Controller.SchDoc, Converter.SchDoc, Measurement.SchDoc, Mechanics.SchDoc, On_Off.SchDoc, Output_Terminals.SchDoc, PS1-1-Top.SchDoc]
2025-03-26 HW: Discharge and crowbar moved to output terminal schematic sheet
    [Controller.SchDoc, Converter.SchDoc, Output_Terminals.SchDoc, PS1-1-Top.SchDoc]
2025-03-26 HW: Output connectors connected, Zener diode for VCC control set to fitted
    [Controller.SchDoc, Output_Terminals.SchDoc, PS1-1AA.PrjPcb]
2025-03-26 HW: Feedback from first schematic review
    [Converter.SchDoc, Measurement.SchDoc, On_Off.SchDoc, Output_Terminals.SchDoc]
2025-04-03 HW: Discharge moved to converter schematic sheet, crowbar operation detection added
    [Controller.SchDoc, Converter.SchDoc, Output_Terminals.SchDoc, PS1-1-Top.SchDoc]
2025-04-04 HW: Crowbar latch startup adjusted
    [Output_Terminals.SchDoc]
2025-04-04 HW: Schematic annotated
    [Controller.SchDoc, Converter.SchDoc, Measurement.SchDoc, Output_Terminals.SchDoc, PS1-1-Top.SchDoc, PS1-1AA.PrjPcb]
2025-04-07 HW: Project options adjusted, various minor changes
    [Controller.SchDoc, Converter.SchDoc, PS1-1-Top.SchDoc, PS1-101AA.PrjPcb, PS1-102AA.PrjPcb, PS1-124AA.PrjPcb, PS1-1AA.PrjPcb, Power_VCC.SchDoc]
2025-04-16 HW: Additional PCB (PS1-2) for user interface
    [Connector.SchDoc, Mechanics.SchDoc, PS1-2-Top.SchDoc, PS1-2A-BASIS.PcbDoc, PS1-2A-PANEL.PcbDoc, PS1-2AA.PrjPcb, User_Interface.SchDoc]
2025-04-16 HW: Components arranged within rooms, rough placement of converter, user interface, batteries, BMS and ON/OFF controller
    [Controller.SchDoc, Converter.SchDoc, Measurement.SchDoc, PS1-1-Top.SchDoc, PS1-1AA.PrjPcb, Power_3V3.SchDoc, Power_VCC.SchDoc]
2025-04-20 HW: Display added to PS1-2, UI connector moved, BMS and ON/OFF controller placement continued, clearance rules for HV nets implemented, 24wdg coil adjusted to meet 2.5mm clearance, converter placemen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
    [Battery_BMS.SchDoc, Connector.SchDoc, Converter.SchDoc, Measurement.SchDoc, On_Off.SchDoc, Output_Terminals.SchDoc, PS1-101-Top.SchDoc, PS1-101A-BASIS.PcbDoc]
2025-04-22 HW_ DPDT relais replaced with two SPDT relais, bypass resistor for dc link relais added, header for battery temperature measurement, converter routing adjusted, clearance rules implemented for voltag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
    [Battery_BMS.SchDoc, Converter.SchDoc, PS1-1AA.PrjPcb]
2025-04-24 HW: High voltage indicators moved to center plugs only
    [PS1-2A-BASIS.PcbDoc]
2025-04-24 HW: Rough placement of output terminals
    [On_Off.SchDoc, Output_Terminals.SchDoc, PS1-1AA.PrjPcb]
2025-04-25 HW: Input resistors of voltage measurements split into multiple resistors due to working voltage limitation, first rough placement of measurement components
    [Measurement.SchDoc]
2025-04-25 HW: Measurement circuit component placement, crowbar moved
    [Measurement.SchDoc, Output_Terminals.SchDoc]
2025-04-26 HW: User interface connector changed to dual-row, user interface placement adjusted, VCC and +3V3 supplies placed on PCB, rough placement of microcontroller and periphery
    [Connector.SchDoc, PS1-2A-BASIS.PcbDoc, User_Interface.SchDoc]
2025-04-29 HW: Stäubli plugs
    [Mechanics.SchDoc, Output_Terminals.SchDoc, PS1-1AA.PrjPcb]
2025-04-29 HW: Multiboard project created, unused enter button removed, Buttons aligned with device centerline, UI connector moved, board cutouts for fuse, relais and capacitors on PS1-2
    [Connector.SchDoc, Output_Terminals.SchDoc, PS1-2A-BASIS.PcbDoc, PS1-2AA.PrjPcb, User_Interface.SchDoc]
2025-04-30 HW: QR code with project URL added to PCBs
    [PS1-1-Top.SchDoc, PS1-101-Top.SchDoc, PS1-101A-BASIS.PcbDoc, PS1-101AA.PrjPcb, PS1-102AA.PrjPcb, PS1-124AA.PrjPcb, PS1-1AA.PrjPcb, PS1-2-Top.SchDoc]
2025-04-30 HW: Buttons and encoder rearranged, not final yet
    [PS1-1-Top.SchDoc, PS1-2-Top.SchDoc, PS1-2A-BASIS.PcbDoc]
2025-05-02 MECH: Battery holder adjusted to fit enclosure
    [Battery_Holder.FCStd]
2025-05-02 HW: Battery holder added
2025-05-05 HW: SMD protection resistors added, UART added to UI interface
    [Connector.SchDoc, Controller.SchDoc, Converter.SchDoc, Output_Terminals.SchDoc, PS1-1-Top.SchDoc, PS1-1AA.PrjPcb, PS1-2A-BASIS.PcbDoc, Power_VCC.SchDoc]
2025-05-07 HW: User interface connector moved, battery cell position updated, converter moved, microcontroller pinout definition started
    [Battery_BMS.SchDoc, Battery_Holder.FCStd, Connector.SchDoc, Controller.SchDoc, PS1-2A-BASIS.PcbDoc, User_Interface.SchDoc]
2025-05-07 Added PCB Draft for Programming PCB
    [PS1-3-Top.SchDoc, PS1-3A-BASIS.PcbDoc, PS1-3A-PANEL.PcbDoc, PS1-3AA.PrjPcb]
2025-05-10 HW: Components in controller room rearranged, polygons added for supplies, routing continued
    [Controller.SchDoc, Converter.SchDoc, Output_Terminals.SchDoc, PS1-1-Top.SchDoc, PS1-1AA.PrjPcb, User_Interface.SchDoc]
2025-05-10 HW: User interface: headers added for alternative button connection, breakout around buttons added, cutout for mainboard serial number, hole for reset button, 4mm clearance around mounting holes, pol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
    [Connector.SchDoc, PS1-2-Top.SchDoc, PS1-2A-BASIS.PcbDoc, User_Interface.SchDoc]
2025-05-11 Updated schematic and PCB for programming adapter
    [PS1-3-Top.SchDoc, PS1-3A-BASIS.PcbDoc, PS1-3AA.PrjPcb]
2025-05-11 HW: Routing continued, microcontroller pinout completed
    [Controller.SchDoc, Measurement.SchDoc, Power_VCC.SchDoc]
2025-05-12 Updated Programmer with UART and redid Layout
    [PS1-3-Top.SchDoc, PS1-3A-BASIS.PcbDoc, PS1-3AA.PrjPcb]
2025-05-13 Rotated text, replaced jumper by resistor.
    [PS1-3-Top.SchDoc, PS1-3A-BASIS.PcbDoc, PS1-3AA.PrjPcb]
2025-05-14 MECH: Cutouts for component pins added
    [Battery_Holder.FCStd]
2025-05-14 HW: Battery holder updated, routing completed, still some DRC errors, cleanup needed
    [Controller.SchDoc, Converter.SchDoc, Output_Terminals.SchDoc, PS1-1-Top.SchDoc, PS1-1AA.PrjPcb, PS1-2A-BASIS.PcbDoc, PS1-2AA.PrjPcb, Power_VCC.SchDoc]
2025-05-14 HW: Assembly updated
2025-05-14 HW: Various feedback implemented
    [Battery_BMS.SchDoc, Connector.SchDoc, Controller.SchDoc, Converter.SchDoc, Measurement.SchDoc, Mechanics.SchDoc, On_Off.SchDoc, Output_Terminals.SchDoc]
2025-05-15 HW: PMV213 replaced with BSS138 where feasible, with PMV280 otherwise
    [Battery_BMS.SchDoc, Converter.SchDoc, Measurement.SchDoc, On_Off.SchDoc, Output_Terminals.SchDoc, User_Interface.SchDoc]
2025-05-15 HW: Replacement of unavailable components, some cleanup on PS1-1,
    [Battery_BMS.SchDoc, Controller.SchDoc, Converter.SchDoc, Measurement.SchDoc, Mechanics.SchDoc, On_Off.SchDoc, Output_Terminals.SchDoc, PS1-1-Top.SchDoc]
2025-05-15 Rotated QR Code on Programmer
    [PS1-3A-BASIS.PcbDoc]
2025-05-16 HW: Layout cleanup, teardrops added
    [Battery_BMS.SchDoc, Controller.SchDoc, Converter.SchDoc, Measurement.SchDoc, Mechanics.SchDoc, On_Off.SchDoc, Output_Terminals.SchDoc, PS1-1-Top.SchDoc]
2025-05-16 HW: Parts in PS1-1 and PS1-2 updated from library, cutouts in PS1-2 marked
    [Battery_BMS.SchDoc, Connector.SchDoc, Controller.SchDoc, Converter.SchDoc, Measurement.SchDoc, Mechanics.SchDoc, On_Off.SchDoc, Output_Terminals.SchDoc]
2025-05-18 DOC: Modification to bms to allow wakeup from shutdown
2025-05-19 DOC: Missing polarity marker on LEDs added to Modification
2025-05-19 DOC: Low-value Resistance measurement and isolation resistance measurement added to requirements
2025-05-19 HW: Schematic cleanup
    [Battery_BMS.SchDoc, Connector.SchDoc, Controller.SchDoc, Converter.SchDoc, On_Off.SchDoc, Output_Terminals.SchDoc, PS1-2AA.PrjPcb, User_Interface.SchDoc]
2025-05-20 Updated Outjob files with correct PCB and deactivated open on generation
2025-05-26 MECH: Battery holder adjusted for easier printing
    [Battery_Holder.FCStd]
2025-06-11 MECH: Component cutouts corrected, missing cutouts added
    [Battery_Holder.FCStd]
2025-06-13 SW: PCA9554A I2C address and registers corrected, separate function for PCA9554 initialisation
    [driver_pca9554.c]
2025-06-13 SW: LEDs controlled in main loop
2025-06-14 Added BMS Code to try out simple read.
2025-06-15 SW: Basic BMS initialisation for initial testing
2025-06-18 SW: Display of battery voltage and current
2025-06-18 DOC: Inrush current problem
2025-06-23 MECH: Polarity marking added, mounting hole diameter reduced to 2mm to accommodate K25 screws
    [Battery_Holder.FCStd]
2025-06-24 DOC: Modification in battery current measurement
2025-06-26 DOC: Battery cell selection, mounting and connection
2025-06-30 HW: Multiboard assembly update
2025-06-30 HW: PS1-1A completed, assembly drawing cleanup
    [Battery_BMS.SchDoc, PS1-1A-PANEL.PcbDoc]
2025-06-30 HW: PS1-2AA completed, assembly drawing cleanup
    [PS1-2A-PANEL.PcbDoc]
2025-06-30 HW: PS1-3AA completed, assembly drawing cleanup
    [PS1-3A-BASIS.PcbDoc]
2025-07-02 HW: PS1-1 modified for index AB
    [Battery_BMS.SchDoc, Controller.SchDoc, Converter.SchDoc, PS1-1-Top.SchDoc, PS1-1AB.PrjPcb, User_Interface.SchDoc]
2025-07-02 DOC: Assembly order rearranged, Limit for +3V3 short circuit check adjusted
2025-07-05 HW: PS1-2 modified for index AB
    [Connector.SchDoc, PS1-2AB.PrjPcb]
2025-07-09 HW: Cost estimation for second prototype and series production
    [Cost Estimation.xlsx]
2025-07-09 DOC: Schematics updated to Index AA release
2025-07-29 Updated code before change of ADC
2025-08-19 DOC: Modifications for demo devices at FSG 2025
2025-08-27 MECH: Spacer 0.5mm for transformer
    [Transformer_Spacer_0.5mm.FCStd]
2025-08-28 DOC: Modifications from device assembly added to modifications
2025-09-03 HW: Main PCB modifications for demonstration device, PS1-1AC
    [Converter.SchDoc, Output_Terminals.SchDoc, PS1-1-Top.SchDoc, PS1-1AC.PrjPcb]
2025-09-04 HW: LDO added for display supply, PS1-3AC
    [PS1-2AC.PrjPcb, User_Interface.SchDoc]
2025-09-09 HW: PS1-2 renamed for index BA, I2C signals swapped on PS1-2
    [Connector.SchDoc, PS1-2A-PANEL.PcbDoc, PS1-2AC.PrjPcb, PS1-2B-PANEL.PcbDoc, PS1-2BA.PrjPcb]
2025-09-09 DOC: Modification to swap I2C signals completed
2025-09-10 HW: Deleted silkscreen makrings restored, plug labels moved for better visibility
    [Connector.SchDoc, PS1-2-Top.SchDoc]
2025-09-10 DOC: Silkscreen adjustments on PS1-2 completed in modification history
2025-09-10 HW: Project files updated to PS1-2 index BA
    [PS1-2BA.PrjPcb]
2025-09-10 HW: BMS wakeup implemented
    [Battery_BMS.SchDoc, Controller.SchDoc]
2025-09-10 DOC: BMS wakeup modification completed
2025-09-10 HW: Voltage drop on UI supply issue resolved
2025-09-10 DOC: UI supply voltage drop modification completed
2025-09-11 HW: Pulldown resistors added to CONV_CTRL.CONF_CURR and CONV_CTRL.CONF_ISO
    [Converter.SchDoc]
2025-09-11 HW: Clamping circuit for zero crossing detection modified
    [Converter.SchDoc]
2025-09-11 DOC: Zerocrossing clamping circuit modification completed
2025-09-11 HW: PS1-1 file names and project parameters updated to index BA, battery current measurement gain adjusted
    [Battery_BMS.SchDoc, PS1-1A-PANEL.PcbDoc, PS1-1AC.PrjPcb, PS1-1B-PANEL.PcbDoc, PS1-1BA.PrjPcb]
2025-09-11 DOC: Battery current measurement gain modification completed
2025-09-12 Added scritp for buckboost design
2025-09-12 HW: BuckBoost Script: Operating point calculation adjusted, plots added
2025-09-12 HW: Battery footprint updated for clearance around battery terminals, relay footprint updated for correct pin positions, no rerouting due to planned topology change
2025-09-17 MECH: Added FreeCAD Models for all 3D printed Parts
    [Battery_Holder.3mf, Holder_Banana_Plugs.FCStd, Holder_Banana_Plugs.stp, Holder_Banana_Plugs_Drill.stp, Knob.3mf, Knob.FCStd]
2025-09-17 HW: Converter topology changed to buck-boost for 10A and 60V ranges, tripple-flyback for 500V range
    [Battery_BMS.SchDoc, Controller.SchDoc, Converter.SchDoc, Converter_HV.SchDoc, Current_Controller.SchDoc, OV_Prot.SchDoc, On_Off.SchDoc, Output_Terminals.SchDoc]
2025-09-17 DOC: Issues completed: Relay footprint, battery terminal clearance, converter topology
2025-09-19 HW: PS1-1 update from library after origin-shift, symbol location corrected, modifications removed from assembly drawing
    [Battery_BMS.SchDoc, Controller.SchDoc, Converter.SchDoc, Converter_HV.SchDoc, Current_Controller.SchDoc, Measurement.SchDoc, Mechanics.SchDoc, OV_Prot.SchDoc]
2025-09-19 HW: PS1-101/02/24 update from library after origin-shift, symbol location corrected
    [PS1-101-Top.SchDoc, PS1-102-Top.SchDoc, PS1-124-Top.SchDoc]
2025-09-19 HW: PS1-2 update from library after origin-shift, symbol location corrected
    [Connector.SchDoc, PS1-2-Top.SchDoc, User_Interface.SchDoc]
2025-09-19 HW: PS1-3 update from library after origin-shift, symbol location corrected
    [PS1-3-Top.SchDoc, PS1-3A-BASIS.PcbDoc]
2025-10-06 HW: Simulation of HV detection LED driver
2025-10-06 HW: OLED replaced with daylight-readable LCD, User interface schematics restructured
    [Backlight_Driver.SchDoc, Connector.SchDoc, Display.SchDoc, LED.SchDoc, PS1-2-Top.SchDoc, PS1-2BA.PrjPcb, Power_VLED.SchDoc, User_Input.SchDoc]
2025-10-06 HW: Reset added to crowbar latch, analog supply voltage added, mainboard schematics restructured
    [Battery_BMS.SchDoc, Controller.SchDoc, Converter.SchDoc, Converter_HV.SchDoc, Measurement.SchDoc, Mechanics.SchDoc, OV_Prot.SchDoc, On_Off.SchDoc]
2025-10-06 HW: Unity gain amplifier added to V_OUT measurement
    [OV_Prot.SchDoc, Output_Terminals.SchDoc]
2025-10-07 HW: alternative displays removed
    [Backlight_Driver.SchDoc, Connector.SchDoc, Display.SchDoc, LED.SchDoc, PS1-2-Top.SchDoc, PS1-2BA.PrjPcb, Power_3V3.SchDoc, Power_VLED.SchDoc]
2025-10-07 HW: Current ripple in buck boost script increased to 40% to allow the selection of a smaller inductor
2025-10-07 DOC: Unity-gain amplifier in high voltage detection added to modification history
2025-10-07 DOC: Insufficient fuse rating added to modification history
2025-10-08 HW: Started with gatedriver simulation for DC link MOSFET
2025-10-08 HW: Cleaning up of converter schematics
    [Converter.SchDoc, Converter_HV.SchDoc, Output_Terminals.SchDoc]
2025-10-08 HW: Cost estimation updated
    [Cost Estimation.xlsx]
2025-10-09 HW: User interface pinout on mainboard updated
    [Power_3V3.SchDoc, User_Interface.SchDoc]
2025-10-09 HW: First draft of transformer connector PCB PS1-100
    [PS1-100-Top.SchDoc, PS1-100A-BASIS.PcbDoc, PS1-100A-PANEL.PcbDoc, PS1-100AA.PrjPcb]
2025-10-14 HW: Discharge resistors added to transformer connection PCB PS1-100
    [PS1-100-Top.SchDoc, PS1-100A-BASIS.PcbDoc]
2025-10-14 HW: Boost converter added for a stabilized 15V supply, all consumers moved from VCC to +15V
    [Connector.SchDoc, Converter.SchDoc, Converter_HV.SchDoc, Current_Controller.SchDoc, LED.SchDoc, Output_Terminals.SchDoc, PS1-1-Top.SchDoc, PS1-1BA.PrjPcb]
2025-10-15 HW: Components for 15V converter adjusted
    [Power_15V.SchDoc]
2025-10-15 HW: Outjobs adjusted for new filenames
    [PS1-100AA.PrjPcb]
2025-10-16 HW: Additional DC link for 5V range removed
    [Controller.SchDoc, Converter.SchDoc, OV_Prot.SchDoc, PS1-1-Top.SchDoc, Power_VCC.SchDoc]
2025-10-16 HW: Battery footprint updated from library with extended pads to fit celltabs
2025-10-16 DOC: Battery terminal slot size added to modification history
2025-10-21 Added 3D Model of Case and Assembly
    [00_bat_source.FCStd, CBOX11004.FCStd, Holder_Banana_Plugs.FCStd, Lid_CSACTT004.FCStd]
2025-10-22 HW: BMS signals and automatic precharge included in on-off controller
    [Battery_BMS.SchDoc, Controller.SchDoc, Converter.SchDoc, Converter_HV.SchDoc, OV_Prot.SchDoc, On_Off.SchDoc, Output_Terminals.SchDoc, PS1-1-Top.SchDoc]
2025-10-22 HW: MOSFET in on-off controller precharge detection corrected
    [On_Off.SchDoc, PS1-1BA.PrjPcb]
2025-10-31 HW: Testing tool for ADC characterization
2025-10-31 HW: TEST: Initial tests for ADC characterization, interrupted by batteries running empty
    [PS1-1A ADC Test 2025-10-30 23.39.19_amp.csv, PS1-1A ADC Test 2025-10-30 23.39.19_volt.csv, PS1-1A ADC Test 2025-10-30 23.48.31_volt.csv]
2025-10-31 HW: TEST: Unit 'none' added when no valid data is received from DUT
    [PS1-1A ADC Test 2025-10-30 23.48.31_volt.csv]
2025-10-31 HW: TEST: Script for analyzing ADC performance
2025-11-01 HW: Test: Setpoint added to measurement data
    [PS1-1A ADC Test 2025-10-30 23.39.19_amp.csv, PS1-1A ADC Test 2025-10-30 23.39.19_volt.csv, PS1-1A ADC Test 2025-10-30 23.48.31_volt.csv]
2025-11-01 HW: Test: Estimation for ADC test duration
    [ADC_duration.xlsx]
2025-11-01 HW: Test: Additional test results
    [PS1-1A ADC Test 2025-10-31 18.40.21_amp.csv, PS1-1A ADC Test 2025-10-31 18.40.21_volt.csv, PS1-1A ADC Test 2025-10-31 23.08.40_sens.csv, PS1-1A ADC Test 2025-11-01 09.48.31_sens.csv, PS1-1A ADC Test 2025-11-01 09.57.34_sens.csv]
2025-11-02 SW: Unit for ADC measurements V_Sns and I_Iso corrected to uV and uA
2025-11-04 DOC: Incorrect gain in V_Sens ADC channel added to modification history
2025-11-04 HW: PS1-100: Components replaced, first draft for layout
    [PS1-100-Top.SchDoc, PS1-100A-BASIS.PcbDoc, PS1-100A-PANEL.PcbDoc]
2025-11-06 HW: Compensation capacitors simplified to a single 330N/0603
    [Power_15V.SchDoc]
2025-11-06 HW: MEAS_P/N renamed to SENS_P/N, note about buffer for SENS signal added
    [Measurement.SchDoc, Output_Terminals.SchDoc, PS1-1-Top.SchDoc]
2025-11-06 HW: Transformer in high voltage converter changed to three-output RM5 flyback transformer with integrated rectifier and dc-link
    [Converter_HV.SchDoc]
2025-11-06 HW: Precharge detection MOSFET changed to n-channel
    [On_Off.SchDoc]
2025-11-08 HW: Amplifier for I_Iso removed, I_Iso no longer connected to microcontroller, adjustable gain for I_Out removed, sheet entries on PS1-1 top schematic cleaned up
    [Controller.SchDoc, Measurement.SchDoc, Output_Terminals.SchDoc, PS1-1-Top.SchDoc, PS1-1BA.PrjPcb]
2025-11-10 HW: Test: Current source added to DUT class
2025-11-18 HW: Configuration for isolation current measurement added to test script
2025-11-18 HW: Schematic reannotated and updated to PCB
    [Converter_HV.SchDoc, Measurement.SchDoc, Output_Terminals.SchDoc]
2025-11-18 HW: On/off controller simplified by using the dual diode to supply the comparator when the button is pressed
    [On_Off.SchDoc, User_Interface.SchDoc]
2025-11-25 HW: Test of BMS accuracy
    [BMS Accuracy.xlsx]
2025-11-25 HW: Converter changed to GaN halfbridges LMG2100R044, cleanup of net names
    [Battery_BMS.SchDoc, Controller.SchDoc, Converter.SchDoc, Converter_HV.SchDoc, Current_Controller.SchDoc, OV_Prot.SchDoc, On_Off.SchDoc, Output_Terminals.SchDoc]
2025-11-27 HW: Overcurrent protection for isolation measurement added, harness width reduced to small
    [Backlight_Driver.SchDoc, Battery_BMS.SchDoc, Connector.SchDoc, Controller.SchDoc, Converter.SchDoc, Converter_HV.SchDoc, Display.SchDoc, LED.SchDoc]
2025-11-28 HW: 5V supply added for power stage, LDO for analog supply replaced with LP2985, LDO suppplied from +5V, Analog circuits supplied by analog supply
    [Battery_BMS.SchDoc, Controller.SchDoc, Converter.SchDoc, Converter_HV.SchDoc, Current_Controller.SchDoc, Measurement.SchDoc, Output_Terminals.SchDoc, PS1-1-Top.SchDoc]
2025-11-28 HW: Multiboard assembly schematic updated
2025-11-28 HW: Current controller simulation updated for simulating in the newest version of LTSpice
2025-12-01 HW: Display SPI interface added to mainboard UI connector, pinout of UI connector synchronized
    [Connector.SchDoc, Controller.SchDoc, Display.SchDoc, PS1-1-Top.SchDoc, PS1-2-Top.SchDoc, User_Interface.SchDoc]
2025-12-15 HW: Crystal and supply for RTC added, additional schematic sheet for microcontroller peripherals
    [Battery_BMS.SchDoc, Controller.SchDoc, Converter.SchDoc, Microcontroller.SchDoc, Output_Terminals.SchDoc, PS1-1-Top.SchDoc, PS1-1BA.PrjPcb, Peripherals.SchDoc]
2025-12-15 HW: FPC connector for display
    [Display.SchDoc]
2025-12-16 HW: Current limiter for isolation measurement
    [Converter_HV.SchDoc, Iso_Current_Limit.SchDoc, On_Off.SchDoc, Output_Terminals.SchDoc, PS1-1BA.PrjPcb]
2025-12-16 HW: Components updated in current limiter simulation, 1A current controller simulation adjusted to use alternate solver
    [IXTP3N120.OLB]
2025-12-16 Components updated in current limiter, SHUNT_EN pulls reference current up, varistor added to output terminals (must be replaced with suitable rating)
    [Current_Controller.SchDoc, Iso_Current_Limit.SchDoc, Output_Terminals.SchDoc, PS1-1-Top.SchDoc, Power_3V3.SchDoc]
2025-12-17 HW: Iso current limiter simulation extended to evaluate minumum dropout voltage
2025-12-18 HW: Missing components marked in schematic
    [Battery_BMS.SchDoc, Converter.SchDoc, Converter_HV.SchDoc, Display.SchDoc, Iso_Current_Limit.SchDoc, Microcontroller.SchDoc, Output_Terminals.SchDoc, PS1-1-Top.SchDoc]
2025-12-18 HW: LV discharge MOSFET replaced with BSS123, resistor added for gain measurement of power supply control loops
    [Backlight_Driver.SchDoc, Connector.SchDoc, Converter.SchDoc, Display.SchDoc, LED.SchDoc, PS1-2-Top.SchDoc, Power_15V.SchDoc, Power_3V3.SchDoc]
2025-12-18 HW: User interface PCB updated from schematic, first placement of parts
    [PS1-2BA.PrjPcb]
2025-12-22 HW: PS1-100 updated from library
    [PS1-100-Top.SchDoc, PS1-100AA.PrjPcb]
2025-12-22 HW: PS1-2 updated from library
    [Backlight_Driver.SchDoc, Connector.SchDoc, Display.SchDoc, LED.SchDoc, PS1-2-Top.SchDoc, PS1-2BA.PrjPcb, Power_3V3.SchDoc, Power_VLED.SchDoc]
2025-12-22 HW: Resistor added to power supply feedback network for gain measurement, electrolytic output capacitors replaced by MLCC, update from library
    [Battery_BMS.SchDoc, Converter.SchDoc, Converter_HV.SchDoc, Current_Controller.SchDoc, Iso_Current_Limit.SchDoc, Measurement.SchDoc, Mechanics.SchDoc, Microcontroller.SchDoc]
2025-12-26 HW: MOSFET for flyback converter replaced, discharge chenged to constant current, schematics annotated
    [Converter.SchDoc, Converter_HV.SchDoc, PS1-1BA.PrjPcb, Power_15V.SchDoc, Power_3V3.SchDoc, Power_5V.SchDoc, Power_VCC.SchDoc]
2026-01-11 HW: Simulation of isolated power supply
2026-01-11 HW: Galvanic isolation for user inputs added
    [Connector.SchDoc, Display.SchDoc, PS1-2-Top.SchDoc, PS1-2BA.PrjPcb, Power_Iso.SchDoc, User_Input.SchDoc]
2026-01-11 HW: Separate schematic sheets for overcurrent protection and overvoltage protection, providing +3V3_STBY instead of VBAT to the user interface, initial component placement within rooms on PCB
    [Battery_BMS.SchDoc, Converter.SchDoc, Converter_HV.SchDoc, Microcontroller.SchDoc, Output_Terminals.SchDoc, Overcurrent_Protection.SchDoc, Overvoltage_Protection.SchDoc, PS1-1-Top.SchDoc]
2026-01-18 HW: Components placed and routed within in respective rooms, rooms placed on PCB to estimate dimensions
    [Converter.SchDoc, Current_Controller.SchDoc, Iso_Current_Limit.SchDoc, Measurement.SchDoc, Output_Terminals.SchDoc, PS1-1-Top.SchDoc, PS1-1B-PANEL.PcbDoc, PS1-1BA.PrjPcb]
2026-01-18 HW: Dimensions of user interface PCB adjusted to main PCB dimensions
    [PS1-2B-PANEL.PcbDoc, PS1-2BA.PrjPcb]
2026-01-18 HW: Multiboard assembly updated
2026-01-19 HW: Assembly variants implemented, mainboard reannotated, continued with routing
    [Battery_BMS.SchDoc, Converter.SchDoc, Converter_HV.SchDoc, Current_Controller.SchDoc, Iso_Current_Limit.SchDoc, Measurement.SchDoc, Mechanics.SchDoc, Microcontroller.SchDoc]
2026-01-19 HW: User interface reannotated
    [Backlight_Driver.SchDoc, Connector.SchDoc, Display.SchDoc, LED.SchDoc, PS1-2-Top.SchDoc, PS1-2B-PANEL.PcbDoc, PS1-2BA.PrjPcb, Power_3V3.SchDoc]
2026-01-24 HW: Bypass capacitor added for ambient light sensor and display, channels on LED driver rearranged for simplified routing, user interface reannotated, user interface routing completed
    [Backlight_Driver.SchDoc, Connector.SchDoc, Display.SchDoc, LED.SchDoc, PS1-2-Top.SchDoc, PS1-2B-PANEL.PcbDoc, PS1-2BA.PrjPcb, Power_3V3.SchDoc]
2026-01-29 HW: UI detect resistor on UI changed to 10K/0603, holes and traces around buttons adjusted to fit spacing requirements, DRC errors corrected on UI
    [Connector.SchDoc]
2026-01-29 HW: Temperature sensor for battery temperature added, voltage measurement added to all supplies, external ADC channels rearranged, microcontroler pins assigned for timer, ADC, QSPI, SPI and I2C, VREF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
    [Battery_BMS.SchDoc, Converter.SchDoc, Converter_HV.SchDoc, Current_Controller.SchDoc, Iso_Current_Limit.SchDoc, Measurement.SchDoc, Mechanics.SchDoc, Microcontroller.SchDoc]
2026-01-30 HW: Levelshifter added to off signal, via size around microcontroller adjusted
    [Converter_HV.SchDoc, Measurement.SchDoc, On_Off.SchDoc, User_Interface.SchDoc]
2026-02-09 HW: PS1-1: Capacitors added to ADC input signals as anti-aliassing filter, GND_PWR net added, varistor replaced with gas discharge tube (GDT), high-voltage resistors adjusted to availability, netclas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
    [Battery_BMS.SchDoc, Converter.SchDoc, Converter_HV.SchDoc, Current_Controller.SchDoc, Iso_Current_Limit.SchDoc, Measurement.SchDoc, Microcontroller.SchDoc, On_Off.SchDoc]
2026-02-09 HW: PS1-2: Notes in user interface schematics adjusted, hole for reset button on user interface aligned with reset button on mainboard, cutout in PS1-2 board outline for PS1-1 serial number and tag-c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
    [Connector.SchDoc, Display.SchDoc, LED.SchDoc, PS1-2BA.PrjPcb, Power_Iso.SchDoc]
2026-02-11 HW: PCA9554A replaced with TCA9554, I2C address notes corrected
    [Backlight_Driver.SchDoc, Battery_BMS.SchDoc, Display.SchDoc, LED.SchDoc, Peripherals.SchDoc]
2026-02-11 DOC: I2C address definition and I2C address list
2026-02-16 HW: Testpoints added to supply nets, solder bridge for SMD battery temperature sensor, parallel resistors for VIN precharge, 0805 components for flyback snubber, shunt resistors (OVP and output curre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
    [Battery_BMS.SchDoc, Converter.SchDoc, Converter_HV.SchDoc, Current_Controller.SchDoc, Display.SchDoc, Iso_Current_Limit.SchDoc, Measurement.SchDoc, Microcontroller.SchDoc]
2026-02-17 MECH: Visualisation of terminal layout
    [Terminal_Front_View.FCStd]
2026-02-17 HW: Spreadsheet for terminal offset evaluation
    [Terminal_offset.xlsx]
2026-02-18 First mechanical assembly. Will be deleted in the future
    [11225838256-545580.prt, 11225838256-545599.prt, 11376057872-68639.prt, 11376057872-68658.prt, 60v_quelle_dummy.stp, 9344568112-398244.prt, 9344568112-398263.prt, c61035-a0031-b201_rm5-2sec_sw_r.prt]
2026-02-18 Second version. Reduced PCB-step-files. Will be used for mech dev of housing
    [01_housing_v1.prt, 01_housing_v2.prt, 02b_banana_position_skeleton.prt, 03_lid.prt, 04_seal.prt, 11231157520-93574.prt, 11231157520-93593.prt, 12079984080-22881.prt]
2026-02-18 new housing. better structure of main-assembly. README.md. hole for fuse-lid.
    [00b_lid_assembly_asm.stp, 01_housing.prt, 01_housing_v1.prt, 01_housing_v2.prt, 02_lid.prt, 03_lid.prt, 03_seal.prt, 04_seal.prt]
2026-02-20 Improved Housing after talk on 19.02.26. Housing, Lid, Seal, Lid for Fuse-Opening.
    [00b_lid_assembly_asm.stp, 01_housing.3mf, 01_housing.prt, 01_housing.stp, 01_housing__v1.3mf, 01_housing__v1.prt, 01_housing__v1.stp, 02_lid.3mf]
2026-02-21 More work done on the housing. seals, lids, positions of PCB. Window for Display. Light-thingies for 4 LEDs.
    [00c_housing_lid_assembly_asm.stp, 01_housing.prt, 01_housing.stp, 01_housing__v1.3mf, 01_housing__v1.prt, 01_housing__v1.stp, 02_lid.prt, 02_lid.stp]
2026-02-21 Added fuse-lid. not finished yet. Changed Position of display-window.
    [01_housing.prt, 02_lid.prt, 02_lid__Window_Deep.prt, 04_fuse_seal_a.prt, 04_seal_fuse_b.prt, 04_seal_fuse_b.stp, 11_display_window.prt]
2026-02-22 new subfolders for different version of PCBs. New PCBs from Date 20.02.2026
    [11231157520-93574.prt, 11231157520-93593.prt, 11300850208-105584.prt, 11300850208-105603.prt, 11434073136-38098.prt, 11434073136-38117.prt, 11434079376-36157.prt, 11434079376-36176.prt]
2026-02-22 Renamed folders of extracted step-files.
    [11300850208-105584.prt, 11300850208-105603.prt, 11434073136-38098.prt, 11434073136-38117.prt, 11434079376-36157.prt, 11434079376-36176.prt, 11434362080-24756.prt, 11434362080-24775.prt]
2026-02-22 new folder for old FreeCAD-files
    [90_battery_holder-holder_cut.prt, 90_cbox11004-körper.prt, 90_holder_banana_plugs_drill.prt]
2026-02-22 renamed most of the CAD-files. And some new files.
    [01_01_housing.prt, 01_02_staeubli_nut_m12.prt, 01_03_seal_plug_12x1p5.prt, 01_04_fuse_seal.prt, 01_04_fuse_seal_a.prt, 01_04_fuse_seal_b.prt, 01_06_fuse_lid.prt, 01_07_m3_einschmelzmutter.prt]
2026-02-24 original plugs and parts from staeubli. changed building of housing-assembly. better seal and lid for fuse-area.
    [01_01_housing.prt, 01_01_housing.stp, 01_02_staeubli_nut_m12.prt, 01_03_seal_plug_12x1p5.prt, 01_04_fuse_seal.prt, 01_04_fuse_seal_a.prt, 01_04_fuse_seal_b.prt, 01_05_staeubli_plug_seal.prt]
2026-02-25 HW: Schematics rearranged for documentation, half-bridge control signals moved to layer Mid 4, additional netclass added for terminals (protection against the spread of fire), terminal position fixed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
    [Battery_BMS.SchDoc, Connector.SchDoc, Converter.SchDoc, Measurement.SchDoc, Microcontroller.SchDoc, On_Off.SchDoc, Output_Terminals.SchDoc, PS1-2BA.PrjPcb]
2026-02-28 HW: Cost estimation updated with transformer
    [Cost Estimation.xlsx]
2026-03-04 HW: Transformer connector schematic adjusted for documentation
    [PS1-100-Top.SchDoc]
2026-03-04 HW: User interface PS1-2 revision BA completed, schematic cleanup for documentation
    [Backlight_Driver.SchDoc, Display.SchDoc, LED.SchDoc, PS1-2-Top.SchDoc, PS1-2BA.PrjPcb, Power_3V3.SchDoc, Power_Iso.SchDoc, Power_VLED.SchDoc]
2026-03-04 HW: Mainboard PS1-1 revision BA completed, schematic cleanup for documentation
    [Battery_BMS.SchDoc, Converter.SchDoc, Converter_HV.SchDoc, Iso_Current_Limit.SchDoc, Measurement.SchDoc, Mechanics.SchDoc, Microcontroller.SchDoc, On_Off.SchDoc]
2026-03-04 HW: Estimation for power consumption started
    [Power consumption.xlsx]
2026-03-06 HW: No-ERC markers removed from schematic output in outjob, PCB 3D print export added to PS1-1 outjob
2026-03-06 DOC: Modification history extended for index BA of PS1-1 and PS1-2, issues with overvoltage category, buck boost inductor footprint and breakout hole clearance added
2026-03-09 DOC: Schematics added to documentation, existing schematics updated
2026-03-09 DOC: Description of BMS and on/off controller updated to index BA
2026-03-11 new PCB-step-files from 09.03.2026. Orientation of cells changed from +-+- to -+-+, new cell-holder neccessary.
    [00_03_housing_fuse_cutoff_asm.3mf, 00_03_housing_fuse_cutoff_asm.stp, 00b_lid_assembly_asm.stp, 00c_housing_lid_assembly_asm.stp, 01_01_housing.prt, 01_01_housing.stp, 01_04_fuse_seal_b.prt, 01_05_staeubli_plug_seal.3mf]
2026-03-17 removed old Version of mechanical housing
    [11225838256-545580.prt, 11225838256-545599.prt, 11376057872-68639.prt, 11376057872-68658.prt, 60v_quelle_dummy.stp, 9344568112-398244.prt, 9344568112-398263.prt, c61035-a0031-b201_rm5-2sec_sw_r.prt]
2026-03-17 moved to PDF-files from the pcbs to the sub-folder
    [60v_quelle_dummy.stp]
2026-03-26 DOC: Insufficient I2C level added to modification history
2026-03-27 DOC: Inaccurate voltage reference buffer output added to modification history
2026-03-27 SW: Ported from STM32F334 to STM32G474
2026-03-28 DOC: Table with operatin modes for low voltage converter
2026-03-28 MECH: Added Holder for Coilformer and Smal spools with holder for manufacturing of transformer
    [Coilformer_Holder.3mf, Coilformer_Holder.FCStd, Holder.3mf, Spulenhalter_Klein.FCStd]
2026-04-04 Files for 3d-printing the cells. new paths for creo-search-path. More to the Readme-file
    [bat1ps1-1b-basis_1__druck_asm.3mf, bat1ps1-1b-basis_1__druck_asm.stp]
2026-04-04 SW: Fixed issue with ADC5 doing only one conversion
    [bat_source.ioc]
2026-04-04 SW: Catch of division by zero in adc data conversion
2026-04-04 moved display-window from outside to inside
    [02_01_lid.3mf, 02_01_lid.prt, 02_01_lid.stp, 02_11_display_window.prt, 05_cell_holder.stp, 05_cell_holder_minusplus.3mf, 05_cell_holder_minusplus.stp, alle_parts.3mf]
2026-04-04 added bolts and einschmelzmuttern. Some 3d-print-files. Comments in ReadMe file. improved cell-holder-part.
    [01_01_housing.prt, 01_01b_housing_cutoff_asm.3mf, 01_01b_housing_cutoff_asm.stp, 01_01b_housing_cutoff_asm__01_06_lid.3mf, 01_06_fuse_lid.3mf, 01_06_fuse_lid.prt, 01_06_fuse_lid.stp, 01_07_m3_einschmelzmutter.3mf]
2026-04-06 SW: Added ADC with DMA (ADC5 not working with injected values)
    [bat_source.ioc, main.c, main.h]
2026-04-07 SW: _write function for printf on command line, duplicate check in cli history
2026-04-12 SW: Changed include strategy in CLI and added encoder and change state
2026-04-12 SW: Removed old display drivers
2026-04-12 SW: Commit of sw changes after todays laboratory session. Fixed External ADC, worked on display, smaller changes
    [bat_source.ioc, ctrl_main.c, gpio.h, main.c, main.h, statemachine.c]
2026-04-14 SW: Conversion of NTC temperature measurement data
2026-04-14 SW: Detection of last element in temperature conversion code generation fixed
2026-04-14 SW: FIFO buffer for USART enabled, number of arguments in cli fixed
    [bat_source.ioc]
2026-04-14 mech. temporary files. partly dobled. merge from two different computers. will be cleaned up and deleted.
    [00_03_housing_fuse_cutoff_asm.3mf, 00_03_housing_fuse_cutoff_asm.stp, 01_01_housing.prt, 01_01_housing__.prt, 01_01b_housing_cutoff_asm.3mf, 01_01b_housing_cutoff_asm.stp, 01_01b_housing_cutoff_asm__01_06_lid.3mf, 01_02_staeubli_nut_m12.prt]
2026-04-16 SW: ADC gains changed to float, loopcount addec to command pADC, correction of types in cli
2026-04-16 DOC: Offset in isolation current measurement and unreliable ambient light sensor added to modification history
2026-04-16 DOC: NTC temperature measurement formulas extended
2026-04-17 SW: CLI commands to set LED and backlight current
2026-04-24 SW: Disable BMS sleep mode on startup
2026-04-24 SW: Quad SPI flash W25N01GV implementation started: initialisation, reset, read jedec id, read and write of registers, write en/disable, read bad block lut, page read and single line read
    [main.c]
2026-04-24 SW: LED current setup adjusted
2026-05-01 SW: QSPI flash memory program and erase implemented, read fixed, QSPI flash read, erase and write implemented in the cli
    [bat_source.ioc]
2026-05-09 MECH: new step and 3mf-files for printing
    [01_01_housing.3mf, 01_01_housing.stp, 01_01_housing__cutoff_front_lid.3mf, 01_01_housing__cutoff_front_lid.stp, 01_04_fuse_seal_b.stp, 02_01_lid.3mf, 02_01_lid.stp, 02_01_lid__cutoff_front.3mf]
2026-05-09 MECH: old files cleanup
    [01_01_housing.prt, 01_01_housing__.prt, 01_04_fuse_seal_a__.prt, 01_04_fuse_seal_b__.prt, 01_06_fuse_lid__.prt, 02_01_lid.prt, 02_03_seal.prt, 05_cell_holder_minusplus__.prt]
2026-05-11 MECH: cleanup
    [01_01_housing.prt, 01_02_staeubli_nut_m12.prt, 01_03_seal_plug_12x1p5.prt, 01_04_fuse_seal_a.prt, 01_04_fuse_seal_b.prt, 01_05_staeubli_plug_seal.prt, 01_06_fuse_lid.prt, 01_07_m3_einschmelzmutter.prt]
2026-05-11 MECH: step-file of simplified housing for e-scruti-box
    [00_01_mechanical_assembly_red_asm.stp, 01_01_housing.prt]
2026-05-18 MECH: delete and cleanup of some old files. Added knob into model. new and current export of all files to step and 3mf. Two new 3mf-files for everything to print. Continue the README-files. README wi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
    [00_03_housing_fuse_cutoff_asm.3mf, 00_03_housing_fuse_cutoff_asm.stp, 01_01_housing.prt, 01_01_housing.stp, 01_01_housing__cutoff_front_lid.3mf, 01_01_housing__cutoff_front_lid.stp, 01_04_fuse_seal_b.stp, 01_05_staeubli_plug_seal.3mf]
2026-05-19 DOC: Added to modification history: Current measurement noise, unreliable QSPI operation, offset in isolation current measurement, unreliable ambient light sensor, displey not working, missmatched co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
2026-05-24 Fixed Frequency of secondary side and prepared for voltage test
    [bat_source.ioc, ctrl_main.c, ctrl_param.h]
2026-06-01 MECH: chamfer on housing bottom outside and lid
    [01_01_housing.prt, 01_01_housing.stp, 02_01_lid.prt, 02_01_lid.stp]
2026-06-07 SW: RTC implemented in cli, calculation of number of arguments in cli fixed
    [bat_source.ioc]
2026-07-04 SW: Add AMPMETER statemachine mode and fix GPIO mode config table
    Fixed undefined GPIO_MASK_OUT_SHUNT_EN typo in IDLE entry and wrong
    mask constant (GPIO_OUT_SEL_ISO instead of GPIO_MASK_OUT_SEL_ISO) in
    the new AMPMETER entry, which was setting the HV output select line
    unintentionally. Also updated RESISTANCE_1mA, VOLTMETER and SETTINGS
    GPIO configs.
    [statemachine.h]
2026-07-07 HW: Simulation of linear current controller updated
2026-07-07 mech: mouting cellholder to 3p2mm
    [05_cell_holder_minusplus.prt, 05_cell_holder_minusplus_3p2mm.stp]
2026-07-07 HW: Mainboard PS1-1 updated to index BB
    [Battery_BMS.SchDoc, Current_Controller.SchDoc, Measurement.SchDoc, Microcontroller.SchDoc, On_Off.SchDoc, Output_Terminals.SchDoc, Overcurrent_Protection.SchDoc, Overvoltage_Protection.SchDoc]
2026-07-11 MECH: Added Stubs for Lid to screw on PCB
    [02_01_lid.prt, 02_01_lid.stp, 02_11_display_window.prt, 02_11_display_window.stp]
2026-07-17 MECH: Fixed various issues: Fuse Lid, Positioning of main PCB etc
    [01_01_housing.prt, 01_01_housing.stp, 01_04_fuse_seal_b.prt, 01_06_fuse_lid.prt, 01_06_fuse_lid.stp, 02_01_lid.prt, 02_01_lid.stp, __ABS_Teile.3mf]
2026-07-22 MECH: Changed fuse opening, adapted Lid Assembly, adapted housing height, updated 3D Printing File
    [01_01_housing.prt, 01_01_housing.stp, __ABS_Teile.3mf]
