daniw/bat_source/(notices)

Notices in the files:
sw/Ext_Loader/Core/Inc/main.h:
Copyright (c) 2026 STMicroelectronics.
All rights reserved.
This software is licensed under terms that can be found in the LICENSE file
